Thuong180702/Bimanual-wall-climbing-robot/cad/README.md

# cad — the mechanical design

Parametric CAD for the v2 robot. Vendor actuators are the manufacturers' own
STEP files; everything between them is drawn here. The same spec drives the
CAD, the collision primitives and the URDF, so the model and the simulation
cannot drift apart.

```
src/
  lib/spec.py      WHERE every joint is, WHICH actuator is on it, WHY each
                   offset differs from v1. The single source of truth.
  lib/motors.py    the actuator catalogue - datasheet numbers, nothing invented
  lib/connect.py   connector primitives: output_plate, face_plate, cheek,
                   bolt_access, and the measured keep-out each is checked on
  lib/build.py     the connectors themselves, one function per link
  purchased/       the three vendor STEP files put in the canonical joint frame
  robot.py         the assembly - run this
tools/
  verify.py        check every number against its source. Run after any change.
  check_one.py     ONE connector: one solid? clears both actuators? bolts on?
  check_pair.py    two neighbouring connectors, swept over their joint's range
  check_swing.py   a link against an actuator two joints away, swept over both
  check_seams.py   is each connector drawn as ONE part? no seam across a skin
  check_bay.py     room in the chest for the battery and boards (spec.BAY)?
  balance.py       where the mass actually sits, per link and for the robot
  preview.py       write tmp/<name>.step and the same bolted between its motors
  arm_view.py      every arm connector so far, bolted into one chain
  robot_view.py    the whole robot, walked from base_link
  profile.py       read a vendor STEP's faces and cylinders -> the IFACE numbers
  gen_envelope.py  tessellate a vendor STEP -> its real radial keep-out
  check_fit.py     do the real actuator bodies fit? boolean intersection on solids
  torque.py        per-joint hold torque, measured on the built model
  massprops.py     mass, COM, inertia per link
  gen_urdf.py      writes ../urdf/
vendor/            downloaded vendor STEP, sha256 verified against step.parts
STEP/              outputs
```

```bash
python src/robot.py        # build STEP/robot.step
python tools/verify.py     # 17 checks
cadgen viewer --json       # review in the browser
```

## Conventions

**Canonical actuator frame.** Every actuator, whatever the vendor file does:
`+Z` is the joint axis, `z = 0` is the output flange face, the body occupies
`z < 0`. `src/purchased/*.py` holds the one transform each vendor file needs.

**Link frame.** URDF convention: origin on the proximal joint axis, identity
rotation at q = 0 — except the hooks, turned 180° about z by `MOUNT_ROT` (below). `BODY_DIR[joint]` points from the joint origin toward that
actuator's body, so the child structure grows the other way. `MOUNT_AT[joint]`
slides the actuator along its own axis — kinematically free clearance.

**One connector pattern for the whole arm.** Every link is two plates and a
web. One plate lies flat on the proximal actuator's OUTPUT flange, the other on
ONE housing face of the distal actuator; each is exactly the diameter of the
face it sits on and carries a clearance hole for every one of that face's
bolts, continued on through the web so a driver can reach them. The web is a
single plate whose outline is tangent to both rims, so it follows the two faces
instead of butting onto them. Nothing wraps an actuator: each one is held by
the bolts on a single face and cantilevers off it, the way the open-source arms
on this class of actuator do it.

**Drawn as one part, not as blocks pushed together.** A web stops AT the
plate it stands on - it used to run 3 mm into it, and a leg had its whole face
plate inside it - so the joint is a face and the two rims are one surface.
Where a web meets a round plate off its centre it is as wide as the plate is
on that chord, not as the plate's diameter: the upper arm's cheek stood 4.3 mm
outside the ring it bolts to at both corners. Every bolt a web covers gets a
counterbore down to its seat at the diameter of the HEAD (at thread size the
head was buried in the web, or stood half inside a cheek that only brushed
it); where that would leave under 1 mm of metal at a rim it is opened through
the rim, and over the AK80-64's output - six M4 heads 0.6 mm from the cable
bore - the web is bored once over the whole bolt circle. `check_seams.py`
counts the edges whose two faces are the same plane or cylinder, which is what
a part put together from blocks is made of; the arm has none. (The upper torso
keeps 17, all bolt-hole edges of a few mm where a lidar hat meets a panel.)

**Except at a corner.** Where the two axes are perpendicular to each other AND
to the link - both wrist links - the two faces lie in perpendicular planes and
no single plate sits flat on both. There it is one leg per face, and the two
share ONE SPINE where they meet: each leg's thickness is the other leg's
width, and each leg's taper is centred on the other leg rather than on its own
joint axis. Sized any other way the legs stand proud of each other and leave
two wings and a rib that carry nothing - which is exactly what the first two
attempts looked like. Each leg is drawn on 8 mm into the other as a parallel
neck, and the corner where its taper turns into that neck is a 6 mm radius, so
the legs meet in a round and not a crease (8 mm put 0.2 mm3 of `wrist_L` into
`wrist_dev_L` at -15 deg). One corner stays sharp: the child leg's on the side
of the parent actuator, whose barrel is 0.5 mm away. The hook's web and palm
hand over the same way.

The spine is a rectangle, not a square, because its two dimensions do not cost
the same. Across the arm is open space; fore-and-aft is where the NEXT link's
bracket has to pass, so a millimetre there costs the next link a millimetre of
stand-off. 16 x 14 mm is the smallest pair that keeps both section moduli over
522 mm3, which is what the AK60-39's 72 N.m stall needs at half of 6061-T6's
yield. `wrist_dev_L` then stands its plate 12 mm out, because `wrist_L`'s
16 mm leg reaches 10 mm past the flange it bolts to - measured at 2181 mm3 of
overlap before the stand-off was added, by `check_pair.py`.

**Balance is a layout rule, not an afterthought.** Every bracket cantilevers
off one face and every actuator's body hangs to one side of its own joint, so
each link has a lateral offset. All four of the arm's cross-axis actuators
used to have their bodies inboard - shoulder flexion, elbow, wrist flexion,
finger - and none of it cancelled: `balance.py` measured the arm's centre of
mass 13.5 mm inboard of the axis it hangs on. The elbow and the finger are
turned round, so the four now go in, out, in, out and the offset is 1.6 mm.
It is what OpenArm does with its joint origins, whose lateral offsets read
-30.1, +30.1, +31.5, -31.5, +37.5, -37.5.

**The shoulder is pitch-first, like the humanoids it was checked against** -
twelve of them, measured off their own URDF/MJCF (`spec.py` lists them). The
flexion (pitch) actuator sits in the chest, body inboard, output facing out;
the abduction (roll) actuator sits beside that output at the same height, axis
fore-and-aft; the upper arm hangs off the roll output. Seen from above,
`shoulder_L` is an L: a web on the pitch output plate running past the roll
actuator's flank, and a leg across its far flange. The first v2 stacked it the
other way - abduction on the torso, flexion 104 mm below it - and raising the
arm flipped that 104 mm link over the top: the arm grew out of a pivot above
the abduction motor, and flaring it swung its root 105 mm inward into the
torso. `MOUNT_AT` existed for that layout only and is empty now.

**The three torso links are frames, not connectors**, so they are panels and
decks rather than cheeks - but the rule they are drawn to is the same: every
actuator is held by a plate lying on a face it really has, with a clearance
hole for every one of its bolts. `base_link` is the pelvis, drawn ready for legs: the waist actuator nose-up on
a deck in its top, and under it two 6 mm side walls that each hip's first
actuator (`spec.HIPS`, a pitch AK80-64 as on Unitree G1) will bolt its front face
to from inside, output out through the wall - the shoulders' mounting, a floor
lower. No hip actuator is fitted yet. The hips are 146 mm apart and 425 mm under
the shoulders (a 1.40 m person: ~150 and 403; the hips sit 22 mm low so their
bodies clear the waist actuator), the waist 305 mm under the shoulders at navel
height (`spec.DROP`: it sat 0.10 m higher until 2026-11-11). The section is the
140 x 142 box cut back to R86.5, because the waist turns the upper body over the
pelvis and a hanging forearm sweeps a circle 88 mm round the waist axis. Neither
actuator is hollow, so the harness goes ROUND the waist: legs in through the window
over each hip, out of the pelvis's open top, a loop in the 40 mm under the chest's
deck, up through the deck's two slots. The chest carries `spec.BAY`: the battery
drawer on two rails, out through the back panel; over it a tray on four posts (IMU,
CAN board, DC-DC) and on that the bulkhead the Jetson stands on, both drilled on an
M3 grid (`tools/check_bay.py` checks the room). `waist_link` is a cone that takes the Ø54 output flange
out to the frame's Ø88 bolt circle in one surface. `torso_upper` is the chest:
a box round the two shoulder pitch actuators, carried the way Berkeley
Humanoid Lite, OP3 and the Unitree torsos carry theirs - each actuator inside,
its front face bolted to the side wall, its output flange showing through it.
The side walls ARE those two mounting plates, 6 mm and no thicker, because
`shoulder_L`'s web turns 3 mm past the output flange. A deck, a front and a
back panel and a lid close the box, so a pitch actuator's reaction goes round
it as shear and those four can be 3 mm webs with windows: 1.04 kg, against
1.49 for the abduction-first yoke it replaced.

**Which of the child's two flanges to bolt** is a real choice, not a rule.
The near one leaves the bracket on the same side as that actuator's output,
which is where the NEXT link has to grow, so the next link pays a stand-off;
the far one puts the bracket behind the actuator and leaves that side clear.
`wrist_dev_L` pays the stand-off because reaching behind the deviation
actuator would mean going 48 mm back past it. `shoulder_L` takes the roll
actuator's far flange instead, which leaves its whole output side to the upper
arm. `FACE` in `build.py` records the overrides.

**Lightening** is worked out from the web, not typed in: `_span_holes()` takes
the clear run left between the cable bore and the child's pilot boss and fills
it with as many holes as fit at 50 mm pitch. The forearm's 47 mm of run takes
one; the upper arm's 97 mm takes two.

**The hook** is the one link whose far end is not a flange. Its palm, lip and
65 mm width are the numbers the controller and the RL work were built on -
`urdf/climbing_robot.urdf` carries them as two collision boxes - so they are
copied, not redesigned; only the attachment is drawn. v1 never attached it: it
laid the palm flat against the plate's outer face and, to clear the finger
actuator, slid the whole hook 36.5 mm sideways, which is why its mesh and its
collision boxes disagreed about where the hand was. The palm is back on the
axis and the TOP of the palm is cut away instead, which costs nothing - the
actuator only reaches 27.5 mm down and the rung never touches there.

It is bolted on **turned over** (`spec.MOUNT_ROT`, 180° about the forearm axis):
raised overhead, an unturned hook's throat faces away from the wall, which v1
learnt the hard way. The hook is drawn in its own turned frame
(`build.in_turned_frame`), so its plate stays on the flange side of the finger
actuator — turning the frame alone would have put 21 700 mm³ of it inside the
motor.

**Plate diameter** is the mating face, unless the actuator's bolt circle sits
so close to the rim that a socket head hangs over the edge, and then it is as
wide as the heads need and never wider than the actuator's own body. Only the
AK45-36 needs it: M3 at Ø48 on a Ø53 face leaves 0.8 mm of metal outside the
clearance hole, so its plates go out to the Ø55 barrel and finish flush.

The web's thickness is not free. Where the distal actuator's two mating faces
are close together, the web has to fit between them — the elbow gives 7 mm
between its front face and its output flange, and a 12 mm web there drove
straight into the forearm's own web (853 mm³, measured). `check_pair.py` is
what catches this; `check_one.py` cannot see the link next door.

## Interfaces, measured off the vendor files

Not from a drawing — `tools/` walked the STEP topology and found the bolt
circles by their cylindrical faces and z-positions.

| | output BC | output bolts | housing face z | housing BC | housing bolts | bore |
|---|---|---|---|---|---|---|
| AK80-64 | Ø28 | 6 × M4 | −8.0 | Ø89 | 8 × M3 | Ø21 |
| AK60-39 | Ø30 | 6 × M4 | −9.0 | Ø71 | 8 × M3 | Ø17 |
| AK45-36 | Ø27 | 6 × M2.5 | −4.0 | Ø48 | 6 × M3 | Ø8 |

## Traps worth remembering

**MuJoCo collides a mesh's convex hull, never the mesh.** One mesh per link made
the torso frame one hull, a block out to the shoulder plates, and the raised
arms sank 10-22 mm into it. `gen_urdf.py` writes one collision mesh per bracket
PART (stored as its hull) - see `src/lib/collide.py`. Over 1500 random poses of
the climbing envelope, 2 % of the self-contacts MuJoCo reports are hull
artefacts the true meshes do not make.

**`Shape.scale()` does not scale a part that still carries a Location.** A part
placed by `plane * shape` keeps that placement, and `.scale(1000)` on it moved
`upper_arm_L`'s face plate 200 mm up the arm. A fused result is clean; a single
part has to be wrapped (`Compound(children=[part])`) before scaling.

**Axis-distance arithmetic does not decide clearance for perpendicular
cylinders.** The first version of `check_fit.py` computed the distance between
axis lines minus the two radii; for perpendicular axes that is neither an upper
nor a lower bound, and it reported eight clashes that did not exist while
missing ones that did. It is a boolean intersection on real solids now, and it
costs about half a second per pose.

**`GProp_GProps.MatrixOfInertia()` is about the centre of mass, not the origin.**
Applying a parallel-axis correction to it produced negative principal inertias,
which is how the mistake surfaced. Verified against an offset box.
