Thuong180702/Bimanual-wall-climbing-robot/requirements-gpu.txt

# The GPU path on Linux + an NVIDIA card, every version pinned: what a run in a paper
# was trained with. Resolved for Python 3.12 on x86_64 Linux (glibc >= 2.28) by
#   uv pip compile (the six direct pins below) --python-version 3.12 \
#     --python-platform x86_64-manylinux_2_28 --index-strategy unsafe-best-match \
#     --extra-index-url https://download.pytorch.org/whl/cu126
# Installed by rl/gpu_setup.sh. Why these and not the newest:
#   Python 3.12   jax 0.11 needs >= 3.12; Ubuntu 22.04 ships 3.10 (gpu_setup.sh uses uv's)
#   jax[cuda12]   JAX's CUDA 13 wheels need compute capability >= 7.5; a V100 is 7.0.
#                 CUDA 12 needs NVIDIA driver >= 525.
#   torch cu126   PyTorch dropped Volta (sm_70) from its CUDA 12.8 builds in 2.11, and
#                 CUDA 13 cannot build it at all; cu126 is the build that still runs a V100
#   2.13.0        the version every CPU run and checkpoint here was made with
#   warp-lang     mujoco-mjx[warp]'s pin: MJX's Warp backend (rl.mjx_check warp), which
#                 training steps on only where it is right and faster than JAX
# Direct pins: mujoco==3.12.0 mujoco-mjx==3.12.0 jax[cuda12]==0.11.1 warp-lang==1.16.0
#              torch==2.13.0+cu126 gymnasium==1.3.0 stable-baselines3==2.9.0
--extra-index-url https://download.pytorch.org/whl/cu126
absl-py==2.5.0
cloudpickle==3.1.2
cuda-bindings==12.9.9
cuda-pathfinder==1.8.2
cuda-toolkit==12.6.3
etils==1.14.0
farama-notifications==0.0.6
filelock==4.0.3
fsspec==2026.9.0
glfw==2.10.2
gymnasium==1.3.0
jax==0.11.1
jax-cuda12-pjrt==0.11.1
jax-cuda12-plugin==0.11.1
jaxlib==0.11.1
jinja2==3.1.6
markupsafe==3.0.3
ml-dtypes==0.6.0
mpmath==1.3.0
mujoco==3.12.0
mujoco-mjx==3.12.0
networkx==3.7
numpy==2.5.3
nvidia-cublas-cu12==12.6.4.1
nvidia-cuda-cupti-cu12==12.6.80
nvidia-cuda-nvcc-cu12==12.9.86
nvidia-cuda-nvrtc-cu12==12.6.85
nvidia-cuda-runtime-cu12==12.6.77
nvidia-cudnn-cu12==9.10.2.21
nvidia-cufft-cu12==11.3.0.4
nvidia-cufile-cu12==1.11.1.6
nvidia-curand-cu12==10.3.7.77
nvidia-cusolver-cu12==11.7.1.2
nvidia-cusparse-cu12==12.5.4.2
nvidia-cusparselt-cu12==0.7.1
nvidia-nccl-cu12==2.29.3
nvidia-nvjitlink-cu12==12.6.85
nvidia-nvshmem-cu12==3.4.5
nvidia-nvtx-cu12==12.6.77
opt-einsum==3.4.0
pyopengl==3.1.10
scipy==1.18.1
setuptools==84.0.0
stable-baselines3==2.9.0
sympy==1.14.0
torch==2.13.0+cu126
trimesh==5.1.0
triton==3.7.1
typing-extensions==4.16.0
warp-lang==1.16.0
zipp==4.1.0
