Thuong180702/Bimanual-wall-climbing-robot/demo/preview/lesson03_climb_up_mirror.gif

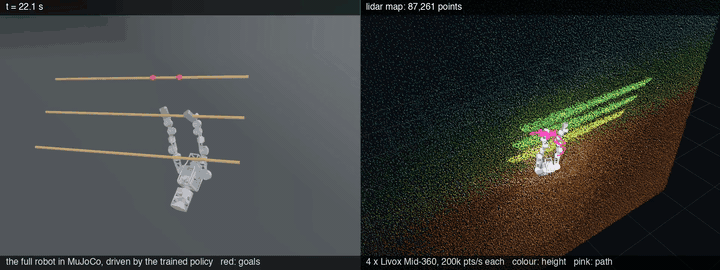
demo/preview/lesson03_climb_up_mirror.gif
