Thuong180702/Bimanual-wall-climbing-robot/demo/preview/lesson07_wall_corner.gif

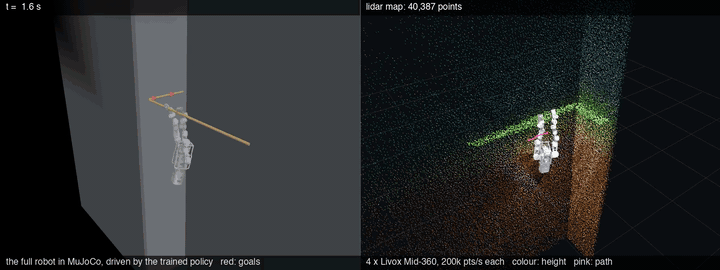
demo/preview/lesson07_wall_corner.gif
