Thuong180702/Bimanual-wall-climbing-robot/urdf/scene_corner.png

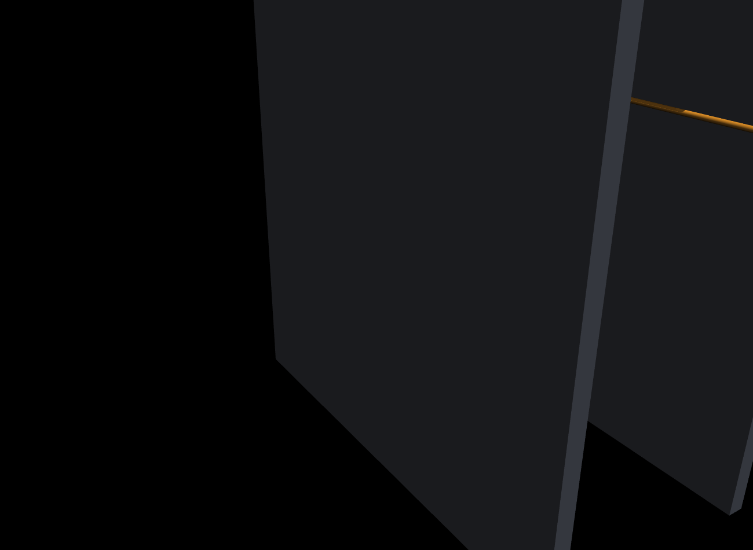
urdf/scene_corner.png
