Thuong180702/Bimanual-wall-climbing-robot/urdf/scene_hanging.png

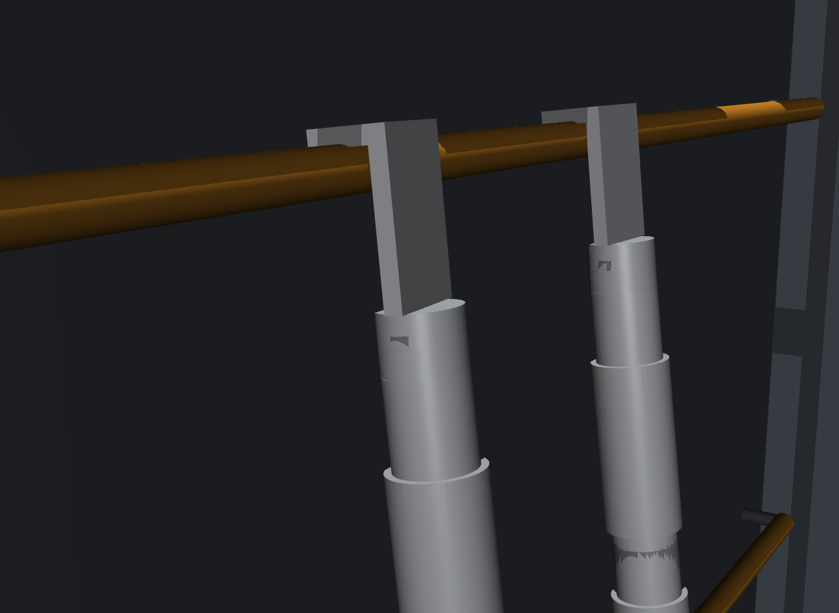
urdf/scene_hanging.png
