Thuong180702/Bimanual-wall-climbing-robot/urdf/scene_overview.png

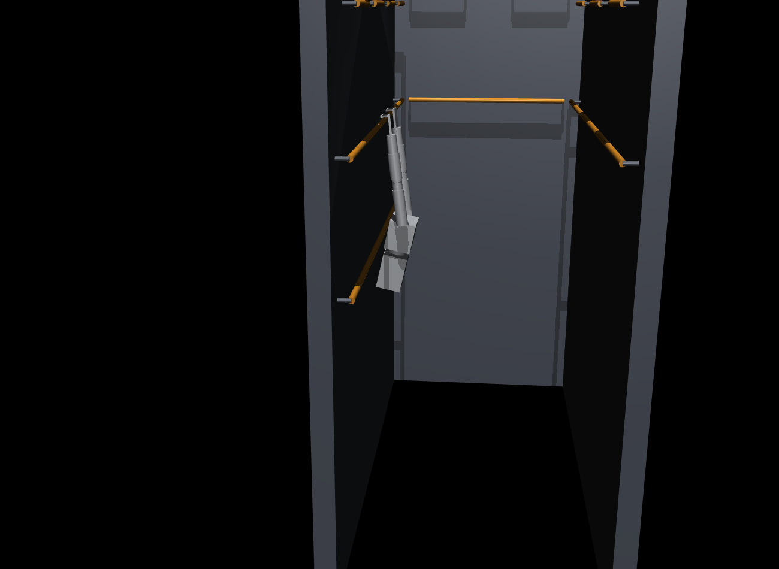
urdf/scene_overview.png
