Thuong180702/Bimanual-wall-climbing-robot/urdf/view_corner.png

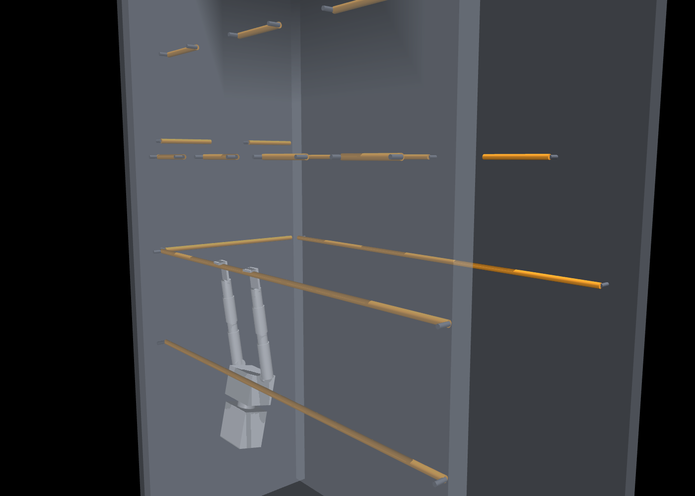
urdf/view_corner.png
