Thuong180702/Bimanual-wall-climbing-robot/urdf/view_iso.png

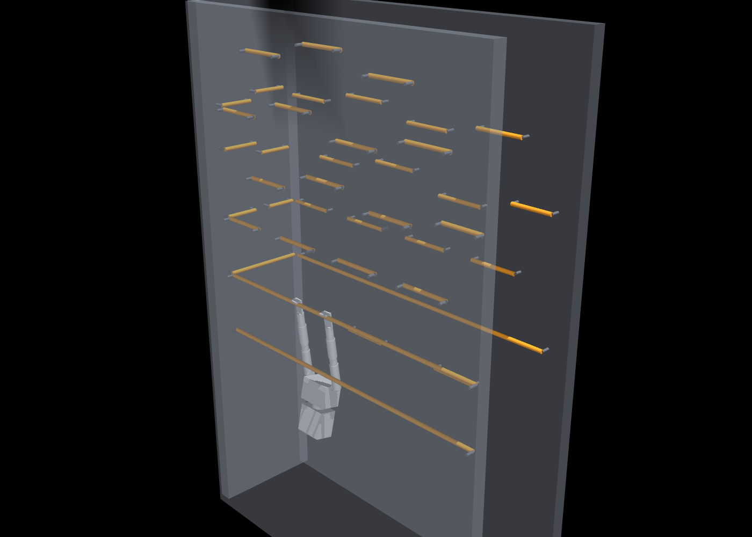
urdf/view_iso.png
