Thuong180702/Bimanual-wall-climbing-robot/urdf/view_iso_left.png

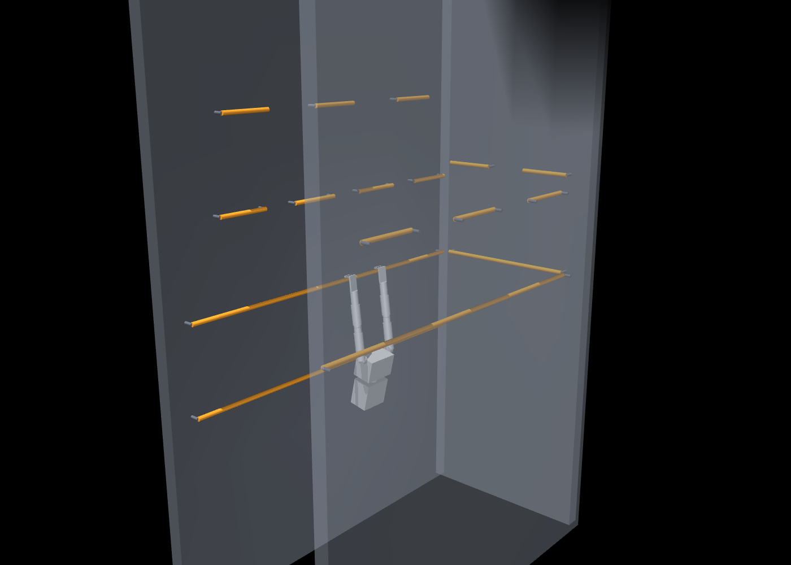
urdf/view_iso_left.png
