Thuong180702/Bimanual-wall-climbing-robot/urdf/view_top.png

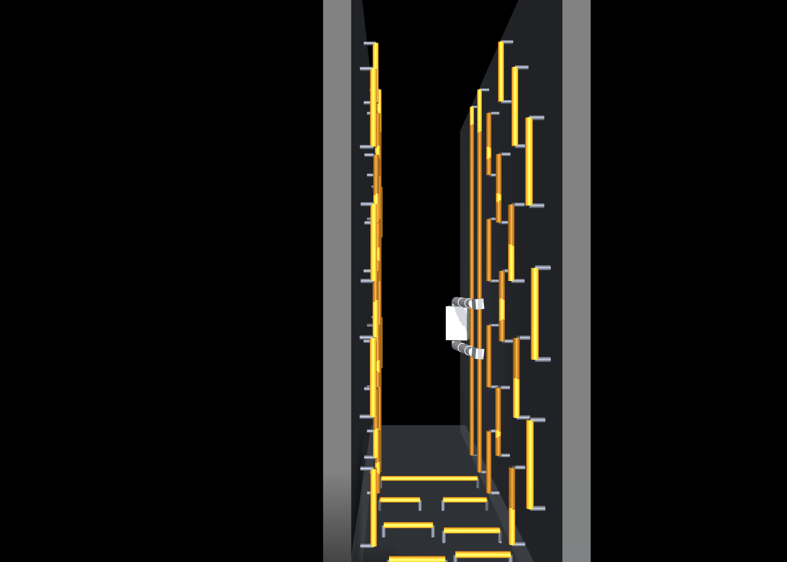
urdf/view_top.png
