Thuong180702/Bimanual-wall-climbing-robot/urdf/view_wall_back.png

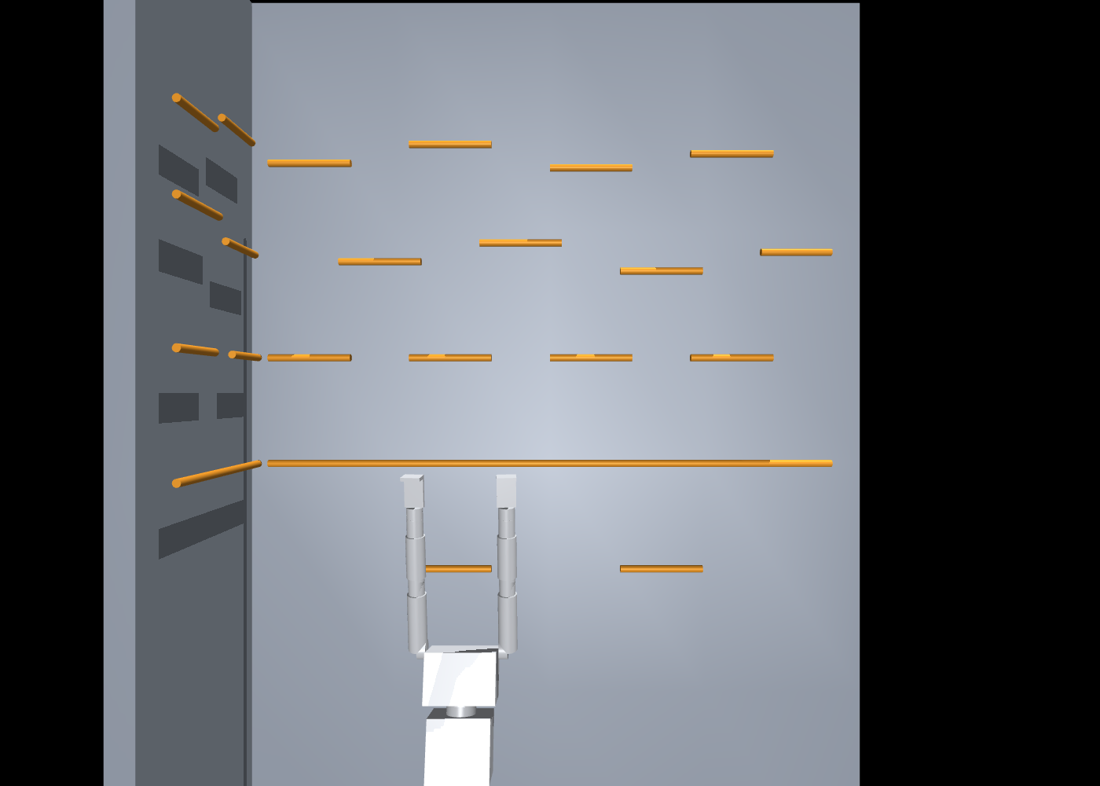
urdf/view_wall_back.png
