Thuong180702/Bimanual-wall-climbing-robot/urdf/view_wall_front.png

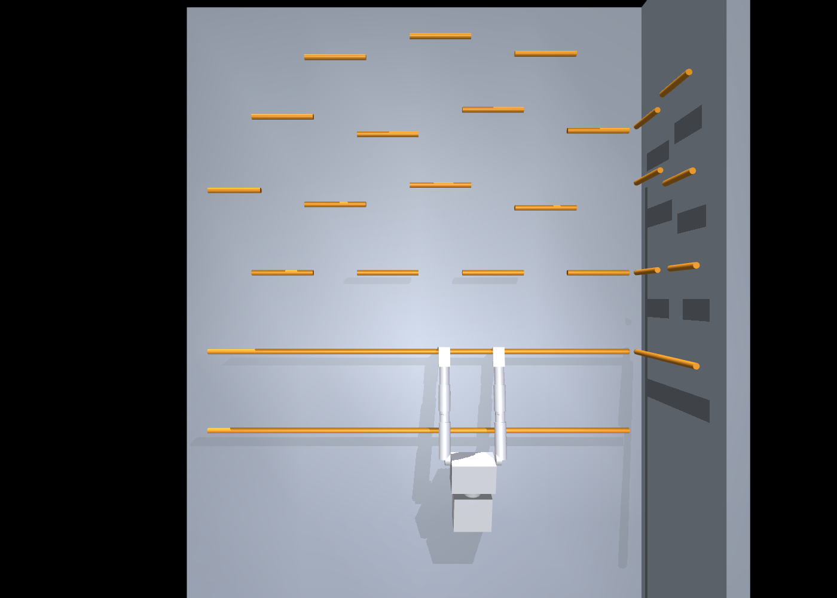
urdf/view_wall_front.png
