Thuong180702/Bimanual-wall-climbing-robot/urdf/meshes/upper_arm_L.stl

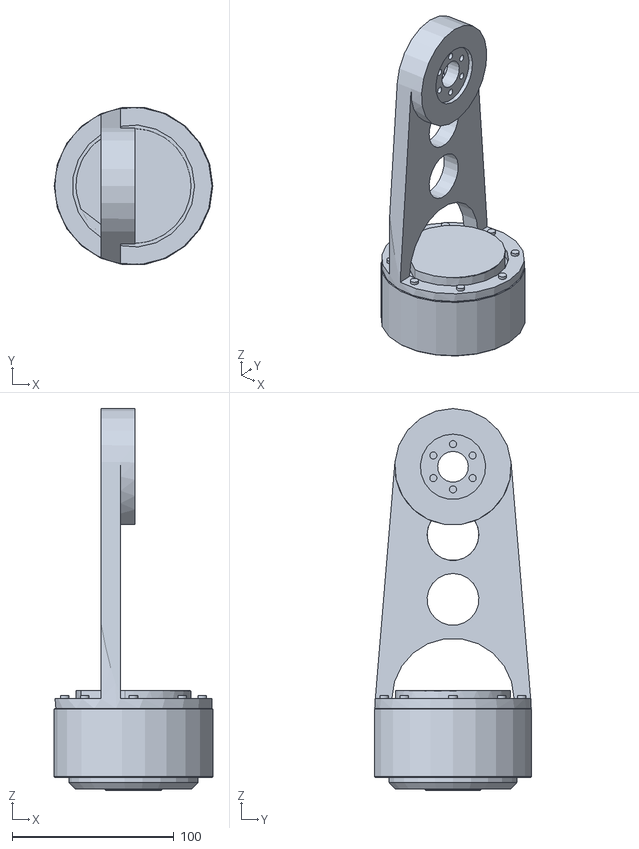
[picture p15: CAD file, 2026-11-11]
urdf/meshes/upper_arm_L.stl
98.0 x 97.0 x 236.0
