Thuong180702/Bimanual-wall-climbing-robot/urdf/meshes/torso_upper_col_lidar_head_roof.stl

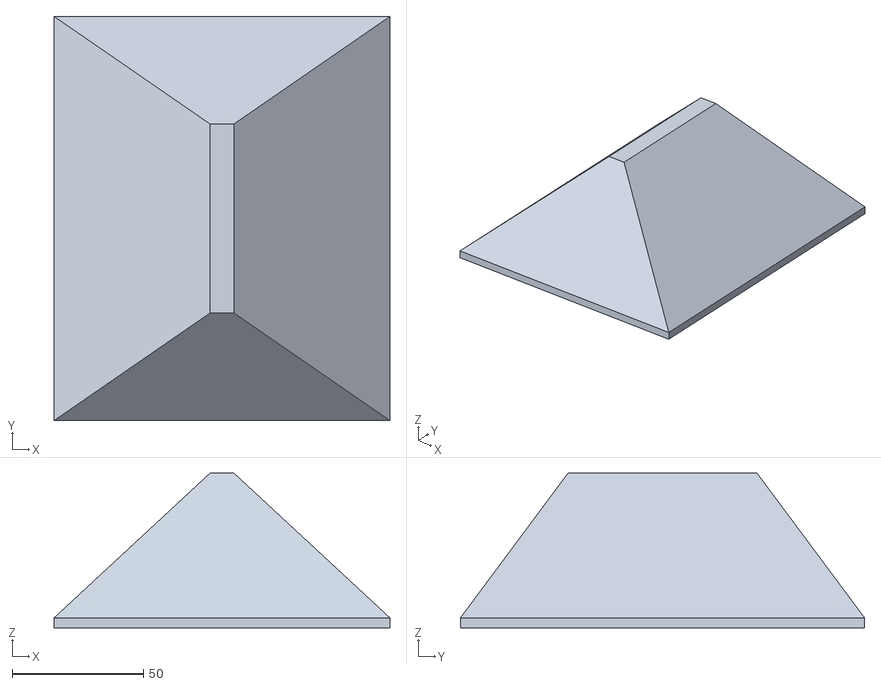
[picture p16: CAD file, 2026-11-11]
urdf/meshes/torso_upper_col_lidar_head_roof.stl
128.0 x 154.0 x 59.0
