Thuong180702/Bimanual-wall-climbing-robot/urdf/meshes/base_link_col_shell.stl

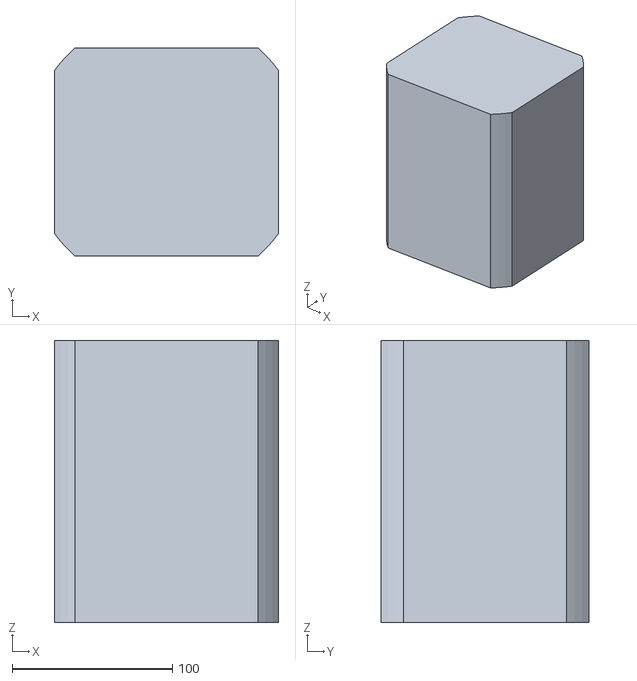
[picture p17: CAD file, 2026-11-11]
urdf/meshes/base_link_col_shell.stl
140.0 x 130.0 x 176.0
