Thuong180702/Bimanual-wall-climbing-robot/urdf/meshes/base_link_col_deck.stl

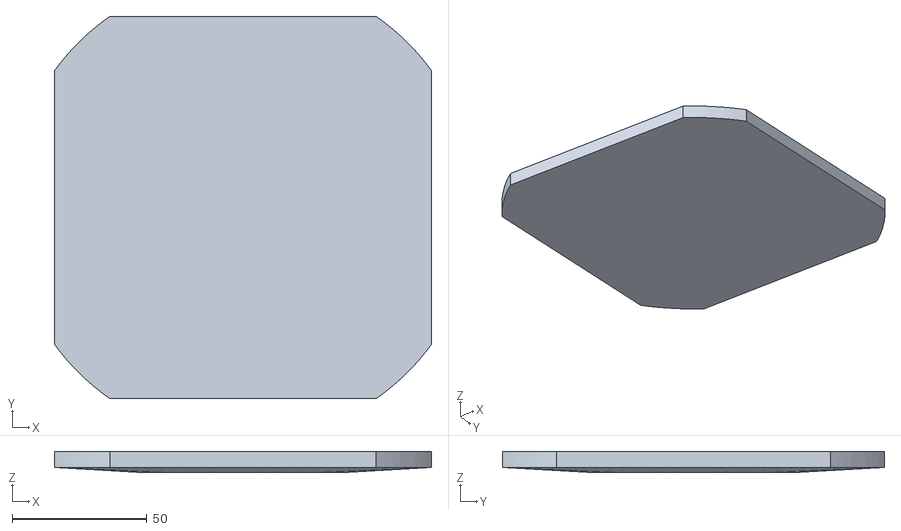
[picture p18: CAD file, 2026-11-11]
urdf/meshes/base_link_col_deck.stl
140.0 x 142.0 x 7.95
