Thuong180702/Bimanual-wall-climbing-robot/urdf/meshes/wrist_R.stl

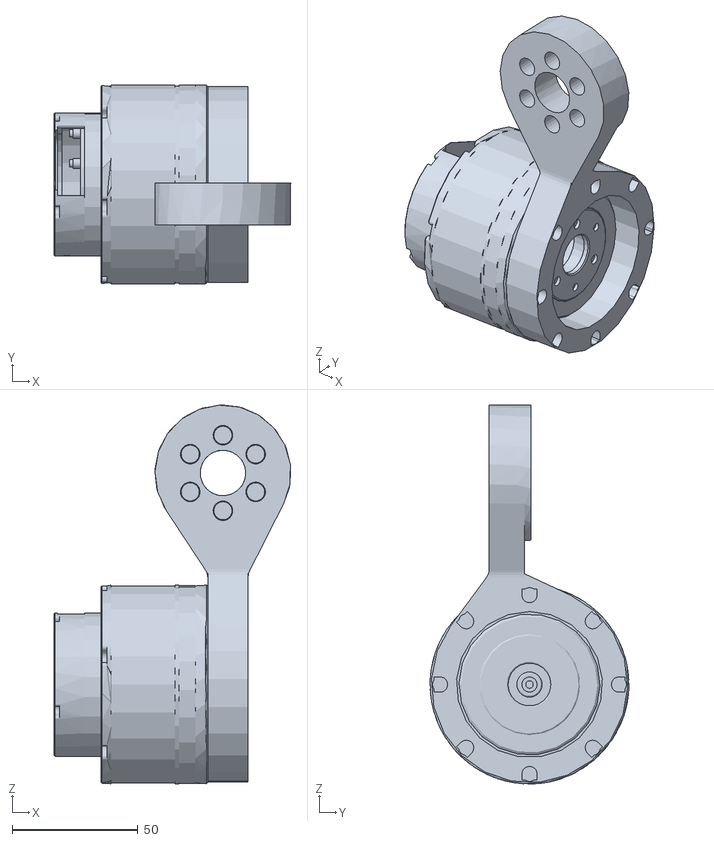
[picture p19: CAD file, 2026-11-11]
urdf/meshes/wrist_R.stl
93.9 x 79.0 x 150.5
