Thuong180702/Bimanual-wall-climbing-robot/urdf/meshes/hook_R.stl

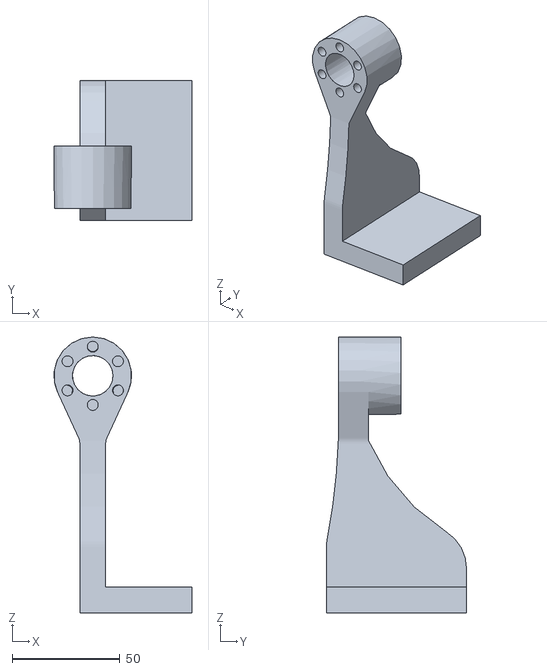
[picture p20: CAD file, 2026-11-11]
urdf/meshes/hook_R.stl
63.9 x 65.0 x 128.0
