Thuong180702/Bimanual-wall-climbing-robot/urdf/meshes/base_link_col_hip_L.stl

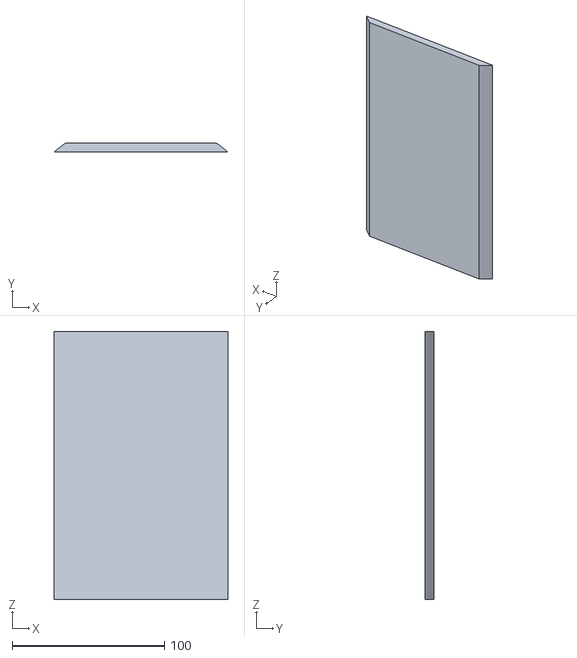
[picture p21: CAD file, 2026-11-11]
urdf/meshes/base_link_col_hip_L.stl
114.1 x 6.00 x 176.0
