Thuong180702/Bimanual-wall-climbing-robot/urdf/meshes/torso_upper_col_front.stl

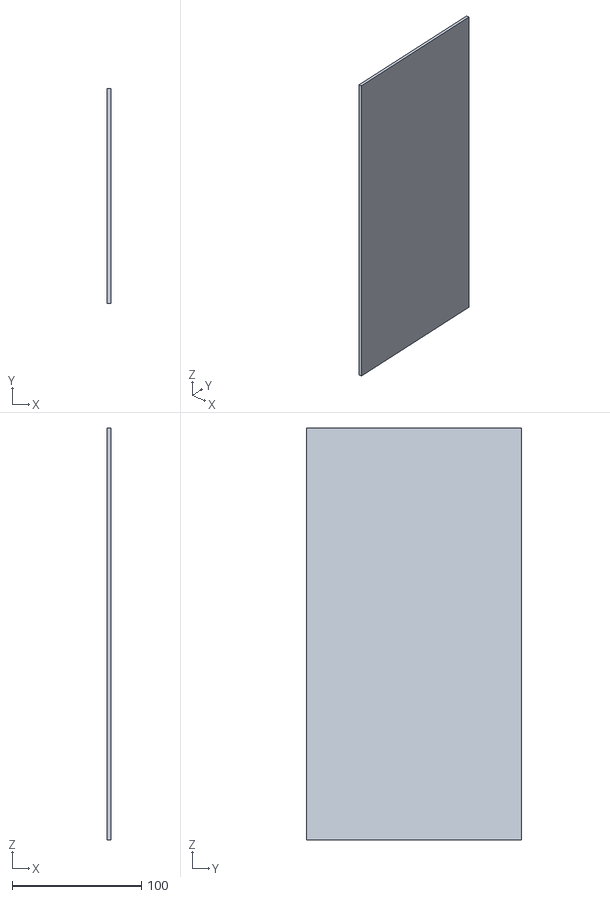
[picture p22: CAD file, 2026-11-11]
urdf/meshes/torso_upper_col_front.stl
3.00 x 166.0 x 318.5
