Thuong180702/Bimanual-wall-climbing-robot/urdf/meshes/torso_upper_col_lid.stl

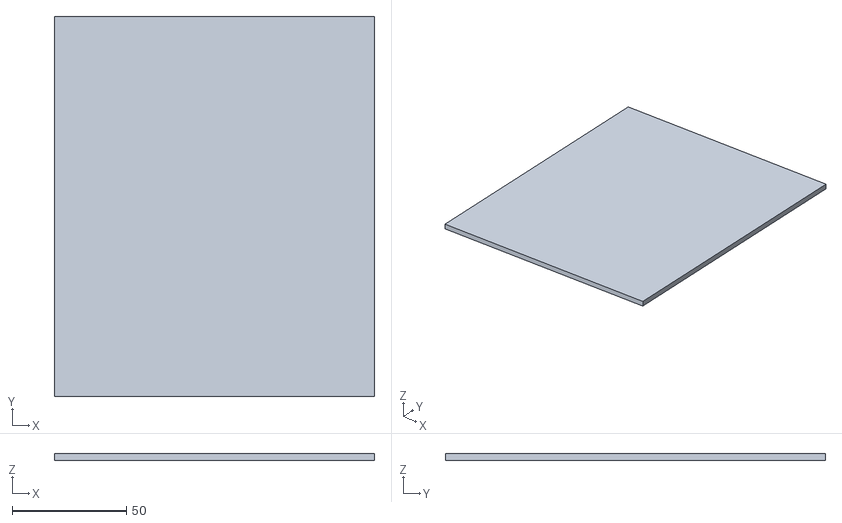
[picture p23: CAD file, 2026-11-11]
urdf/meshes/torso_upper_col_lid.stl
140.0 x 166.0 x 3.00
