Thuong180702/Bimanual-wall-climbing-robot/urdf/meshes/humerus_rot_R.stl

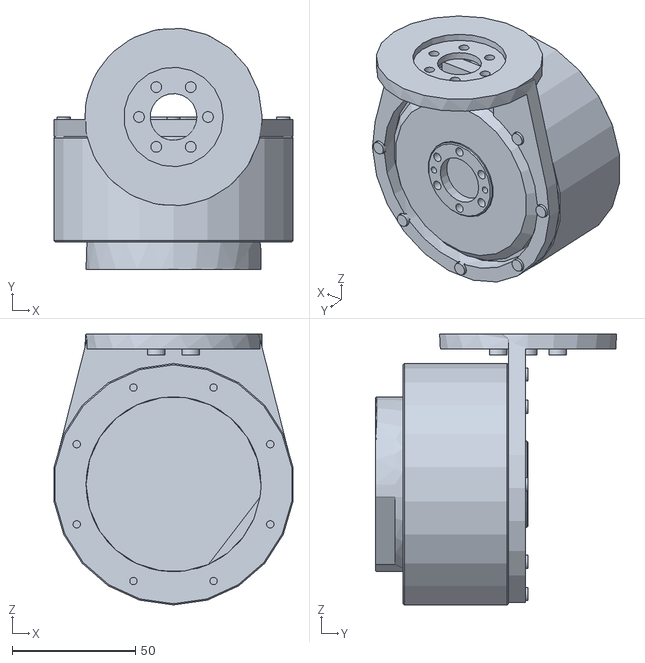
[picture p24: CAD file, 2026-11-11]
urdf/meshes/humerus_rot_R.stl
97.0 x 97.8 x 110.0
