Thuong180702/Bimanual-wall-climbing-robot/urdf/meshes/base_link.stl

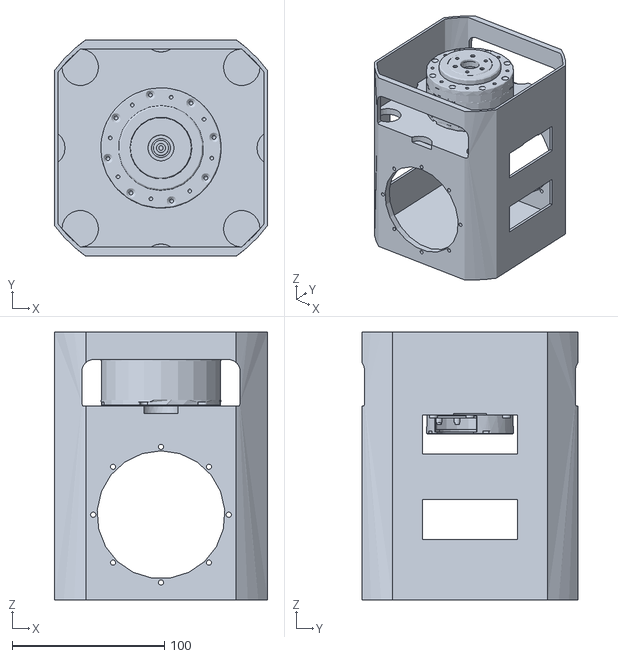
[picture p25: CAD file, 2026-11-11]
urdf/meshes/base_link.stl
140.0 x 142.0 x 176.0
