Thuong180702/Bimanual-wall-climbing-robot/urdf/meshes/wrist_dev_L.stl

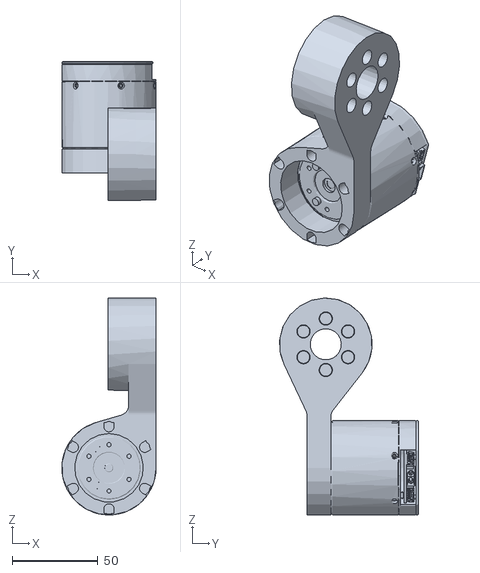
[picture p26: CAD file, 2026-11-11]
urdf/meshes/wrist_dev_L.stl
55.0 x 80.9 x 126.5
