Thuong180702/Bimanual-wall-climbing-robot/urdf/meshes/upper_arm_R_col_cheek.stl

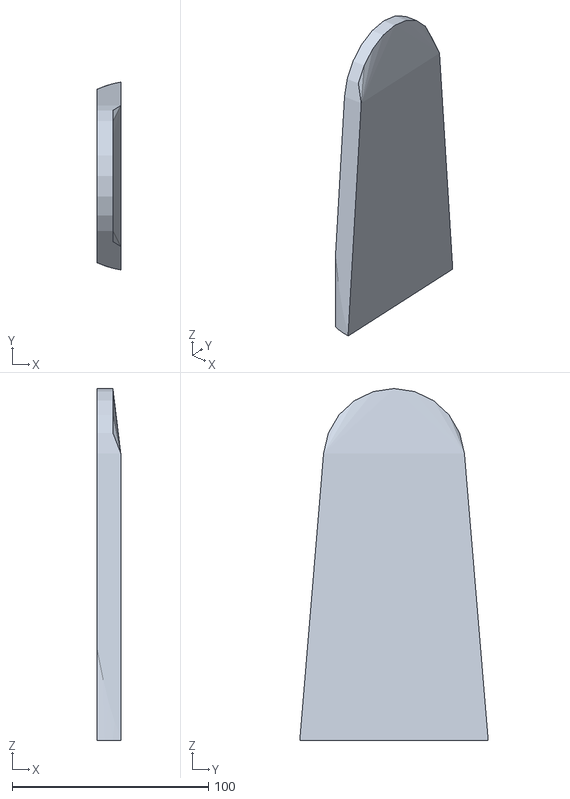
[picture p27: CAD file, 2026-11-11]
urdf/meshes/upper_arm_R_col_cheek.stl
12.0 x 95.7 x 179.3
