Thuong180702/Bimanual-wall-climbing-robot/urdf/meshes/torso_upper_col_wall_R.stl

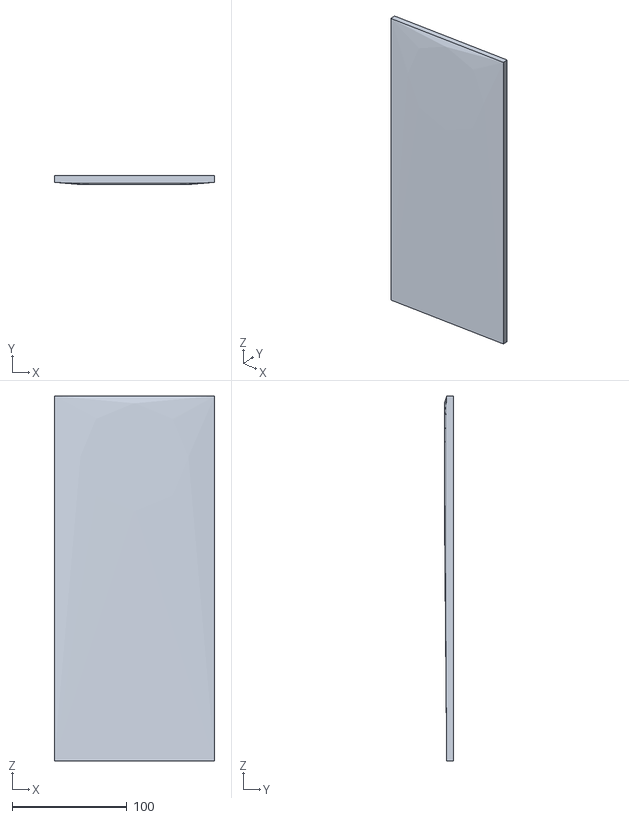
[picture p28: CAD file, 2026-11-11]
urdf/meshes/torso_upper_col_wall_R.stl
140.0 x 7.95 x 318.5
