Thuong180702/Bimanual-wall-climbing-robot/urdf/meshes/forearm_rot_L.stl

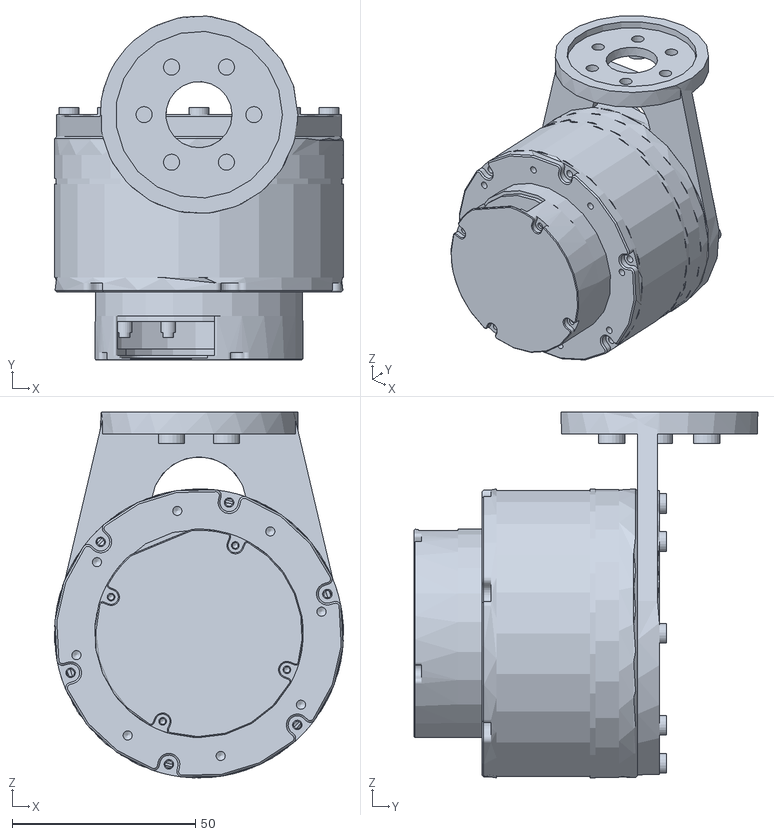
[picture p29: CAD file, 2026-11-11]
urdf/meshes/forearm_rot_L.stl
79.0 x 93.9 x 100.0
