Thuong180702/Bimanual-wall-climbing-robot/urdf/meshes/fore_arm_L.stl

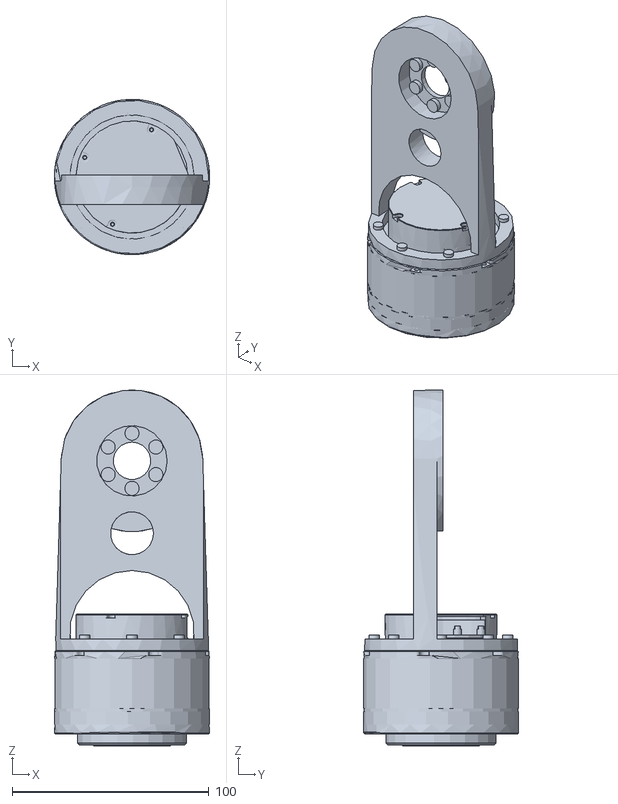
[picture p30: CAD file, 2026-11-11]
urdf/meshes/fore_arm_L.stl
79.0 x 79.0 x 181.0
