Thuong180702/Bimanual-wall-climbing-robot/urdf/meshes/shoulder_L.stl

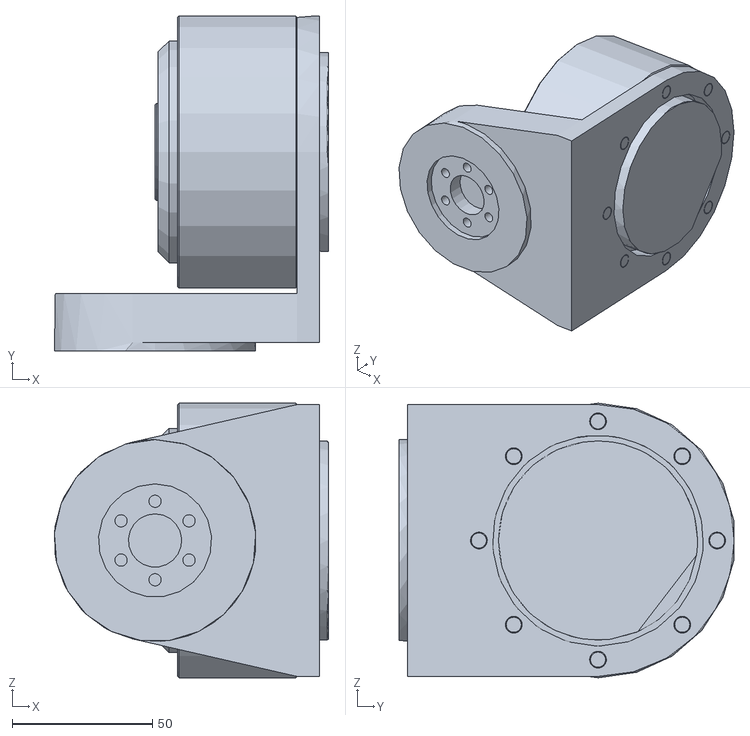
[picture p31: CAD file, 2026-11-11]
urdf/meshes/shoulder_L.stl
97.8 x 119.5 x 98.0
