Thuong180702/Bimanual-wall-climbing-robot/urdf/meshes/torso_upper.stl

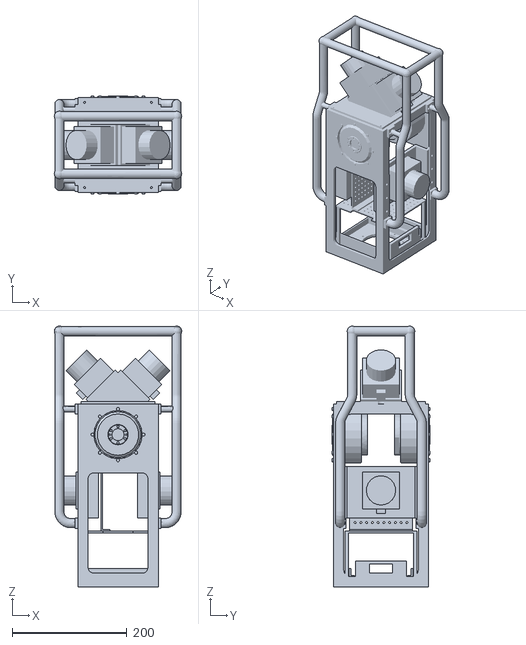
[picture p32: CAD file, 2026-11-11]
urdf/meshes/torso_upper.stl
221.9 x 170.0 x 454.0
