Thuong180702/Bimanual-wall-climbing-robot/urdf/meshes/base_link_col_floor.stl

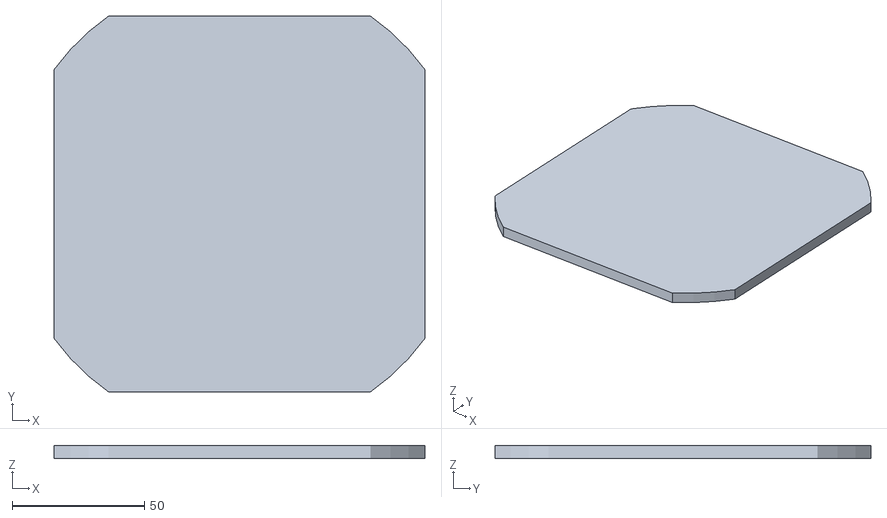
[picture p33: CAD file, 2026-11-11]
urdf/meshes/base_link_col_floor.stl
140.0 x 142.0 x 5.00
