Thuong180702/Bimanual-wall-climbing-robot/urdf/meshes/shoulder_R_col_web.stl

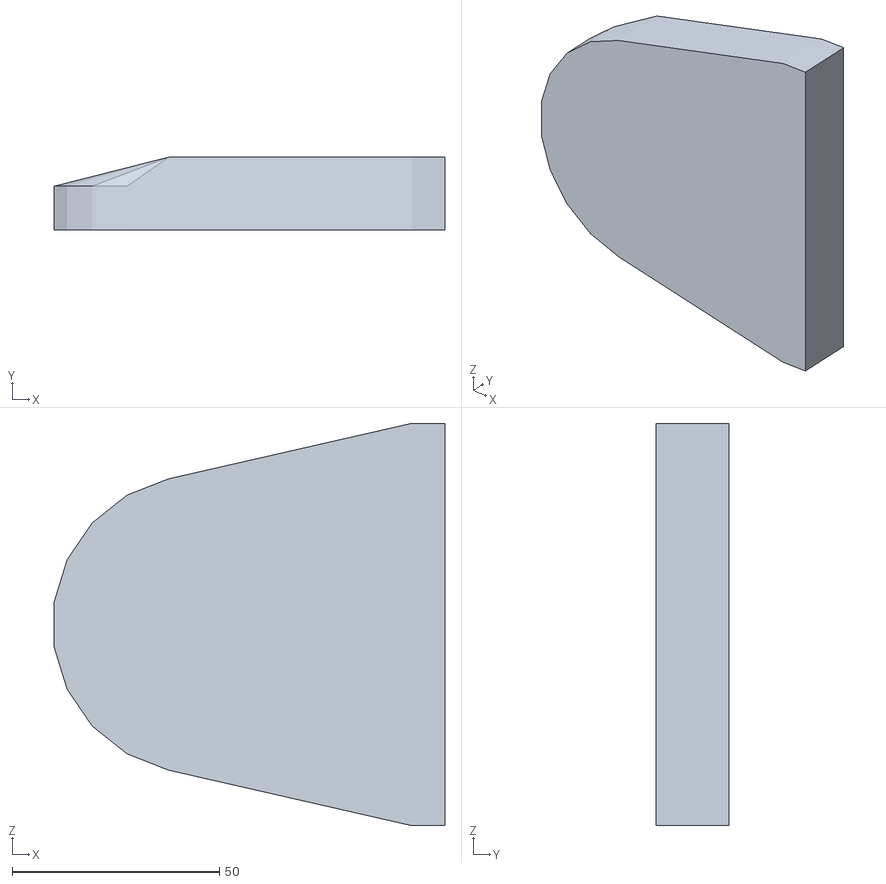
[picture p34: CAD file, 2026-11-11]
urdf/meshes/shoulder_R_col_web.stl
94.2 x 17.5 x 97.0
