Thuong180702/Bimanual-wall-climbing-robot/urdf/meshes/wrist_dev_L_col_web.stl

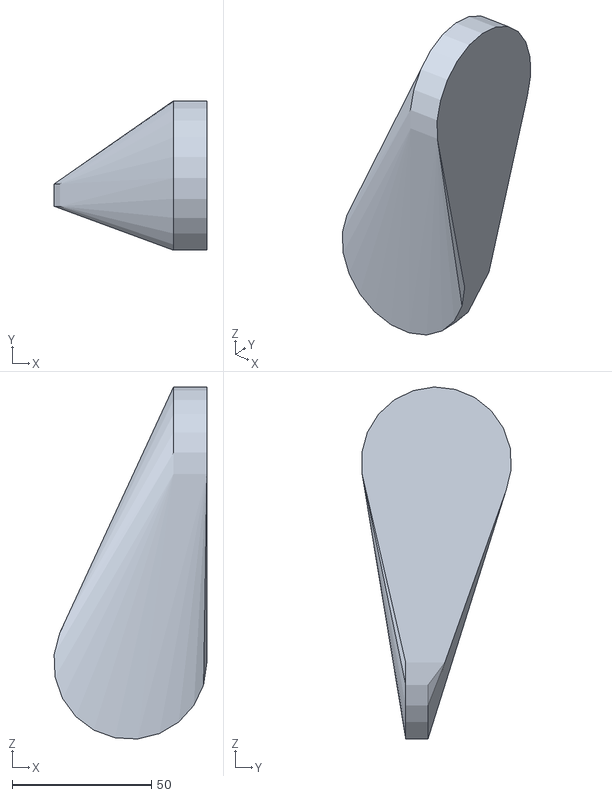
[picture p35: CAD file, 2026-11-11]
urdf/meshes/wrist_dev_L_col_web.stl
54.8 x 53.7 x 126.4
