Thuong180702/Bimanual-wall-climbing-robot/urdf/meshes/wrist_R_col_web.stl

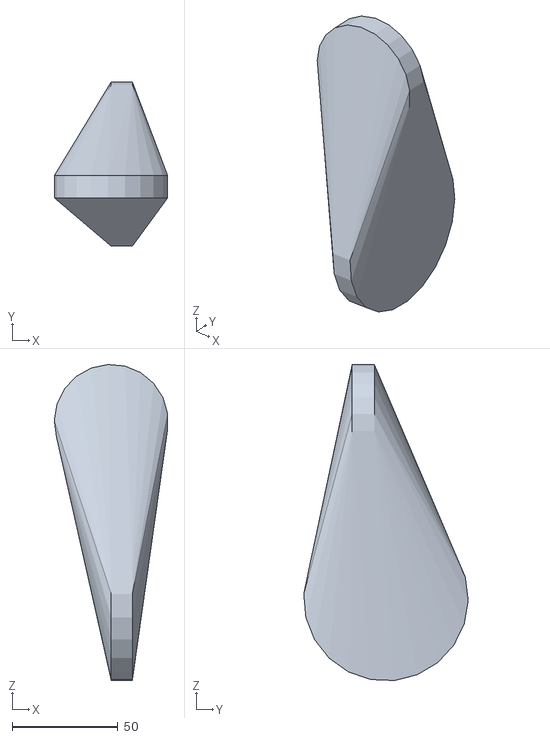
[picture p36: CAD file, 2026-11-11]
urdf/meshes/wrist_R_col_web.stl
53.8 x 77.9 x 149.7
