Thuong180702/Bimanual-wall-climbing-robot/urdf/meshes/shoulder_L_col_leg.stl

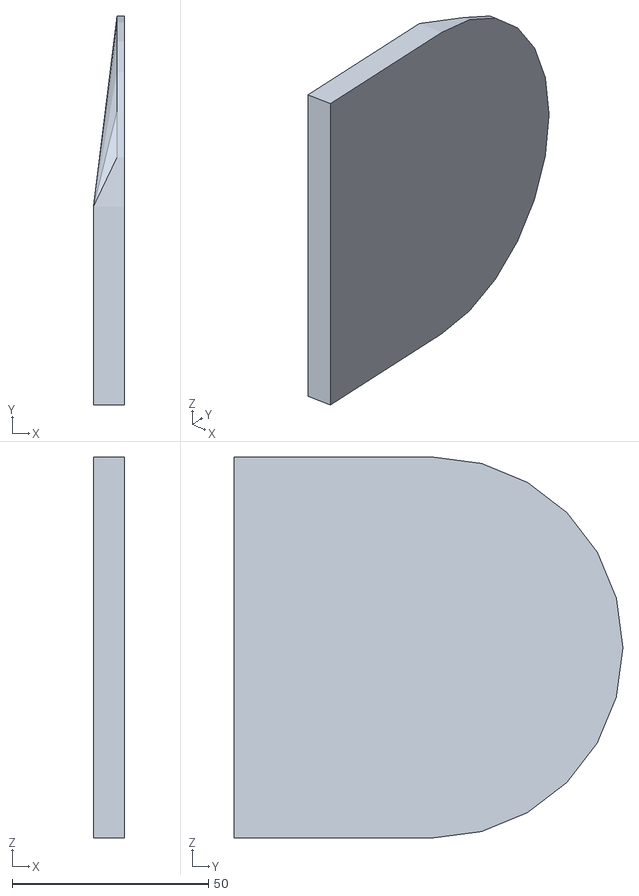
[picture p37: CAD file, 2026-11-11]
urdf/meshes/shoulder_L_col_leg.stl
7.95 x 99.0 x 97.0
