Thuong180702/Bimanual-wall-climbing-robot/urdf/meshes/fore_arm_R_col_cheek.stl

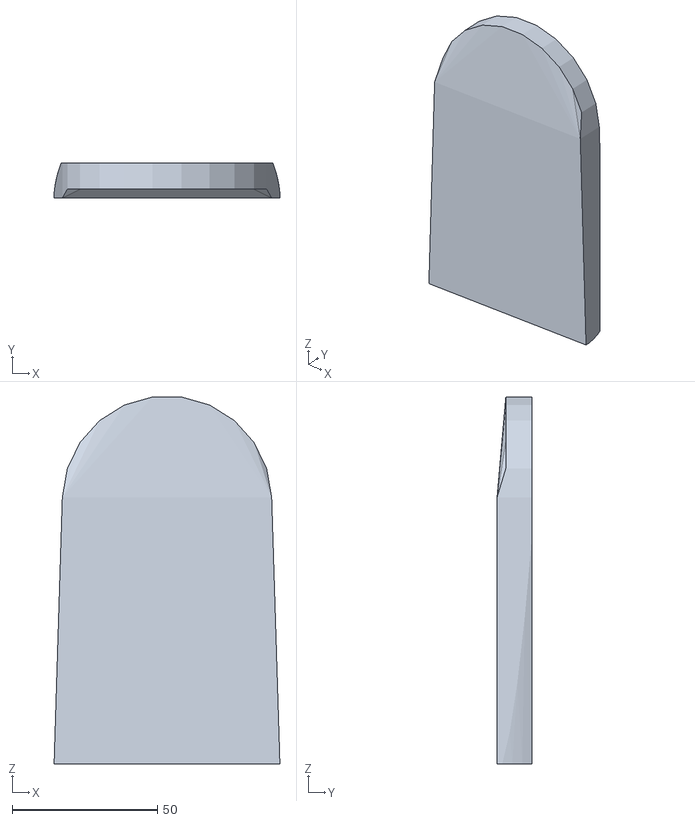
[picture p38: CAD file, 2026-11-11]
urdf/meshes/fore_arm_R_col_cheek.stl
77.6 x 12.0 x 126.1
