Thuong180702/Bimanual-wall-climbing-robot/urdf/meshes/forearm_rot_L_col_cheek.stl

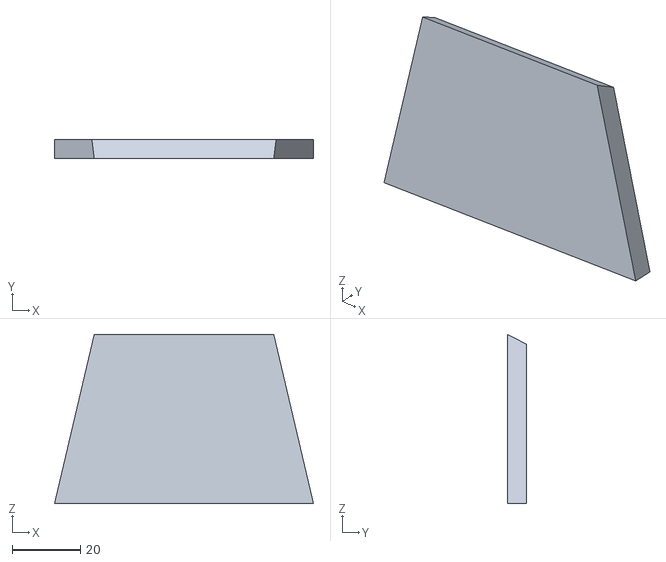
[picture p39: CAD file, 2026-11-11]
urdf/meshes/forearm_rot_L_col_cheek.stl
75.9 x 5.50 x 49.6
