Thuong180702/Bimanual-wall-climbing-robot/urdf/meshes/humerus_rot_L_col_cheek.stl

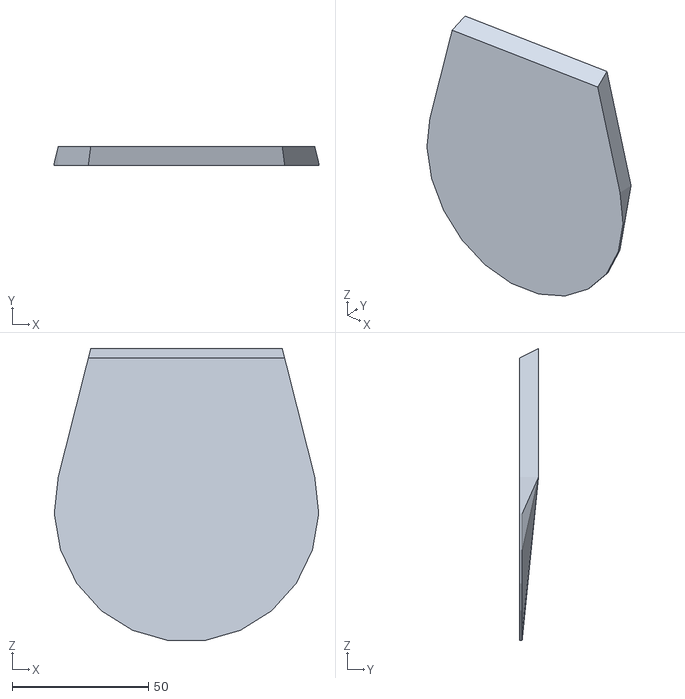
[picture p40: CAD file, 2026-11-11]
urdf/meshes/humerus_rot_L_col_cheek.stl
97.0 x 7.00 x 107.0
