Thuong180702/Bimanual-wall-climbing-robot/urdf/meshes/upper_arm_L_col_plate_out.stl

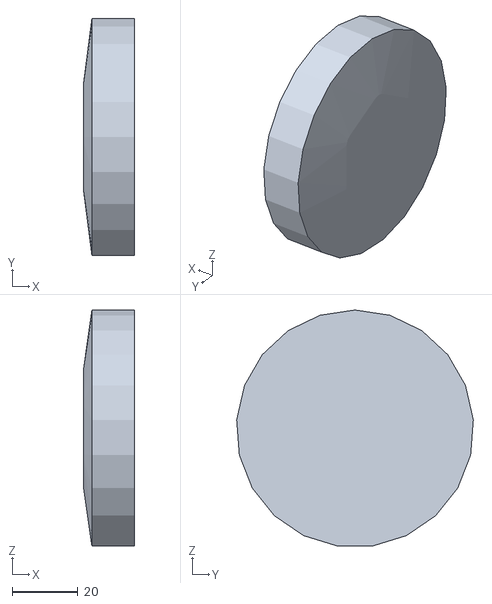
[picture p41: CAD file, 2026-09-22]
urdf/meshes/upper_arm_L_col_plate_out.stl
15.6 x 71.8 x 71.6
