Thuong180702/Bimanual-wall-climbing-robot/urdf/meshes/shoulder_R_col_plate_face.stl

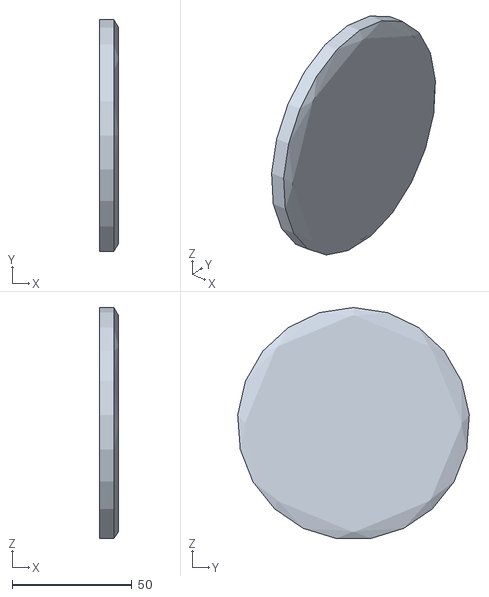
[picture p42: CAD file, 2026-09-22]
urdf/meshes/shoulder_R_col_plate_face.stl
7.95 x 96.7 x 96.5
