Thuong180702/Bimanual-wall-climbing-robot/urdf/meshes/shoulder_L_col_plate_out.stl

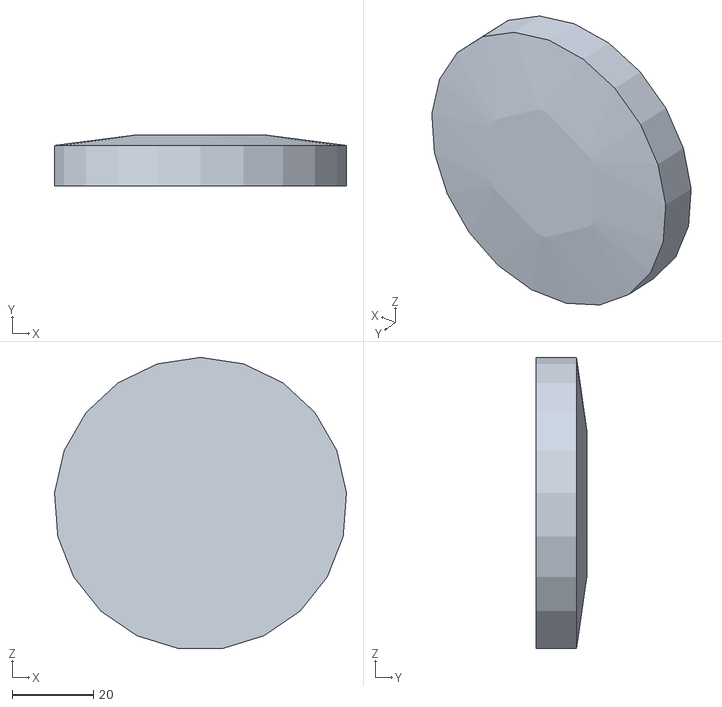
[picture p43: CAD file, 2026-09-22]
urdf/meshes/shoulder_L_col_plate_out.stl
71.8 x 12.6 x 71.6
