Thuong180702/Bimanual-wall-climbing-robot/urdf/meshes/torso_upper_col_deck.stl

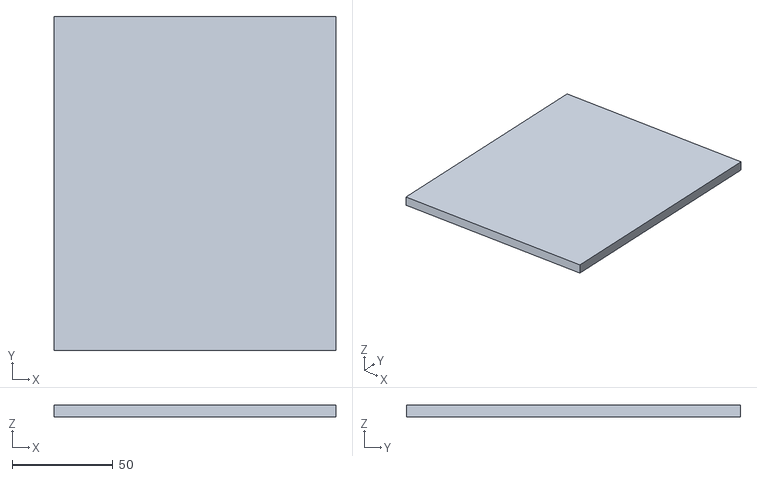
[picture p44: CAD file, 2026-09-22]
urdf/meshes/torso_upper_col_deck.stl
140.0 x 166.0 x 6.00
