Thuong180702/Bimanual-wall-climbing-robot/urdf/meshes/fore_arm_R_col_plate_out.stl

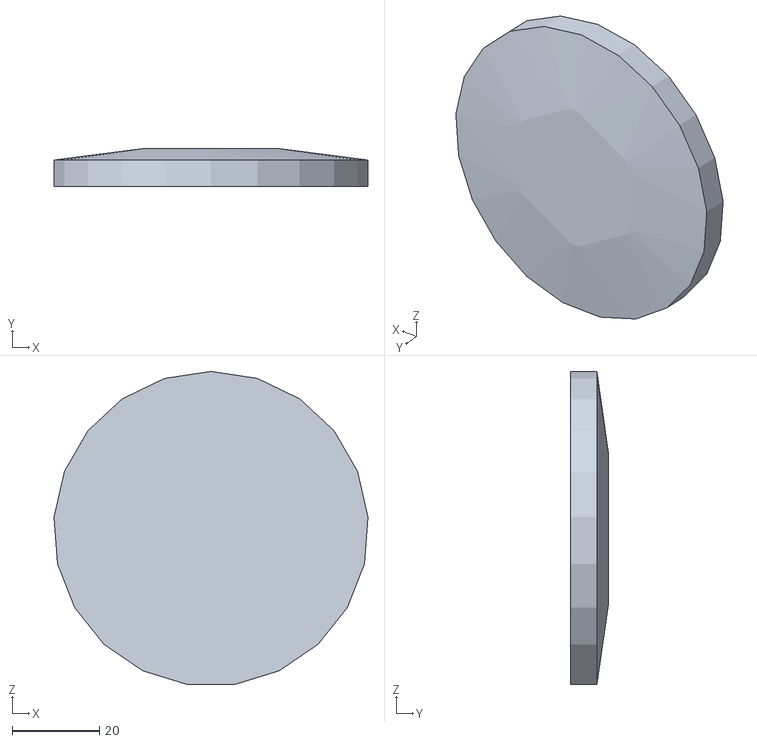
[picture p45: CAD file, 2026-09-21]
urdf/meshes/fore_arm_R_col_plate_out.stl
71.8 x 8.60 x 71.6
