Thuong180702/Bimanual-wall-climbing-robot/urdf/meshes/torso_upper_col_flanks.stl

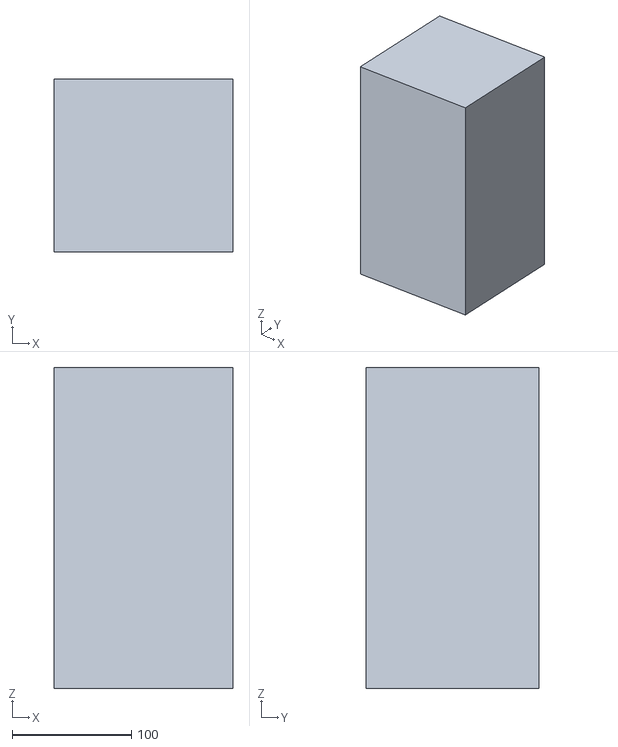
[picture p46: CAD file, 2026-09-21]
urdf/meshes/torso_upper_col_flanks.stl
150.0 x 145.0 x 269.0
