Thuong180702/Bimanual-wall-climbing-robot/urdf/meshes/wrist_L_col_plate_out.stl

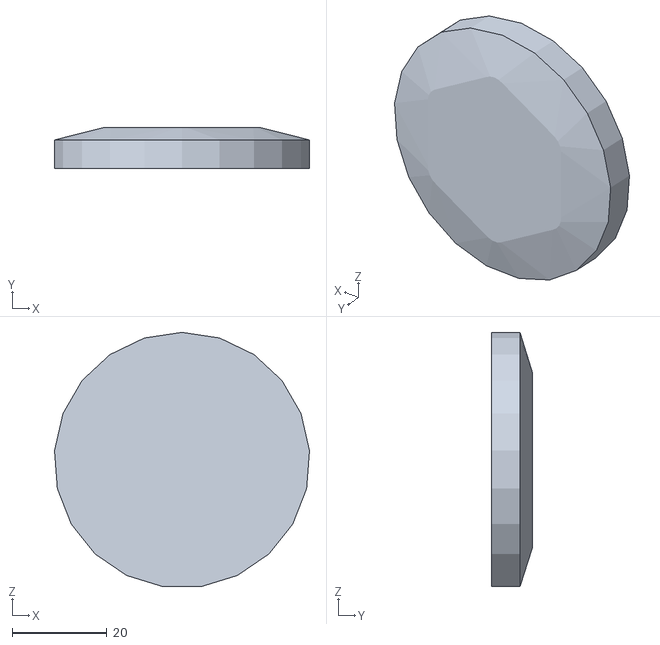
[picture p47: CAD file, 2026-09-21]
urdf/meshes/wrist_L_col_plate_out.stl
53.8 x 8.60 x 53.7
