Thuong180702/Bimanual-wall-climbing-robot/urdf/meshes/wrist_dev_R_col_plate_face.stl

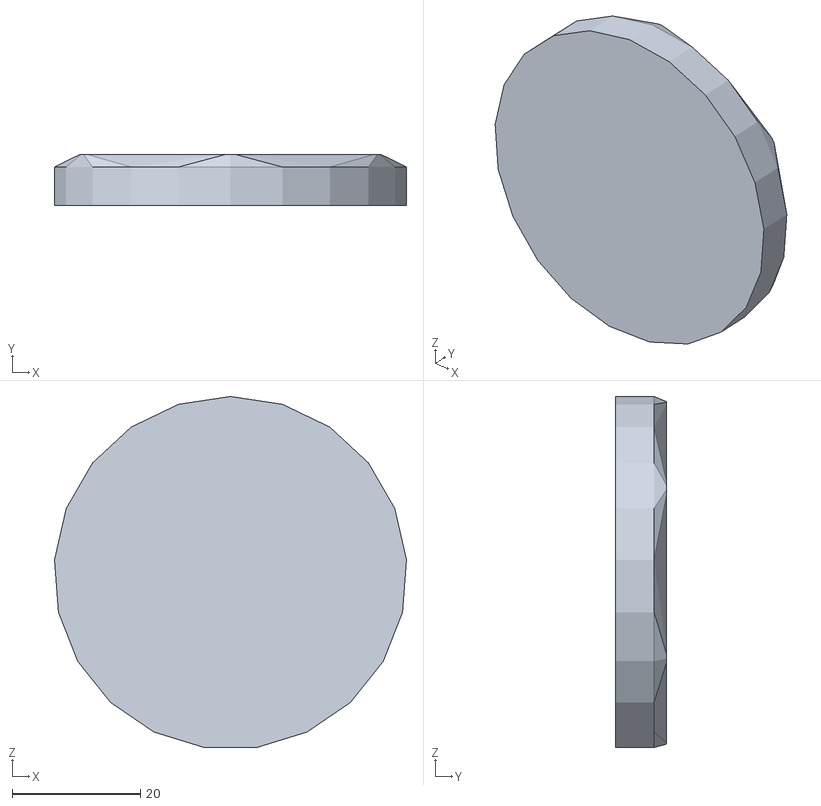
[picture p48: CAD file, 2026-09-21]
urdf/meshes/wrist_dev_R_col_plate_face.stl
54.8 x 7.95 x 54.7
