Thuong180702/Bimanual-wall-climbing-robot/urdf/meshes/forearm_rot_L_col_plate_face.stl

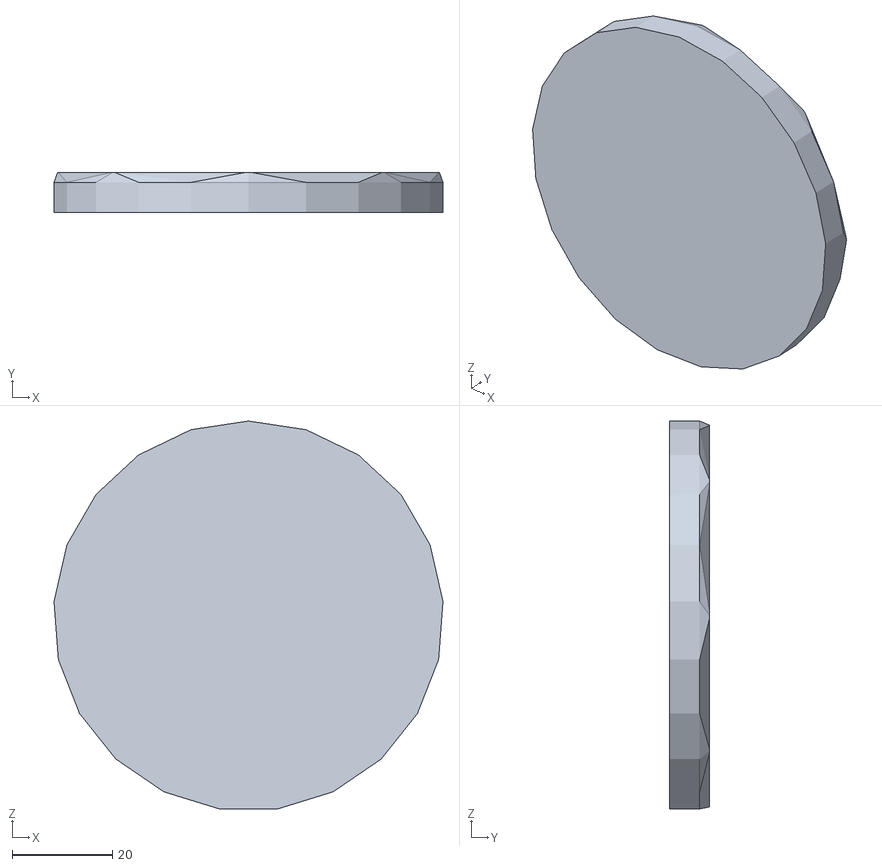
[picture p49: CAD file, 2026-09-21]
urdf/meshes/forearm_rot_L_col_plate_face.stl
77.8 x 7.95 x 77.6
