Thuong180702/Bimanual-wall-climbing-robot/urdf/meshes/fore_arm_R_col_plate_face.stl

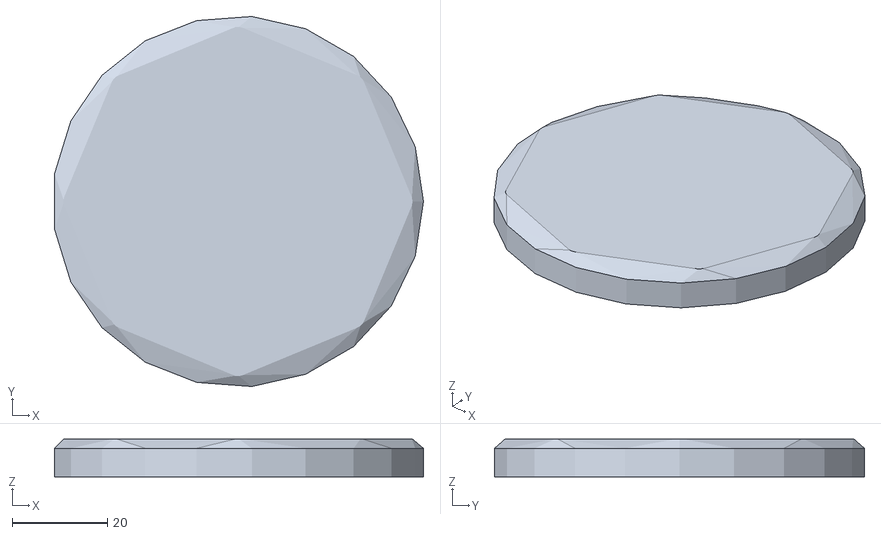
[picture p50: CAD file, 2026-09-21]
urdf/meshes/fore_arm_R_col_plate_face.stl
77.6 x 77.8 x 7.95
