Thuong180702/Bimanual-wall-climbing-robot/urdf/meshes/torso_upper_col_plate_shoulder_R_abduction.stl

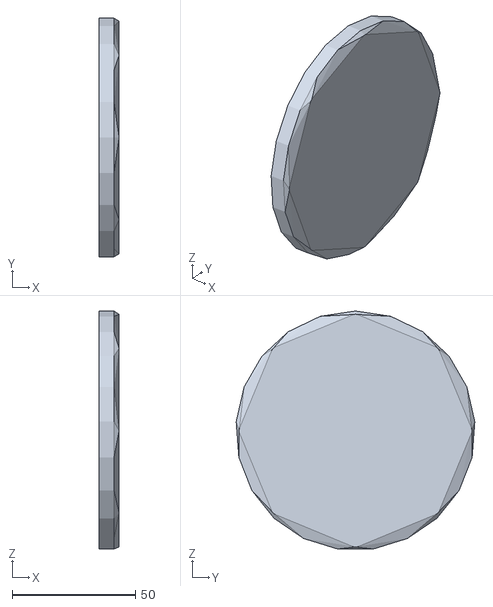
[picture p51: CAD file, 2026-09-21]
urdf/meshes/torso_upper_col_plate_shoulder_R_abduction.stl
7.95 x 96.7 x 96.5
