Thuong180702/Bimanual-wall-climbing-robot/urdf/meshes/torso_upper_col_wishbone_R_ring.stl

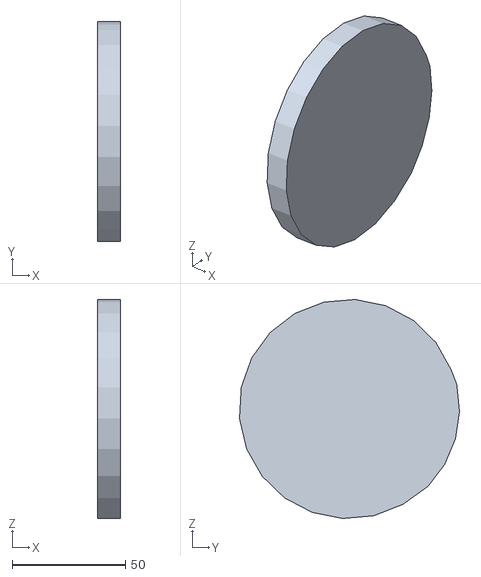
[picture p52: CAD file, 2026-09-21]
urdf/meshes/torso_upper_col_wishbone_R_ring.stl
10.0 x 97.3 x 96.8
