Thuong180702/Bimanual-wall-climbing-robot/urdf/meshes/torso_upper_col_wishbone_R_strip.stl

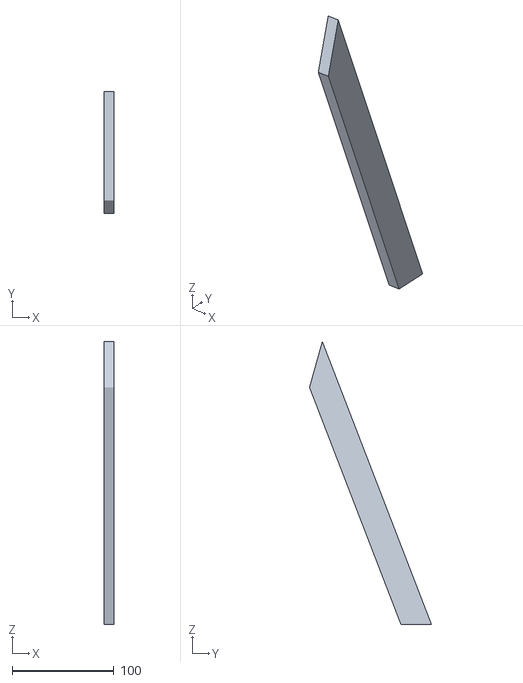
[picture p53: CAD file, 2026-09-21]
urdf/meshes/torso_upper_col_wishbone_R_strip.stl
10.0 x 119.8 x 277.9
