Thuong180702/Bimanual-wall-climbing-robot/urdf/meshes/base_link_col_wall.stl

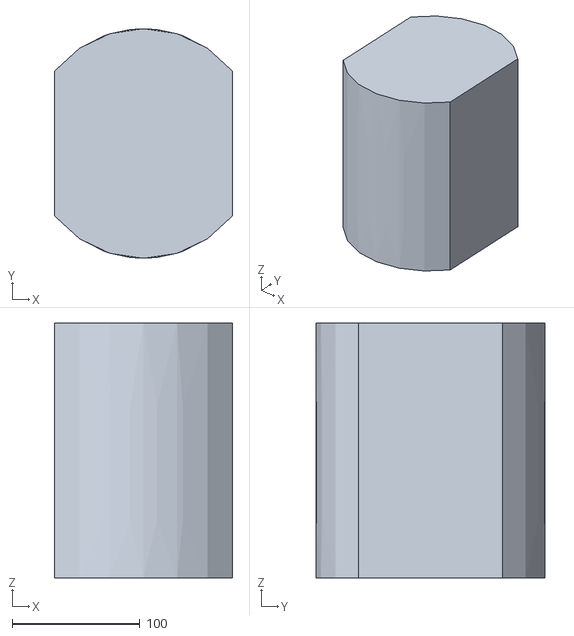
[picture p54: CAD file, 2026-09-21]
urdf/meshes/base_link_col_wall.stl
140.0 x 180.0 x 200.0
