Thuong180702/Bimanual-wall-climbing-robot/urdf/meshes/wrist_dev_L_col_plate_out.stl

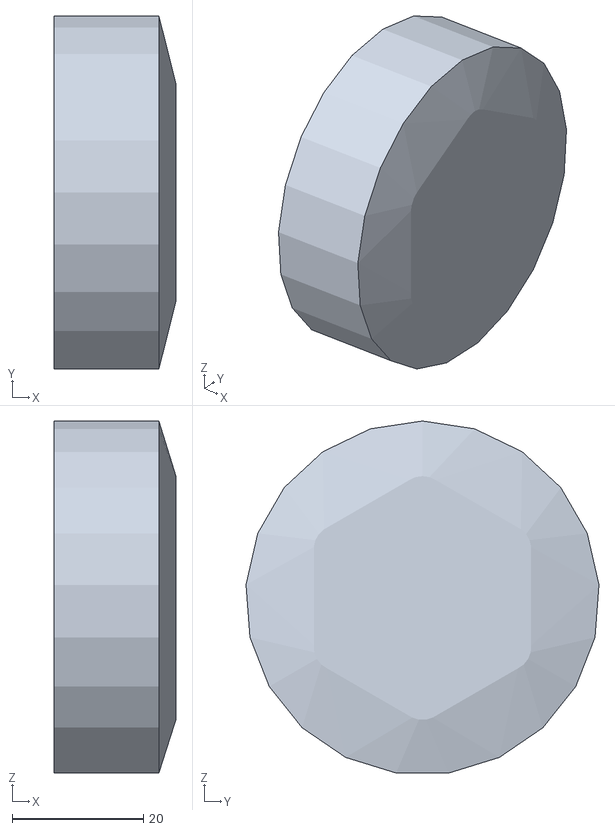
[picture p55: CAD file, 2026-09-21]
urdf/meshes/wrist_dev_L_col_plate_out.stl
18.6 x 53.8 x 53.7
