Thuong180702/Bimanual-wall-climbing-robot/urdf/meshes/waist_link_col_cone.stl

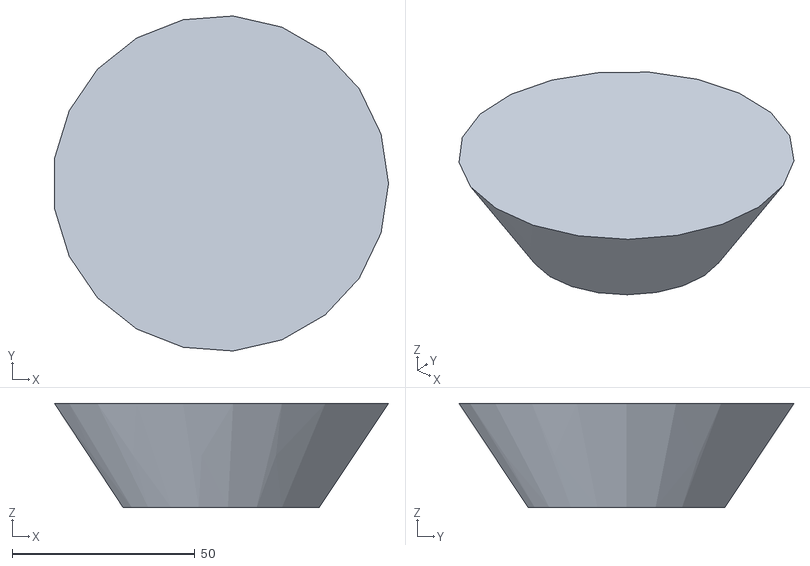
[picture p56: CAD file, 2026-09-21]
urdf/meshes/waist_link_col_cone.stl
91.5 x 91.7 x 28.5
