Thuong180702/Bimanual-wall-climbing-robot/urdf/meshes/upper_arm_R_col_plate_face.stl

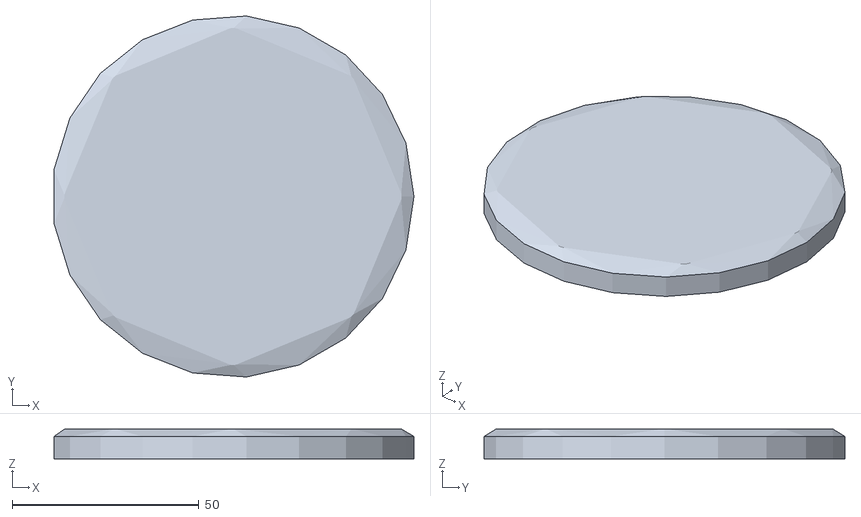
[picture p57: CAD file, 2026-09-21]
urdf/meshes/upper_arm_R_col_plate_face.stl
96.5 x 96.7 x 7.95
