Thuong180702/Bimanual-wall-climbing-robot/urdf/meshes/humerus_rot_R_col_plate_face.stl

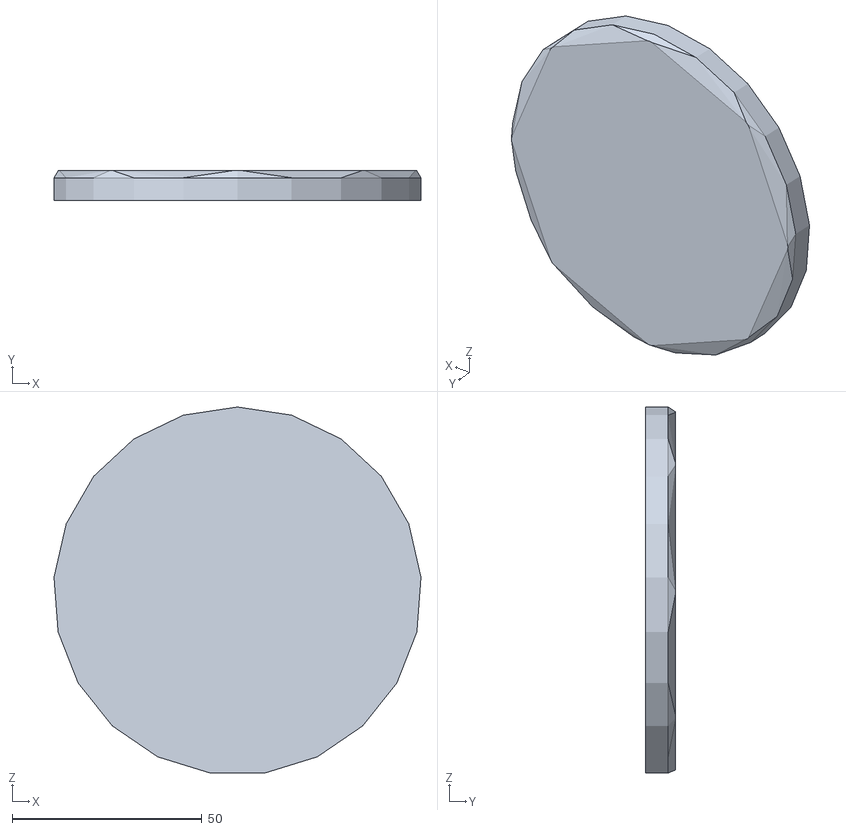
[picture p58: CAD file, 2026-09-21]
urdf/meshes/humerus_rot_R_col_plate_face.stl
96.7 x 7.95 x 96.5
