Thuong180702/Bimanual-wall-climbing-robot/urdf/meshes/waist_link_col_flange.stl

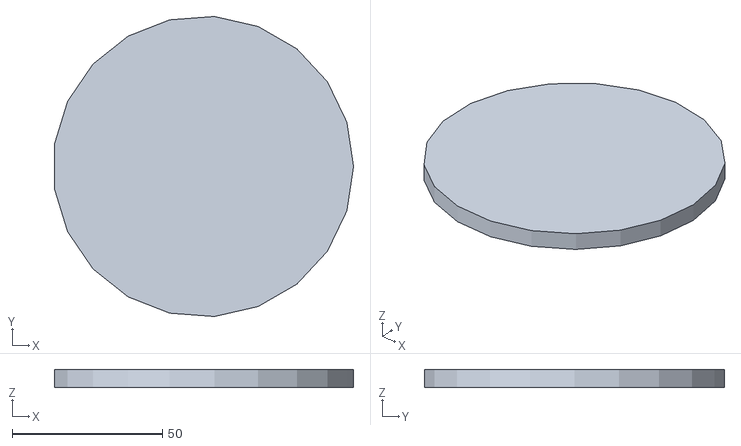
[picture p59: CAD file, 2026-09-21]
urdf/meshes/waist_link_col_flange.stl
99.4 x 99.7 x 6.00
