Thuong180702/Bimanual-wall-climbing-robot/urdf/meshes/fore_arm_R_col.stl

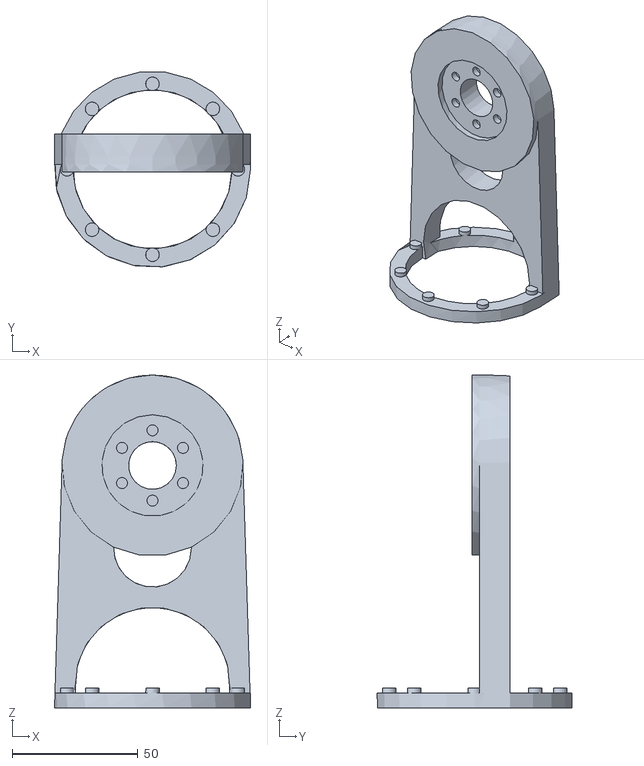
[picture p60: CAD file, 2026-09-21]
urdf/meshes/fore_arm_R_col.stl
78.0 x 77.5 x 132.5
