Thuong180702/Bimanual-wall-climbing-robot/urdf/meshes/torso_upper_col.stl

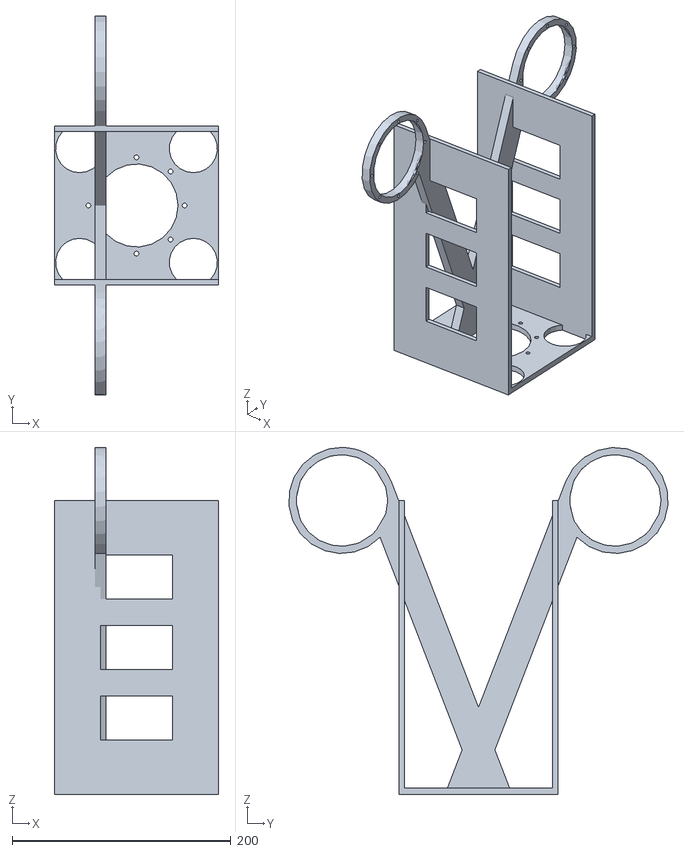
[picture p62: CAD file, 2026-09-21]
urdf/meshes/torso_upper_col.stl
150.0 x 346.6 x 317.5
