Thuong180702/Bimanual-wall-climbing-robot/urdf/meshes/forearm_rot_R_col.stl

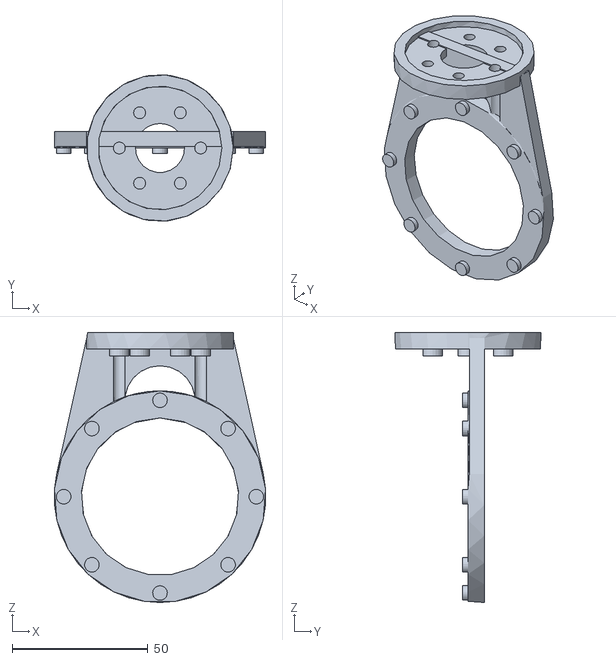
[picture p63: CAD file, 2026-09-21]
urdf/meshes/forearm_rot_R_col.stl
77.8 x 53.8 x 99.5
