Thuong180702/Bimanual-wall-climbing-robot/urdf/meshes/waist_link.stl

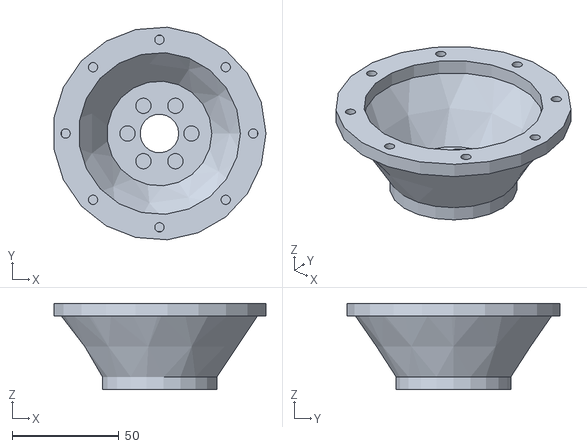
[picture p64: CAD file, 2026-09-21]
urdf/meshes/waist_link.stl
99.4 x 99.7 x 40.5
