Thuong180702/Bimanual-wall-climbing-robot/urdf/meshes/wrist_R_col.stl

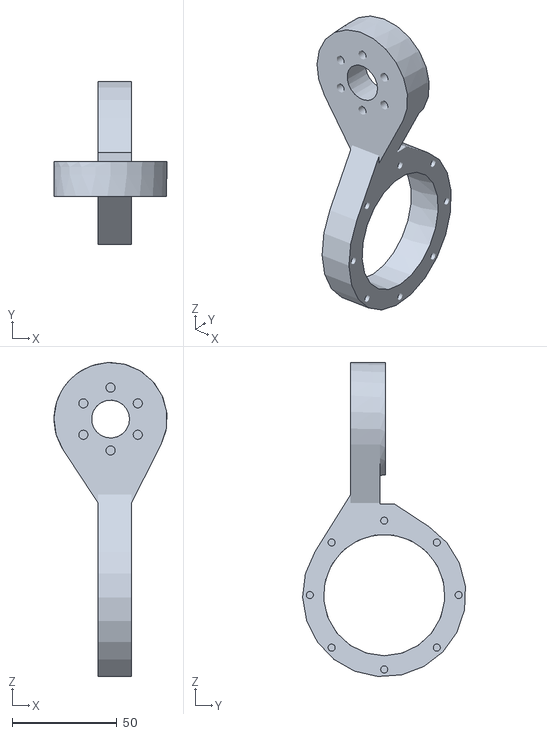
[picture p65: CAD file, 2026-09-21]
urdf/meshes/wrist_R_col.stl
53.9 x 77.8 x 149.9
