Thuong180702/Bimanual-wall-climbing-robot/urdf/meshes/wrist_dev_L_col.stl

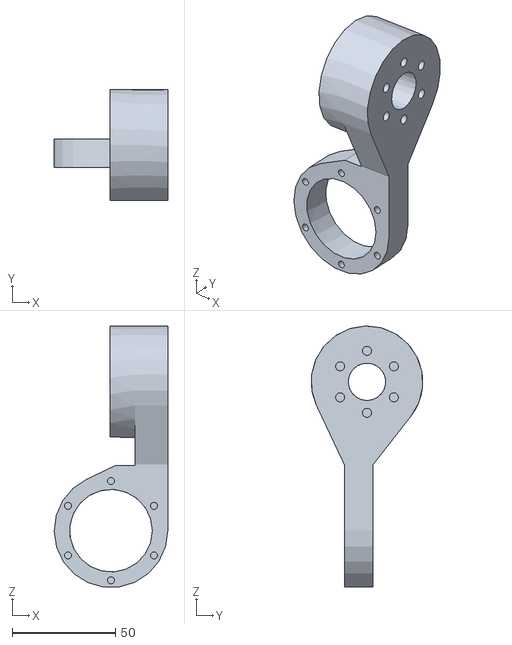
[picture p66: CAD file, 2026-09-21]
urdf/meshes/wrist_dev_L_col.stl
55.0 x 53.8 x 126.2
