Thuong180702/Bimanual-wall-climbing-robot/urdf/meshes/humerus_rot_R_col.stl

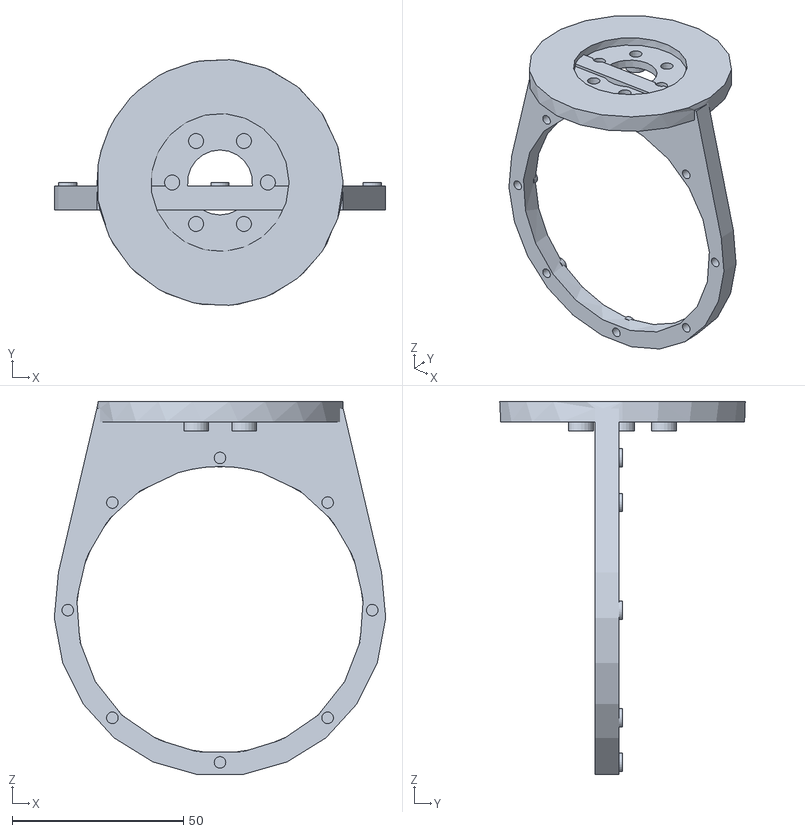
[picture p67: CAD file, 2026-09-21]
urdf/meshes/humerus_rot_R_col.stl
96.9 x 71.8 x 109.0
