Thuong180702/Bimanual-wall-climbing-robot/urdf/meshes/upper_arm_L_col.stl

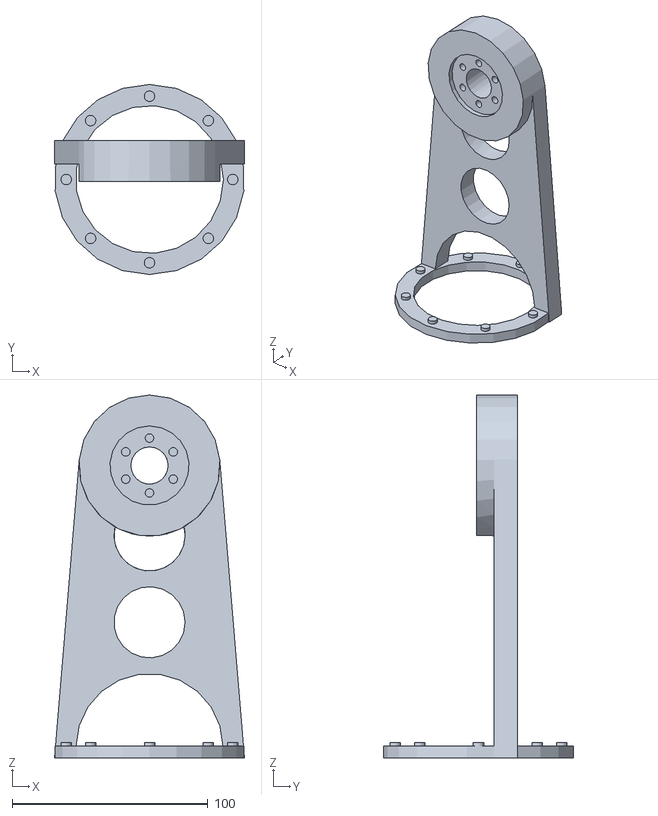
[picture p68: CAD file, 2026-09-21]
urdf/meshes/upper_arm_L_col.stl
97.0 x 97.0 x 185.3
