Thuong180702/Bimanual-wall-climbing-robot/urdf/meshes/shoulder_R_col.stl

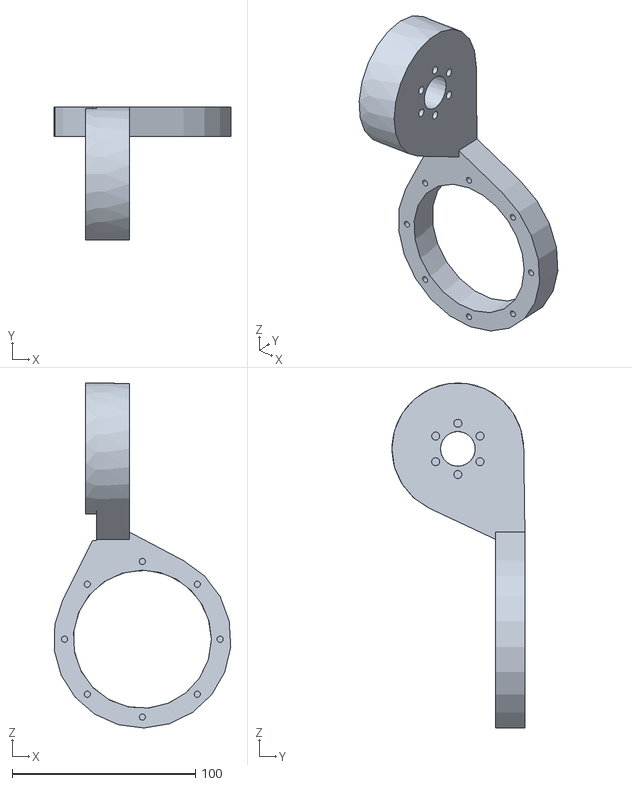
[picture p69: CAD file, 2026-09-21]
urdf/meshes/shoulder_R_col.stl
96.5 x 72.7 x 188.5
