Thuong180702/Bimanual-wall-climbing-robot/(list of files, cad)

Other CAD files:
urdf/meshes/upper_arm_R.stl
urdf/meshes/hook_L.stl
urdf/meshes/wrist_L.stl
urdf/meshes/torso_upper_col_back.stl
urdf/meshes/fore_arm_R.stl
urdf/meshes/base_link_col_hip_R.stl
urdf/meshes/humerus_rot_L.stl
urdf/meshes/forearm_rot_R.stl
urdf/meshes/torso_upper_col_wall_L.stl
urdf/meshes/wrist_dev_R.stl
urdf/meshes/shoulder_R.stl
urdf/meshes/shoulder_R_col_leg.stl
urdf/meshes/upper_arm_L_col_cheek.stl
urdf/meshes/shoulder_L_col_web.stl
urdf/meshes/fore_arm_L_col_cheek.stl
urdf/meshes/forearm_rot_R_col_cheek.stl
urdf/meshes/wrist_L_col_web.stl
urdf/meshes/wrist_dev_R_col_web.stl
urdf/meshes/humerus_rot_R_col_cheek.stl
urdf/meshes/upper_arm_R_col_plate_out.stl
urdf/meshes/shoulder_L_col_plate_face.stl
urdf/meshes/shoulder_R_col_plate_out.stl
urdf/meshes/fore_arm_L_col_plate_out.stl
urdf/meshes/waist_link_col_plate_out.stl
urdf/meshes/forearm_rot_R_col_plate_face.stl
urdf/meshes/torso_upper_col_plate_shoulder_L_abduction.stl
urdf/meshes/wrist_L_col_plate_face.stl
urdf/meshes/forearm_rot_R_col_plate_out.stl
urdf/meshes/humerus_rot_R_col_plate_out.stl
urdf/meshes/humerus_rot_L_col_plate_face.stl
urdf/meshes/wrist_R_col_plate_out.stl
urdf/meshes/torso_upper_col_wishbone_L_ring.stl
urdf/meshes/wrist_dev_L_col_plate_face.stl
urdf/meshes/upper_arm_L_col_plate_face.stl
urdf/meshes/fore_arm_L_col_plate_face.stl
urdf/meshes/wrist_dev_R_col_plate_out.stl
urdf/meshes/forearm_rot_L_col_plate_out.stl
urdf/meshes/torso_upper_col_wishbone_L_strip.stl
urdf/meshes/humerus_rot_L_col_plate_out.stl
urdf/meshes/wrist_R_col_plate_face.stl
urdf/meshes/forearm_rot_L_col.stl
urdf/meshes/wrist_L_col.stl
urdf/meshes/fore_arm_L_col.stl
urdf/meshes/upper_arm_R_col.stl
urdf/meshes/humerus_rot_L_col.stl
urdf/meshes/wrist_dev_R_col.stl
urdf/meshes/shoulder_L_col.stl
