Thuong180702/Bimanual-wall-climbing-robot/rl/HISTORY.md

# Development history

The journal of how the task, the reward, the robot model and the training method got
where they are: every run, and the measurement behind each choice. It is kept for the
evidence; `rl/README.md` describes the code as it is.

**Numbering changed on 2026-10-16.** Below, lessons -2..1.85 are the old CPU ladder (since
removed) and lessons/families 4-6 are the old ones: old 4 (the staircase) is now 5, old 5
(climb over a break) and old 6's second tier were dropped, and the new 4 is lesson 3 run
backwards. Lessons 1-3 and 7-9 are unchanged.

## The PPO curriculum, as it began

The frame for training PPO on the climbing tasks, as eighteen lessons ordered by
difficulty instead of the mixed scene.

```bash
python -m rl.lessons        # regenerate urdf/lessons/*.xml + smoke-check each
                            # (training writes a missing one itself; run this after
                            #  editing scene.xml or a lesson spec)
python -m rl.climb_task     # smoke-check the task API on every lesson
python -m rl.bench          # where the time actually goes on this machine
python -m rl.train_ppo --self-check          # curriculum logic, trains nothing

python -m rl.train_ppo --name climber        # train: every lesson, curriculum on
# Ctrl-C any time, then:
python -m rl.train_ppo --name climber --resume

# from a second terminal, while it trains:
python -m rl.status --name climber --watch

python -m rl.hardware       # GPU or CPU: which simulator training will use here
python -m rl.mjx_check      # the GPU path against this one (see "The GPU path")
```

`torch`, `gymnasium` and `stable-baselines3` are installed in this repo's `.venv`
(torch 2.13 / SB3 2.9 on Python 3.14 — no separate venv needed), and so are `jax`
and `mujoco-mjx` for the GPU path.

| file | what it is |
|---|---|
| `lessons.py` | the 18 lesson specs + scene generator (writes `urdf/lessons/`); 1..9 are the benchmark |
| `walls.py` | the generated walls the GPU path trains on: nine families, ADR's ranges, the wall check |
| `climb_task.py` | Gymnasium-shaped env: obs / action / reward / termination |
| `train_ppo.py` | thin SB3 PPO entry point, on either simulator |
| `hardware.py` | is there an NVIDIA GPU JAX can use — picks the simulator |
| `mjx_scene.py` | the robot MJX can simulate, and the lessons as data (writes `urdf/lessons/mjx_*`) |
| `mjx_task.py` | `climb_task` ported to JAX, thousands of envs in one GPU batch |
| `mjx_check.py` | the GPU path cross-checked against this one: task, physics, a trained policy |
| `bench.py` | simulator throughput vs env count, and cpu vs mps for the policy |
| `render.py` | PNGs of the lesson scenes → `out/scenes/` (ffmpeg writes them, no image dep) |
| `status.py` | what a run is doing, read from its checkpoint — safe to run while it trains |
| `eval.py` | score a checkpoint per lesson against a do-nothing control, with 95 % intervals |
| `plot.py` | a run's figures from the logs it keeps (`out/<name>/plots/`) |
| `gpu_setup.sh`, `gpu_run.sh` | a rented Linux GPU box: install, then train unattended and score |

## The real-actuator robot (Sept 21 2026)

`urdf/` is now the 21.9 kg robot generated from `cad/` — 17 CubeMars actuators,
masses from the solids, torque limits off datasheets. **Every policy trained
before it learned the 11.1 kg robot and is void: start a new run, do not
`--resume` an old one.** The shapes still match, so such a resume would load and
quietly be wrong; checkpoints now record which robot they learned (a hash of
`scene.xml`) and `--resume` refuses a different one unless given `--new-robot`.

**Then the shoulder was rebuilt pitch-first** (`cad/src/lib/spec.py`). The user
saw the raised arm grow out of a pivot *below* the abduction motor and fold back
up past it; ten of twelve published humanoids put the pitch actuator in the
torso and the roll actuator beside its output instead, and so does this robot
now. It is 21.5 kg; each arm's joints run flexion, then abduction, in `qpos` and
`ctrl`; and from the hang, positive abduction on the left is the outward flare,
which `scene.xml` has all of (−12…180°) — the lessons no longer widen anything.
Policies trained before it are void as well, and the robot stamp refuses them.
Canary on this Mac, 1.5M steps with 10 envs: lesson −2 passed before 100k, −1 at
~456k, and 0 was at 57 % with lesson 1 unlocked by the end.

The swap loaded cleanly and was broken in four ways, all found by this
directory's own checks — `python -m rl.climb_task` failed its incentive test —
and all fixed at the source:

- **The hooks hung back to front.** The re-mount in the elbow section below lived
  only in `scene.xml`, and regenerating the robot from the CAD dropped it: the
  throat faced away from the wall, the shank hung between rung and wall, and
  both wrists leaned on the wall. It is in the CAD now (`spec.MOUNT_ROT`), so a
  regeneration cannot lose it again. The hands start at ±155 mm again, which is
  what every lesson's goals assume.
- **The raised arms were jammed into the torso.** MuJoCo collides each mesh's
  convex hull, and the torso frame exported as one mesh was one hull — a block
  out to the shoulder plates — that the raised upper arms sank 10–22 mm into,
  18–52 mm from any real metal. The hang held four shoulder actuators at 88 % of
  peak torque against 1500 N of contact. Each CAD part is its own hull now; the
  hang holds on ≤3.2 N·m per joint, and of the self-contacts reported in the
  climbing envelope 14 % were hull artefacts, down from 71 % (2 % since the
  chest became a box of plates, pitch-first) — the flare the lessons exist for
  is no longer blocked by air.
- **The two idle baselines were the old robot's.** `TAU_IDLE` 30 N·m and
  `WEIGHT` 109 N were typed in; the new robot hangs still on ~61 N·m and weighs
  215 N, so standing still was charged as effort and as fighting: −58 over
  lesson 1 against −10 for a fall, the `win5` trap exactly. Both are read off the
  model now (`ClimbTask.tau_idle`, `.weight`); a still hang costs −7.89.
- **A training env held 1.5 GB.** The actuators' visual meshes are 168k vertices
  a model and an env holds every lesson. Training loads the scenes without them
  (`MultiLesson(visual=False)`; the physics is bit-for-bit the same) and stores
  collision meshes as hulls: 0.33 GB per env, ~0.55 GB per worker process once
  torch is imported. Budget `--envs` x 0.6 GB. Only `rl.render` loads the visuals.

The self-checks' side pulls (25 N, 60 N) are fractions of body weight now: a hook
is held along its rung by friction, which scales with the load, so the same
newtons prove nothing on a robot twice as heavy.

**What is really different, measured:** moving costs about 4x the torque above
idle it did (77 against 18 N·m under the same random actions) — mostly the
reflected rotor inertia, `armature` 0.21 kg·m² on every AK80-64 joint where the
old robot had 0.01. `K_EFFORT` is unchanged; if the early curriculum stalls, it
is the first knob to A/B. And the estimate's still-hang anchor wander is ~20 mm
(was ~12): the lever from the anchor hook to the base is 1.5x longer.

**Canaries, fresh runs on this Mac.** On an intermediate collision model (the
wishbone still one hull) two runs passed lesson −2 at ~175k and ~150k steps, and
one reached lesson 1.2 by 2M. On the final model one run passed −2 at 950k and
another was still at 0 % after 1M, parked in the `win5` basin (hanging to the
timeout, fluttering both hooks, the left hand never travelling). The physics is
not what blocks it: the stuck policy fails on both models, and trained policies
transfer between them both ways (20/20 and 16/20 on lesson −2). The early
curriculum's seed variance is large; **if lesson −2 has not passed by ~1M steps,
start again under a new `--name`** rather than waiting it out. Policies trained
on the abduction-first shoulder rested their arms at the −170° flexion stop,
leaning on a real 1.4 mm contact with the torso; pitch-first there is nothing
there to lean on.

## What the GPU path trains on: generated walls and ADR (the method)

**The benchmark is lessons 1..9, and training never sees them as such.** They are the
fixed test set, scored on the full robot in C MuJoCo (`rl.eval`, `gpu_run.sh` step 3).
Training draws its walls from nine *families* (`rl/walls.py`), one per benchmark lesson
and written down before any training: each is its lesson's structure with a few
physical parameters left free, and each parameter has a range.

| family (benchmark lesson) | parameters ADR grows (first top -> last top) | the lesson's own value |
|---|---|---|
| 1 traverse | each hand's shift along the row (0.30 -> 1.40 m) | 1.10 |
| 2 gaps | gap count (1 -> 2), gap width (0.04 -> 0.30 m) | 2 x 0.25 |
| 3 climb up | rows straight above, each standing `OUT` = 0.20 m further out from the wall: rows (1 -> 2), row spacing (0.20 -> 0.45 m: reaching out costs the free hook height) -- in one plane, 0.10 -> 0.50 m, until 2026-10-06, below | 2 x 0.40 |
| 4 climb down | a staircase of short rungs, each lower and further along: steps (1 -> 3), drop a step (0.30 -> 0.45 m), gap a step (0.10 -> 0.30 m) | 3 steps, <= 0.40 down, <= 0.20 on |
| 5 climb over | break in the start row, a row above to go round it, over the break alone (1.80 -> 2.50 m: past the 1.55 m it can bridge) | 2.20 |
| 6 staggered | tiers of short rungs, each tier past the end of the one below: tiers (1 -> 2), tier rise (0.30 -> 0.50 m), height scatter (0.02 -> 0.08 m) | 2, ~0.46, 0.06 |
| 7 corner | side wall distance (0.60 -> 1.10 m) | 1.00 |
| 8 behind | back rung distance (0.35 -> 0.70 m) | 0.63 |
| 9 swing gap | one gap in the row (0.55 -> 0.90 m: past the static reach; 1.10 until the one motion found across 0.90 took all the reach there is, below) | 0.90 |

The ranges come from the robot's reach, measured hanging from one hook with
`urdf/_reach.py`'s constraints (no self-collision, both hooks latchable, a hang): 0.56 m
up; 0.64-0.68 m along a rung hanging still, 1.50-1.55 m with momentum at most; 0.65 m
down at 0.15 m aside, 0.8-0.9 m at 0.3-0.45 m aside. So a staircase step is always
within reach, the climb-over break can only be climbed round, and the swing gap needs
a swing from 0.58 m of gap on. Climbing down comes before climbing over, which needs
both. No climb has a row straight under the hang in the rung plane, because that row
is inside the robot: its arms hang 59-107 mm off the plane and fill 0.10-1.10 m below
the hooks (wrists 15-23 mm inside a row 0.10-0.15 m down, forearms and upper arms
6-25 mm clear at 0.20-0.50, the base inside at 0.60-1.00). Down (4), and up and down
in 5 and 6, are diagonal: each row starts past the end of the one below; the free hand
reaches 0.53-0.56 m up anywhere within 0.63 m aside. Straight up (3), each row stands
out from the wall instead, and the rows below are behind the robot.

Everything else about a wall -- segment lengths, where a rung ends, goal offsets,
which way it runs (half are mirrored: the robot is symmetric, the benchmark is not) --
is drawn uniformly from fixed ranges. Every wall is checked before use
(`walls.Checker`): its goals on seats of their rungs, nothing but the start rung
within 2 cm of the robot in its start hang, and nothing but the goal rungs within
2 cm of that hang moved to the goals. `python -m rl.walls` asserts every family
gives usable walls at its first and last ranges, and that each benchmark lesson is a
wall its family can draw at its last range. A checkpoint records each family's ranges
with its tops (`walls.spec`); on a resume a family whose ranges have changed since
starts over -- first tops, no probes, no books -- and a checkpoint from before the
record is read against `walls.LEGACY` (gpu1's family 3 went from 0.30 back to 0.10 m).

**The curriculum is two fixed rules and nothing chosen by hand while training:**

- *Families enter in the benchmark's order*, by the unlock rule the CPU path already
  had: the next family joins when every family in the pool is passed 70 % of the time
  over its last 200 walls (`WALL_WINDOW`). Nothing ever leaves the pool, and the steps
  go where the failures are. A family enters only once the families it is made of
  have passed (`walls.NEEDS`: 5, over a break, needs 4 and 6 -- its step up is 6's, in
  the wall's plane, not 3's out from it (gpu8); 6, the tiers, 2 and 3; 4, 7, 8 and 9 need
  no climbing up), fixed with the families; with nothing stuck they enter 1, 2, 3, 4, 6,
  5, 7, 8, 9 (`walls.ORDER`). A family that has not
  passed once in 50M steps (`STUCK_STEPS`) is never dropped: it stays in the pool with
  the steps its failures draw -- MIN_SHARE once it has no rl.rsi climb to learn from
  (`Walls.capped`) -- and its upgrades stay locked, and it stops holding back
  only the families that do not build on it. One that has passed holds the pool back
  whenever it slips below the gate again.
- *Inside a family, automatic domain randomization* (OpenAI et al. 2019, "Solving
  Rubik's Cube with a Robot Hand"; the terrain curriculum of Rudin et al. 2022): each
  parameter is drawn uniformly below its current top, except that half of the walls
  put one parameter exactly at its top. When 200 of those in a row are passed 70 % of
  the time, that top moves up one step; at 20 % or less, down one. A wall counts only
  at the top it was drawn at.
- *Both rules count whole cohorts*: episodes in the order they **started**, each once
  every episode begun before it has ended (at most 60 s, 1516 control steps; 1 % over
  because MJX keeps time in float32 and it runs slow). Counted as they end, the first
  in are the short ones, and thousands of envs make that the whole sample: with 256
  envs the first 20 family-1 walls to end were re-grips in place, 20/20 at 5k steps,
  and family 2 unlocked on them, while over whole cohorts family 1 was at 20 % at
  131k. Which of the episodes begun together end first says nothing about any of
  them, so a rate over all of them is the policy's however long each ran. It costs
  each decision one episode's delay; a rollback also drops what the old policy began.

**Why 200 and not the CPU path's 40, and why a stuck family is skipped (2026-10-04).**
4096 envs end hundreds of a family's episodes between two updates and the gate is
asked after every one, so a 40-episode window is a sample drawn again and again: a
family truly at 60 % passes it at 70 % 13 % of the time, one at 65 % 31 % -- the 70 %
gate was a 55-65 % one, which is the unlock-on-half-learnt the gate exists to stop
(win17). Over 200 walls: 0.2 % and 8 %. It costs no time, since a vote already waits a
cohort's lag (6.2M steps) for its probes: gpu1 moved each top once per 6-8M steps. And
the order was a chain: gpu1's family 3 sat at 0 % for 90M steps with 4-9 locked behind
it, while families that could be learnt passed the gate 6-12M steps after entering --
and only 5 and 6 climb up. Skipping it outright would open its upgrades on a skill
nobody has, so they wait for it; nor are families opened in parallel: one at a time,
only once the stuck one has had 50M steps, and a family once learnt still has to be
held before anything new comes in -- every task added to the pool pulls on the same
network.

So the question a reviewer asks of a hand-made lesson ladder -- how many lessons are
enough, and how many more for lessons 3..9 -- has no answer to give: the difficulty is
continuous, the rule moves it, and the benchmark is fixed in advance. The ablation is
one flag, `--walls random` (`WALLS=random` for `gpu_run.sh`): the same walls at their
last ranges from the first step, every family at once. The best checkpoint uses how far
the tops have come (0..1 a family, 9 in all) instead of a sum of success rates, which
ADR keeps near its thresholds by design; the guard adds what each family the best had
passed still holds of the 70 % gate (1 at or over it, 0 at 0 %), because a family
forgotten inside ADR's dead band -- probes passed 20-70 % -- moves no top and progress
alone never saw it; among checkpoints ADR has
taken equally far, the best is the one passing its training walls most often (worth at
most 0.01, under the smallest step of any top, 0.038) -- otherwise it would freeze the
moment every top reached its last, where a run spends most of its steps. The
benchmark never chooses a checkpoint. A generated episode lasts
at most 60 s -- lesson 1's timeout, at which hanging still costs less than falling.

On the GPU a bank of 1024 walls is drawn at the start of every rollout and each env
takes one at every reset; an env copies its wall into its own state, so a new bank never
moves a rung under a robot mid-episode. `--walls lessons` keeps the fixed lesson ladder
below (the CPU path's, and the only one it can run).

## Lessons

−2. left hand, one step (0.30 m) → −1. right hand, one step (0.30 m, the other way)
→ 0. both hands, one step (0.40 m) → 1. traverse, continuous rung → 1.1. stop at the
end of a rung → 1.2 / 1.35. cross one gap of 0.04 / 0.08 m → 1.5. traverse, two gaps
of 0.12 m → 1.7. cross one 0.18 m gap → 2. traverse, gaps (0.25 m) → 3. climb up two
rows 0.40 m apart, each standing 0.20 m further out → 4. climb down a staircase (3 steps) → 5. up, over a 2.2 m break and down → 6.
staggered heights → 7. perpendicular wall → 8. wall behind the back → 9. swing across a
0.90 m gap (past the static reach). Lessons 1..9 are the benchmark; each goes toward the
robot's left (+y) and is also scored mirrored, toward its right (`rl.lessons.mirrored`,
`rl.eval --mirror`) -- the training walls are mirrored half the time.

Lessons −2, −1 and 0 are one lift-and-place cycle. They exist because lesson 1 —
five such cycles per hand — stopped being findable from scratch once dragging and
jumping stopped paying; the `win5` section below has the numbers, and why the step
is one hand at a time first, each hand in turn, and 0.40 m rather than 0.30 after.

Every lesson keeps the robot, sensors, actuators and the verified hanging keyframe
of `urdf/scene.xml` verbatim and swaps only walls + rungs, so all start states are
the same known hang.

## One policy, not nine

The lessons are a curriculum, not nine separate jobs. **One shared policy trains on
all of them mixed**, and the curriculum only controls which lessons are in the
sampling pool — nothing ever leaves it.

Why not the two alternatives:

- **Nine specialists + a dispatcher** trains easily and isolates failures, but the
  nine share almost everything that is hard — hanging without falling, moving weight
  onto a hand, seating a hook in a ±25 mm window — and each would learn it again
  from scratch. It also leaves the seams untrained: the posture a traverse ends in
  is not in the climb specialist's training distribution.
- **A meta-policy calling nine sub-policies** (hierarchical RL) would learn what a
  search already does: which hold next is A\* over the wall map, deterministic.
  Learning that choice is harder than the problem it solves.

- **One policy over all lessons** needs no dispatcher, because the goal is already
  in the observation: it is *goal-conditioned*, not lesson-conditioned, and at
  deploy time a planner supplies the goal exactly as a lesson spec does.

**Lessons are mixed, never sequential.** Fine-tuning lesson 1 → 2 → … → 9 in order
is the obvious reading of "curriculum" and it is the one thing to avoid: training on
lesson 9 erases lesson 1 (catastrophic forgetting). Each env draws a fresh lesson
from the active pool on every reset instead, and a lesson unlocks when **every**
lesson in the pool clears 70 % success over 20+ episodes (it was the newest alone
at 60 % until `win17`). `--self-check` asserts that a lesson never leaves the pool.

## Pausing and resuming

`Ctrl-C` (or `SIGTERM`) saves and exits 0. A checkpoint is three files in
`out/<name>/`, always written together — a model restored against stale observation
statistics sees a different input scale than it trained on and reads as silently
degraded:

| file | what it holds |
|---|---|
| `model.zip` | policy + value net **and the Adam optimizer state** |
| `vecnorm.pkl` | running observation mean/variance |
| `state.json` | timestep count, unlocked pool, per-lesson success history, the best score and its lessons, the learning rate, rollbacks so far |

`--resume` restores all three and continues the timestep counter. On resume,
`--steps` means *additional* steps, not a new total. Periodic checkpoints every
`--ckpt-every` steps (default 100 000) on top of the Ctrl-C one.

`Ctrl-C` on Windows usually reaches the worker processes first, so the trainer
sees a closed pipe rather than a `KeyboardInterrupt`; that path saves too (as
does a worker killed by the OS), because `win17` lost the 55k steps since its
last checkpoint to it at 41.7M. For a run that should survive that on its own,
loop the resume: `for /L %i in (1,1,50) do python -m rl.train_ppo --name win17
--resume --lessons=... --steps 30000000`.

**A run looks after itself.** It does not need someone watching for a drift and
resuming from best by hand: if the best checkpoint's lessons fall a whole lesson
below that best for 325 policy updates (a million steps at the CPU path's 12 envs
x 256; an MJX update is 131k steps, so the patience is counted in updates, the
clock a policy changes on), the run goes back to `best_*` by itself and carries on
at half the learning rate and half the KL target (the `win17` section has the rule
and why). The update size is kept in range as well: each action dimension's std is
held in [0.05, 1] and the learning rate moves to keep every update's KL near the
run's target, 0.1 to start (`win17 2`). `python -m rl.status` shows the current rate and how many times it
has gone back, and everything the run prints is appended to `out/<name>/train.log`.

## The grip pad — why the lesson scenes differ from `scene.xml`

The hook is a slot round a smooth cylinder, so nothing holds it along the rung axis:
the bare hook travels ~107 mm under 40 N (`rl.lessons.slide_test`). The first
two PPO runs both solved lesson 1 by exploiting that instead of climbing — the hooks
never left the rung (throat-to-rung gap never exceeded 43 mm on a 50 mm throat) and
the robot simply shoved itself 1.1 m sideways.

**The fix goes on the hand, not the wall.** A climber chalks up and wears rubber;
they do not groove the rock. And a real climber can still slip, so the aim is to make
the slide small and honest, not to abolish it — what is left is the policy's problem.
(Collars on the rungs were built and measured first, and rejected on exactly this
argument: they worked, at the price of turning the wall into a jig.)

Raising the hook's friction alone does **not** work, and the reason is the useful
part: the contacts are far too soft, so extra friction just funnels more force into
the contact and the hook sinks *into* the rung. Penetration against µ, measured:

| µ | 1.0 | 1.4 | 1.8 | 2.0 |
|---|---|---|---|---|
| penetration | 3.3 mm | 7.1 mm | 18.3 mm | 21.7 mm → **falls through** |

Rubber only becomes available once the contact is stiff enough to carry it. The pad
is therefore `friction 2.0` **plus** `solref 0.005` and `solimp` d_max 0.99, with
`priority="1"` so the hand's pad defines the contact outright instead of being
averaged with the rung — which is the physical statement too, since the pad is the
soft part that deforms.

Phase 7 re-measured under its own grip conditions, hook travel along the rung:

| pull | bare hook | grip pad |
|---|---|---|
| 20 N | +42 mm | **+5 mm** |
| 40 N | +107 mm | **+16 mm** |
| 60 N | +2914 mm, off | +2162 mm, off |
| 80 N | +9987 mm, off | +5686 mm, off |

At 60 N and above the hook is levered off the rung either way — a different failure
on a different axis, which the pad neither helps nor hurts. That is the "a climber
slips too" regime, and it is left in on purpose. The hang keyframe is unaffected
(drift 1.75 mm, both hooks seated).

Most of the win is the stiffness, not the rubber: µ 1.0 with the stiff contact
already gives +35 mm. µ 3.0 would give +15 mm instead of +20, but 2.0 is the safer
claim for rubber on metal and costs 5 mm.

`scene.xml` keeps the bare hook the CAD draws. Only `urdf/lessons/*` -- what the
policy trains and is judged on -- get the pad.

## Design decisions

- **The flare is in the model.** A human climbs by flaring the shoulders in the
  wall plane and flexing the elbows. The abduction-first shoulder only travelled
  inward from the hang, so the lessons used to open it 60° outward; the
  pitch-first one flares with positive abduction on the left, and the lessons
  take `scene.xml`'s range (−12…180°) as it is.
- **Obs are hardware-legal** (encoders, raw IMU, F/T, pads, own setpoints, goal
  relative to the anchor-rooted estimate, and the 3 nearest rungs per hand), and
  read as badly as the real sensors would: noise and offsets on every sensor, a
  lidar SLAM that drifts and arrives late, a lidar-fitted wall map — see *The
  sensors read like real ones*. **Reward and success use ground truth** — a
  training-time oracle, per the model README.
- **The policy can see the nearby rungs.** Without them it knows where the goal is
  and nothing about what lies between, so lesson 2 (gaps) and 6 (staggered) are
  guesswork and one shared policy could only memorise each fixed layout. Three
  rungs per hand is what a hand chooses between; the map supplies them.
- **Action** = setpoint deltas on all 17 position servos at 25 Hz, ±1.5 rad/s.
  Smoothness comes from the action-rate and joint-velocity penalties.
- **No autonomy layer.** Goals come from the map. Which hold next is a search over
  it, outside the policy; the classical controller's A\* did it (git history), and
  nothing picks goals for a trained policy yet.

## Training on this Mac — measured, not assumed

`--device mps` runs the policy on the Mac GPU and works, but it is **2x slower**.
Same 40960-step run on an M4 Pro (12 CPU cores, 16-core GPU), lesson 1, 8 envs:

| device | fps |
|---|---|
| `cpu` (default) | **4107** |
| `mps` (Mac GPU) | 1994 |

The network is the wrong shape for a GPU: 99 → 64 → 64 → 17 is far too small to
cover Metal's per-kernel launch overhead (`rl.bench`: 2183 updates/s on cpu vs 1726
on mps), and MuJoCo runs on the CPU regardless, so every rollout step pays a
host↔device copy on top. **The simulator is the bottleneck** — ~10 000 control-steps/s
across 12 processes, while the policy update costs under a fifth of wall clock.

So the lever is parallel envs, not the GPU. Measured end-to-end fps by `--envs`:

| envs | 6 | 8 | 10 | **12** | 16 | 20 | 32 |
|---|---|---|---|---|---|---|---|
| fps | 3413 | 3950 | 4064 | **4330** | 4681 | 4977 | 5259 |

Default is 12 (the core count). It keeps creeping up past that because envs idle
during each policy update, but 32 buys 21 % over 12 for 2.7× the processes and an
8192-sample rollout. Re-run `python -m rl.bench` on any other machine.

This flips if the policy grows a vision encoder — then measure again.

**The real GPU path is the simulator, not the policy**: MJX runs the physics and
the whole task on the GPU with thousands of envs in one batch. It exists now —
see "The GPU path" below — and needs an NVIDIA card; on Apple silicon it would
need `jax-metal` (still experimental), so this Mac trains on the CPU path.

## Moving to a Linux + CUDA machine

Nothing here is Mac-specific. The RL path imports no OpenGL, so it runs headless.

**A rented GPU box, the whole run unattended** (tested target: Ubuntu 22.04, a
Tesla V100 16 GB, NVIDIA driver >= 525):

```bash
git clone https://github.com/Thuong180702/Bimanual-wall-climbing-robot.git && cd Bimanual-wall-climbing-robot
bash rl/gpu_setup.sh                   # .venv with Python 3.12 + requirements-gpu.txt
mkdir -p out && nohup bash rl/gpu_run.sh gpu1 > out/gpu1.console 2>&1 &
tail -f out/gpu1.console               # or: .venv/bin/python -m rl.status --name gpu1
```

`gpu_setup.sh` needs no root: Python 3.12 comes from `uv` (jax 0.11 needs >= 3.12,
Ubuntu 22.04 ships 3.10), and `requirements-gpu.txt` pins every version, including
the two a V100 decides: JAX's **CUDA 12** wheels (its CUDA 13 ones need compute
capability 7.5; a V100 is 7.0) and torch's **cu126** build (PyTorch dropped Volta
from its CUDA 12.8 builds in 2.11). `gpu_run.sh <name>` then does three things and
needs nobody:

1. **preflight**, once per commit, `ENVS`, `WALLS` and card: JAX and torch on the card in one process, the JAX
   task still ClimbTask's on this card (`rl.mjx_check task physics`), a batch of
   `ENVS` fits (halved, down to 1024, until one does -- and the run keeps that size),
   MJX's Warp backend against C and JAX -- these four at once, each its own process
   (`check_*.txt`): each is one robot at a time or XLA compiling, a core apiece with
   the GPU near idle, and one after another they were 33 of gpu4's 42 preflight
   minutes; each on its own quarter of the cores (unpinned, four processes sizing their
   thread pools for all 96 ran gpu6's box out of threads), and one that still dies
   beside the others runs again alone; the run steps on Warp if it is C's physics, untimed (gpu5: 2.82x JAX) -- then a tiny run that
   saves and resumes; each step at most an hour. It stops here on any failure -- and it never falls back to training on the CPU.
   Each step is announced in the console with its time, and prints as it goes
   (`PYTHONUNBUFFERED`: piped, Python used to hold a step's whole output until it
   ended, and gpu1's first preflight looked hung). Through the task and physics
   check the GPU sits near idle -- it compiles, then runs one robot at a time -- and
   the console's `numa_hwloc ... hwloc_set_cpubind() failed` (XLA may not pin its
   threads inside a container) and `Failed to import warp` (MJX's optional backend)
   are harmless. A step that does hang prints its stacks when its hour runs out.
2. **trains** on generated walls with ADR (the method above; `WALLS=random` is the
   no-curriculum ablation), resuming by itself: a crash restarts from the last
   checkpoint, and so does a trainer that has written no PPO update for `STALL`=30 min
   (hung on the card: told to stop, killed if it does not) -- at most `MAX_FAILS`=3
   times in a row within an hour each. It stops at `HOURS`=24 (whole hours) or `TOTAL`
   steps, saving on the way out. Tested on this Mac with a `kill -9` and a `SIGSTOP`
   injected into one run: both resumed from the last checkpoint, and the run finished,
   scored, replayed and packed by itself.
3. **scores** the best checkpoint on the FULL robot in C MuJoCo, on the benchmark --
   lessons 1..9 both ways round (as drawn, toward the robot's left, and mirrored),
   `EPISODES`=50 each, against doing nothing (`eval.txt`) -- and replays
   it on the full robot, the simplified one and MJX (`sim2sim.txt`). `provenance.txt`
   has the commit, the GPU and every package version.

After a reboot, the same command picks the run up (preflight skipped), and so does a
second call on purpose: `HOURS=2 SCORE=0 bash rl/gpu_run.sh gpu1` first, to read the
card's control-steps/s off `preflight.txt` and the first checkpoints off the log,
then `HOURS=22 bash rl/gpu_run.sh gpu1` carries the same run on (`SCORE=0` skips the
30-60 min of CPU scoring the GPU would sit idle through: 18 jobs, both ways round). `SEED=1 bash rl/gpu_run.sh
gpu1s1` is a second seed -- a paper reports several. `HOURS` counts from the call and
covers the preflight; the scoring comes after it, so rent `HOURS` + ~1.5 h (setup, the
scoring, croc). A resume draws on from `SEED` + its steps, never the start's sequence
again (`PPO.load` alone would put every restart back on the bare seed).

**Carrying a run to another box** -- the pilot on one rental, the long run on the
next: `out/<name>.tgz` is the whole run (the last checkpoint with its optimizer,
observation statistics and ADR state, the best, the snapshots, the logs). On the new
box, after `gpu_setup.sh`, croc it over and hand it to the runner wherever it landed:
`HOURS=22 bash rl/gpu_run.sh gpu1 ~/gpu1.tgz`. The runner unpacks it into
`out/gpu1/` itself and says from how many steps it carries on; a run already there
stops the call instead, whichever run it is (called again, drop the `.tgz`). Unpacked
by hand, anywhere but the repo's `out/`, a package leaves the run without its
checkpoint, and gpu1's 22 h run started again from step 0 without a word. The preflight runs again there
(the card is in its stamp) and training resumes from the last checkpoint;
`provenance.txt` records both machines.

**What a run leaves in `out/<name>/`, for an audit and for the paper** -- every file
appended across resumes, none of them needing the trainer to read:

| file | what it holds |
|---|---|
| `train.log` | everything the trainer printed, a crash's stack included (faulthandler, so a crash inside XLA or CUDA too) |
| `progress.jsonl` | PPO's table, one line an update: return, episode length, approx_kl, clip fraction, rate, std, losses, fps |
| `metrics.jsonl` | one line a checkpoint -- per lesson: success over the last 40, how the episodes ended, mean length; the pool, best, rate, KL target, contact cap -- and one per event: start (every hyperparameter), unlock, an ADR top moving, best, rollback, exit (and the error, if it crashed) |
| `gpu.csv` | the card every minute: load, memory, temperature, power, clock |
| `gpu_run.log` | the runner's own lines: restarts and why, budgets reached, scoring |
| `eval.txt`, `eval.jsonl` | the full robot's score per lesson with its 95 % Wilson interval, and the do-nothing control |
| `sim2sim.txt` | the same policy on the full robot, the simplified one and MJX |
| `provenance.txt` | the commit, any uncommitted change, nvidia-smi, every package version |
| `snaps/` | the policy every 50M steps (`--snap-every`), kept: the learning curve is the benchmark scored on each of them, on the full robot, after the run (`rl.curve`) |

`python -m rl.plot --name gpu1` draws them into `out/gpu1/plots/`: each family's
success over the run with unlocks and rollbacks marked, ADR's progress through each
family's ranges, return / KL against its target / rate / std, the ways episodes
ended, the full-robot score with its intervals, and -- after `python -m rl.curve
--name gpu1` has scored every snapshot (hours of CPU, so at home, not on the rented
box) -- the learning curve on the benchmark. It needs matplotlib, which the GPU box
does not install -- plot at home.

**Getting it home:** `gpu_run.sh` ends by packing the run into `out/<name>.tgz` and
printing the line to send it: `croc send out/gpu1.tgz` on the box (`gpu_setup.sh`
installs croc's latest release, checked against that release's checksums, and updates
it on every run: the two ends must run the same version, and a pinned 11.5.3 fell
behind the Mac's), then on the Mac (`brew upgrade croc`) `CROC_SECRET=<the code it
printed> croc --yes`. croc is
end-to-end encrypted (a key agreed from the code phrase), direct when it can be and
through its public relay when not. At home:

```bash
tar xzf gpu1.tgz -C out
.venv/bin/python -m rl.curve --name gpu1      # every snapshot on the benchmark, full robot
.venv/bin/python -m rl.plot --name gpu1       # -> out/gpu1/plots/
```

By hand, the same pieces:

```bash
python -m rl.hardware                  # says which path training will take, and why
python -m rl.mjx_check                 # the GPU path against the CPU one, ~40 min here
python -m rl.mjx_task --envs 4096      # GPU control-steps/s, before a long run
python -m rl.train_ppo --name climber --backend mjx
```

The rest of this section is the CPU path (`--backend cpu`, or no usable GPU).

- `--envs` defaults to the machine's usable cores via `sched_getaffinity`, which
  respects `taskset` and cgroup limits — so it does not oversubscribe a shared box
  or a container the way `os.cpu_count()` would. On a 64-core server try more than
  the default; envs idle during each policy update. Budget RAM at **~66 MB per env**
  (each holds all 9 scenes).
- **A checkpoint moves between machines and devices.** Verified cpu → mps → cpu with
  the timestep counter continuing; cuda uses the same torch `map_location` path. So
  you can start a run here, copy `out/<name>/` to the Linux box, and carry on with
  `--resume --device cuda`.
- **Do not assume `--device cuda` is faster.** The measurement above is Metal's, but
  the reason is not Metal-specific: a 135 → 64 → 64 → 17 MLP is small enough that
  kernel-launch overhead dominates, and MuJoCo stays on the CPU either way. CUDA has
  lower launch overhead than Metal so it may well come out ahead — this has not been
  measured on CUDA hardware. `python -m rl.bench` prints the CUDA device name and
  its updates/s next to the CPU's; decide from that, not from this paragraph.

## The GPU path: MJX

```bash
python -m rl.hardware                   # what this machine will train on, and why
python -m rl.train_ppo --name g1        # GPU if JAX can use one, else the CPU path
python -m rl.train_ppo --name g1 --backend mjx    # force it (runs, slowly, on a CPU)
python -m rl.mjx_task --envs 4096       # control-steps/s of one GPU batch
python -m rl.mjx_check                  # task, physics, policy: GPU path vs this one
python -m rl.mjx_check policy --run out/g1        # a GPU run's policy on all three robots
```

`rl.hardware` answers one question — is there an NVIDIA GPU that JAX can put an
array on, with `mujoco-mjx` installed — and `rl.train_ppo` takes the GPU path when
the answer is yes. On a machine with no NVIDIA card JAX is not even imported and
nothing about the CPU path changes. On Windows CUDA JAX only exists under WSL2, and
`rl.hardware` says so by name rather than "no GPU".

**What moves to the GPU is the simulator and the task, not the learner.** Every
earlier measurement here says the simulator is the bottleneck, so that is what
runs on the card: `rl.mjx_task`, 4096 envs (`MJX_ENVS`) in one jitted batch. The
learner stays SB3's PPO with the curriculum, the guard, the adaptive rate, the std
bounds and the checkpoints of the CPU path — the same code, fed by `MjxVecEnv`
instead of a `SubprocVecEnv`, with the policy on the card too because 4096-row
batches are what a GPU is for. Only the update's shape follows the batch
(`MJX_PPO`: 32 steps a rollout like rsl_rl's, then the CPU path's 10 epochs in 8
minibatches -- 80 Adam steps an update against its 60, at its learning rate and KL
target). A checkpoint
records its backend and resumes on the other one.

**The task is a port, checked line for line.** `rl.mjx_task` computes the same
145 observations (the anchor-rooted estimator with its gyro filter, SLAM-tracked
anchor and reach odometry; the nearest rungs), the same reward books, the same
success test and the same terminations as `climb_task`, reading every constant
from it. What had to change is structural:

- **Lessons are data.** A batch compiles one model, so the eighteen scene files
  become one robot with six rung slots and one extra wall slot, and each env
  writes its own lesson's rungs and wall into its copy of those geoms. The
  curriculum is unchanged in what it decides; it now moves the lesson draw weights
  of a jitted step, and a finished env resets inside that same step onto a lesson
  drawn from them — no recompile when a lesson unlocks.
- **A reset is a copy.** `ClimbTask.reset` hangs the robot from the keyframe and
  closes the fingers for 0.4 s, deterministically, so that runs once per lesson at
  start-up and a reset copies it (the noise is still drawn fresh).

**The robot is simplified, and the simplification is held to the full robot at the
same states** (`python -m rl.mjx_check model`: win17's gait on lessons 1, 1.85 and 2, and
the robot hanging over a row under its arms; `rl.mjx_scene`'s docstring has the
reasoning shape by shape). MJX's JAX backend has no box-cylinder or mesh-cylinder
collision and pays for every pair on every substep, so each kind of contact gets the
shape MJX computes exactly for it:

- **walls** are planes, and what meets them is the robot's own collision meshes and
  cylinders, as scene.xml draws them -- plane-mesh and plane-cylinder are exact;
- **rungs** are capsules whose straight part is the real rung, the caps past its ends,
  so every seat holds exactly as on the cylinder. The cost is at a rung's end: a hook
  hanging off it still finds the 15 mm cap, so a gap trains 30 mm narrower than it is
  (a hook on its rung in the simplified robot only: up to 6.5 % of lesson 1.85's
  states). The family ranges run past the benchmark's (gaps to 0.30 m against 0.25),
  and the score is taken on the full robot. Caps inside the length were worse: the
  last 15 mm of every rung could not hold a hook edge, and gap lessons land there;
- what meets a rung is **capsules and balls, never a box**: MJX's capsule-box test
  separates only on the box's face normals, so a 2.4 m rung passing a 12 mm plate at
  a slight angle "penetrates" it (on win17's gait: 50-75 mm contacts where C MuJoCo
  saw none, 5000-12000 N where C had 200, lesson 1 7/8 in C and 0/8 in MJX). Each
  hook plate is drawn in 0.25 mm rods lying in its broad faces -- a comb across the
  hook's width and one along each end: the box itself, to 0.25 mm, found by the rung
  where C finds the box, on the edges of the contact patch. The finger motor above
  the hook is a ring of 24 such rods tangent to it, each running where the hand is at
  the motor's radius and flush with the ends. The rung meets this motor on its free
  end's rim; one capsule round it, as it was, stood a whole radius (27.5 mm) past that
  rim and touched the rung in 0.4-4.5 % of lesson 1's states where the full robot was
  1-9 mm clear. The ring: 0.0 %;
- **the rest of the arm** is a capsule fitted to each link's motor and one to each of its
  bracket plates (`ARM`). Before them the arms went through rungs, which every climb
  up, down or over presses against the arms, and a check run on single-row lessons
  could not see it. Measured as the stand-in's surface against the real link's near a
  row under the arms (`rl.mjx_check model`, below): median within 4.4 mm for every link,
  p10..p90 within -8.3..+5.4 mm. A disc motor 98 mm across is what keeps it from 3 mm:
  a capsule, a ball and rings of rods on it were each measured, and this is the best
  of them;
- **one hand meets the other** with the hooks' own boxes and the three motors above
  each hook as the cylinders they are. MJX's cylinder-cylinder is an SDF descent, not
  exact (at win17's states it misses 27 % of C's hand-on-hand contacts, all shallow,
  1.3 mm off at p90); the exact alternatives cost more than they give -- a convex hull
  per link (full SAT) needs ~100 GB of scratch for 4096 envs, a 12-gon prism per motor
  5.3 GB and misses 45 % of the contacts on its flat facets.

Collisions are an explicit list of pairs with the friction and softness MuJoCo would
have mixed, so the grip pad still defines the hook's contact. Masses, joints,
actuators and the keyframe are untouched.

**The first version was a different robot, and every check the GPU path had then
passed it.** It drew walls and hands as boxes round the parts and each hook plate as
two 6 mm rods. `physics` compares MJX with C on the same simplified robot, so it
cannot see a simplification; 8 episodes a lesson could not either. Copying the full
robot's state into it along win17's gait could: its body box stood 9 mm proud of the
chamfered hull into the wall (touching in 63 % of the states at 200 N, the full robot
in 9 % at 36 N), its motor boxes met 9 mm deep when the hands came together, and its
hooks carried a third of the load, lost at the rounded plate edges and the rung ends.
From the same state, one control step took it 1.1e-2 rad and 8 mm from the full
robot, and win17 timed out on the wide gap the full robot crossed. Now:

| from the full robot's own states (win17's gait, seeded) | first version | now |
|---|---|---|
| one control step: joints p50, lessons 1 / 1.85 / 2 | 1.1e-2 / -- / ~1.2e-2 rad | 5.5e-4 / 8.9e-4 / 2.4e-3 rad |
| one control step: body p50 | 8.0 / -- / ~11 mm | 0.08 / 0.11 / 0.24 mm |
| a hook on its rung in one robot only | 34-41 % of states (lesson 1) | 0-1.5 % (lesson 1), 0.5-2.4 % (2), 6.5 % (1.85: a hook off a rung's end, on its cap) |
| body on the wall in one robot only (lesson 1) | 53 % | 0 % |
| finger motor on a rung in one robot only | 0.4-4.5 % simplified only (lesson 1, 5 seeds; the capsule) | 0.0 % simplified only; full only <= 3.2 % (shallow, its rim between two rods) |
| an arm link against a row 0.35 / 0.45 / 0.55 m under the hang (arms moving at random): the stand-in's surface vs the real link's, near the rung | arms went through rungs | median within 4.4 mm for every link, p10..p90 within -8.3..+5.4 mm |
| one control step from those states | -- | joints p50 0.9-1.4e-3 rad, body 0.10-0.18 mm (the gait's own: 0.7-1.9e-3, 0.08-0.23) |
| win17 on full robot, this one in C, this one in MJX: 8 episodes x 11 lessons | -- | 76, 73, 76 of 88 |
| the same, 24 episodes on lessons 1, 1.5, 1.7, 1.85, 2 | -- | 90, 94, 83 of 120; lesson 2 alone 10, 9, 3 of 24 (gaps: hooks land on rung ends, where MJX is weakest -- watch `sim2sim.txt` after a run; it is why step 3 of `gpu_run.sh` scores on the full robot) |

Counts of this size are noisy: the same policy and seeds on the full robot scored 97 and
then 90 of 120 across a change that touched nothing it met (a longer wall slab) -- the
contact dynamics are chaotic, so ~±7 in 120 is the floor a difference has to clear.

MJX against C on this same robot (`physics`), one control step from C's state along
the gait: joints p50 5.5e-6, p90 4.9e-4 rad. Where it parts most, both engines hold
the same contacts to 0.1 mm; the difference grows over the 20 substeps in
contact-rich states (float32 against C's float64 -- not the 6-iteration cap, which C
itself never exceeds on this gait: 2-3 iterations p50, 6 at most).

One difference is known and left as it is: a 49 N pull along the rung for 6 s
slides the full robot's hooks 20-24 mm and this one's 14-20 (more contacts in
parallel creep less). It errs toward the dragging the reward charges for, so a
policy learnt here does not lean on a slip the full robot would not give it.

The hook's rod radius was swept, 2 -> 1 -> 0.5 -> 0.25 mm with the rest fixed, and
every step moved it closer to the full robot (one step p50 2.5e-3 -> 6e-4 rad on
lesson 1).

The solver is most of an MJX step, so its two caps are measured, not guessed: **6
Newton iterations** (C uses 6-7 to its 1e-8 tolerance; capping the full robot itself
at 6 moves one control step by 3e-8 rad p50) and **24 contacts** handed to the solver
(C never had more than 17 live at once, over 17 400 control steps of every lesson;
the training log's checkpoint line prints how often all 24 are in use, which is
the sign the cap would be dropping real contacts).

**Cross-checked four ways** (`python -m rl.mjx_check`, ~40 min on this Mac; the
policy they replay is win17's best, frozen in `rl/fixtures/win17` so every machine
replays the same one):

| check | what it compares | result |
|---|---|---|
| `task` | ClimbTask on C MuJoCo, its state handed to the JAX task every step, float64 | 780 steps on lessons 1, 1.5, 7 incl. win17's gait: observations equal to 2e-15, reward to 4e-10, every book and termination the same |
| `physics` | the same simplified robot in C and in MJX, float32 | hang loads 136/136 N both; a 49 N pull slides the hook 13.9 / 14.0 mm; one control step from C's own state: joints 5e-6 rad off (p50), hook loads 0.07 N; at most 14 contacts live at once against the 24 kept; a NaN state or estimate ends as `blowup` at FAIL_R and resets |
| `model` | the simplified robot against the full one, at the full robot's own states | the table above |
| `policy` | win17's best, deterministic, on the full robot, the simplified one in C, and MJX | 75 / 76 / 77 of 88 episodes (below) |

| lesson (8 episodes each) | full robot, C | simplified, C | simplified, MJX |
|---|---|---|---|
| -2 one left-hand step | 7 | 7 | 8 |
| -1, 0, 1, 1.1 | 30 of 32 | 32 | 31 |
| 1.2, 1.35 one gap | 14 | 14 | 15 |
| 1.5 two gaps | 7 | 6 | 6 |
| 1.7, 1.85 wide gap | 16 | 15 | 15 |
| 2 two wide gaps | 1 | 2 | 2 |

Eight episodes a lesson is a coarse ruler -- the full robot's own column moves by
+-2 between runs, from the SLAM noise alone -- so it shows the same lessons easy
and the same ones hard on all three, not a ranking; the `model` check is the fine
one. After a GPU run, `rl.mjx_check policy --run out/<name>` asks the question the
other way round (`gpu_run.sh` does, into `sim2sim.txt`).

**The first GPU pilot (gpu1, 27.6M steps) found what none of these could: rung axes.**
MuJoCo points a `fromto` geom's axis from its second point to its first, so every
lesson rung read -y (-x) off its scene, while the generated walls training draws are
+y -- and the policy sees each nearest rung's axis and the distances to its two ends.
Its best policy, deterministic, on 24 family-1 walls drawn at its own ADR tops: 21 in
MJX, 21 on the simplified robot in C, 3 on the full robot; on family 2: 16, 16, 0.
With the axes the same (`rl.lessons.canon_axis`, everywhere a rung is read), the full
robot scored 21 and 13 -- the engine and the simplification were never the gap. The
benchmark could not show it: the pilot's ranges end short of every lesson, so all
three simulators failed them alike, except lesson 1 mirrored (20/20), whose `fromto`
runs the other way. `rl.climb_task` now checks that a scene written end for end
observes the same; checkpoints trained on the lesson scenes before this (win17, the
fixture) are replayed in their own convention (`rl.mjx_check._fromto_axes`), and
replay as before (76 / 73 / 74 of 88).

**gpu1 carried on to 102.9M steps (V100, 2026-09-26): families 1 and 2 learned, family
3 never started.** Mechanically clean -- 4,486 steps/s, approx_kl ~0.013, explained
variance 0.97, std 0.50, no rollback, no NaN. ADR took family 1 to its last range
(1.40 m) and family 2 to 2 gaps of 0.26 m; on the full robot, best checkpoint, 20
episodes each: lesson 1 19/20 and 20/20 mirrored, lesson 2 10/20 and 1/20, lesson 3
0/20 both ways. Family 3 sat at 0 % from its unlock at 12.8M to the end, every episode
a timeout, three quarters of all steps spent on it, its tops never moved: on its
easiest walls the policy never lifted a hook past 28 mm. Two causes: the live reach
was uphill for the first half of any reach for another rung (above), and the first
step was already 0.30 m -- family 2, whose gaps start at 4 cm, got through the same
hill as ADR widened them.

Before changing either, climbing up had to be shown possible at all: the classical
controller never managed it. It was searched for in C MuJoCo itself -- the
cross-entropy method over joint-setpoint keyframes moved at most `ACT_SCALE` a control
step (a policy's own 1.5 rad/s), in four phases (left hook over the upper rung while
the right holds, seat it, right hook over, seat it), each ending in a hold -- and
replayed as actions through `ClimbTask.step`, which scored it: success on one row of
0.30 m at 13.7 s and of 0.45 m at 13.3 s, and on 0.10 and 0.15 m. It swings one arm
over and pulls up on the other, braces a forearm and a wrist on the lower rung and an
arm on the wall (up to ~500 N, at most 9 mm of soft-contact depth), and holds elbow
and shoulders at their 120 N.m peak 2-9 % of the time and over the motors' rating
10-23 % -- the simulator's limits, not a real motor's continuous ones. A narrow
motion: 0.45 m was found in one search of three. Its scripts and the two chains are in
`out/climb_demo/` (not in git). So family 3 now starts at 0.10 m, which a row straight
above clears in the start hang (from 0.07 m), and the live reach goes along the routes
through the rungs (below).

**Every reward term was then audited on motions known to be right (2026-09-26).**
Five motions found by that search -- one-row climbs of 0.10, 0.15, 0.30 and 0.45 m,
and on lesson 9 a one-hand swing that pumps for 6.6 s and reaches 1.08 m -- replayed
through `ClimbTask.step` with each term summed on its own (`out/climb_demo/ledger.py`),
and the live reach walked along every lesson's shortest route (the barrier test).
Six terms charged doing it right, each fixed in the reward table below: the live
reach (hills of 0.06-0.37 m on lessons 3-7), `K_SEP` (hands on two rows), `K_FIGHT`
(a swing's centripetal load), `K_STALE` (a hand that cannot let go), `K_SLIDE`
(jitter) and the dangle grace (a swing). Returns, before -> after: climbs 0.10 m
+5.46 -> +8.52, 0.15 +8.56 -> +11.09, 0.30 +8.67 -> +11.88, 0.45 +7.11 -> +11.95;
the swing -4.63 -> -1.01 (separation -1.56 -> 0, dangle -0.85 -> -0.10, fight
-0.38 -> -0.03, stale -0.10 -> 0, slide -1.41 -> -0.89). What is left is meant:
effort 1.3-2.2 a climb (torque above a still hang, the energy term), time 1.0, the
net slide 0.2-1.5, `K_ACT` and `K_VEL` ~0.1 each. The no-pump, jump/drag and
incentive tests pass unchanged (an idle episode -7.58 against -10 for a fall), and
`rl.mjx_check task` matches C to 4e-10.

**...but a fall was not -10 (found 2026-10-04, the first run on that reward).** The
live term kept charging while the robot fell: in the 0.6 s until `released` both hands
drop under every rung and out of every hop's reach, and `AIR` and `K_OVER` bill that
at up to 3.5 m of route a metre fallen. Letting go from the hang cost -33.5 to -35.1
on lessons 1, 3, 5 and 9, -20.7 to -22.4 of it the live term. Against -7.4 for hanging
to the timeout and +11 for a success, an attempt then had to succeed 2 times in 3 to
be worth making, and the policy stopped making them: a 1.5M CPU canary of the noisy,
lidar-mapped task passed lesson -2 at 200k and then sat at 0 % from 700k on, every
episode a timeout, the left hand re-gripping where it stood. A fall now gets back the
live term charged since a hook last touched a rung (`live_att`, C and MJX), so it
costs `FAIL_R` and what came before the hooks left: -12.7 (the 0.6 s of `K_FLIGHT`
and time). Refunded both ways, so a jump that ends in a fall keeps nothing it gained
in the air either. The same canary, seed and command with it: lessons -2 and -1 both
at 72 % and lesson 0 unlocked by 400k, and at 1.5M the pool ran to lesson 1.1 (-2
85 %, -1 48 %, 0 88 %, 1 72 %) where the unfixed run had -2 at 2 % and -1 at 90 % and
had unlocked nothing past -1. One seed an arm; the fall test in `rl.climb_task` holds
the number.

**Why gpu2 never climbed up (2026-10-06).** gpu2 (145M steps, RTX 3090) learnt
families 1, 2, 4 and 7 and sat at 0 % on family 3 -- one row 0.10 m up, its easiest
wall -- from its unlock at ~13M to the end, every episode a 60 s timeout. Replayed
(full robot in C, and MJX on 8 generated walls at the run's tops) it flutters: the
hands alternate ~3 times a second, each throat lifted 60-70 mm, the hook butting the
upper row from below and dropping back -- ~100 holds per hand per episode, the goal
row never reached -- and the bank paid **+2.0..2.8 m (+10..+14) an episode that
closed nothing**. Of the credit, the hands' own approach was +0.14 m and the partner term +2.45 m, 2.0 m of
it vertical: the holding hook's throat sags 10-20 mm off its rung when it takes the
other hand's share and comes back when that hand holds again -- down while the free
hand was free (subtracted, so credited), up once it held (not counted). With the
goal a row above, down is away from it. On level goals (families 1, 2, 4, 7) the
sag is across the goal direction and the bank came out the same within 1 %. The
partner's motion is now its **slide** -- along its rung, what `K_SLIDE` charges --
and turned into this hand's bank potential from its rung point, as `_hand_dists`
measures it. The same trajectory banks -0.11 and +0.006 m; the CEM climbs of 0.10,
0.15 and 0.30 m still pay +8.07, +10.94, +11.28. The jump/drag test has the sag (old
rule: +45 mm over three cycles); `rl.mjx_check task` matches C to 4.8e-10.

**...and why it could not have climbed cleanly anyway (2026-10-06).** Stacked straight,
a row under the one the robot hangs from is in its arms or body: the arms hang 59-107
mm off the rung plane, so hanging one row up, a row 0.10-0.15 m below is 15-23 mm
inside the wrists, 0.20-0.50 m is 6-25 mm off the forearms and upper arms, and
0.60-1.00 m is inside the base. Every CEM climb up one stacked row (0.10-0.45 m)
pressed an arm on the row below at 100-415 N, the wrist into the row above at up to
1277 N at 0.10; at the goals of benchmark lessons 3 and 6 the base sat 34 and 38 mm
inside the start rung (hanging there 3 s, the robot fell off); lesson 5's top row ran
over both its other rungs. As the user put it: climbing up, the row above should be
parallel and straight above but stand out in front, not in the same plane. Family 3
and lesson 3 now stand each row `walls.OUT` = 0.20 m further out from the wall than the
one below (first row 0.20 m up, the user's call): after 3 s hanging from the top row
the rows below are 92-164 mm clear over the whole range, 109 mm on lesson 3 (5 mm at
0.15 out, and at 0.05-0.10 the base swings onto the lowest of two rows). Reaching out
costs height -- the free hook rises 0.56 m in the rung plane, 0.52 m 0.15-0.25 m out
(`urdf/_reach.py`'s hang) -- so the rows are at most 0.45 m apart and lesson 3's are
0.40 (the user's call): CEM climbs 0.20 m up and 0.20 out (`ClimbTask` success, +11.88,
nothing but the hooks and the wrists on their own rungs touching) and 0.40 up and 0.20
out (+12.18, the same: 2 of 5 searches got there, the other one flipping the robot
upside down onto the start row), and found no way onto a row 0.45 up and 0.20 out in 3. Lessons 5 and 6, the diagonal
climbs, start each row or tier past the end of the one below; lesson 5's top row spans
the break alone. CEM climbs diagonal steps of 0.20 m (+11.44) and 0.45 m (+12.64, 2
of 2 seeds onto the row; a forearm brushes the row below for 0.14 s). With the secured hang placed at the goals and along every
intermediate rung, every family 3-6 wall at its first and last tops and lessons 3-6 are
25 mm clear or more everywhere; `walls.Checker` rejects
a wall whose goal hang is within 2 cm of any other rung.

**...and why it still did not climb: nothing ever found the first reach (2026-10-06).**
gpu2 resumed on those walls to 179M steps: family 3 at 0 % over 7792 episodes and 39 %
of the steps, every one a timeout -- no rollback, std rising 0.53 -> 0.60, EV 0.95. On
family 3's training walls in MJX, 32 episodes each, gpu2's own noise, a fresh SB3 policy
(std 1, mean ~0) and uniform random actions all touched the row above in 0 of 32, no
throat ever within 191 mm of a goal 283 mm off; the fresh one also fell off in all 32.
So not the resumed policy: from scratch it is the same, after relearning to hang. The
rest was checked and is right: the row is in the lidar map from the first step, MJX
matches C along a climb onto it (3.6e-15), the simplified robot MJX trains can climb it
(CEM: 0.20, 0.25 and 0.30 m up, 0.20 out), and the reward pays the climb (+11.9).
Started partway up that climb (`rl.rsi`), gpu2 already finishes it: 0/26 from the first
5 s, 23/23 once the first hand is on the row above, 19/21 later. The one move it lacks
is the first hand's reach. So a quarter of family 3's walls (`rsi.SHARE`) now start at
one of 217 states along those three climbs -- the joints, speeds, setpoints and the
holds already taken -- and those episodes are booked as family 103: never family 3's
gate or ADR, which stay what the policy does from the hang (`rl.status` prints the book).
In MJX the rest of the climb, replayed open loop from such a start, succeeds from 5 of 6.

**...and why the starts did not teach the reach: they were on a swing (2026-10-06).**
gpu3 trained fresh with those starts to 60M steps on an RTX 3090: families 1 and 2 at 86 %,
family 3 from the hang 0 %, its starts partway up flat at 60-70 % from 21M on -- 40M steps
in which the earliest start it could finish from never moved back. In MJX, every 0.20 m
start: 38/40 once the left hook is on the row above, 24/40 while it comes down onto it
(4-6 s in), 0/80 before that, and 0/48 from the hang, where the hook never rose past 36
mm and each hand let go and re-took the start rung ~200 times an episode, deterministic
too. Every one of the three climbs began with the free arm swung across the body (the
0.20 m one's throat to y -0.56, z 0.92 -- below the rung it left; the 0.25 m one's to z
-0.05) up a hill of live potential: +0.54, +2.44 and +0.40 m, K_REACH x that before it
paid. 1, 2 and 4 s in, the climb had earned -0.79, -1.25 and -1.15; letting go and
re-taking the start rung +1.83, +1.64 and +1.28 -- K_GRAB, paid for any first hold -- and
from a start on the swing, going back also banked +1.4, the swing being further from the
goal than the hang. Only the grab of the row above (5.8 s) turned it round, and no try
from before 4.5 s ever got there. The objective was right (the climb +10.77, hanging
-7.49); the way into it was uphill. Two changes: K_GRAB only for a hold that banks
`GRAB_MIN` (30 mm; the re-grips banked at most 16 mm, lessons 1/2's steps a median
54-98), and the climbs searched again with `plan_chain.py HILL=2` -- the rise of the live
potential above its running minimum priced into CEM's objective -- with `rsi.HILL_MAX`
(50 mm) asserted on each found motion when the fixture is built. The new climbs: 6, 9
and 9 mm of hill (the old 767, 2728 and 637 over a whole climb); the 0.20 m one holds
the start rung 4 s while the body shifts, then reaches in 1.5 s, and earns -0.16, -0.39
and -0.89 at 1, 2 and 4 s -- effort and slide, the cost of moving, against hanging still;
return +9.78, discounted from the hang +1.63 (was +1.35). 201 starts; replayed open loop
in MJX, 7 of 7 sampled succeed.

**...and why that did not either: the frontier start was never drawn (2026-10-07).**
gpu4 trained fresh on those climbs to 64M steps (RTX 3090): families 1 and 2 at 85-90 %,
family 3 from the hang 0 % (unlocked at 13M, family 4 let in past it at 63M), the starts
partway up 55-73 % from 17M on. In MJX, every 0.20 m start, stochastic and deterministic:
0/16 from each start up to 4.8 s, 16/16 from 5.0 s on -- 41 of 66 starts, the 62 % the run
logged -- and the same at the 50M snapshot. At 5.0 s the left hook is already over the row
above; at 4.8 s it is 30 mm under it and rising, and the climb lifts it over (-30 -> +34 mm
in 5 steps) and drops it on, where the policy pulls it straight at the seat, into the
rung's underside (189 N on the first step), drags the hand back to the start rung and
flutters. Not out of reach: three control steps of the climb from 4.8 s and the policy
finishes 8/8 (two 2/8, one 0/8); the climb from there with the policy's noise (0.59) on
every joint 4/8. The objective is right (the critic: -2 until 0.2 s after the release,
+1.6 -> +10.7 once over the rung). The starts were drawn evenly and only for a quarter of
family 3's walls: 8427 episodes in 64M steps, ~128 a start, ~2 per 1M steps, none of them
a success at the frontier -- while family 3 from the hang took 44 % of all steps for
nothing. Now (`rl.rsi`): Walls books each start's episodes (`start` in the info: the
wall's d0_row) in start order, as every book here -- counted as they end, a start's quick
successes would pass it before its failures were in -- behind a lag of TIMEOUT, the 30 s
an episode from a start now may run (twice the longest rest of a climb), not the
families' 60 s; `rsi.frontier` is the latest start along each climb not passed (70 % of
its last 20, 10 at least); FOCUS (3/4) of the starts drawn are that one and the two
before it, and any start booked fewer than 10 times, the rest evenly; and the starts take SHARE_HI (3/4) of family 3's walls until
family 3 passes its gate, SHARE after. The checkpoint line and `rl.status` print the frontier
in seconds along each climb: that, not the starts' rate, is what to watch. (Unbooked
starts drawn first, 2026-10-09: drawn as passed ones, the cold books of gpu4's resume would
have walked the frontier down from 13 s through 41 starts the policy already finishes
from, one 30 s lag per three: 13-25M steps simulated to reach 4.8 s, 6-9M now. And a start
is now its five control steps, every one a row of the fixture, its episodes begun from any:
gpu4's policy from 4.80, 4.84, 4.88, 4.92, 4.96 and 5.00 s finished 0, 0, 9, 23, 21 and 23
of 24 -- the start at 4.8 s was 0/192 from its first step alone, the one at 5.0 s all, and
nothing between was ever drawn; over its five steps it is ~44 %, a step at a time to learn.)

**gpu5's frontier was moved by the estimator, not the policy (2026-10-09).** gpu5 (0ebf33d,
Warp, 42.9M steps in 49 min) passed the 0.20 m climb's start at 4.8 s by 21M and then sat at
4.6 s for 21M steps; per control step its policy finished 0/16 up to 4.76 s and 11/16 at
4.80. The two rows' bodies are 19 mm apart, but what the policy SEES of the free hook was
not: an rsi start began the attitude filter as a hang does, from one accelerometer and
magnetometer reading, and mid-swing the accelerometer reads the swing too -- 16-37 deg off
vertical around the catch, the free hook seen 0.1-0.3 m from where it is, a different way
at each row (at 4.68-4.76 s already on the upper rung, at 4.80 s 0.2 m under it). Along the
climb from the hang the filter has settled by then: 2-3 deg, the hook 28-44 mm off. From
4.80 s the same policy finished 11/16 from the rsi start, 0/12 after the climb itself from
the hang and 0/12 from the start with the true attitude; its real edge is 4.88 s, gpu4's.
An rsi start now begins the filter at the torso's attitude (`MjxClimb.start`; the hangs
keep ClimbTask's), and `rl.mjx_check task` fails any start that sees a hook 0.1 m off (317 mm
before, 72 now). The measurements: out/gpu5_diag.

**gpu6: the catch is out of the noise's reach, so the reference is cloned there
(2026-10-10).** gpu6 (2a4b5ba, Warp, 61.2M steps) reached the start at 4.8 s by 19M and
held there 42M steps; per control step its policy finished 0/64 from 4.76, 4.80 and 4.84 s
and 12/12 from 4.88 on -- gpu4's and gpu5's real edge, now with nothing in the way of
seeing it. At 4.84 s the left throat is 29 mm under the upper rung and 51 mm in front of it
(the side away from the wall: the row stands 0.20 m out); the climb keeps lifting it there,
to 13 mm over the rung, before bringing it in over the top and down onto it, and the policy
drives it straight in at once, into the underside (47 N), drops away and goes back to the
start rung -- from 4.88 s, 14 mm higher, the same move rides up over the rung. The reward is not what
stops it: the climb's step is paid +0.03..+0.06 a step against ~0, and the critic knows it
(V +8.5 one step on against +0.6; +1.9 at 4.84 s, +11 at 4.88). Exploration is: the
policy's mean is 7-8 sigma (17 joints) from the climb's action at every one of those rows,
and the catch from 4.84 s takes one step of all of that (8/8), or two to three of half
(5/8, 8/8), never one of half (0/8); from 4.80 s two whole steps. A Gaussian's noise does
not find that in any number of steps, and with no success PPO has nothing to follow. Cloned
offline at rows 60-121 (out/gpu6_diag/bc_probe.py), the same policy finished 4.72-4.84 s
3-6/12 with its own noise and families 1 and 2 29/32 and 24/32 (32/32, 26/32 before). So
(`train_ppo.Clone`, DAPG's demonstration term with the Q-filter's "only where it is
better"): while family 3 is in the pool and has not passed, every PPO step also pulls the
policy's mean toward the climb's action (`rsi.actions`) at the rows of every start the
books have not passed (`rsi.unpassed`), observed as an episode from that row observes it,
at CLONE_RATIO of PPO's own gradient norm. Resumed on gpu6 (64 envs, CPU) it took the mean
from 10.7 sigma off over those 125 rows to 1.3 in three updates; the rollout table shows
it as clone/rows, clone/off_sigma, clone/scale. The measurements: out/gpu6_diag.

**gpu7: one row learnt, two stopped by the row below in view (2026-10-10).** gpu7 (ce8db5d,
fresh, Warp, 17-19k fps) cloned the 0.20 m climb from 12.9M, passed family 3's gate at 26M --
the first run to climb from the hang -- and family 4's by 162M. Then family 3 sat at ~50 % to
173M: ADR had moved it to two rows and 0.25 m at once (28M), and per wall it climbed one row
24/24 and 23/24, two rows 0/24 at either spacing, every time both hooks on the middle row to the
timeout, letting go and re-taking it in place, never touching the row above (0/12). Not the
reward (the start row never lowers the route cost), not the estimator (the middle row read as
the held one 88 % of hand-steps, 47 mm median), not the physics: from a clean hang on the
middle row, 0/16 as it is, 8-11/16 with the start row taken out of the near-rung OBSERVATION
only (still there to touch), and on a single rung that far from the wall 10/16, 0/16 with a
start row added to the observation only. Moving it from the second near slot to the third
(rungs ordered toward the goal) did not help (0/16): the policy never climbed with a rung below
it in view -- from the hang there is none -- so it did not, and with no success there, 145M
steps taught it nothing. Taking such rows out of the observation (rungs further from the goal
than the held one) was no fix: two rows 7/16 at 0.20, but family 4 16/16 -> 10/16.
So the second row is taught as the first was, by climbs to clone (`rsi.TAUGHT`, `rsi.teach`):
the policy's own 2-row climbs from the hang, recorded with the rows below both its hands out of
its view (0.20 m 26/64 of the attempts, 0.25 m 2/64; the fastest kept, 5.8 s and 7.7 s), become
climbs of the fixture after the found ones (whose 999 rows and starts are unchanged, so a run's
books carry over). Starts, books and frontiers are per climb (`climb`, `label`: '0.2 m x2'), a
start is drawn on a family-3 wall of its climb's rows and spacing once the tops let both in,
Clone clones past the gate wherever a start is not passed, and the starts keep SHARE_HI until
every start the tops let in has passed. A row is a start's only if an episode begun there sees
each hook within SEEN (0.08 m; `startable`): the taught climbs are fast, and where one hook
reaches with the other off its seat, or neither bears load, a start knows nothing a climb
carries -- 130-234 mm off on 14 of their 288 rows, gpu5's mistake had they stayed. Cloned
offline into gpu7's policy (out/gpu7_diag/bc_probe2c, the teacher's mean as target -- its
sampled steps, cloned, took family 1 from 13/16 to 5/16): every 0.2 m x2 start finished 1-4/6
(0/6 before), the climb's own hang 2/6, two rows from the hang 5/16 (0/16); 0.25 m x2 its last
start 5/6 (3/6). Resumed on gpu7 (64 envs, CPU) the run clones those 274 rows past the gate,
8.3 -> 5.3 sigma in two updates. The measurements: out/gpu7_diag.

**ADR could not take a count back from its last top (2026-10-10).** A parameter at its last top
was never probed again (`rl.walls.draw` probed only those below theirs), so it could never step
back: gpu7's family 3 sat at two rows, its last, climbing them 0/24 for 145M steps; only its
spacing was probed, on walls of one row or two (~50 %, inside the dead band), so family 3 held
at 50 % and the gate kept families 5-9 locked the whole time. Now every parameter is probed at
its top, its last too; a move clears the family's other probes, so a family moves one
parameter a window (28M had moved rows and spacing in one); and family 3's climbs over more
rows are offered by spacing alone (`rsi.allowed`), so the policy meets ADR's next row ready
and a step back does not take its references away. Counts with a last top this low: family 2's
gaps (2), 3's rows (2), 6's tiers (2).

**Every family against the failures so far (audit, 2026-10-10, out/audit).** Reward hills and
pumps (gpu1-gpu3): the barrier test walks all nine benchmark lessons' routes with both hands
(worst 0.0 mm) and the no-pump test balances the books -- both pass. An exploration gap a
reference has to bridge (gpu4, gpu6): family 3's are cloned; families 5-9 have none and have
never trained (gpu2's family 8: 0 % at 16M), so a stall there is expected to need one -- a family
stuck STUCK_STEPS no longer holds the rest back, and a count ADR cannot hold steps back now. An
estimator a start begins wrong (gpu5): every rsi row is checked at build (`startable`) and in the
preflight (mjx_check task). The row below in view (gpu7): along each family's route at its last
tops, a rung leading away from the goal within 5 cm of the next hold's distance -- family 3 16 of
56 holds, family 6 7 of 69 (its tiers), every other family 0; family 4 measured on two steps
(gpu7 at 173M: 9-10/16, 6-7/16 with those rungs out of view) does not have it. Family 6 is the
next to need taught climbs, once it climbs one tier. A shared GPU (gpu6, 9k env-steps/s for
14.3k): gpu_run.sh now says so at the start (memory in use, load).

**gpu8: the step up in the wall's own plane was never taught (2026-10-11).** gpu8 (eb25530,
fresh) passed families 1-4 by 69M -- family 3 at two rows of 0.35 m, 21/24 -- and then sat at
0 % on family 5 for 50M steps and on 6 for 43M (162M, every checkpoint 0/200). The same in
both, measured at 120M and 162M (out/gpu8_diag): the policy goes to the start row's end and
hangs there to the timeout, its hook never more than 2-11 cm up (family 5's row 35-50 cm up,
6's tier 30 cm), no hand ever on the rung above in 112 episodes. Not the reward: lifting there
is downhill all the way (0.0 mm of hill, 12 walls) and the bank pays the grab. Not the map:
the lidar has every rung from the first step. Family 3's rows stand OUT 0.20 m from the wall,
so the one climb it taught is not this one: up and diagonally on, in the wall's plane, past the
end of the rung below -- 6's tier, and the step up over 5's break. Family 3 in gpu1-gpu6 again,
so the same fix: CEM found the climb on family 6's first wall (`rsi.wall6`, one tier 0.30 m up;
out/climb_demo/plan_chain.py PLAN=f6, HILL=2), 12 phases, 40 s, a hill of 10 mm. It fits only
its own wall, so its starts run on that wall, mirrored for the climb found the other way
(PLAN=f6m, `climb_side`); 0.40 m warm-started from them (f6r40, f6mr40). Replayed open loop in
MJX each of the four finishes from every start tested (26-27 a climb, the hang included) --
the mirrored two only after their last two phases were searched again (f6mr30end, f6mr40end):
the right hook had come down on its seat's edge (0.040 against 0.002), and MJX finished 9/27
and 6/27 of their starts. Booked as family 6 + 100, cloned where not passed (`rsi.STEPS6`). And 5 now needs 6 (`walls.NEEDS`): families enter 1, 2, 3, 4, 6,
5, 7, 8, 9. A family stuck with nothing to learn it from draws MIN_SHARE of the steps
(`Walls.capped`): at 0 % it had drawn need 1.0, the most of anything -- 5 took ~56 % of
gpu8's steps for 50M of them, and family 1 fell from 96 % to 73 %.

Building the family-6 starts showed an rsi start's map was its first frame's alone: with both
hooks at the start row's end behind the arms, the lidar had not that end in view, and the hooks
were seen 0.35-0.60 m along the rung, clipped to the span it had (97 of 887 rows past
`rsi.SEEN`). An rsi start now has the rungs its hooks are on end to end (`MjxClimb.start`):
family 6 at most 72 mm off, none past SEEN; family 3's two-row climbs 5 -> 0 and 9 -> 6 rows.
`rsi.build_fixture` writes the fixture before measuring it: `_seen`'s batch begins from the file.

**gpu9 stalled on a compile (2026-10-12).** gpu9 (97cdaf4) sat at 0 % GPU from 12.98M steps, family
3 entering and the step recompiling for 3 rung slots: XLA's "Very slow compile" on a reduce fusion,
18+ min and counting (gpu8: 131 s for the same recompile). Its preflight had shown it already --
one kernel 16m23s while the short training run built its env -- and passed. The first fix above had
put a second `lidar.visible`, from the hang, into every reset, and so into every step: a second copy
of the step's largest reduction (4 lidars x 6 rungs x 32 cells x 64 occluders x 3 x 3 a env, ~1.8e9
elements at 4096 envs; 234 -> 268 reduces in the step's HLO). An rsi start now marks the rungs its
hooks are on as seen end to end instead -- the same estimates on every fixture row (family 6 at most
78 mm, none past SEEN), the step back to 235 reduces -- and gpu_run.sh says so when the preflight
logs a very slow compile. Packages were the same; the box (driver 610.57) was new.

**gpu9 at 122M: family 4 capped, family 6's last catch outside its rows (2026-10-12).**
gpu9 (b7bf78f) ran 122M steps in 2.2 h. It had no rollbacks and no slow compile; families
1-3 sat at 78-94 %.

*Family 4.* Its first climb down is found by exploration, and when varies a lot. The steps
from entry to the first 10 % were 26M in gpu7, 40M in gpu8 and 69M in gpu9. gpu9's had not
come by STUCK_STEPS: family 4 was stalled at 77.8M at 0.5 %, and family 6 entered, as
designed. But the stalled cap (gpu8's fix above) then cut family 4 from 74 % of the steps
to 8 %. It found its climb at ~93M anyway and sat at ~40 % from 103M on. A stalled family
is now capped only under WARM_RATE: past it, it has its own successes to learn from.

*Family 6.* It learns its references from their ends back.
- From 100M to 122M, -y's last 2.8 s went from 4-34 % to 96-98 %. A probe from 33-35 s
  (out/gpu9_diag/f6_starts.py) finished 9/9 with the mean and 8/9 sampled.
- +y stayed at 45 % on its last start, and the mean finished 0/9 from 33-35 s. It reached
  t1b on time, slipped off and went back to t1a.
- The +y climb's last hand crosses the gap in its last 1.1 s: in the air 0.42 m from its
  goal at the last row, and onto t1b ~0.6 s after it. With the rows ending MARGIN (1 s)
  before success, that catch was no start and was never cloned.
- -y's crossing, searched again (f6mr30end), falls inside its rows.

Family 6's rows now end MARGIN6 (0.2 s) before success: 4 more starts a climb, the catch and
the seat in them. Every new row is startable but one (0.40 m, 81 mm), and the reference
finishes open loop in MJX from all 32 of the last 8 starts.

**gpu12 at 315M: the noise the policy no longer needed spoiled every catch (2026-10-19).**
gpu12 (the clean rebuild's numbering, an RTX 3090 at 16k steps/s) passed lessons 1-5 and 7 by
160M, with no rollback and no error. Lessons 6, 8 and 9 then sat at 0 % from the hang. Between
them they took ~70 % of the steps. The passed lessons sagged: 3 to 72 %, 7 to 66 %, and 4 fell
to 5 % at 284M and came back.

*The std.* From 200M the wrists and elbows drifted up to the 1.0 ceiling (wrist_R 0.69 -> 1.00,
elbow_R 0.83 -> 1.00) while both shoulders sat at the 0.05 floor.

*Lesson 8.* Its frontier sat at 3.0-3.8 s for 90M steps, just before the reference opens the
left finger (2.0-2.6 s) and puts that hook on the back rung (4.0-4.8 s). With the mean action
(MJX, out of the 315M checkpoint), every start from 2.6 s on finished, 40/40, and every start
from 2.0 s back hung to the timeout, 0/24. So the policy never starts the release itself. It
finishes once the release has begun, but sampled at its own std only 15/40 times, so those
starts never reached the books' 70 % and the clone window never reached the release.
Capped, the same starts finished 25/40 under 0.5 and 35/40 under 0.3. From the hang
(28 walls in C) it never let go of the left hand. It waved the right one back instead, the
hand the reference does not teach, 5-7 cm under the back rung, and touched it 10-46 times
without seating the hook.

*Lessons 6 and 9.* Each is stuck at its second hand's move: lesson 6's right hand stepping
up the tier at 27.6-29.2 s (frontier 24-28 s), lesson 9's crossing at 35.6 s (frontier 30-32 s).
There the mean fails as often as the sampled policy. Lesson 6 -y fell from its 24 s start
5/5, mean included, a start it had held above half at 240-265M, when its frontier reached 23.6 s.
From the hang, lesson 6's lead hand slid along its row and never rose more than 9 cm, and
lesson 9's never reached past 0.68 m.

*The cap.* Under 0.3 the passed lessons also did better from the hang (35 walls each, in C):
lesson 3 23 -> 29, lesson 4 22 -> 31, lesson 5 27 -> 30, lesson 7 30 -> 31. The std is now held
in [0.05, 0.3] (`STD_MAX`), and gpu12 resumes on it. No fixture changed, so every climb's
books carry over.

**gpu12 at 537M: why gpu11 climbed lessons 6 and 8 and gpu12 did not (2026-10-20).** The two
runs use the same robot, the same PPO settings and the same reference climbs. gpu11's
checkpoints still climb both on gpu12's walls: lesson 6 20/21 and lesson 8 19-20/21 from the
hang, in C. So the walls are not the difference; how each run learned is.

*Where all three stick.* At 537M, the starts of each climb pass after its crux and fail
before it. Lesson 8 passes from 1.4 s; before that is the hang itself, where the reference
waits and moves its shoulders. Lesson 6 passes from ~15 s; the crux is the lead hand's
step-up, 0.2 m out from the wall and 0.34 m up in 0.8 s. Lesson 9 passes from 16-25 s; the
crux is the lead hand's 0.63 m sweep across the gap in 0.8 s.

From the starts before each crux, the mean frees the lead hand and carries it short of the
hold, then hangs on the other hand to the 50 s timeout:
- lesson 6 slides along the row, never more than 6 cm up;
- lesson 9 stops over the gap, 0.45 m short;
- lesson 8, from the hang, reaches back at once and stops 4-5 cm short.

*Noise.* Between 200M and 368M the elbows and wrists drifted to the 1.0 ceiling. gpu11's
stayed at 0.4-0.6. Every catch failed under that noise, so the frontiers sat at their
catches for 90-150M steps. gpu12 also had three families stuck at once (lessons 6, 8, 9 at
~25 % of the steps each). gpu11 had one, at 60-90 %. The 0.3 ceiling (above) removed the
noise.

*The lock.* By then the shoulders had sat at the 0.05 floor since 200M. Every crux is a
shoulder move, and moving the mean 0.5 there is 10 sigma, which no update's KL allows.
Measured on the 537M checkpoint (64 envs on the Mac, a pull of 1x PPO's gradient toward
gpu11's actions at the states gpu12 reaches):
- at a floor of 0.05, the mean stayed 30 sigma off for 20 updates;
- undamped, the pull took approx_kl to 12-60, against 1.2 -> 0.15 without it;
- at a floor of 0.1, the mean came 18 -> 13 sigma in 30 updates, with approx_kl at 0.1-0.16.

Families 1-5 and 7 from the hang did not mind the noisier shoulders (C, 35 walls each):
30/33/30/30/30/20 at 0.05, 28/32/32/31/31/24 at 0.1. The floor is now 0.1 (`STD_MIN`).

*Not done.* Offline DAgger from gpu11 taught gpu12 lesson 8 from the hang (0 -> 29/35), but
only on one checkpoint. Inside training it cannot share a family with the reference's
cloning: gpu11's motion is not the reference's, and the teacher pulled the mean away from
the reference at lesson 8's 0.4-1.2 s rows (0.27 -> 0.65-0.94). The fix stays in the update
size, where the lock was.

**The curriculum for a fresh run, from gpu12's 537M books (2026-10-20).** Three rules shaped
gpu12's late run, and none of them came from gpu11:

1. *Stuck by the calendar.* A family that had not passed 50M steps after it entered let the
   next one in, even while it was still learning. So lessons 7, 8 and 9 entered while 6 was
   at 0 % and progressing, and from 204M lessons 6, 8 and 9 shared ~70 % of the steps at
   ~25 % each. When gpu11 learnt 6 and then 8, each was the one stuck family, at 60-90 %.
   A family not yet passed now counts as stuck only after 50M steps without progress. Its
   rate from the hang must rise 0.05 over its best, or the share of its reference starts it
   finishes must rise 0.02 (`Curriculum.track`).
2. *A quarter of the slow families from the hang.* The rebuild gave every family 0.75 of its
   walls at reference starts until its gate. gpu11 ran 0.95 for the families whose hang idles
   out its 60 s: at 0.75, 63 % of gpu10's family-6 steps were hang timeouts. gpu12's family 8
   spent over half its steps idling out from the hang (75 hangs a 1M steps, ~1500 steps
   each). That is where its mean learnt the reach that stops short. Lessons 6, 8 and 9 are
   back at 0.95 (`rsi.SLOW`, `rsi.SHARE_SLOW`).
3. *ADR starved.* A family's share of the steps was its failure under its levels only, so a
   passed family drew ~4 % however its candidates did. Nothing rose from 264M to 537M, with
   the candidates at:
   - family 2: gaps 0.20 m, 36 %;
   - family 3: two rows, 11 %;
   - family 4: two rows, 31 %;
   - family 5: a second step, 25 %.

   Lessons 2-5 of the benchmark sit past them. A family's failure now counts the walls it is
   actually drawn, PROBE_P of them at its candidates (`Curriculum.fails`). On gpu12's books
   that takes families 2-5 from 3-6 % to 4-8 % of the steps.

The 0.3 ceiling had been held from the first rollout, so a fresh run would have explored
lessons 1-2 at a third of the noise gpu11 and gpu12 learnt them with (~0.8). The 0.3 was
measured only late, against the drift. The ceiling is now a ratchet: each dimension's std
never rises back over the lowest it has been, and never sits under 0.3 for that reason. It
starts at SB3's 1 and falls as freely as in gpu11. (A learning-speed test could not be run
here: MJX on this Mac's CPU runs 30 steps/s.)

**gpu13 at 223M (2026-10-20): the stuck rule missed slow progress.** Lessons 1-5 and 7 passed,
no rollback, std 0.24. Lesson 6 entered at 110.6M and its +y frontier crept 36 -> 29 s by
160.6M (rate from the hang 0 -> 0.5 %), yet it was taken for stuck exactly 50M steps after it
entered and let lessons 7 and 8 in. `track` compared each reading with the best so far and
then raised the best to it, so a family gaining less than the margin between two rollouts
never progressed. The mark is now the best as it was at the last progress. Since then
lesson 6 went 0.5 -> 37 % from the hang (frontier 9 s +y, 16 s -y), and lesson 8 is 0 %
from the hang but its frontier went 16 -> 4.6 s in 50M (gpu12: stuck at 3-3.8 s), books 69 %.
Without the fix lesson 8 would also have counted as stuck at ~266M and let lesson 9 in.

**gpu13 at 307M: lesson 6 is one side.** Lesson 8 passed at ~290M (0 -> 88 % in 25M once its
release was learnt). Lesson 6 sat at 33-48 % from 250M: +y is learnt (10/12 from the hang in C,
every +y start passed), -y is 0/24 from the hang and 0 % at every start of its climb before
10.6 s, passed from 11.8 s. The cliff is the trailing (right) hand's re-grip at 11.2 s, before
it steps up the tier at 14 s; from 9.6-11.2 s the policy lets that hand go and hangs it 3-10 cm
under the rung for the rest of the episode. Lesson 9 entered at 300.4M by the stuck rule, as
designed (no progress 250-300M). The -y frontier sat off that cliff, at a learnt start past it
that read under SLIP by chance, at 39 of 77 checkpoints from 230M: 127 starts past the cliff at
0.91 on average put one under 0.5 at a read 35 % of the time. The frontier is now the latest
start under FAIL = 0.3 (0.3 % by chance), else the latest under SLIP: on the 307M books it lands
on the cliff, 10.6 s.

**gpu13 at 372M: lesson 6's -y climb did not run on the training physics.** With the frontier
on the cliff from 320M (12-13 s at 21 of 24 checkpoints), -y still did not move in 50M steps:
0 % before 11.6 s, lesson 6 from the hang down 38 -> 28 %. Meanwhile lesson 9's frontiers went
42 -> 23-26 s and lesson 8 took its next level, so the policy was still learning. At the cliff
rows its mean was 0.3-1.2 sigma off the climb's action (5-10 sigma before them): cloning had
done its part. Replayed open loop in MJX from its own starts, the old -y climb (searched on
its own, with a re-grip of the right hand at 11.2 s that +y does not make) finished from none
of them (9.6-14.4 s, 18 of 18 still on the tier at the end), while +y finished from every
one. The -y climbs are now the exact mirrors of +y's (`plan mirror`; the simplified robot is
its own mirror image): in C from the hang at 36.4 s, and in MJX open loop from every start
after 2 s. A new fixture starts every book over (`rsi.signature`).

Since those starts moved every family-6 start after the first climb, a checkpoint now records
the fixture it kept its books on (`rsi.signature`). A resume on another fixture starts every
book over: about 10M steps, every start at the frontier until it has START_MIN episodes.

**gpu13 at 533M: lesson 9 sat on the throw, lesson 8 fell, the rollback took lesson 6's -y with
it.** With the mirrored -y climbs (from 418M) lesson 6's -y frontier went 36 -> 13.6 s by 500M,
past its step-up. Lesson 9's frontiers went 42 -> 14 s by 480M and stayed there 50M steps:
the left hand's throw across the gap (released at 14.0 s, caught by 15.0 s), both gaps, both
ways. At 475-480M lesson 8 from the hang fell 79 -> 0 % (all timeouts, no level raised), and
at 532M the guard went back to the best at 445M -- before either climb's progress.
Probed on that checkpoint in MJX: lesson 6 from the hang +y 9/14, -y 0/10 (its starts fail
from 2-16 s, pass from 18 s: the right hand's step-up); lesson 9 fails from 14.4 s and before,
passes from 15.0 s, the throw too weak (0.2-0.45 m of 0.68) and the hook left under the rung.
The throw itself is sound on the training physics: open loop 12/12 from 10-16 s, and 10/10
with the base's velocity jittered 0.05 m/s. What this did not settle is why PPO with cloning
(0.7-1.0 sigma off at the frontier rows) does not carry the throw; a policy cloned offline
alone is no test of it -- it fails lesson 6's -y step-up too (0/32), which training learnt.
Two things changed, neither a guess at that cause:

- a missed throw hung one-handed to the 60 s timeout: 6.6k of the 20.6k episodes from lesson
  9's starts at 475-531M, ~72 % of their steps. Such an episode now ends 'stalled' (truncated,
  as a timeout) once the live potential has made no new low by 5 cm in 20 s (`rsi.STALL`;
  the climbs' own longest such stretch is 7.6 s, 13.1 s at 0.70 -y), lesson 9's starts only;
- the rollback had written over the only weights that could say why lesson 8 fell: the
  policy that forgot is now kept (`out/<name>/rolled/`), and each checkpoint records every
  frontier-window start's book (`window`), so the next snapshot says whether the starts at
  a frontier are being learnt at all.

**Why gpu1 scores lesson 2 at 23 % on the full robot and 55 % in training's model
(2026-09-26).** Lesson 2, deterministic, 30 episodes each: the full robot in C 7/30,
the simplified robot in C 17/30, the simplified robot in MJX 16/30 -- the engines
agree, the robots do not (`rl.mjx_check policy` fails on it, 5/10/16 of 20). In all
three the leading hook takes the next segment AT ITS END: throat p50 0.598-0.608 m
where seg1 begins at 0.60 and its seat at 0.6325, half the hook off the rung;
successes land deeper (p50 0.603-0.631) than failures (0.588-0.595). The physics of
it is the same on both robots: from the same states, held 1 s at their setpoints, a
hook near a rung end keeps its load as often on the full robot as on the simplified
one (and in MJX as in C, to 0.1 mm of slide), and 3 s of the full robot's own
setpoints after each landing, replayed open-loop, keep the hook on seg1 in 50 % of 26
landings on both. What differs is what the policy SEES there: at those states the
simplified robot's hook-rung force reads 420 N against the full robot's 260 (p50;
|difference| p50 192 N, p90 996 N), its hook pad 422 against 265 and its wrist force
263 against 214, where a hook loaded anywhere else differs by 29-38 N (p50). The pad
and the wrist force are in the observation; `mjx_check model` compared which bodies
touch and one step's motion, not these forces, so it passed. The cause is the rung's
END: the full scene's rungs are flat-ended cylinders, the simplified one's capsules
whose 15 mm caps stand past each end, and a hook hanging off an end sinks into the cap
-- 1398 N (mean) against the full robot's 199 on gpu1's gait, p90 2855 N apart.
Pulling the caps 10 mm in matched the force (151 against 199; the simplified robot in C
then scored 9/30 on lesson 2, the full one 8/30) and broke MJX against C: C MuJoCo
gives two capsules lying parallel two contacts, at the ends of their overlap, MJX one
-- at the inner end of a rod that runs past the rung's straight part -- and each hook
plate has a rod along the rung at each end. Near rung ends one control step went from
2.8e-6 to 8.4e-5 rad apart (p50), and gpu1 on lesson 2 from 22 and 20 of 40 (C, MJX)
to 13 and 28: the engine training runs on moved AWAY from the full robot. So the caps
stay where they were; `mjx_check model` now reports the force on hooks near rung ends
beside the touch pairs; and a hold half off an end no longer counts (`SEAT_TOL`,
above), so nothing pays for being where the robots differ. The way to match both is
in `rl.mjx_scene`'s notes (those parallel rods as a ball at each end, where C's two
contacts fall -- more collision pairs, to be timed on the GPU first).
Mirrored (toward the right) the same policy is 0/20: 13 timeouts with the leading
right hook hanging 40-80 mm short of seg1's end and 0.1 m low for the whole episode.

**How long a generated wall needs (the 60 s `walls.TIMEOUT`).** One step of family 4
at its last tops (0.45 m down, 0.30 m on) was found by the same search
(`out/climb_demo/plan_chain.py`, `PLAN=f4fast`: left to the row's end, right after
it, left down, right down) and replays through `ClimbTask.step` to success in 11.7 s
(+19.4); at twice the phase times it takes 24.6 s. Three steps are ~35 s at the
faster pace. Family 5 at 2.50 m (up a row, ~2.8 m along the top, down) comes to ~25-30
s from its parts: a row up 13.7 s in the found climbs, gpu1's lesson-1 pace 0.32 m/s
along a rung (1.1 m in 3.4 s, 20/20), a row down ~12 s. Both fit in 60 s with 1.7-2x
to spare, where family 2's episodes take 16.6 s on average in training (3.6x). The
benchmark gives lessons 4 and 5 120 s; a generated wall is capped at lesson 1's 60 s
because the per-step nudges of a longer idle episode would add up past `FAIL_R`.

**Lesson 9 can be done, at the edge of the robot's reach (2026-09-26).** The same
search, one hand a phase (`plan_chain.py`: `PLAN=l9c`, then `l9e` and `l9f` from its
end): the left hook to the start row's end, the right up behind it (0.12 m, `MIN_SEP`),
the left swung across the 0.90 m gap -- it catches the far rung at y 1.285, 2.5 mm
inside its seat, 1.10 m from the right hook, where three searches from further back
reached 1.06-1.07 m -- then the right lets go and the swing carries the loaded left
hook 0.18 m along the far rung (a slide, charged), the right takes the rung behind it
and the left steps to its goal. Replayed through `ClimbTask.step`: success at 37.1 s,
+16.20 (bank +13.6, reach +5.8, grabs +2; effort -6.1, slide -3.7 of which 1.8 the
deliberate one, time -2.8, fight -0.9, stale -0.5, dangle -0.3 for the right hand's
11 s off, flight -0.3). Not found: a catch deep enough to leave the right hook room
behind the left (1.40 m on, 1.22 m hook to hook), the right hand across first (0.65
m: it has to cross the left arm), the right past the left on the far rung (it stopped
level with it). The 0.90 m gap takes all the reach there is, so family 9's last top is
now 0.90 m, lesson 9's own; it was 1.10, past anything found. Videos of this and of
the family-4 step: `out/climb_demo/lesson9_full.mp4`, `family4_step.mp4`
(`plan_video.py`).

**GPU throughput, measured on a Tesla V100-SXM2-32GB** (gpu1): the batch alone 5,620
control-steps/s at 4096 envs (729 ms a batch step), training 4,490 steps/s (29.2 s a
131k-step update); the card busy 86-100 % at ~190 W, 1.6 GB of its memory in use.
22 hours is ~350M steps. On this Mac's CPU the batch runs ~400 control-steps/s at 256
envs, against ~6400 for C MuJoCo in 12 processes.

**What a batch step waits on, and what was cut (2026-09-29).** One robot's MJX state is
47.6 KB -- 195 MB for 4096 envs -- and the policy a 64x64 MLP, so the card's memory
was never the limit and more envs do not help: the step is memory-bandwidth bound.
XLA's own count for one substep, per env: 1.74 MFLOP against 5.16 MB moved, 0.34 flop
a byte where a V100 needs ~17 to be compute bound; 4096 envs x 20 substeps move
~420 GB a control step, ~470 ms at 900 GB/s of the 728 measured, while the flops
would take 9. Collision is 82 % of those bytes (4.22 MB), the Newton solver 10 %.
MJX tests every listed pair every substep however far apart: 1143 pairs, 972 of them
the robot's 162 capsules against 6 rung slots, 112 its collision meshes against the 2
wall planes (69 vertices a mesh). A slot no wall in play fills is parked 50 m away and
never touched -- and families 1..3 fill at most 3 rung slots and never the extra wall
(families 4 and 6 need 4 and 6 slots, 7 and 8 the extra wall). The batch now collides
only what the walls that can be drawn, or are being climbed, fill (`Batch`'s `fit`,
`MjxClimb.set_pairs`): 578 pairs and 3.00 MB a substep for families 1..3, 1.72x less,
740 and 3.29 MB up to family 5; it grows before such a wall can be drawn, shrinks once
none is live, and recompiles on each change. The physics is the same to the bit (0.0
over 60 substeps on lesson 2 on the CPU; `mjx_check physics` asserts it on the card,
families 1..3 at their last tops). MJX's own broad phase (`max_geom_pairs`) cut the
bytes 0-14 % and, at 162 pairs, dropped real contacts: its bounding spheres make every
capsule near a 2.4 m rung look alike. `rl.mjx_task --envs N` prints both speeds, every
pair and fitted to lessons 1..3. Training also starts every env on a generated wall now
(`Walls._on_training_start`): SB3's reset had put them on the nine benchmark lessons,
which ran to their timeouts off the curriculum.

**MJX's Warp backend, chosen per card (2026-10-09).** gpu4 on an RTX 3090: 6,200
steps/s, the card "100 %" busy at 237 of 350 W, its memory controller 67 %, 5 of 24 GB --
bandwidth again, and still every pair every substep: 642 a substep fitted to families
1..4 (534 the robot's capsules against 3 rung slots, 56 its meshes against the front
wall). MJX's Warp implementation (`impl='warp'`; mujoco-mjx 3.12 carries it, warp-lang
1.16 runs it) tests only the pairs its broadphase finds near. Three things had to change
for it, each found as a robot that fell with no contact at all: Warp culls a pair by
each geom's bounds, per world, so a slot's are its rung's (`_slot_model`; the parked
slot's were a 0.2 m rung's, and a hook off a rung's middle fell through); its kinematics
never moves the world's own geoms, so each wall's rungs and extra wall are written into
the data (`_place_static`); and it keeps the batch's contacts in one buffer, each with
its world, so the hooks' loads are summed across the batch every substep
(`step_batch`, `_contacts`) and handed to the same `update`. A reset copies the start's
fields into the env's own Warp data. On this Mac's CPU, against C by `check_physics`'
own measures: hook loads after 2 s hanging 152/152 N on lessons 1, 2, 7 and 8, as C's;
the side pull +14.3 mm, as C's; one control step from C's state along win17's gait,
joints p90 8.9e-5 and loads p90 0.20 N off -- JAX's own, the same run, 2.6e-4 and 0.30 N:
Warp keeps every contact, as C does, where JAX keeps the deepest 24; a NaN in
one world ends it alone; and in closed loop, on what training runs -- gpu4's best
(rl/fixtures/gpu4, the policy alone) on families 1 and 2 at its tops and family 3's
rl.rsi starts, the same 24 draws -- JAX and Warp both 7/7, 3/5 and 11/12, episode for
episode. (win17's old lessons, which no run trains on any more, gave 0/32 on both at
its hardest four: a comparison of nothing.) `python -m rl.mjx_check warp --out f` runs all that and
win17's episodes on both backends and writes 'warp' if Warp is right, else 'jax' and
why; `--speed --envs N` then times both at N envs on a GPU and keeps 'warp' only if it
is at least WARP_GAIN (1.1x) faster. gpu_run.sh's preflight runs the first beside the
other checks and the second alone, and the run trains with what they wrote
(out/<name>/physics, `--physics`).

Dropping the pairs that never meet instead, measured first: every pair's least gap
(bounding sphere against the plane or the rung segment) over 128 envs x 800 control
steps on families 1..9 at their last tops with rl.rsi's starts, and as many on lessons
1..9, gpu4's policy in half the envs and uniform random actions in the other half
(out/prune/). 287 of 1258 never came within 5 cm, and without them the fitted substep
moves 3.06 MB instead of 3.32 -- 1.09x. Not done: the pairs that cost (a mesh's 69
vertices against the wall) all come near it sometimes, so even dropping every wall pair
would be 1.53x, and a pair dropped for having never met is one a new gait can meet --
Warp's broadphase drops the far ones every substep, exactly.

**It learns, from scratch, on the MJX path** -- measured on this Mac's CPU with 256
envs (8192 steps an update), seed 1, 1.5M steps, 184 updates, 85 min: lessons -2, -1
and 0 passed (92 / 90 / 90 % at the end) and lesson 1 unlocked; approx_kl 0.008-0.014
an update from the start, as every CPU run from scratch had (0.012-0.017); the dip
when a lesson unlocked recovered without a rollback; no blowup, and the contact cap
never full. The first update shape tried here, rsl_rl's 4 minibatches x 5 epochs,
moved the policy 20x less an update (approx_kl 0.0007-0.005 with the rate already at
its cap) -- which is why an update now takes the CPU path's Adam steps.

**Judge a GPU run in updates, not steps.** An update here is 4096 x 32 = 131k steps
against the CPU path's 3072, and a policy changes once per update, so every rule
of thumb in steps from the CPU runs is 43x too short here: lesson -2 passed in
~50-100 updates on the CPU path (0.14-0.3M steps), which is 6-13M steps here. The
guard counts its patience in updates for the same reason. `MJX_ENVS`, `MJX_PPO`
(`rl.train_ppo`) and `ITERATIONS` / `MAX_CONTACTS` (`rl.mjx_scene`) are the knobs,
in that order.

## The reward, and the three exploits it had to be rebuilt around

Each term below exists because a policy broke the previous version. `rl.climb_task`
asserts all of it.

| term | why |
|---|---|
| `K_BANK` on progress credited **relative to the holding hand** | paying live world distance paid for the phase-7 slide: the first policy crossed 0.75 m with a hook that never opened its finger. A per-hand *anchor* — bank how far the hold travelled in the world between supported grabs — fixed that and was beaten by the drag (the `win5` section): a light hand (under `HOLD_LOAD`) whose partner is loaded is credited its approach **minus what the partner's slide along its rung did to that hand's bank potential, both ways** (its whole throat motion until 2026-10-06, which paid the load's sag: gpu2, family 3, below); a loaded hook is credited nothing either way (its motion along the rung is a slide, `K_SLIDE`'s business); a hand nobody carries is credited nothing forward and debited in full back. A drag, a tap and a jump earn exactly nothing; the one loop that would pay — reach free, get dragged back loaded — costs `K_SLIDE > K_BANK`. The first draft was one-sided to be safe (every retreat debited, only the partner's *forward* motion subtracted) and it charged a known-good one-hand step **−220 mm per episode** for ordinary settling: −7.5 m of debits against +6.3 m of credit over ten episodes. One-sided rules charge for noise |
| anchor moves only after the hand got `CLEAR_OF` the rung | without it, a wrist-load dip counted as taking a new hold — on the 5.1M policy **every** re-anchor was that, with the hook never leaving the rung |
| both terms charged **both ways** | paying only in the good direction is a pump: measured **+27.28 paid for 0.000 m of travel** and 99 release/reseat cycles in one episode |
| `K_DANGLE` with a `DANGLE_GRACE` | the flat version taxed the release climbing is made of, −15.25 against +5.57 of progress. The grace is **6 s** of off-time per hand, not 3: lesson 9's swing keeps the free hand off for the 6.6 s it pumps and reaches, and at 3 s paid 0.85 for it |
| `K_SEP` | the distance term is a **sum** over both hands, so it does not care which hand works: policies froze one hand and crossed the other over it. Pricing only *crossed* then parked both hands on the same point (mean separation 1 mm), so it is a floor, not a sign test. Measured only when **both hooks touch the same rung**: two hooks on two rungs cannot claim one span, and measured along the start rung whatever they were on it charged 0.7–2.1 a climb with the hands on two rows and 1.56 on lesson 9's swing, the free hand in the air passing the holder |
| `K_DANGLE` over a cumulative budget | charging a *continuous* stretch off the wall was evadable: 88 short hops kept every stretch under the grace and a hand off 79 % of the episode paid 0.13 |
| `K_STALE` | across every run, **the left hand never once let go**. The hands deadlock — the right is airborne 79–84 % of the time, so the left never gets a safe moment. `K_DANGLE` says do not stay off, `K_STALE` says do not stay on. Now **0.001**, not 0.01: at 0.01 two hands hanging for 60 s cost 28.6 — three times a fall — and that is the landscape `win5` settled into (below). Nudges must never add up to more than the fall they exist to prevent; the incentive test asserts a full idle episode (−7.4) stays above `FAIL_R`. Charged only while the **other hand is loaded**, when letting go is possible at all: a hand that holds while its partner is in the air has no choice, and paid for it through every reach, climb and swing (0.1–0.3 each) |
| finger inside `GRIP_BAND` gates `_holding` and `_success` | nothing ever asked a finger to close, and the simulator lets an open hook carry the whole robot. The 10M policy held with the finger at +20° for most of an episode. There are **two** ways out of the band and it used both — the left hand opened, the right ratcheted −36 → −46 → −37, past the −45° cliff where pull-off drops from >1200 N to 72 N |
| a hold counts only **on a seat** (`SEAT_TOL`) | gpu1 landed lesson 2's leading hook at the very end of the next segment -- throat p50 0.598 m where it begins at 0.60 and its last full seat at 0.6325, half the hook off -- and was banked, graded and paid for it, on the simplified robot it trained on (17/30 there, 7/30 on the full one: below). `_holding`, and with it every grab, bank and success, also asks that the throat be at most `SEAT_TOL` (5 mm) past the last full seat of a rung it touches. The found climbs, the family-4 step and lesson 9 replay to the same returns; the seat test hangs a loaded, gripping hook 20 mm past its seat (115 N: not holding) and 4 mm inside it (105 N: holding) |
| every hold test reads **contact force** (`_contact`) | see the section below — this replaced `ON_RUNG`, `CLEAR_OF` and `env.latched`, all three of which were proxies a policy could satisfy without holding, or *fail* while holding |
| progress measured **at the rung** (`_route`, `_cost`) | the straight-line distance to a goal 1.4 m along the wall paid the `win9` policy +0.3–0.4 m for dropping half a metre under the far segment — the nearest it could get to the goal with the other hand parked — and it hung there for 58 s in 20/20 episodes: lesson 1.5 at 0 % for 5.3M steps with every earlier lesson above 80 % (the `win9` section). The bank now measures each hand at its **rung point** (nearest point on any rung) to the goal, which a loaded hook can move only by sliding, and sliding is charged; the live reach goes to the goal along the shortest route through the rungs (`route_table`) plus `AIR` x the depth below every rung (through the nearest rung until 2026-09-26, which made every reach for another rung uphill halfway: gpu1, family 3, 0 % for 90M steps). Identical along a rung (lesson 1 replays to the same reward); a dive is charged live and refunded on the way back up. The detour must stay out of the bank: a loaded hook's throat sits 30–80 mm off its line under load, uncharged, and with the detour banked that was refunded on every re-seat — the first check run banked 56 m per episode on it. Route test: the same dive is +137 mm straight-line, −108 mm along the routes; a loaded hook pulled 30 mm off its line moves the bank 0; a hook lifted 0.30 m toward the rows above is paid 0.30. Barrier test: along every lesson's shortest route, both hands, the live cost never rises (worst 0.0 mm) |
| the map describes **seats**, not geometry (`SEAT_IN`) | the nearest-rung offsets and the end distances the policy sees, and the potential it is paid on, clip each rung half a hook-width (32.5 mm) in from its ends: a hook centred on the geometric end hangs half off it. On the `win9` video the hook ratcheted to the very end of its segment and let go — the user's reading of it |
| the anchor follows the **SLAM** position along its rung (`SLAM_TAU`) | the loaded hook creeps along the rung while it holds — 85–210 mm per episode on `mac16`, 100 mm by the first hand-over — and nothing on the arm can see it: two hooks on a smooth rung have no world reference. At a gap the far segment then read 60–210 mm too far and the hook was pushed into its end face 38 mm short. The real robot's lidar SLAM sees the body move against the wall; simulated as the base position with `SLAM_SIG` (2 cm) of noise, low-passed over 1 s, it moves the anchor's map point along its rung. Replayed on the mac16 policy: anchor error p50 20 mm / p90 34 everywhere (was 51 / 149 on lesson 1.5 and 145–179 / 300 on lesson 1), −18 ± 27 mm at the moment the hook meets the far segment (was +89, 60–210). The slam test creeps the loaded hook 25 mm under a pull and asserts the anchor follows. A second touch zone on the hook's lip was tried first and was exact (every end contact at z = −110 mm in the hook frame, every seat at z ≥ −98) — but the robot has no such sensor, and it is gone |
| the pool's **steps go where the failures are** | a stuck lesson-1.5 episode runs 1490 steps against ~200 for a one-step lesson, so drawing by episode gave the newest lesson 96 % of the samples, and what it learnt while stuck was learnt in the states lesson −1 starts from: −1 fell to 0–2 % in three runs (mac14, mac16, mac17). Each lesson's draw probability is now its share of the steps divided by its mean episode length, and the share is how much it still fails — `max(1 − rate, MIN_SHARE)` — so a lesson at 0 % is fed whether it is the frontier or the one behind it that regressed. Four rules were measured on 2.5–4.5M-step runs: by episode (above); a fixed 25 % for the frontier, which starved it — lesson 1 got a quarter of the samples `win9` gave it and `win10` was still 0 % at 1.4M; a fixed 60 %, which reached **lesson 2 in 2M steps** (mac26, the best run there has been) but left lesson −1 at 0 % from 0.6M on; and this one, which held every lesson at 85–100 % through 4.5M (mac27) with a slower frontier. Squaring the need concentrates harder (66 % of the steps for a stuck frontier instead of 49 %) but starves the early curriculum while several lessons are half-learnt, and lesson 1 stalled for 2M (mac28). A slow frontier is fixed by more steps; a forgotten lesson is not |
| the SLAM **attitude** — measured, available, *not* used for training | measured on the mac20 policy *during the climb*: the triad-referenced filter was 4.0° p50 / 6.3° p90 / 15° max off (the triad itself 18–30°: every hand-over is an impact), which on the 0.5 m lever from the anchor to the hand was 35–55 mm. Referenced to the SLAM attitude instead it is 0.2° / 1–3°, the free hand's error falls from 36 / 80 mm to 13 / 40 on lesson 1.2, and a trained policy runs fine under it — but six fresh runs with it never learnt lesson −1 (the bisect table in the `win9` section), so the policy trains under the triad-referenced filter and `SLAM_TAU` 1.0 s, and `ClimbingEnv.slam()[1]` waits for a policy that has passed the gap lessons |
| `STALE_AFTER` 8 s → **2.5 s** | the threshold was longer than the episode it policed. The winning lesson-1 run is 5.8 s, so the hand that never released was charged exactly 0.00 |
| `MIN_GRABS` in `_success` | the task was completable with **neither hand ever leaving the rung**: 1 m traversed with the right hook never further than 24 mm from the rail and the left hand carrying under 10 N for 89 % of the episode. Alternating grips is not one way of doing this task, it is the task |
| finger setpoint stopped at the **band's edge** | the joint runs to −90° but the hook levers itself off past −45°, where pull-off drops from >1200 N to 72 N. The 20.8M policy drove the right finger to **−83°** and the hook walked out of the throat while carrying 100 N, so the stop went to the cliff. That left a 5° trap: a policy that squeezes as hard as it can sits at −40…−44° under load — a fine hold physically (98–179 N) that neither the reward nor the estimator recognised, because both ask for `GRIP_BAND`. On the 10.8M `win8` policy **90 %** of loaded steps on lesson 1.5 (34 % on lesson 1) were "not gripping" for that reason alone; the estimator kept its anchor on a hand that was moving and saw the far ledge 240–500 mm from where it was. The stop is now the band's edge, −40°: squeeze as hard as you like, it is in band (375/382 loaded steps while swinging, asserted) |
| `K_FLIGHT`, and a jump earns nothing | the 21M policy's whole lesson-1 gait was jumps: the right hook let go and re-caught within 1–5 control steps while the left hung in the air — off **96 %** of the time, **0.0** load swaps per episode — and each brief tap of the left hand then banked what the jump had covered. A control step in which, for even one physics substep, no hook bore `HOLD_LOAD` is a jump: charged, nobody is loaded so nothing is credited, and the landing is no cycle. Replayed: that policy drops from 5/5 to **0/12** |
| `K_SLIDE` | sliding stays legal — the rung is smooth on purpose — but a **loaded** hook dragged along it pays 10/m, because it is friction work and because it is invisible: measured in shadow on the alternating policy, the anchored hook was dragged **100–724 mm per tenure**, both hooks seated (next section). This is *not* what makes dragging unprofitable — the relative credit is. Raising it to 20 was tried when the drag appeared and it stalled learning outright: 3M steps at 30 % on the very first lesson, std 0.42, because the same charge lands on the few centimetres the holding hook settles by during every honest reach. It has to beat the live shaping term and the bank: `assert K_SLIDE > K_BANK and K_SLIDE > 2 K_REACH`. Charged on the **net** of each loaded run — as the hook gets further from where the run began, refunded as it comes back — not step by step: a loaded hook's throat rocks 0.1–0.3 mm every step, and that jitter was 16–62 % of the slide four CEM-found climbs paid (0.8–2.4 a climb). A drag's net is its length, so it is still charged in full |
| a hold counts only while the **other hand is loaded** | three points of contact. A hold taken with nothing else on the wall was a jump's landing or a hand-over with a gap in it, and the gap is where the map goes wrong: 86 of 129 anchor switches on the 3M policy had no step with both hands confirmed and baked in 62 mm each. Gated, the same curriculum unlocks at the same pace (lesson 2 at 0.94M against 0.89M), hand-overs with overlap go from 30 % to 53 %, and the anchor's error at the end of a lesson-1 traverse drops from 540–980 mm to 27–320 mm. What is paid is what can be seen |
| credit classified by the load at **both ends** of the step | the pump the finger-stop fix uncovered: with every touch now in band, a 3M local policy took **578 holds per episode** with the right hand — 97 % of its lifts one or two steps long — and banked **20 m** of credit on a body that moved 0.4 m, +78 per episode against +25 for actually crossing the gap. Lift (free at the end of the step): the 30 mm forward credited. Touch down (loaded at the end): the 30 mm back credited nothing, and not a slide either. Two closures were tried first and were the wrong tools — charging a slide with load at *either* end taxed every seat and unseat of an honest gait (the 95 % lesson-1 policy paid 1.5 m per episode of it and fell to 50 %), and requiring three steps clear before a hold refused the 1–2-step hops honest hands take 70–90 % of the time, so the first lesson stayed at 0 % for 3M steps. Classified by the load at the *start* of the step, the lift is worth 0 and the touch-down debits the 30 mm; and the partner's motion is subtracted only while the partner is loaded at both ends. Replayed: the 95 % policy is back to 15/16 and 13/16, the pumping policy nets −122. That closure had a mirror, and `mac14` found it: classified by the start, the lift is the free step, so it rocked the hook on the rung at 12.5 Hz — throat 32 mm *back* on the lift (ignored), 31 mm *forward* on the touch-down (credited): 698 holds and 23 m per episode, +241. Classifying by either end of a step leaves the other end open. Now a step is a slide's business only with load at **both** ends of it — the slide charge's own test — and every other step is a potential difference, both ways; so every motion of a rung point is either a charged slide or a two-way credit, and no cycle between the two pays. Both one-step cycles are in the jump/drag test and net exactly nothing; the rocking policy replays to −38, the two 95 % lesson-1 policies to 11/12 |
| `K_GRAB`, once per hand per episode | seating a hook from the air is the one skill the reach credit cannot teach by itself. Under the relative credit the 600k policy carried the free hand to within 40 mm of its goal and **hovered there for the whole episode** — 0.2 grabs per episode, paying the dangle charge rather than come down, because the grab that would have banked its credit was a rare event with a small payoff. The earlier world-anchored reward had taught seating by accident, by paying shuffles *on* the rung first. One bonus for each hand's first supported hold that banks `GRAB_MIN` (30 mm) toward its goal: flutter cannot farm it, and it is a partial payment of `MIN_GRABS`, not a goal of its own. Until 2026-10-06 any first hold was paid, and a re-grip in place took it: gpu3 let go and re-took family 3's start rung ~200 times a hand an episode, +2 in its first second against the climb's −1.25 two seconds into its reach (1193 such holds banked at most 16 mm; lessons 1/2's real steps a median 54–98 mm) |
| `K_EFFORT`, `K_FIGHT`, `K_TIME` | the gait was legal but nothing like climbing. Measured against a still hang (29.6 N·m, 107 N): the stuck episode ran 145 N·m and **202 N of grip on a 109 N robot** — ~95 N of the two arms pulling against each other. All three price the *excess* over hanging still, never the absolute, so existing stays free. `K_FIGHT` prices the force the wrists **cancel**, (\|F_L\| + \|F_R\| − \|F_L + F_R\|) / 2 in the world frame, not their sum over body weight: the sum also billed whatever accelerates the body — lesson 9's swing loads the holding wrist to 634 N, three times body weight, with the free hand at 4 N (0.38 over one swing), and every pull-up of a climb (0.5–2.0) |

Replayed on the audited policies the set does what it should. The 10.4M run's
99-step success scored +13.23 against its 1490-step stuck episode's −51.17, with no
term charging the healthy episode more than 0.30. The 10M run's ratcheting exploit,
which scored **+13.58 and `success`** under the old rules, now scores **−4.98 and
`fell`** with 0 real grabs from either hand.

A single-joint sweep says crossing is not necessary: the leading hand gains **+459 mm**
toward the goal on its 60° of outward travel, against **+64 mm** for crossing the
trailing one. Crossing was a local optimum, and lesson 1 — solvable by sliding both
hands — kept reinforcing it.

**Do not train on a narrowed pool.** Dropping lesson 1 to force lesson 2 was tried and
it is plain sequential fine-tuning: lesson 1 went from 12/12 to falling 4/4, and
lesson 2 got worse too. Keep the pool mixed, as the section above says.

## Contact force, and why every distance threshold before it was wrong

The 20.8M-step `win3` run reported **2.5 %** on lesson 1 and never unlocked lesson 2.
The policy was not the problem. Three separate proxies for *"is this hand on its
hold"* disagreed with each other and with the physics:

| test | what it measured | how it failed |
|---|---|---|
| `env.latched` | rung inside a box round the nominal seat | read False on **both** hands for 32 % of an episode — 89 % of those with a hook carrying more than 20 N |
| seat gap `< ON_RUNG` | radial distance, throat point to rung axis | a seated hook reads 2 mm hanging still but **31 mm under a 50 N side pull**, and a hand merely hovering reads 42 mm. The two states overlap, so no threshold separates them |
| wrist F/T | force through the wrist | a hand pressed flat on a wall reads 86 N with the finger shut on nothing |

They were also wired to *different* places: the reward used the gap, and the episode
was ended by `env.latched`. So a one-handed phase — the thing a climbing gait is made
of — was 0.6 s from a spurious `released` and a −10, while the reward said the hand
was fine. `ON_RUNG` was tightened to 20 mm on a measurement taken from a **static**
two-handed hang, which does not survive contact with a loaded hook.

MuJoCo already knows the answer. `_contact` sums the normal force between a hook's
collision geoms and any rung:

| | holding | free / fallen |
|---|---|---|
| contact force | **72 – 229 N** | **0.0 N exactly** |

No overlap, across static hangs, one-handed hangs, a 50 N side pull and a 200 N
downward pull; no flicker (1200 steps of still hang, minimum 40 N); and it costs
nothing (1 % *faster* than `latched`, which does matrix work per rung). It now
answers every one of those questions — held, let go, still attached, success —
so all three proxies and their thresholds are gone.

Re-measuring the same `win3` policy against contact instead of the gap:

| | reported | actually |
|---|---|---|
| lesson 1 success | 2.5 % | **40 %** (16/40) |
| real grab cycles per episode | L 0, R 2 | **L 8.1, R 10.3** |
| episodes with both hands cycling | — | **38/40** |

The alternating gait was already there. The measurement could not see it, and
`MIN_GRABS` — which reads the same broken counter — was rejecting the successes.

## Where the robot thought it was

The observation is map-relative: goal and rungs are given relative to the hands, and
the hands come from an estimator rooted in the hand that holds — encoders, IMU and
the wall map, nothing else. The 21M `win4` run showed what that costs when the gait
is wrong:

| `win4`, 21.2M steps | lesson 1 | lesson 2 (0.25 m gaps) |
|---|---|---|
| success | 95 % (best), 60 % (last) | **0 %** for the 16M steps it was in the pool |
| gait | right hook jumps, left hangs 96 % off | left hangs 95 % off |
| rungs touched in 30 episodes | — | `rung_start` only — **never `seg1`, never `seg2`** |
| estimate drift within an episode | 0.6 – 1.2 m | 0.3 – 2.8 m; `seg1` truly 134 mm away, seen at 417 |

Lesson 2 was not hard. The policy could not see it: every jump moves the robot along
the rung with no hand to root the estimate in, and the drift is the sum of the jumps.

Where the error comes from, measured on the alternating `win3` policy over 815 steps
and 43 grabs, with the free hand's estimate rooted at the anchor's **true** hold:

| attitude source | free hand, all steps | along the rung, at a grab |
|---|---|---|
| IMU triad (accel + mag) | 148 mm mean, 1425 max | 29 mm mean, 250 max |
| rung frame from the map, IMU only for the swing | 154 / 1426 | **16 / 139** |
| perfect | **0 / 0** | **0 / 0** |

The kinematics are exact. All of it is the attitude, which the body's own
acceleration bends — the bare triad (accelerometer + magnetometer, no state) reads
the swing as tilt and is **26.5° rms** off while the body moves. The robot has a
gyro, so the torso attitude is now a complementary filter: the gyro carries it
across each control step, the triad pins the drift with a 2 s time constant
(`AHRS_TAU`). Measured on the same trajectories: 3.6° / 2.1° rms on lessons 1 / 2,
free hand **16 / 12 mm** against 91 / 130 for the triad; the pure gyro (no
correction) drifts to 83 mm, and a swing-angle model of the seated hook — rung
frame from the map, one angle from the IMU — was tried first and came out *worse*
than the triad (181 mm even with the true angle: a loaded hook does not sit still
in its throat). Holds are placed by **reach** (`_reach_point`): the
distance between the two throats is exact from the encoders whatever the attitude,
both throats sit on rung axes the map knows, and the new hold is the point on a rung
at that distance from the anchor's hold — a sphere cut by a line. The map-rooted
guess picks the side; after that the branch stays put. Exact in the unit test from a
guess 157 mm off, across the gap onto `seg1` as well.

What reach cannot fix, measured in shadow on the trained gait: the anchor itself
moving. With both hooks seated the anchored hook was dragged 100–724 mm per tenure,
and every jump adds more. `K_SLIDE` and `K_FLIGHT` exist so that the gait the policy
is paid for is the one the sensors can track — one hand holds still while the other
moves, which is also the one that was asked for.

## The sensors read like real ones (Sept 30 2026)

Since 2026-09-30 every number the observation is computed from reads the way a real
sensor would. The reward still reads the truth (`ClimbTask.true` against `.sen`), and
`ClimbTask(noise=False)` switches the noise off. `rl.mjx_task` draws the same noise,
and `python -m rl.mjx_check task` feeds it C's draws and matches it to 1e-15.

| what | model | constants in `rl/climb_task.py` |
|---|---|---|
| encoders, IMU, F/T, pads | white noise on each reading, plus one offset per episode (encoder zero, IMU offsets, the motors' hard iron on the magnetometer, F/T drift) | `SEN_SIG`, `SEN_BIAS` |
| gyro in the attitude filter | the same, summed over the 20 substeps | `sensed_rates` |
| lidar SLAM | the error **drifts** (20 mm, correlated over 5 s). A fix comes with every lidar frame, 10 Hz: every 2 or 3 control steps (`scan_due`). It is 2 steps (80 ms) old, so it is compared with the estimate of the moment it describes. It is taken **only where a wall faces along the rung**: on a flat wall the SLAM cannot see along it (below) | `SLAM_SIG`, `SLAM_DRIFT_TAU`, `SCAN`, `SLAM_LAG`, `SLAM_GAIN`, `FACING` |
| wall map | per rung, per episode: the axis 10 mm off sideways and 1° off in direction, each end 10 mm off along it. Goals move with their rung | `MAP_SIG`, `MAP_ROT_SIG`, `MAP_END_SIG` |
| what the lidars see | see below: a rung is in the map once seen, as far along as seen | `rl/lidar.py` |

The values are datasheet-order guesses; none was measured on this robot or its lidar
stack. Until this change the SLAM error was white: independent on every step, so
`SLAM_TAU`'s filter averaged its 20 mm down to about 3 mm. A drift does not average
out. Hanging still, the anchor now follows it (correlation −0.45 in the sensor test).

What the noise does to `win17`, which was trained on exact sensors and an exact map.
Full robot, 12 episodes per cell:

| lesson | exact | all noise | all noise except the map's tilt |
|---|---|---|---|
| −1 | 12/12 | 0–3/12 | 12/12 |
| 1 | 12/12 | 0/12 | 11/12 |
| 1.5 | 12/12 | 0/12 | 7/12 |

With one group switched on at a time, on lesson 1: map 0/12, SLAM 11, encoder angles 10,
velocities 11, torques 10, IMU 10, F/T 12, pads 10. Within the map, 10 mm of sideways
offset costs nothing and 20 mm on the ends costs 1/12, but **0.3° of tilt drops it to
1/12**. Every rung `win17` trained on ran along one world axis, so the x and z
components of the rung axes in its observation never varied. VecNormalize holds their
std at its floor, 1e-4. A 0.3° tilt moves one of those components by 0.005, which
normalises to 50σ and is clipped to 10, and six inputs saturate. This is not a
question of noise level: a real rung 0.3° off level would do the same. A policy
trained with `MAP_ROT_SIG` sees those components vary (std about 0.017), and the
problem goes away.

So **do not resume a checkpoint trained before this into the noisy task.** Its
VecNormalize has seen 35M samples, and a running variance only climbs as fast as new
samples outweigh the old ones. After 1M more steps those components' std is still about
0.003, and a 1° tilt still reads 6σ. Start fresh.

### The map holds what the four Mid-360 have seen

Since the lidars went on the robot (`urdf/README.md`, "The lidars") the map is built
the way the real one is. Every lidar frame, each rung's 32 cells are ray-cast from the
four optical origins (`rl/lidar.py`, the same lines on numpy and jax). A cell is seen
when it is 38–97° off one lidar's axis (the datasheet's −7…+52° of elevation), 0.1–40 m
away, and nothing is in the way: the robot's own arms, hooks, cage and lidars (the
`occ_*` sites the CAD writes into `scene.xml`), or another rung. The map keeps every
cell it has seen and spans each rung from the first to the last. A rung not seen yet
is not in `_near_rungs`, `_nearest_rung` or `_reach_point` at all. A hidden end reads
as an end: the lidar cannot tell them apart. `noise=False` switches off the noise, not
this; the reset's map is what the lidars see from the hang.

From the secured hang, every lesson's start rung is in the map; the parts that are not
are behind the raised arms and the cage's bars. Seen at the start:

| lesson | rungs (share of cells seen) |
|---|---|
| 1 | start 88 % (the spans under the hooks and upper arms; the ends are seen) |
| 1.5 | start 75 %, seg1 88 %, seg2 100 % |
| 2 | start 75 %, seg1 94 % (its near 2 cm behind the left upper arm), seg2 100 % |
| 3 | (stacked rows, before 2026-10-06) start 88 %, up1 72 % (its end 0.23 m short), up2 81 % |
| 4 | start 81 %, step1 66 % (one end 0.33 m short), step2 100 %, step3 100 % |
| 6 | (before 2026-10-06) start 88 %, stag1 69 %, stag2 97 %, **stag3 6 %**, top1 100 %, top2 100 %; now start 81 %, stag1 78 %, the rest 100 % |

`python -m rl.climb_task`'s lidar test: 6 s of flailing on lesson 6 takes every rung to
100 %. Cost: 1–5 ms of numpy per frame, 2 frames in 5 control steps.

The old map was the whole wall, known from the first step. A policy trained on it has
never met a missing rung or an end that moves once it is seen. Start fresh here too.

### The SLAM is trusted only where it can see (`along_seen`)

`python -m rl.slam_test` (see `slam/README.md`) runs the real thing: the four Mid-360
simulated point by point, FAST-LIO2 in Docker, and the rung map built from its points.
On a flat wall, FAST-LIO cannot tell where the robot is along the wall. Every match on
the wall and on the horizontal rungs constrains the directions across them and none
along them. It drifted 0.2–2.5 m rms along the rung in 10 s on lessons 1, 2, 4, 6 and 8.
In the corner (lesson 7), where a wall faces along the rung, it held 4–5 mm.

That direction is the only one the estimator asks the SLAM for: the loaded hook's creep
along its rung. So the SLAM fix is now taken only when a wall's normal is within 60° of
the anchor's rung (`FACING`). On a flat wall the estimator keeps its own kinematics, and
the creep goes unseen. That is what the robot will meet on any flat facade.
`python -m rl.climb_task`'s slam test pulls the hook 25 mm along the rung twice:
- in the corner, the anchor follows it to within 4 mm;
- on the flat wall, it is left 24 mm stale.

`rl.mjx_task` does the same from the wall table, the front wall and the extra wall
slot, and `rl.mjx_check task` matches it to 1e-15.

The rig registers FAST-LIO's frames the same way. Where FAST-LIO cannot see — along a
flat wall, and up and down with no floor or ceiling — the frame goes where the
estimator has the body, not where FAST-LIO drifted it. Measured over 10 s of swinging:

| lesson | FAST-LIO along the rung | the pose the map is built with | rungs mapped | across | tilt |
|---|---:|---:|---|---:|---:|
| 1 | 871 mm rms | 39 mm | 1/1 | 11 mm | 0.1° |
| 2 | 179 | 60 | 3/3 | 12–16 | 0.2° |
| 6 | 598 | 55 | 4/6 | 13–19 | 0.4–1.6° |
| 7 (corner) | **4** | 4 | 2/2 | 10–13 | 0.2° |
| 8 | 676 | 69 | 2/2 | 20–21 | 0.3° |

Those are the map against the world, and the ends there are up to 11 cm off. Most of
that moves a whole rung along the wall by the estimator's own error at the moment it
was mapped, and the robot reads its map through that same estimate.

**What the policy reads is what counts.** For each hand, the offset from its estimated
throat to the nearest mapped seat, and its distance to that rung's nearer end, against
the same two from the true throat to the true rung. `rl.slam_test --compare` measures
it on FAST-LIO and on the training model, with the same actions (10 s of swinging):

| lesson | offset to the nearest rung, FAST-LIO / training | along the rung | nearer end |
|---|---:|---:|---:|
| 1 | 15 / 19 mm rms | 0 / 0 | 16 / 61 |
| 2 | 22 / 30 | 12 / 23 | 48 / 61 |
| 6 | 17–22 / 32–33 | 1–2 / 0 | 28–83 / 58–64 |
| 7 | 40–42 / 19–20 | 1–3 / 0–2 | 60–68 / 28–30 |

The training model is in the same range, so `MAP_*` stay as they are. Two differences
remain:
- **The corner reads 2x worse on FAST-LIO.** Up and down come from the estimator's
  kinematics there.
- **The real map sometimes misses a far rung.** Lesson 6 missed 2 of 6 in one run of
  two, and lesson 7 missed its side rung in 2 of 3. FAST-LIO does not repeat itself
  run to run, and a rung smeared up and down by the registration falls under the
  detector's 5σ. The training model maps every rung a ray has reached.

Before the rig bridged the gap a hand hides (`SlamTask._bridge`), every held rung read
as two, with an end at each hand. The nearer end was then 120–250 mm off.

## `win9`: everything before lesson 1.5 passes, and the reach paid for hanging below the rung

5.3M steps with the draw weights and the start-of-step credit: −2 80 %, −1 92 %,
0 92 %, lesson 1 88 % (10/12 in audit, two hands alternating, 1.0 m in 480 steps),
no collapse — and lesson 1.5 at 0/40 the whole way, best checkpoint at 1.8M. Not
blindness this time: the estimate at the far ledge is right to 30–50 mm. Not the
pool: the four lessons behind it held. The action std is 0.62.

What the policy does, every episode (20/20 in audit, and 7/8 for the mac13 policy
of the previous section): the left hook hops along the start segment as it does on
lesson 1 (first hop 87 mm, then 26 mm) until it is past the end, level with it at
y 0.39 — the segment ends at 0.35 and the far one begins at 0.47 — and then, within
one second, drops 0.34–0.47 m below the far segment and hangs there for the
remaining 58 s, 0.9 m from the right hand, which never moves. Off the wall 98 % of
the episode, −13.8 of `K_DANGLE`, −24 per episode against −7.4 for hanging still.

The drop was *paid*. Progress was the straight-line distance from the hook to a
goal 1.4 m along the wall, and from level with the gap a hand hanging half a metre
under the far segment is 0.14 m nearer that goal than one level with it:
+0.30–0.44 m of "approach" over the dive on replay, +0.6–0.9 of reach inside three
seconds, for arriving in a state no lesson had taught it to leave. Every earlier
lesson has one continuous rung, so straight-line and along-the-rung had always
agreed, and the seam only opened at the first gap.

Progress is now measured through the rungs. A hand's rung point is the nearest point
on any rung (`_route`); the bank measures that point to the goal. The live reach
(`_cost`) is the way a climber can go: every rung is sampled every `ROUTE_STEP`
(4 cm), each point knows its shortest route to each goal (`route_table`: Dijkstra,
moves along a rung, hops between rungs inside an ellipse `HOP` 1.2 m across and
`HOP_UP` 0.65 m up or down -- a swing bridges family 9's 1.1 m gaps, nothing
stretches the 0.56 m static reach up), and a hand pays the air to its cheapest such
point (`K_OVER` a metre more of the air outside that ellipse) plus that point's route,
plus `AIR` (0.5) a metre it hangs below every rung. Along a rung nothing changes --
0.30 m of reach still pays 0.30 and lesson 1 replays to the same reward. Off it the
air is charged and refunded on the way back; it is a function of the state, so it
telescopes and cannot be pumped. The route test asserts the win9 dive itself: +137 mm
in a straight line, −108 mm along the routes.

It took four tries on 2026-09-26, each measured by walking every lesson's shortest
route with each hand and recording how far the cost rose above its running minimum
(the barrier test, now asserted: worst 0.0 mm). Through the NEAREST rung (the detour
off it plus its point's straight line to the goal, the version before) the first
half of every reach for another rung was uphill: a hook lifted toward the row above
paid its lift until the upper rung was the nearer one -- `K_REACH` x 0.15 m charged
for trying on family 3's easiest walls -- and gpu1 never lifted a hook past 28 mm
there in 90M steps. Through the BEST rung's nearest point the dive came back (a
straight line through the air to the goal's own segment), and the climb over lesson
5's break stayed uphill, 0.37 m for a hook lifted straight up, because that straight
line crossed a break no hand crosses; lessons 4, 6 and 7 kept 0.06-0.09 m hills
where the nearest point of the next rung was not on the way. Routes with a hop of
1.2 m every way still left 36 mm at lesson 5 (a route took off 1.1 m ahead and 0.45
up), the ellipse 21 mm, and `AIR` charged below the NEAREST rung jumped 100-120 mm
where a climbing hook's nearest rung became the one above (lessons 3, 5, 6). Below
EVERY rung it is zero everywhere a route goes. A hook lifted 0.30 m toward the row
above is paid 0.30; at lesson 5's break one lifted 0.4 m toward the row over it is
paid 0.11.

The first check run of it (`mac14`, 3M) scored **+241 per episode on lesson 1.5**
with a body that never moved — the right hand taking 698 "holds" per episode and
banking 56 m — and it taught two things. The detour cannot be in the bank: a loaded
hook's throat is pulled 30–80 mm off its line by the load, uncharged, and that was
refunded on every re-seat. And under it a second seam that had been there since the
win8 fix: the credit was classified by the load at the *start* of the step, which
leaves the lift-off step free, so the hook rocked on the rung at 12.5 Hz — throat
32 mm back on the lift (ignored), 31 mm forward on the touch-down (credited). The
win8 pump was the same cycle the other way round, and classifying by either end of
a step leaves the other end open. Now a step is a slide's business only with load
at *both* ends — the slide charge's own test — and every other step is a potential
difference both ways, so every motion of a rung point is either a charged slide or
a two-way credit and no cycle between the two pays. Both one-step cycles are in the
jump/drag test and net exactly nothing. Replayed: the rocking policy nets −38, the
win9 and win8 lesson-1 policies 11/12 at +19 and +17, win9 on lesson 1.5 −25 as
before.

Checked locally with both (`mac16`, 3M steps, 8 envs): the dive is gone — the left
hook spends 0–6 steps below the far segment instead of 1400 — and it now reaches the
far segment in every episode and touches it for 13–295 steps, but never takes a
seated hold there; lesson 1.5 stays at 0/40. Measured at those contacts: the throat
is 38 mm short of the segment's end (min 24, max 48), 30 mm below its axis, the tip
pressing the end face with 7–22 N — and the estimator has the hand 60–210 mm
*behind* where it is, so the policy believes the segment is still that far away and
keeps pushing. The whole of that error is the anchor: the loaded hook **creeps along
the rung while it holds**, 85–210 mm per episode and 100 mm already at the first
hand-over, and the estimator's anchor point does not move. Two hooks on a smooth
rung have no world reference, so this creep is unobservable on a continuous rung
(where it does not matter) and fatal at a gap. It is not the solver's tangential
slip: `noslip_iterations` removes the drift under a static 25 N pull (25 → 0 mm) but
the policy's own loading still slides the hook 489 mm per episode with it on. Three
things followed, each in the reward table: the anchor's map point following the
lidar SLAM position along its rung (the only sensor the real robot has that sees
the wall; a lip touch zone was tried first, was exact, and was removed because the
robot has no such sensor); the map and the potential describing seats rather than
geometry; and the curriculum drawing by share of steps, because lesson −1 had
collapsed to 0–2 % in both check runs of the both-ends rule — a stuck 1490-step
lesson-1.5 episode was 60 % of the samples at 25 % of the draws, and its behaviour
was learnt in lesson −1's own states.

With the seats, the step draws and the (since removed) lip landmark (`mac18`,
3M): −2 100 %, **−1 92 %**, 0 92 %, 1 60 %, 1.5 0/40 — but the far segment was
reached and *held*, in 12 of 16 episodes, by the wrong hand: the right hook crossed
over the left, which never moved, and hung on the far segment for ~1000 steps paying
`K_SEP` −41 per episode for the crossing. The events lesson 1.5 needs are happening
and the credit is paying them.

With the SLAM tracking in place of the lip pad (`mac19`, 3M): −2, −1 and 0 at
**100 %**, lesson 1 at **95 %** (11/12 in audit, 1.0 m in 184 steps, 106 mm of
loaded slide — the cleanest gait so far), the anchor right to p50 4 mm / p90 16 mm
on lesson 1.5 — and lesson 1.5 at 0/40 in a new basin: the left hook goes to the
end of its segment, past its last seat, and hovers there brushing the end (−11 per
episode, no dangle, no contact with the far segment), the right hand never moving.
Two numbers explain it. This gait's hops are long — p50 226 mm, p90 307 on lesson 1
— so the opener lands past the last seat (317 mm) into the gap every time, and the
hand never retreats the 5–10 cm to a seat: no lesson had ever asked a hand to land
*short* of somewhere. And crossing from the last seat with the partner still at its
start asks the arms for 0.54 m plus the gap — 0.66 m on lesson 1.5 against the
0.67 m static limit, which is why the mac16 hook stopped 38 mm short of the far
segment, and 0.79 m on lesson 2, which cannot be lunged at all. The climb the user
described — lead hand to its last seat, trailing hand up beside it, then across — is
the only way through lesson 2, and it starts with stopping. Three lessons were
added: **1.1**, one continuous rung ending 3 cm past the left hand's goal, which is
one ordinary opener from its start (land on the last seat or hang half off the
end); and **1.2** and **1.35**, gaps of 0.04 and 0.08 m, so the reach a lunge needs
rises 0.58 → 0.62 → 0.66 → 0.79 instead of jumping from a continuous rung to the
limit.

Checked (`mac20`, 4M, 8 envs): −2 100 %, −1 95 %, 0 92 %, 1 90 %, **1.1 at 98 %**
within 0.4M steps of its unlock (the left hook lands at 0.35–0.41 for a last seat
at 0.388), and lesson 1.2, unlocked at 3.7M, at 0/40 in training but with the climb
the user described on the replay after 0.3M steps of exposure: left hand to the
last seat (+0.32), right hand up beside it (+0.02), left across the gap (+0.39,
+0.47, +0.57), right following (+0.08, +0.20, +0.28) — one full success in 10, a
hand seated on the far segment in 3 of 12. Out of steps, not stuck — or so it
looked. Resumed to 7M: 1.2 still 0/40 and **lesson 1 down to 20–38 %**. On the
replay the climber's order is there in every episode (left to the last seat +0.32,
right up to +0.02, left over +0.44, +0.51, +0.60, right +0.10, +0.16, +0.25) — in
steps of 5–9 cm. The policy that had just learnt to land short took short steps
everywhere: lesson 1.2 asked for 1.4 m over two gaps and it managed 0.5 m in 60 s;
lesson 1 took 1490 steps for its 1.1 m and timed out too, the right hand re-seating
57 times per episode. A lesson that never passes keeps its warm-up share, so the
crawl kept teaching. Lessons 1.2 and 1.35 now ask for one crossing each — goals on
the segment just across the gap, 0.6 m of travel — and leave the two-gap traverse to
lesson 1.5.

Resumed to 10M with that: −2 92 %, −1 98 %, 0 98 %, lesson 1 back to **85 %**,
1.1 95 %, **1.2 at 90 %** (10/12 and 22/24 in two audits, 216 steps per crossing,
the climber's order in every episode: left to the last seat +0.35, right up to
+0.11, left over +0.39 → +0.48, right following +0.27), 1.35 unlocked at 12 %. The
user's read of the slow video — a hand grabbing the gap between the segments, a hand
reaching without lifting — asked why a robot with SLAM, IMU and encoders does that.
Measured at those moments: half is the policy (it *knew* the hook was in the gap,
16 mm of error, and lifted 14–23 mm, not enough to clear the end), and half was the
estimate, which during the climb — not on a still hang — was 36 / 80 mm off and put
the hand "on a seat" while it was in the gap 7.5 % of the time. Split into parts,
the free hand's error was the attitude (see the reward table): the IMU triad the
filter leaned on reads 18–30° under the impacts of a climb. Referenced to the SLAM
attitude instead: 0.2° / 1–3°, the hand 13 / 40 mm, the false seat 2.7 % — on
replay. What that did to training is the bisect below.

Resumed to 13M with that estimator: 1.35 unlocked and reached 28 % — and then
lesson 1 fell from 92 % to **5 %** in 2M steps, 1.2 from 90 to 52 %, the third
such swing in one run. Not the estimate (15 / 25 mm, 0.2° on this policy) and not
one lesson's exploit: on lesson 1 the right hand was off the wall 68 % of the time
taking the 40–66 mm lifts lesson 1.35 was teaching, and half the episodes fell.
Seven lessons of a 145-dim observation in SB3's default 64×64 network, updated on
2048 steps at a time (one to four episodes of a 60 s lesson), and the policy swings
between the lessons instead of holding them. The two obvious stabilisers were
tried and both killed the early curriculum: 8192 steps per update left lesson −1
at 0 % for 4M steps (`mac21`), a 256×256 network left lesson −2 at 0 % for 1.5M
(`mac22`), against 0.14M and 0.1M with the defaults. What is in now is the
standard PPO recipe the runs had been missing — the learning rate decays linearly
to zero over the run — so the early lessons learn at full speed and the late
updates, where the pool is large, are small; and the `best_` checkpoint keeps the
peak (mac20's, at 11.1M: −2 100, −1 98, 0 90, 1 92, 1.1 100, 1.2 90, 1.35 22 %).
And then the estimator that was right on replay turned out to be one a policy
cannot learn *from*: six fresh runs with the SLAM attitude and/or `SLAM_TAU` 0.3 s
never learnt lesson −1 (0 % for 1–4M steps), while the same code with the triad
attitude and 1 s passes it in 0.3–0.4M. The bisect, 1M steps each:

| estimator | lesson −1 |
|---|---|
| A: triad attitude, `SLAM_TAU` 0.3 | 0 % at 1M |
| B: SLAM attitude, `SLAM_TAU` 1.0 | 0 % at 1M |
| C: triad attitude, `SLAM_TAU` 1.0 | passed at 0.3M, lesson 1 by 1M |
| D: as B + a variance floor in VecNormalize | 0 % at 1M |
| E: as C + the floor | passed at 0.4M, **lesson 1.2 unlocked by 1M** |

A trained policy (mac19) solves lesson −1 12/12 under all of them with the same
reward; the reward is ground truth in all of them; the failing policies move the
left hand forward and dangle the right, lesson −2's behaviour. The variance floor
(1 cm; a feature whose std the estimator's accuracy had shrunk to 0.6 mm was
being normalised to the ±10 clip) was the first hypothesis and is not it, though
it stays, since E was the fastest early curriculum of any run. The mechanism is
open. The training estimator is C's. The SLAM attitude is the thing to try once a
policy has passed the gap lessons, the way mac20 took it at 10M; it left the sensor
model when the SLAM got its drift, rate and lag (2026-09-30), and comes back as a
rotation error beside `slam_drift` in `rl/climb_task.py`.

With the sampling fixed, the curriculum finally runs: `mac26` (2M steps, 8 envs)
went −2 → **lesson 2** — 1.1 at 98 %, 1.2 at 98 %, 1.35 at 92 %, **1.5 at 78 %**
after fifteen million steps of 0 % in earlier runs, lesson 2 unlocked and at 20 % —
and on lesson 1.5 the audit is 11/12, both hooks seating on both far segments. It
was the run that left lesson −1 behind, which is what the shipped rule fixes.

Two more things the 13M replays showed,
both the policy's:
on lesson 1.2 the left hand sometimes seats on the very edge of the far segment
(0.40–0.45) and holds, which leaves no room for the right hand's goal at 0.45
behind it, and the pair waits out the episode; and on 1.35 the left hand reaches
across (83 % off the wall) without landing — the right hand up beside it first,
which it does on 1.2, it does not yet do on 1.35.

## `win11`: the best policy this project has had, and the run that ate it

15.3M steps on the pool through lesson 2, and the two checkpoints tell opposite
stories. At **8.0M** (`best_model.zip`): −1 98 %, 0 100 %, 1 98 %, 1.1 98 %,
**1.2 100 %**, **1.35 92 %** (10/10 in audit), **1.5 52 %** — a hand on both far
segments, the climb the user described, and the first policy to get there. At
15.3M: 1.5 and 2 at 0 %, 1.35 at 12 %, −1 at 28 %.

It is not undertraining, and the action std is the thread. 0.48 at the peak, 1.33
at the end, 4.24 on one joint — and the *deterministic* policy fails too (0/10 on
lesson 1.5, 2/10 on lesson 1), so what degraded is the mean, not the sampling.
Once most of the pool is failing, every action is about as bad as every other, the
advantage signal flattens, and `ent_coef` is the only term left with an opinion:
it pays for noise, the noisier policy fails more, and the loop ran for the last
7M steps. SB3 starts log_std at 0 (std 1.0) and every good run here came down from
it to 0.3–0.6, so nothing legitimate needs more: `BoundExploration` clamps log_std
to at most its starting value after every rollout. Asserted (std forced to 4.06,
back to 1.00 after one update), and checked by resuming the 8.0M checkpoint with
it for 1.2M steps: std 0.46–0.48 with the cap binding at 1.00, lesson 1.2 at
100 %, 1.35 at 90–98 %, 1.5 oscillating 20–52 %, lesson 2 unlocked again, and no
collapse. The swings between lessons are still there; the spiral is not.

After a run has degraded, `--resume --from-best` continues from `best_model.zip`
rather than from the wreck.

## `win11 2`: the cap holds, the pool does not, and a crossing nothing had taught

Four million steps resumed from win11's 8.0M peak, with `BoundExploration`. It
worked as designed — std 0.46 → 0.52 with the cap binding at 1.00, no spiral — and
the run still did not improve: the best score stayed at 7.30 for the whole 4M and
lesson 1.5 went 55 % → 8 %, lesson 0 100 % → 40 %. What is left is interference:
nine lessons through one 64×64 network, and what one lesson gains another pays.
Narrowing the pool to the four that matter (`--resume --lessons 1.2,1.35,1.5,2`)
for 1.5M steps holds them instead — 1.2 95 %, 1.35 98 %, 1.5 oscillating 25–60 %
and ending at 57 % rather than collapsing.

Lesson 2 stayed at 0 % throughout. A crossing is a reach from the last SEAT of one
segment to the first seat of the next: 185 mm on lesson 1.5 and **315 mm on lesson
2**. The policy that has to attempt it never produces a step that long — 447 hops
measured on the 8.0M checkpoint, median 43 mm, p90 185 mm, longest 300 mm, and
**not one** at 315 mm. That is a statement about the gait it has learnt, NOT about
what the robot can do: the arms span 671 mm, the hands would be 435 mm apart on
landing, and pulling up on the holding arm, shifting the torso across, or swinging
the body all extend the reach further. (An earlier version of this section called
lesson 2 geometrically blocked. It is not; the user was right to reject that.) The
lesson is that a curriculum step should sit inside the distribution the current
gait actually samples, which is what lessons 1.2 and 1.35 did below it — they went
from never to 90–100 %. Lesson **1.7** (one 0.18 m gap, a 245 mm crossing, made by
1–2 % of this policy's steps) now sits between 1.5 and 2.

## The elbow pointed inward, and why the hook was the reason

The user watching a pull-up: the elbows fold *inward*, across the body, where a
person's go out or forward. Measured on the 8.0M policy over the steps where a hand
is loaded and the torso is rising (lesson 1.35): the right elbow sits **44 mm
inboard** of the shoulder-to-wrist line on average, 107 mm at p10, inward on 68 %
of steps — and the shoulder rotation reads **±90°, its own limit, on every one of
them**.

That last number is the thread. Raising the arm overhead is 160° of shoulder
flexion, which carries the hook round with it until its throat faces away from the
wall; bringing it back takes **175° about the arm's axis**. The forearm roll has
±85° (a human's pronation/supination, and correct), so the other 90° has to come
from the shoulder rotation, which is therefore pinned at its stop. And the shoulder
rotation is exactly what aims the elbow's hinge: at ±90° that hinge points at the
wall, so flexing the elbow sweeps the forearm sideways and the elbow bulges toward
the midline. Searching every posture whose hook orientation is within 15° of the
one that latches, the most outward elbow available was still 88 mm *inboard*: with
that mounting the human posture did not exist.

The fix is the mounting, not the joint limits: the hook bodies are rotated 180°
about the forearm axis (`quat="0 0 0 1"`), and the hang keyframe recomputed —
shoulder rotation 0° and forearm roll ∓5° reproduce the old hook pose to 0.2°, with
the throat still on the rung to 2 mm. Everything the code reads in hook-local
coordinates (`THROAT_PT`, `THROAT_X/Z`, the pads, the finger) rides along with it
and is unchanged. After it:

| | before | after |
|---|---|---|
| elbow hinge, in the torso frame | (0.94, 0, −0.34) — pointing at the wall | **(0, 1, 0)** — lateral, like a human's |
| flexing the elbow 120° moves it | 114 mm **inboard** | 172 mm **forward**, 8 mm sideways |
| shoulder rotation while hanging | ±90°, at the stop | **0°**, mid-range |

and the policy can now choose: rotation 0 puts the elbows forward, −30 to −60 puts
them out to the sides. Both are postures a climber uses. A fresh 1.5M-step run on
the fixed model unlocks −2 → 1.2 at the usual pace, so nothing about learning
changed.

**What it costs:** `controller/test_climb` went from failing one phase (8) to
failing five (3, 4, 5, 6, 8). The classical controller's servo weights were swept
empirically against the old arm posture — its own comment records the sweep — and
the new posture changes the Jacobian. Three values of `W_ALONG_COARSE` were tried
and none converged, so this is a re-tune of that stack, not a constant. The RL
side is unaffected and its own checks all pass.

## `win13`: 7.6M steps on the robot as it was before the fix

The run looked healthy — best at 3.79M with −1 100 %, 0 98 %, 1 95 %, 1.1 98 %,
**1.2 98 %**, 1.35 88 %, 1.5 22 %, faster than any run before it — and then every
replay of that checkpoint fell 12/12, on lessons it was scoring 98 % on. The
checkpoint was not the problem. `urdf/lessons/*.xml` is generated and gitignored,
`xml_path` wrote a scene only when the file was **missing**, and those files were
already on disk from the previous run. Pulling the re-mounted hook changed
`scene.xml` and nothing regenerated them: the run trained 7.6M steps on the old
robot, elbows and all. Replaying the same checkpoint against the pre-fix scene
scores **12/12** on lesson 1.2 and confirms it.

The scenes now carry a stamp — a hash of `scene.xml`, the lesson's own spec and
the patch lists — and `xml_path` rewrites any file whose stamp does not match, so
a model edit cannot silently fail to reach training again. Worth saying plainly:
the only reason this was caught is that a checkpoint was replayed and the numbers
disagreed with the training log. A generated artefact that is only checked for
existence is a place where a fix goes to die.

## `win15`: the fixed robot climbs, and the pool is what holds it back

11.5M steps on the re-mounted hook with the wrist back at ±25°, and the model
edits did what they were for. In the learnt gait on lesson 1.2 the shoulder
rotation sits at −1° (left) and +58° (right) — mid-range, where the old mounting
pinned it at ±90° — the elbows point outward on **100 %** of loaded, rising steps,
and the wrists sit at +21° / +8° with no jamming (`win14`'s right wrist had lived
at its +80° stop). Replaying the best checkpoint: lesson 1.2 **10/12**, lesson
1.35 **10/12**, lesson 1.5 2/12 with both hooks reaching the second far segment
and a hand closing to 40 mm of its goal. On 1.5 the seats alternate the way the
user described — left +0.29, right +0.20, left +0.48, right +0.24, left +0.57 —
so the technique is there; the finishes are not.

What the run also shows is where the ceiling is. The best checkpoint is at 6.78M
and **4.7M further steps did not beat it**: lesson 1.5 went 10 % → 8 %, lesson −1
fell to 48 %. Resuming that checkpoint on the hard lessons only
(`--lessons 1.2,1.35,1.5,1.7,2`) moved 1.5 from 10 % to **22 % in 0.8M steps**
before swinging back to 2 % — eight lessons through one 64×64 network is the
limit, not the number of steps.

That experiment also found a hole in the safety net. `score` sums the success
rates over the **active** lessons, so a best of 6.35 earned over eight of them can
never be beaten by three: `best_model.zip` was frozen for the whole narrowed run
and the 22 % policy was thrown away. Narrowing the pool on a resume now resets the
bar, so the peak of a narrowed run is kept.

## `win15 2`: the narrowed pool doubles lesson 1.5, then 7.7M steps eat it

Resumed from `win15`'s best (6.78M) with the pool cut to 1.2 / 1.35 / 1.5, 9M
further steps, ending at 15.77M. The best-score reset works: `best_model.zip` was
written this time, at **8.03M**, scoring 2.475 over the three lessons — 1.2 at
100 %, 1.35 at 100 %, **lesson 1.5 at 47 %**, against 10 % when the eight-lesson
pool was training it. Replaying that checkpoint: 12/12, 11/12, **5/12**.

Then it went backwards. 7.7M steps after the peak lesson 1.5 reads 17 % and
replays **1/12** — six of the twelve now time out. The mechanism is in the action
std: at the peak the mean is 0.469 with no dimension at the `BoundExploration`
ceiling; at the end it is 0.610 with **3 of 17 dimensions pinned at 1.0** and ten
above 0.8. The cap stops `win11`'s explosion to 4.24, it does not stop the drift,
and the policy degrades as it drifts. `ent_coef` is the term pushing it there.

The 53 % that fail at the peak fail one way, and it is not a bad grab. The
**trailing hand plants and will not let go**: over six episodes the right hook is
loaded and rising for 1683 steps against the left's 399. In five of eight episodes
the left hand walks out to full span and then re-lands on the *same seat* over and
over — +0.43 four times, +0.60 six times — while the right sits at −0.11 on the
start rung under 146–162 N with the finger closed, for all 1490 steps. The
successes look completely different: left +0.18 +0.29 +0.44 +0.60 +0.73 +0.91
+1.04, right −0.10 +0.19 +0.36 +0.43 +0.45 +0.64 +0.77 — proper hand-over-hand.
The policy is bimodal, not confused. The two outright falls both happen at the
last gap, at `rung_seg2` y ≈ 1.03–1.26, with the trailing hook catching the edge
rather than a seat, 42–49 mm off the rung axis.

The obvious suspect for a freeze is that timing out had become the cheap exit —
`win5` all over again. Measured on the peak checkpoint over 14 episodes, it has
not: success pays **+16.6**, a timeout **−17.0** and a fall **−18.8**. Freezing is
worth 1.8 points more than falling and 34 less than climbing. The shaping is doing
its job; what is missing is that the policy will not spend the exploration to
unweight a 160 N anchor. That is an optimization problem, so the next run turns
`--ent-coef` down to 3e-4 rather than touching a reward constant.

The model edits still hold at 15.77M: elbows outward on **100 %** of loaded rising
steps on both arms, shoulder rotation −43° / +64°, and no wrist within reach of
either stop under load (0.3–5.6 % of steps past ±25° while loaded).

## `win17 2`: the log names the drift — the action noise collapses and every update grows with it

Resumed from the 9.87M peak with the guard and the 70 % gate, to 20.0M, with the
console kept for the first time. The rules did their jobs. At 3e-4 the pool
drifted again inside 1.7M steps (lesson 1.5 62 % → 15–45 %); the guard went back
to the peak at 12.77M and halved the rate. From there nothing was forgotten:
1.85 reached 70 %, lesson 2 unlocked at 15.4M, and the best rose to 9.38 over all
eleven lessons at 19.44M. Deterministic, 20 each:

| lesson | 9.87M | 14.8M (old run) | 20.0M |
|---|---|---|---|
| −2 … 1.35 (seven lessons) | 134/140 | 130/140 | 138/140 |
| 1.5 | 13/20 | 11/20 | 12/20 |
| 1.7 | 20/20 | 15/20 | 16/20 |
| 1.85 | 12/20 | 12/20 | **17/20** |
| 2 | 0/20 | 2/20 | 1/20 (12–25 % sampled) |

The log is what the checkpoints could not show. **Every update was rewriting the
policy**: approx_kl 0.2–1.1 per update and a clip fraction of 0.5–0.8, against
the 0.01–0.03 and 0.1–0.2 of a usual PPO run. KL climbed in step with the policy
entropy, which fell in a straight line and never levelled: +2.5 → −3.5 nats before
the rollback, +2.4 → −7.7 after it. The halved rate slowed the slide and did not
stop it. The cause was in the checkpoint: six action dimensions had collapsed to a
std of 0.02, the right shoulder's three joints, its forearm roll and finger, and
the left wrist deviation. They were 0.09 at the peak. A Gaussian's KL goes as
1/std², so a tiny change to those means reads as an enormous update. Most samples
then hit the clip, and the gradient comes from the few that do not. By 20M the run
sat at KL ~1, the regime that had come just before the drift at 12M.

The fix is the one robot-learning PPO uses (`train_ppo.py`, both in the
self-check):

- **a floor on the action std**, 0.05 (`STD_MIN`), on top of the existing 1.0
  ceiling. That is 0.003 rad of setpoint noise per step. Sampled with the floor,
  the 19.44M policy did as well as without it: 1.5 14/20 against 13/20, 1.85
  14/20 against 10/20.
- **a KL-adaptive learning rate** (`AdaptiveLR`, rsl_rl's rule): ÷1.5 when an
  update's KL passes twice the run's KL target, ×1.5 under half, never above 3e-4.
  The target starts at `KL_START` 0.1 — where `win17` spent 2.5M steps improving
  and forgetting nothing — and **the guard halves it on every rollback**, down to
  `KL_MIN` 0.01. Small updates are what stops the forgetting and they are also
  what makes a lesson cost millions of steps, so a run takes the biggest step
  that has not yet cost it a lesson instead of a small one forever. (The guard's
  `LR_DECAY` alone no longer sticks: with an adaptive rate, a halved rate is
  pulled back up within a few updates. The target is the knob that lasts.)

Resumed from 19.44M on this Mac, the floor lifted the entropy from −7.5 to −3.3
and it stayed flat. At the 0.1 target the rate settles at 6.7e-5 with KL 0.09–0.12
and a clip fraction of 0.49; at 0.02 it would settle at 2e-5, KL 0.03, clip 0.25.
Over 0.5M steps at the tighter of the two nothing slipped — lesson 1 92 %, 1.5
60 %, 1.85 68 %, lesson 2 25 %, no guard trip. On a fresh run KL is 0.017 at
3e-4, so the rate never moves there and the early curriculum trains as before.

**Next:** resume from the best and leave it:

```
python -m rl.train_ppo --name win17 --resume --from-best --lessons=-2,-1,0,1,1.1,1.2,1.35,1.5,1.7,1.85,2 --envs 12 --steps 30000000
```

### How long the rest of the curriculum takes, and what makes it shorter

Measured on the user's Windows box: **1484 steps/s** with 12 envs, 10.1M steps in
2.0 h. So 50M steps is 9 h, 100M is 19 h, 200M is 37 h. The worry that this needs
billions of steps does not survive the arithmetic — the risk is a lesson that
stalls, not the clock. For scale, `win16` went from scratch to lesson 2 at 57 % in
5.75M steps on the old robot; `win17` needed 20M to get there because the drift ate
its progress three times over and the pitch-first arm has 0.56 m of reach instead
of the 0.68 m that let the old one lunge.

Three levers, in the order they are worth pulling:

1. **The update size, which now tunes itself.** The guard only tightens `KL_TARGET`
   when the pool has actually lost a lesson, so the run keeps the largest step it
   can get away with. Nothing to do.
2. **Network capacity.** Every run here has used SB3's default 64×64 for both nets,
   and eleven lessons through it is the standing suspect for the interference the
   guard keeps catching — rsl_rl's locomotion policies are 512-256-128. `--net
   256,256` is nearly free in wall clock, because the simulator is the bottleneck
   (cutting 90 % of the gradient work moved throughput by 0 %). It needs a fresh
   run, so it is an arm to put beside `win17`, not a change to it.
   Measured 2026-10-04, the 1.5M CPU canary on the lesson ladder, seed 0, one arm
   each: 256×256 held what it had learnt better (-2 100 %, -1 82 % against 85 % and
   48 %) and learnt the next thing slower (lesson 0 unlocked at 850k and still 0 %;
   64×64 had 0 at 88 %, lesson 1 at 72 % and 1.1 unlocked) -- the capacity trade, and
   on 12 envs' 3k-sample updates, not the GPU's 131k. So the CPU path keeps 64×64 and
   a fresh MJX run defaults to 256×256 (`MJX_NET`), where nine families share one
   policy and the net's cost is lost in the physics; `NET=64,64 bash rl/gpu_run.sh` is
   the other arm, still unmeasured on a GPU.
3. **Throughput.** More envs first (`python -m rl.bench` on that machine — the Mac
   gained 20 % from 12 → 20 envs). Then the real jump: MJX runs the physics on the
   GPU with thousands of envs in parallel and is where a 10–100× would come from.
   This model is two edits away from being MJX-ready (capsule collision geoms, drop
   the `jointlimitfrc` sensors), and it needs Linux or WSL2 with CUDA.

## `win17`: the pitch-first robot climbs, stalls at lesson 2, and runs now look after themselves

The first run on the rebuilt shoulder. At 14.8M its best checkpoint was 5M steps
back (9.87M, 9.03 over lessons −2…1.85), and those steps had bought nothing:

| lesson (deterministic, 20 each) | best 9.87M | latest 14.8M |
|---|---|---|
| −2 one left-hand step | 20/20 | **13/20** |
| −1 … 1.35 | 18–20/20 | 19–20/20 |
| 1.5 two 0.12 m gaps | 13/20 | 11/20 |
| 1.7 one 0.18 m gap | 20/20 | **15/20** |
| 1.85 one 0.25 m gap | 12/20 | 12/20 |
| 2 two 0.25 m gaps | 0/20 | 2/20 |

The gait is honest. Every hook leaves the rung (0 N) before it moves and seats
again with the finger in band (−33°), the holder does not slide, one hook always
carries load, and lesson 1 takes six grabs a hand. It is fast, 0.3 s a step, and
hard on the hooks: 480–640 N at the catch, 2.3–3× body weight.

Lesson 2 stalls at the deadlock described below: the lead hand reaches while the
trailing one is still ~0.2 m back from the edge, the hands span 0.46–0.49 m, and
the far segment stays out of reach. The robot can make that crossing — lesson 1.85
is the same gap and passes 60 % — the policy has not learnt to walk up first.
Meanwhile lesson 2 held ~30 % of the steps at 2 %, and the pool began to forget: on
lesson −2 the latest policy sometimes moves the right hand too, walks the whole
rung like lesson 1, and falls. It is not the action noise. Waist, left finger,
right elbow and left wrist flexion sit at or near the 1.0 cap, but sampling with
those four turned down to 0.2 did no better (lesson 1.5: 8/20 against 12/20).

**Two rules, so this needs no one watching** (`train_ppo.py`, both in the
self-check):

- The next lesson unlocks when **every** lesson in the pool is at 70 %
  (`UNLOCK_AT`), not the newest at 60 %. `win17` unlocked lesson 2 with 1.5 and
  1.85 at ~60 %.
- **The guard.** If the best checkpoint's own lessons score a whole lesson below
  that best (`GUARD_DROP`) for a million steps (now `GUARD_UPDATES`, 325 updates:
  the same million on 12 envs, and the same number of policy changes on any
  other rollout size), the run goes back to
  the best checkpoint — policy and optimizer, statistics, curriculum — and carries
  on at half the learning rate (`LR_DECAY`, never below `LR_MIN`, 1e-5). A lesson
  unlocked since the best does not count, so a new lesson's first failures cannot
  trip it. Resumed on a copy of `win17` with the guard shortened, it went back to
  the 9.87M state, left lesson 2 parked (1.5 and 1.85 were under 70 % there) and
  carried on at 1.5e-4. Update size is the untested suspect for every drift since
  `win11`; halving it on each rollback is the experiment `win16 3` asked for, run
  by the trainer instead of by hand.

Every run also appends its console to `out/<name>/train.log`, with the
`approx_kl`, `clip_fraction` and `explained_variance` that question has been
waiting on.

**Next:** resume from the peak and leave it. Lesson 2 comes back once 1.5 and 1.85
are both at 70 %:

```
python -m rl.train_ppo --name win17 --resume --from-best --lessons=-2,-1,0,1,1.1,1.2,1.35,1.5,1.7,1.85,2 --envs 8 --steps 30000000
```

## `win16 3`: the same decay a third time, and three 1M-step arms that all lose ground

Resumed from `win16 2`'s peak with the new −37° finger stop. The best checkpoint
landed at **6.098M — 5k steps after the resume** — and the 4.2M steps after it went
the same way as the two runs before:

| lesson | best 6.098M | latest 10.33M |
|---|---|---|
| 0 | 9/10 | 9/10 |
| 1 traverse | 6/10 | **10/10** |
| 1.2 hairline gap | 9/10 | 6/10 |
| 1.5 two 0.12 m gaps | 6/10 | 2/10 |
| 2 two 0.25 m gaps | 3/10 | **0/10**, 7 timeouts |

The grip fix was in effect and did what it was for: the stop reads −37°, the loaded
finger sits at −34° (p50), and holds count as holds on **99–100 %** of loaded steps
at the peak against 40–70 % before. The collapse happened anyway, which is what the
commit that made the fix already said it could not rule out.

**The decay is selective, in both of the last two runs.** Lessons with no gap hold or
improve — lesson 1 *ended* at 10/10 — while every lesson with a gap rots. The
collapsed gait is the same freeze: on lesson 1.5 the left hook carries load on 29 %
of steps and keeps landing at y 0.42–0.43, in the gap between seats.

**Three arms, 1M steps each, from that same 6.098M peak.** One keeps the learning
rate at 3e-4, one drops it to 5e-5, one keeps 3e-4 but narrows the pool to the six
gap lessons:

| replay after 1M | start | lr 3e-4 | lr 5e-5 | gap lessons only |
|---|---|---|---|---|
| 1 traverse | 6/10 | 9/10 | 7/10 | — |
| 1.2 | 9/10 | 8/10 | 8/10 | 9/10 |
| 1.5 | 6/10 | 7/10 | 7/10 | 7/10 |
| 2 | 3/10 | 3/10 | 6/10 | 2/10 |

Three things come out of it. **1M steps cannot see this failure**: no arm collapsed,
and all three sit at or above the checkpoint they started from, while `win16 3` took
4.2M steps to reach 0/10. So the lr question is still open — 6/10 against 3/10 on
lesson 2 is one arm of ten episodes, not a result. **Narrowing the pool did not
protect anything**: lesson 2's logged rate fell 80 % → 48 % and lesson 1.5 72 % →
48 %, so `win15 2`'s narrowed-pool lift did not replicate. And **every arm reached
its best score within 2–6k steps of resuming and never beat it again** — gapC's best
is stamped at step 6,097,988, six steps in. Counting the user's runs, that is now six
resumes in a row where continuing from a peak buys nothing.

One more detail worth keeping: the logged (stochastic) rates fall inside 1M steps in
every arm while the deterministic replays hold. The training metric goes first and
the mean policy follows, which is why a run looks broken in `rl.status` long before
a replay agrees.

**Next:** the experiment has to match the timescale. From `win16 3`'s best, two arms
of **4M steps**, 3e-4 against 5e-5, on the machine that can run them, and this time
keep the console output — `approx_kl`, `clip_fraction` and `explained_variance` per
update are the one piece of evidence a checkpoint cannot reconstruct:

```
python -m rl.train_ppo --name w16lrA --resume --from-best --lessons=-2,-1,0,1,1.1,1.2,1.35,1.5,1.7,1.85,2 --envs 8 --steps 4000000 > w16lrA.log 2>&1
python -m rl.train_ppo --name w16lrB --resume --from-best --lessons=-2,-1,0,1,1.1,1.2,1.35,1.5,1.7,1.85,2 --envs 8 --steps 4000000 --lr 5e-5 > w16lrB.log 2>&1
```

Copy `win16 3/best_*` into `out/w16lrA` and `out/w16lrB` first, so both arms start
from the same policy. Until that says otherwise, the policy to keep and to show is
`win16 3/best_model.zip`.

## `win16 2`: without lesson 3 it still collapses, and a finger stop with no margin

This run resumed from `win16`'s 5.75M checkpoint with the pool capped at lesson 2,
so lesson 3 never entered it. The best checkpoint came 343k steps in, at **6.09M**,
and is the best policy yet: lesson 2 at 78 % logged and 7/10 in replay, lesson 1.5
at 7/10. By 11.36M the gap lessons had collapsed anyway:

| lesson | best 6.09M logged | best replay | latest 11.36M logged | latest replay |
|---|---|---|---|---|
| 0 | 92 % | 10/10 | 92 % | 9/10 |
| 1 traverse | 90 % | 9/10 | 52 % | 7/10 |
| 1.2 hairline gap | 100 % | 7/10 | 18 % | 2/10, 5 timeouts |
| 1.5 two 0.12 m gaps | 72 % | 7/10 | 0 % | 0/10, all timeouts |
| 2 two 0.25 m gaps | 78 % | 7/10 | 0 % | 0/10, all timeouts |

That settles what the `win16` A/B left open: **lesson 3 is not the cause**. Nor is
the input normalisation this time. No input drifted by more than 0.26 sd, the best
model with the latest statistics still passes lesson 1.5 4/5, and the latest model
with the best statistics passes 0/5.

**The collapsed policy freezes.** On lesson 1.5 the right hook carries the load on
100 % of steps and lets go 0–2 times an episode. The left hook carries it on 0–4 %:
it slaps at y 0.33–0.54, the edge and gap between `rung_start`'s last seat (0.32)
and `seg1`'s first (0.50), and never seats. The critic is flat at −4.4. The same
freeze is already present at the peak, in 1 episode of 8. On those left-hand touches
the finger is **open**: +6.5° on average against −32.5° at the peak, in band on 11 %
of loaded steps, and left-hand grabs fell from 14.6 to 0.2 per episode. The finger
is a symptom, though. Driving only the latest policy's left finger with the peak
policy's command brings left grabs back (0.4 → 7.2) but not one success in 5, and
giving the peak policy the latest's left finger still passes 4/5.

**What the collapse did expose is a real defect in the hold test.** The finger
setpoint stopped at −40°, exactly on `GRIP_BAND`'s closed edge. The table above says
that makes a full squeeze count as a grip, but there was no margin for it. A hook
whose setpoint sits on the stop reads 0.5–2.5° past it whenever the rung is not
pressing the finger open. On the collapsed policies the right hook read −41 to
−42.5° on 71–78 % of loaded steps, with 93 N of contact and 0.69 mm of slide per
step against 97 N and 0.91 mm in band. Those are real holds, yet `_holding`,
`_confirmed` and `_touching` all said no: no grab, no bank, no success, no anchor.
Even the peak policy lost 18 % of its left hook's loaded steps on lesson 2 this way.
It reproduces with no policy at all: a 60 N push along the rung hands one hook's
weight to the other, and the unloaded hook on a −40° stop leaves the band on 20
steps out of 300.

The stop is now **−37°**, still deep in the >1200 N band. The same push reads 0
steps out of band at −38° and at −37°, and a new self-check holds it there. With the
new stop, the collapsed policies' loaded holds count 100 % (up from 40–70 %). The
peak policy goes 5/8 → 6/8 on lesson 1.5 and 7/8 → 5/8 on lesson 2, within noise
either way. The fix does not revive a collapsed policy, which still succeeds 0–1
times in 5. It corrects what the reward and the map see; it has not been shown to
prevent the drift.

**Still open:** why every long run from a peak (`win15 2`, `win16`, `win16 2`)
drifts into a failure mode that was already a minority at the peak. It is not a
lesson, not the normalisation, and not entropy: the left finger's std is 0.07. The
untested candidate is update size, a constant learning rate of 3e-4 with no KL limit,
applied for millions of steps to a policy that is already good. SB3's console log
records `approx_kl`, `clip_fraction` and `explained_variance` on every update, and
that is the evidence to look at next.

**Next:** resume the 6.09M checkpoint with the new stop and lesson 3 still out. Keep
the run short, so the peak is checked before it can drift far:

```
python -m rl.train_ppo --name "win16 2" --resume --from-best --lessons=-2,-1,0,1,1.1,1.2,1.35,1.5,1.7,1.85,2 --envs 8 --steps 3000000
```

## `win16`: from scratch to the best policy yet in 5.75M steps, then 9.5M steps undo it

A fresh run on the full pool with lesson 1.85 in it. Its best checkpoint, at
**5.75M**, is the best policy this project has had — and it got there in a third of
the steps `win15` needed. The 9.5M steps after it destroyed it:

| lesson | best 5.75M, logged | best, replay | latest 15.26M, logged | latest, replay |
|---|---|---|---|---|
| −1 step right hand | 100 % | 10/10 | 38 % | 0/10, 7 timeouts |
| 1 traverse | 82 % | 8/10 | **3 %** | 0/10, all timeouts |
| 1.85 one 0.25 m gap | 82 % | 10/10 | 20 % | 1/10 |
| 2 two 0.25 m gaps | **57 %** | **5/10** | 0 % | 0/10 |
| 3 climb up | not unlocked | 0/10, 9 falls | 0 % | 0/10 |

The replays are deterministic, so the mean policy degraded, not the sampling. On
lesson −1 the latest policy ends 0.69 m from its goal against 0.30 m for doing
nothing at all. This is not under-training: the best checkpoint is 9.5M steps
behind the end and nothing after it came close.

**What changed between them is lesson 3.** The best checkpoint's pool stops at
lesson 2; lesson 2 crossed 60 % shortly after and unlocked `climb_up`, the first
lesson with a goal *above* the robot. Two mechanisms looked responsible.
A 600k-step A/B from the best checkpoint says neither explains the collapse.

**1. On lesson 3, letting go became the rewarded action.** The critic of the best
checkpoint, read along lesson-3 episodes: every state where the robot is still
holding on is worth **−18.5**, the fall is **−10**. A release that ends in a fall is
therefore scored at an advantage of about **+8.5** — PPO is paid to let go. The
per-term split of a lesson-3 episode says why: an attempt that does not fall pays
−58 to −118 over its 90 s, mostly loaded-hook slide (−20), grip fight (−12) and
effort (−11), while a fall pays −25. Raising `FAIL_R` would not have fixed this. On
a lesson the policy cannot yet pass, falling now instead of falling later saves
exactly the costs it would pay before falling. That saving does not depend on the
size of the fall penalty. The incentive self-check never saw it because it only
checks lesson 1. Hanging perfectly still to the timeout already costs **−11.96 on
lesson 3 and −16.0 on lessons 4–9**, all past `FAIL_R`, because every lesson from 3
on runs 90–120 s instead of 60.

**2. The input statistics drifted, but not the way it first looked.** `VecNormalize`
keeps one running mean and variance per observation, shared by all lessons. Between
the checkpoints only inputs 93 and 96 — the vertical offset from each hand to its
goal — moved by more than one standard deviation, their sd stretched 4× by lesson 3.
That looked like the culprit, and it is not. Swapping the statistics block by block
on the best model (deterministic, 8 episodes each):

| normalisation | lesson 1 | lesson 2 |
|---|---|---|
| best, as trained | 6/8 | 4/8 |
| latest, all of it | 3/8 | 0/8 |
| best, only goal-z from latest | **8/8** | **5/8** |
| best, layout block (91–142) from latest | 3/8 | 6/8 |
| latest, layout block from best | 6/8 | 2/8 |

The goal-z stretch on its own changes nothing. The damage is spread thin: the
layout block costs lesson 1 and the proprioceptive block costs lesson 2. A swap also
drops 9.5M steps of drift onto a frozen policy at once, where training lets the
policy follow it. The latest model with the best statistics still fails lesson 1
(0/8), so the policy degraded on its own. Pinning one block of statistics would
not have protected this run.

The collapsed gait is not a freeze. On lesson 1 the right hook lets go **70.8 times
an episode** against 6.5 at the peak, and the left carries the load 77 % of the
time. It is a flutter that times out. The action std went 0.359 → 0.477, with 4 of
17 dimensions pinned at the cap against none.

**What a controlled test says.** Both mechanisms came from snapshots, so both were
tested from the same 5.75M checkpoint: 600k steps per arm, lesson 3 in the pool (it
unlocked early in both arms). The fix tried for mechanism 1 charged a fall the
discounted cost of the steps it skipped, `FAIL_R − cost_ema · 1/(1−γ)`. On paper
that makes the timing of a fall irrelevant at any cost rate.

| after 600k steps | control, reward unchanged | with the fall charge |
|---|---|---|
| lesson 1 replay | **10/10** | 3/10, 7 falls |
| lesson 2 replay | 3/10 | 6/10 |
| lesson 1.5 in training | 25 % | 60 % |
| lesson 1: free hook more than 150 mm above the rung | 0 % | 38.6 % of free-hand steps |
| lesson 3 critic: still holding vs a fall | −3.9 vs −10 | −8.2 vs −19.3 |

The unchanged reward climbed out of the trap on its own. Its critic went from −18.5
to −3.9 per holding state, above the fall, within 600k steps, and nothing collapsed:
lesson 1 stayed at 10/10. The −18.5 at unlock was a transient of first exposure,
not what took lessons 1 and 2 apart over the following 9M steps. The charge helped
nowhere it could be shown. It doubled the cost of a fall on lessons that already
worked (−21.0 on lesson 1 against −10). In its run lesson 1 fell 7 times in 10 and
the free hook reached up past the rung on 38.6 % of steps, which the control never
did. One run per arm cannot call that harm, but it is not enough to ship. The
change is parked on the local branch `fall-charge`.

So what undid `win16` is still open. It is not an immediate effect of unlocking
lesson 3, because the control held every flat lesson for 600k steps after the
unlock. It is not the goal-z stretch. It took millions of steps. Three candidates
fit and are untested: twelve lessons through one 64×64 network (the swings
`train_ppo` already documents), lesson 3 sitting at 0 % on 15 % of the steps for
9M steps, and the action std drifting to the cap (4 dimensions pinned by the end).

**Next:** keep lesson 3 out of the pool and push lesson 2 up from the 5.75M
checkpoint. The pool matches that checkpoint's active set, so the 9.775 bar stays.
On Windows the pool must be written with `=`:

```
python -m rl.train_ppo --name win16 --resume --from-best --lessons=-2,-1,0,1,1.1,1.2,1.35,1.5,1.7,1.85,2 --envs 8 --steps 10000000
```

The experiment that would settle lesson 3 is the long version of the A/B above: the
same checkpoint with and without lesson 3 in the pool, several million steps each,
watching lessons 1 and 2.

## `win15 3`: lesson 2 crossed, and a flag that was never doing anything

10M steps from `win15 2`'s best (8.03M), ending at 18.03M with the best at
**16.84M**. It is the furthest this project has got, by a distance:

| lesson | logged | replay of the best |
|---|---|---|
| 1.2 hairline gap | 97 % | 10/12 |
| 1.35 narrow gap | 85 % | 10/12 |
| 1.5 two 0.12 m gaps | **60 %** | 7/12 |
| 1.7 one 0.18 m gap | **88 %** | 7/12 |
| 2 two 0.25 m gaps | **35 %** | **3/12** |

Lesson 1.5 finally cleared the 60 % bar, which unlocked 1.7, which cleared it too
and unlocked **lesson 2 — passed for the first time in this project**. It is worth
being precise about what that claims, because `_success` is strict: both hooks
seated on a *goal* rung, each within `LATCH_TOL` = 150 mm of its own goal point,
both holding under contact force, and each hand having taken at least one real
hold along the way. On lesson 2 the goal rung is `rung_seg2`, so a success is both
hands across **two 0.25 m gaps** and seated at the far end. There is no version of
that a ratchet or a one-handed drag can fake.

**The freeze is breaking.** `win15 2` failed lesson 1.5 by parking — the trailing
hook planted under 146–162 N while the lead hand re-landed on the same seat for
1490 steps. Measured on lesson 1.5, best against best: steps with **both hands
confirmed** went 12 % → **22 %**, anchor switches per episode 10.8 → 12.8, and
timeouts went 1 → **0** deterministic and 3 → **0** sampled. The policy stopped
parking and started attempting; some attempts fall, which is why lesson 1.5's
losses moved from timeouts into falls. That trade is the progress.

The estimator looks worse and mostly is not. Mean throat error on lesson 1.5 went
42 mm → 75 mm and the per-episode peaks 441 mm → 940 mm, which the end-of-episode
snapshots make look alarming — but the peaks are the fall itself, not its cause.
The number that decides a fall is whether the FREE hand's estimate puts it over a
seat when it is really over an edge, because that is the step where the robot
commits its weight. That rate is **flat: 4.1 % → 3.9 %**. The growth is all in the
harmless direction — a real seat read as an edge, 1.4 % → 3.4 % — which costs
hesitation, not a fall. The estimator is not what stands between 35 % and lesson 2.

**What does need fixing is that the last run's one experiment never ran.** The plan
after `win15 2` was `--ent-coef 3e-4`, to relieve an action std pressed against the
`BoundExploration` cap. Reading it back out of the checkpoint: `ent_coef = 0.001`.
`PPO.load` restores the saved value and only the *fresh* branch ever read the flag,
so on a resume `--ent-coef` did nothing at all, silently, for 10M steps. So the
whole of `win15 3`'s gain is more steps on the narrowed pool, and the entropy
hypothesis is still untested — std sits at 0.621 at the peak and 0.634 at the end,
with 3 and 5 of 17 dimensions pinned at the cap. The flag now applies on a resume
and the resume line prints the value it will actually train with.

One thing that did not happen this time: the run did not eat its own peak. The
latest checkpoint is 1.2M steps past the best and still within a few points of it,
against `win15 2`'s 7.7M-step slide from 47 % to 17 %.

## Why the lead hook crosses before the trailing one has walked up

Watching `win15 3`'s lesson-2 video the user asked the right question: in the
failed attempts the robot reaches for the next segment *before* advancing along
the one it is on, so the free arm stretches to its limit and still comes up short
— why not walk to the edge first, which is both closer and cheaper?

It is doing exactly that, and the split is clean. Taking each episode's best reach
— the step where the free hook comes nearest the next seat while exactly one hand
carries the load — over ten episodes of the best checkpoint:

| | holding hand vs its own seat edge | hand separation | free hook onto the next seat | outcome |
|---|---|---|---|---|
| 4 episodes | within **64 mm** of the edge | 417–573 mm | 115–235 mm | **both successes** |
| 6 episodes | **246–313 mm short** of it | 583–651 mm | 3–25 mm | 5 timeouts, 1 fall |

The arm span is about 671 mm, so the second group is reaching at full stretch, and
it arrives 3–25 mm onto a seat — the near edge, the catch that slips. Worse, it
strands the other hand: with the lead hook 4 mm onto `seg1` at +0.636 and the
trailing one back at +0.03, the trailing hand is 0.6 m from the gap it now has to
cross, and nothing can move. That is the deadlock behind every one of those
timeouts.

The energy half of the question is right too. Reaching at full stretch costs
**104.2 N·m** of total joint torque against **71.9** from close, 45 % more. But
`K_EFFORT` prices that difference at 0.0016 per step — about **0.24** over a
150-step reach — against 1.25 for the 250 mm of rung the hand left behind and a
20-point swing between success and failure. The robot's own effort term already
measures the waste; it is charged at roughly 1 % of what the decision is worth.

The fix is not a new penalty. Between 1.7 and 2 the curriculum changes two things
at once — the gap goes 0.18 → 0.25 m *and* one gap becomes two — which is the
double step the rest of these lessons exist to avoid, and the measurement says the
width is what breaks. **Lesson 1.85 is one 0.25 m gap and nothing else new.**

Adding it surfaced a second bug. `Curriculum` unlocked `pool[len(active)]`, an
index, so inserting a lesson into the middle of the pool on a resume left the
restored active set out of step with pool positions: with `active` =
[1.2, 1.35, 1.5, 1.7, 2] and 1.85 inserted, the next unlock was lesson **2 again**,
already active, and 1.85 would never have been trained. It now unlocks the first
pool lesson that is not yet active.

## The wrist: a hook's wrist is its grip, so it stays at ±25°

Asked to give the wrist a human range (−70° extension … +80° flexion, against the
±25° it had), the measurement decided both ends — and then a 20M-step run decided
the rest. Hanging on a rung and turning one wrist while reading the hook's contact
force:

| flexion (+) | 0° | +25° | +50° | +80° |
|---|---|---|---|---|
| hold | 44 N | 123 N | 167 N | 143 N |

| extension (−) | −25° | −40° | −55° | −60° |
|---|---|---|---|---|
| hold | 44 N | 20 N | 13 N | **0 N — off the rung** |

Extension unloads the hook — 70° of it is 70° of letting go, and a 1.5M-step run
with the full human range never passed the first lesson. So the extension stop went
to −30°. Flexion looked free: it wraps the hook tighter. It is not free, because
tighter is the problem. With the wrist flexed and the finger opened, the hook
should come off the rung; measured:

| wrist | hold | finger opened | arm lifted |
|---|---|---|---|
| 0° | 45 N | 0 N | 0 N — released |
| +25° | 58 N | 0 N | 0 N — released |
| +50° | 118 N | 0 N | **54 N — re-caught** |
| +80° | 118 N | **47 N** | **57 N — cannot let go** |

Past +25° the wrist locks the hook onto the rung, and `win14` (5.5M steps on
−30…+80) found the lock: on lesson 1 its right wrist sat at **+77° mean, at the
+80° stop 95 % of the time**, the right hand took **zero** holds in twelve
episodes, and lesson 1 stayed at 0 % for the 3.5M steps after it unlocked while
the left hand shuffled 37 times per episode. Every +80° configuration tried
stalled in the early curriculum (−70…+80, −30…+80, −25…+80); the one ±25° run on
the same fixed robot went −2 → lesson 1.2 in 1.5M. A human wrist has 150° of
travel because fingers do the gripping. A hook's wrist *is* the grip, and the
range where it can both hold and let go is the ±25° it had. Back to ±25°.

The elbow fix, measured in the same run, did what it was for: on lesson 0 the
shoulder rotation sits at −45° (left) and −4° (right) — mid-range, where the old
mounting pinned it at ±90° — and the elbows point outward on 94–100 % of loaded,
rising steps.

## `win8`: lesson 1 passed, and a 5° trap under the far ledge

10.8M steps on the curriculum with lessons −2 … 1.5. The best checkpoint, at 2.66M:
−2 95 %, −1 98 %, 0 95 %, **lesson 1 95 %** — two hands alternating, 18/20 in audit,
1.0 m in 194 steps — and lesson 1.5 at 1/40. Then 8M steps in which lesson 1.5 stayed
at 0 % and, drawn as often as the rest, pulled lesson 1 down to 32 % and the action
std to a floor of 0.04: the collapse the previous section warned about, at full
scale. Two things were wrong, one in the task and one in the curriculum.

On lesson 1.5 the free hand reached the far ledge — 35–78 mm from its axis by step
25–47 — and then hovered there for the rest of the episode, 96 % of the time off the
wall, while the estimate said the ledge was 200–320 mm away. The estimate was wrong
because the estimator's anchor had stayed on a hand that was moving: the other hand
was carrying 48–159 N and was not *confirmed*, and it was not confirmed because its
finger read −40…−44°. The finger stop sat at the cliff, −45°, and a policy that
squeezes as hard as it can lands just under the band's −40° edge — 90 % of loaded
steps on that lesson, 34 % on lesson 1. Physically a fine hold; to the reward and
the estimator, not a hold at all. The stop is now the band's edge.

And a freshly unlocked lesson is drawn `NEW_SHARE` (25 %) of the time until it is
being passed at `WARM_RATE` (20 %), so a lesson that fails for a while is a quarter
of the gradient, not half, and the pool keeps what it has.

The finger-stop fix then uncovered a pump that the −45° stop had been hiding: with
every touch in band, the 3M check run learnt to lift the right hand for one step
(credited its 30 mm of relative approach) and set it down loaded (the 30 mm back
neither debited nor, since the slide charge wanted load at both ends of the step,
charged) — 578 "holds" and 20 m of bank per episode. It is closed where it lives:
the credit is classified by the load at the *start* of the step, so the lift is
worth nothing and the touch-down debits its 30 mm (which left the mirror open — the
`win9` section). Two harsher closures were tried
first and each broke an honest gait — the reward table has them. Every gate a policy
can saturate its way past, it will; and every fine aimed at a pump lands on the
physics too.

Checked locally with all of it (3M steps, 8 envs): −1 at 0.14M, 0 at 0.25M, 1 at
0.46M, 1.5 at 0.68M; at 3M lesson 1 at 88 % in training and **12/12** in audit —
1.03 m in 138 steps, both hands alternating — with no collapse through 2.3M steps of
lesson 1.5 in the pool. On lesson 1.5 the pump is gone (−21 per episode, 2 holds by
the right hand), the estimate at the far ledge is right to ~50 mm, a hand seats on
the ledge in 11 of 20 episodes and one episode crossed both gaps. The holding hand
still sits 335–520 mm from its edge when the free hand reaches — the climber's order
is not learnt yet — but the events the credit needs are now happening.

## `win5`: the map became exact, and nothing moved

15.3M steps under the three rules above, lesson 1 only, **0 / 40** — the best
checkpoint is the first one. Not falling, either: all 30 audited episodes ran the
full 60 s.

| `win5` latest, lesson 1 | |
|---|---|
| gait | left hook on 100 % of the time; right hook flutters — let go and re-touch in place, 9–20 times per episode, enough for its `MIN_GRABS`; body moves 0.18 m |
| pose estimate | anchor **3–20 mm** off through the whole episode, free hand 9 mm mean (p90 16) on approach — reach odometry with a still anchor is as exact as promised |
| action noise (std) | 1.0 → **0.13** (win4 held 0.47): exploration was gone |
| reward, per episode | stale −14.7, time −4.5, effort −1.3, slide −0.8, dangle −0.8; bank **+0.9**, reach +0.3; total −22 |

Doing nothing cost −33 (stale −28.6, time −4.5) against −10 for a fall. The policy
found the cheapest place in that landscape — hang from one hook, flutter the other to
dodge its share of the stale charge — and its noise collapsed there. The +7/m for
progress was never large against the nudges, and in earlier runs it had not needed
to be: a random shove along the rung was paid. Now a shove is a charged drag, and
the one paid move — lift, carry, re-seat — is a sequence, and 1.1 m of it is five
cycles per hand.

Two changes. `K_STALE` 0.01 → 0.001, so a full idle episode costs −7.4 and a fall
never becomes the cheap way out (asserted). And a first rung that random behaviour
brushes against: random policies produce a supported grab cycle from **both** hands
in about a third of episodes, and those are paid — that is the gradient.

The first draft of that rung was 0.30 m per hand, and it deadlocked by geometry: the
hands start 0.314 m apart, so the right hand's goal landed 14 mm from where the left
hand starts, and two 65 mm hooks cannot share that span. A 600k-step policy on it
had the right hook in its goal region on 42 % of steps, hovering 100 mm (min 44)
from the left hook, banking +0.96 and never seating; the left hook, which had to
move first, never let go. Hence lessons −2 and −1 (one hand alone moves 0.30 m — the left toward the goal,
then the right the other way, so each arm learns to lift and place and each hand
learns to carry; the other hand owes only a supported re-grip where it is) and
lesson 0 (both hands 0.40 m, the goal 86 mm past the other hand's start).

Checked locally before shipping (8 envs on the M4 Pro, then numbered −1/0): the
left-hand step at 52 % by 250k and 75 % by 400k, both-hands unlocked at about 300k
with its first success by 400k, action std still 0.90. By 2M the pool had opened to
lesson 2 — and lesson 1 was being solved by a drag: the right hook, which no lesson
had yet asked to lift, pulled along the rung 864 mm per episode while the left hand
tapped its way forward, 20 % success and the map 0.2–0.8 m off again. Decomposed:
bank +7.9, reach +3.3 against slide −8.8 — every tap re-seated the left hand where it
already was *relative* to the right and banked what the drag had carried, so one
drag advanced both anchors and the slide charge could not keep up. Doubling the
charge did not help, it hurt: the run at 20/m never left the first lesson in 3M
steps (30 %, std 0.42), because a holding hook settles by a few centimetres during
every honest reach and paid for it. The fix is the credit itself: progress is
measured the way the sensors measure it, relative to the hand that holds — and a
lesson that makes the right hand lift too.

With the relative credit, the right-hand step and `K_GRAB` (3M local steps): −2 at
100 %, −1 at 73 %, 0 at 63 %, **lesson 1 at 80 %** with both hands lifting — right
hook off the rung 28 % of the time against 2 % in the drag, 42 load swaps per
episode, 87 % success in audit — and lesson 2 unlocked at about 2.5M. What remained
was the map: 447 mm of loaded slide per episode, two thirds of it millimetre-scale
settling under load rather than dragging, plus the triad's 25° — enough to put
`seg1` at 230–630 mm in the estimate when it was 65–120 mm away. Hence the attitude
filter above, trusting a seated-but-unloaded anchor through the hand-over, and
counting a hold only while the other hand is loaded. With those three (1.5–3M local
steps): lesson 2 unlocks at 0.9M in every run; on lesson 2 the anchor holds to
9–70 mm and the free hand to 31 mm on approach — the map is readable there — and on
lesson 1 a traverse ends 27–320 mm off instead of 0.5–1.0 m. Lesson 2 itself was still
0/40 after ~2M steps of exposure on the Mac, and the reason is a climber's rule the
policy had no way to find. When the free hand came closest to the far ledge it was
120–160 mm short, the hands were 627–689 mm apart — the static reach limit — and the
**holding hand was still 0.47–0.54 m from the edge of its own segment**. Lead hand to
the edge, trailing hand up beside it, *then* reach: from a holder at y ≈ 0.25 the
free hand reaches ~0.9 and the ledge (0.60–0.95) is in static reach, no swing needed.
That order was never once rewarded, because a 0.25 m gap is never crossed by
accident — and the edge of a rung was not in the observation at all (the three
nearest rungs were given as nearest-point offsets, which read 0 anywhere along the
rung you are on). Two changes, neither a script: each hand now sees the signed
distance to both ends of its nearest rung, and lesson 1.5 puts a 0.12 m gap in the
way first — one an ordinary 0.30 m step crosses, so the first crossings happen with
the gait the policy already has and the credit does the rest. The body swing is a
lesson-9 matter (0.75 m, beyond static reach), not a lesson-2 one.

Checked locally (1.5M steps, 8 envs): with the end distances in the observation
the pool opened -1 @ 0.10M, 0 @ 0.19M, 1 @ 0.37M, 1.5 @ 0.78M — lesson 1 at 60 % and the first 0.12 m crossings by 1.5M;
without them, -1 @ 0.14M, 0 @ 0.24M, 1 @ 0.38M, 1.5 @ 0.54M, lesson 1 still at 0 %. One run of the same configuration
collapsed instead: lesson −1 reached 70 % at 0.44M, lesson 0 unlocked and stayed at
0 %, and by 3M both were at 0 % with the left hand fluttering 48 grabs per episode.
A newly unlocked lesson that fails for long is half the pool's gradient, and a
policy can lose what it knew to it. `rl.status` shows it: an earlier lesson's rate
falling while the newest sits at 0 % for more than ~1M steps. If that happens,
restart — the runs that get past it do so early.

Skipped: domain randomization, best-checkpoint keeping. Reward weights are
first-guess knobs — `rl.eval` plus the diagnostics are how you tell.
