Thuong180702/Bimanual-wall-climbing-robot/urdf/climbing_robot.urdf

<?xml version="1.0"?>
<!-- Bimanual wall-climbing robot, v2: real actuators. -->
<!-- Generated by cad/tools/gen_urdf.py from the CAD assembly - do not hand-edit. -->
<!-- Units: m, kg, rad. Frame: +X forward (toward the wall), +Y left, +Z up. -->
<!-- Joint sign convention: about Y, NEGATIVE = flexion / forward / closing. -->
<!-- effort = the actuator PEAK torque from its datasheet. -->
<!-- velocity = the actuator NO-LOAD speed from its datasheet. -->
<!-- Total mass 24.4983 kg. -->
<robot name="bimanual_wall_climber_v2">
  <mujoco>
    <compiler meshdir="." balanceinertia="true" discardvisual="false"/>
    <visual><global offwidth="1600" offheight="1200"/></visual>
  </mujoco>
  <material name="aluminium"><color rgba="0.75 0.76 0.78 1.0"/></material>
  <material name="actuator"><color rgba="0.25 0.27 0.30 1.0"/></material>

  <link name="base_link">
    <inertial>
      <origin xyz="-0.000000 -0.000000 0.028056" rpy="0 0 0"/>
      <mass value="1.791998"/>
      <inertia ixx="0.00870712898" ixy="1.14688376e-15" ixz="7.82367767e-13" iyy="0.00846276175" iyz="5.38583531e-17" izz="0.00553647769"/>
    </inertial>
    <visual>
      <origin xyz="0 0 0" rpy="0 0 0"/>
      <geometry><mesh filename="meshes/base_link.stl" scale="0.001 0.001 0.001"/></geometry>
      <material name="aluminium"/>
    </visual>
    <collision>
      <origin xyz="0.000000 0.000000 0.066000" rpy="0.000000 -0.000000 1.570796"/>
      <geometry><cylinder radius="0.039500" length="0.067000"/></geometry>
    </collision>
    <collision>
      <origin xyz="0.000000 0.000000 0.000000" rpy="0.000000 -0.000000 0.000000"/>
      <geometry><mesh filename="meshes/base_link_col_shell.stl" scale="0.001 0.001 0.001"/></geometry>
    </collision>
    <collision>
      <origin xyz="0.000000 0.000000 0.000000" rpy="0.000000 -0.000000 0.000000"/>
      <geometry><mesh filename="meshes/base_link_col_floor.stl" scale="0.001 0.001 0.001"/></geometry>
    </collision>
    <collision>
      <origin xyz="0.000000 0.000000 0.000000" rpy="0.000000 -0.000000 0.000000"/>
      <geometry><mesh filename="meshes/base_link_col_hip_L.stl" scale="0.001 0.001 0.001"/></geometry>
    </collision>
    <collision>
      <origin xyz="0.000000 0.000000 0.000000" rpy="0.000000 -0.000000 0.000000"/>
      <geometry><mesh filename="meshes/base_link_col_hip_R.stl" scale="0.001 0.001 0.001"/></geometry>
    </collision>
    <collision>
      <origin xyz="0.000000 0.000000 0.000000" rpy="0.000000 -0.000000 0.000000"/>
      <geometry><mesh filename="meshes/base_link_col_deck.stl" scale="0.001 0.001 0.001"/></geometry>
    </collision>
  </link>

  <link name="waist_link">
    <inertial>
      <origin xyz="0.000000 0.000000 0.024521" rpy="0 0 0"/>
      <mass value="0.136650"/>
      <inertia ixx="0.000120548333" ixy="1.2942307e-20" ixz="4.04123696e-22" iyy="0.000120548333" iyz="-6.75782627e-21" izz="0.000194636115"/>
    </inertial>
    <visual>
      <origin xyz="0 0 0" rpy="0 0 0"/>
      <geometry><mesh filename="meshes/waist_link.stl" scale="0.001 0.001 0.001"/></geometry>
      <material name="aluminium"/>
    </visual>
    <collision>
      <origin xyz="0.000000 0.000000 0.000000" rpy="0.000000 -0.000000 0.000000"/>
      <geometry><mesh filename="meshes/waist_link_col_plate_out.stl" scale="0.001 0.001 0.001"/></geometry>
    </collision>
    <collision>
      <origin xyz="0.000000 0.000000 0.000000" rpy="0.000000 -0.000000 0.000000"/>
      <geometry><mesh filename="meshes/waist_link_col_cone.stl" scale="0.001 0.001 0.001"/></geometry>
    </collision>
    <collision>
      <origin xyz="0.000000 0.000000 0.000000" rpy="0.000000 -0.000000 0.000000"/>
      <geometry><mesh filename="meshes/waist_link_col_flange.stl" scale="0.001 0.001 0.001"/></geometry>
    </collision>
  </link>

  <link name="torso_upper">
    <inertial>
      <origin xyz="0.000242 0.000475 0.184436" rpy="0 0 0"/>
      <mass value="8.422437"/>
      <inertia ixx="0.134404393" ixy="0.000184862028" ixz="-0.000125704676" iyy="0.134841685" iyz="0.000319733117" izz="0.0359415321"/>
    </inertial>
    <visual>
      <origin xyz="0 0 0" rpy="0 0 0"/>
      <geometry><mesh filename="meshes/torso_upper.stl" scale="0.001 0.001 0.001"/></geometry>
      <material name="aluminium"/>
    </visual>
    <collision>
      <origin xyz="0.000000 0.053050 0.265000" rpy="-1.570796 -0.000000 0.000000"/>
      <geometry><cylinder radius="0.049000" length="0.061900"/></geometry>
    </collision>
    <collision>
      <origin xyz="0.000000 -0.053050 0.265000" rpy="1.570796 -0.000000 0.000000"/>
      <geometry><cylinder radius="0.049000" length="0.061900"/></geometry>
    </collision>
    <collision>
      <origin xyz="0.000000 0.000000 0.000000" rpy="0.000000 -0.000000 0.000000"/>
      <geometry><mesh filename="meshes/torso_upper_col_wall_L.stl" scale="0.001 0.001 0.001"/></geometry>
    </collision>
    <collision>
      <origin xyz="0.000000 0.000000 0.000000" rpy="0.000000 -0.000000 0.000000"/>
      <geometry><mesh filename="meshes/torso_upper_col_wall_R.stl" scale="0.001 0.001 0.001"/></geometry>
    </collision>
    <collision>
      <origin xyz="0.000000 0.000000 0.000000" rpy="0.000000 -0.000000 0.000000"/>
      <geometry><mesh filename="meshes/torso_upper_col_front.stl" scale="0.001 0.001 0.001"/></geometry>
    </collision>
    <collision>
      <origin xyz="0.000000 0.000000 0.000000" rpy="0.000000 -0.000000 0.000000"/>
      <geometry><mesh filename="meshes/torso_upper_col_back.stl" scale="0.001 0.001 0.001"/></geometry>
    </collision>
    <collision>
      <origin xyz="0.000000 0.000000 0.000000" rpy="0.000000 -0.000000 0.000000"/>
      <geometry><mesh filename="meshes/torso_upper_col_lid.stl" scale="0.001 0.001 0.001"/></geometry>
    </collision>
    <collision>
      <origin xyz="0.000000 0.000000 0.000000" rpy="0.000000 -0.000000 0.000000"/>
      <geometry><mesh filename="meshes/torso_upper_col_deck.stl" scale="0.001 0.001 0.001"/></geometry>
    </collision>
    <collision>
      <origin xyz="0.000000 0.000000 0.000000" rpy="0.000000 -0.000000 0.000000"/>
      <geometry><mesh filename="meshes/torso_upper_col_lidar_head_roof.stl" scale="0.001 0.001 0.001"/></geometry>
    </collision>
    <collision>
      <origin xyz="0.041667 0.000000 0.363667" rpy="0.000000 0.785398 0.000000"/>
      <geometry><box size="0.064800 0.064800 0.033000"/></geometry>
    </collision>
    <collision>
      <origin xyz="0.062916 0.000000 0.384916" rpy="0.000000 0.785398 0.000000"/>
      <geometry><cylinder radius="0.025500" length="0.027100"/></geometry>
    </collision>
    <collision>
      <origin xyz="-0.041667 0.000000 0.363667" rpy="0.000000 0.785398 3.141593"/>
      <geometry><box size="0.064800 0.064800 0.033000"/></geometry>
    </collision>
    <collision>
      <origin xyz="-0.062916 0.000000 0.384916" rpy="-0.000000 -0.785398 0.000000"/>
      <geometry><cylinder radius="0.025500" length="0.027100"/></geometry>
    </collision>
    <collision>
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
      <geometry><cylinder radius="0.008000" length="0.100000"/></geometry>
    </collision>
    <collision>
      <origin xyz="0.000000 0.050000 0.445000" rpy="-3.141593 -1.570796 0.000000"/>
      <geometry><cylinder radius="0.008000" length="0.204000"/></geometry>
    </collision>
  </link>

  <link name="shoulder_L">
    <inertial>
      <origin xyz="0.028831 0.053030 -0.000000" rpy="0 0 0"/>
      <mass value="1.283562"/>
      <inertia ixx="0.00229421654" ixy="-0.000219923649" ixz="4.6884799e-12" iyy="0.0014145812" iyz="-1.78371255e-12" izz="0.00211029747"/>
    </inertial>
    <visual>
      <origin xyz="0 0 0" rpy="0 0 0"/>
      <geometry><mesh filename="meshes/shoulder_L.stl" scale="0.001 0.001 0.001"/></geometry>
      <material name="aluminium"/>
    </visual>
    <collision>
      <origin xyz="0.031950 0.070000 0.000000" rpy="-0.000000 -1.570796 0.000000"/>
      <geometry><cylinder radius="0.049000" length="0.061900"/></geometry>
    </collision>
    <collision>
      <origin xyz="0.000000 0.000000 0.000000" rpy="0.000000 -0.000000 0.000000"/>
      <geometry><mesh filename="meshes/shoulder_L_col_plate_out.stl" scale="0.001 0.001 0.001"/></geometry>
    </collision>
    <collision>
      <origin xyz="0.000000 0.000000 0.000000" rpy="0.000000 -0.000000 0.000000"/>
      <geometry><mesh filename="meshes/shoulder_L_col_plate_face.stl" scale="0.001 0.001 0.001"/></geometry>
    </collision>
    <collision>
      <origin xyz="0.000000 0.000000 0.000000" rpy="0.000000 -0.000000 0.000000"/>
      <geometry><mesh filename="meshes/shoulder_L_col_web.stl" scale="0.001 0.001 0.001"/></geometry>
    </collision>
    <collision>
      <origin xyz="0.000000 0.000000 0.000000" rpy="0.000000 -0.000000 0.000000"/>
      <geometry><mesh filename="meshes/shoulder_L_col_leg.stl" scale="0.001 0.001 0.001"/></geometry>
    </collision>
  </link>

  <link name="humerus_rot_L">
    <inertial>
      <origin xyz="-0.000000 0.027748 -0.055859" rpy="0 0 0"/>
      <mass value="0.956637"/>
      <inertia ixx="0.00111936857" ixy="-5.08119103e-14" ixz="9.22095255e-14" iyy="0.00132936608" iyz="0.000106019832" izz="0.000951459933"/>
    </inertial>
    <visual>
      <origin xyz="0 0 0" rpy="0 0 0"/>
      <geometry><mesh filename="meshes/humerus_rot_L.stl" scale="0.001 0.001 0.001"/></geometry>
      <material name="aluminium"/>
    </visual>
    <collision>
      <origin xyz="0.000000 0.031950 -0.060000" rpy="1.570796 -0.000000 0.000000"/>
      <geometry><cylinder radius="0.049000" length="0.061900"/></geometry>
    </collision>
    <collision>
      <origin xyz="0.000000 0.000000 0.000000" rpy="0.000000 -0.000000 0.000000"/>
      <geometry><mesh filename="meshes/humerus_rot_L_col_plate_out.stl" scale="0.001 0.001 0.001"/></geometry>
    </collision>
    <collision>
      <origin xyz="0.000000 0.000000 0.000000" rpy="0.000000 -0.000000 0.000000"/>
      <geometry><mesh filename="meshes/humerus_rot_L_col_plate_face.stl" scale="0.001 0.001 0.001"/></geometry>
    </collision>
    <collision>
      <origin xyz="0.000000 0.000000 0.000000" rpy="0.000000 -0.000000 0.000000"/>
      <geometry><mesh filename="meshes/humerus_rot_L_col_cheek.stl" scale="0.001 0.001 0.001"/></geometry>
    </collision>
  </link>

  <link name="upper_arm_L">
    <inertial>
      <origin xyz="-0.003568 -0.000000 -0.129094" rpy="0 0 0"/>
      <mass value="1.288675"/>
      <inertia ixx="0.00639213278" ixy="-7.95060585e-16" ixz="0.000373300172" iyy="0.00618725687" iyz="-3.7425625e-15" izz="0.00141096365"/>
    </inertial>
    <visual>
      <origin xyz="0 0 0" rpy="0 0 0"/>
      <geometry><mesh filename="meshes/upper_arm_L.stl" scale="0.001 0.001 0.001"/></geometry>
      <material name="aluminium"/>
    </visual>
    <collision>
      <origin xyz="0.000000 0.000000 -0.168050" rpy="3.141593 -0.000000 1.570796"/>
      <geometry><cylinder radius="0.049000" length="0.061900"/></geometry>
    </collision>
    <collision>
      <origin xyz="0.000000 0.000000 0.000000" rpy="0.000000 -0.000000 0.000000"/>
      <geometry><mesh filename="meshes/upper_arm_L_col_plate_out.stl" scale="0.001 0.001 0.001"/></geometry>
    </collision>
    <collision>
      <origin xyz="0.000000 0.000000 0.000000" rpy="0.000000 -0.000000 0.000000"/>
      <geometry><mesh filename="meshes/upper_arm_L_col_plate_face.stl" scale="0.001 0.001 0.001"/></geometry>
    </collision>
    <collision>
      <origin xyz="0.000000 0.000000 0.000000" rpy="0.000000 -0.000000 0.000000"/>
      <geometry><mesh filename="meshes/upper_arm_L_col_cheek.stl" scale="0.001 0.001 0.001"/></geometry>
    </collision>
  </link>

  <link name="fore_arm_L">
    <inertial>
      <origin xyz="-0.000000 -0.001512 -0.091310" rpy="0 0 0"/>
      <mass value="0.988206"/>
      <inertia ixx="0.00219556303" ixy="-6.33947261e-14" ixz="-2.48704097e-13" iyy="0.00229766711" iyz="0.000103367386" izz="0.000743604465"/>
    </inertial>
    <visual>
      <origin xyz="0 0 0" rpy="0 0 0"/>
      <geometry><mesh filename="meshes/fore_arm_L.stl" scale="0.001 0.001 0.001"/></geometry>
      <material name="aluminium"/>
    </visual>
    <collision>
      <origin xyz="0.000000 0.000000 -0.111000" rpy="3.141593 -0.000000 1.570796"/>
      <geometry><cylinder radius="0.039500" length="0.067000"/></geometry>
    </collision>
    <collision>
      <origin xyz="0.000000 0.000000 0.000000" rpy="0.000000 -0.000000 0.000000"/>
      <geometry><mesh filename="meshes/fore_arm_L_col_plate_out.stl" scale="0.001 0.001 0.001"/></geometry>
    </collision>
    <collision>
      <origin xyz="0.000000 0.000000 0.000000" rpy="0.000000 -0.000000 0.000000"/>
      <geometry><mesh filename="meshes/fore_arm_L_col_plate_face.stl" scale="0.001 0.001 0.001"/></geometry>
    </collision>
    <collision>
      <origin xyz="0.000000 0.000000 0.000000" rpy="0.000000 -0.000000 0.000000"/>
      <geometry><mesh filename="meshes/fore_arm_L_col_cheek.stl" scale="0.001 0.001 0.001"/></geometry>
    </collision>
  </link>

  <link name="forearm_rot_L">
    <inertial>
      <origin xyz="-0.000000 -0.030705 -0.057590" rpy="0 0 0"/>
      <mass value="0.823087"/>
      <inertia ixx="0.000765070229" ixy="1.10721218e-12" ixz="8.84520589e-13" iyy="0.000738211377" iyz="-5.88480912e-05" izz="0.000677580808"/>
    </inertial>
    <visual>
      <origin xyz="0 0 0" rpy="0 0 0"/>
      <geometry><mesh filename="meshes/forearm_rot_L.stl" scale="0.001 0.001 0.001"/></geometry>
      <material name="aluminium"/>
    </visual>
    <collision>
      <origin xyz="0.000000 -0.034000 -0.060000" rpy="-1.570796 -0.000000 0.000000"/>
      <geometry><cylinder radius="0.039500" length="0.067000"/></geometry>
    </collision>
    <collision>
      <origin xyz="0.000000 0.000000 0.000000" rpy="0.000000 -0.000000 0.000000"/>
      <geometry><mesh filename="meshes/forearm_rot_L_col_plate_out.stl" scale="0.001 0.001 0.001"/></geometry>
    </collision>
    <collision>
      <origin xyz="0.000000 0.000000 0.000000" rpy="0.000000 -0.000000 0.000000"/>
      <geometry><mesh filename="meshes/forearm_rot_L_col_plate_face.stl" scale="0.001 0.001 0.001"/></geometry>
    </collision>
    <collision>
      <origin xyz="0.000000 0.000000 0.000000" rpy="0.000000 -0.000000 0.000000"/>
      <geometry><mesh filename="meshes/forearm_rot_L_col_cheek.stl" scale="0.001 0.001 0.001"/></geometry>
    </collision>
  </link>

  <link name="wrist_L">
    <inertial>
      <origin xyz="-0.026764 0.000883 -0.076190" rpy="0 0 0"/>
      <mass value="0.931403"/>
      <inertia ixx="0.00122806602" ixy="-2.23852717e-05" ixz="-0.000196695831" iyy="0.00135153314" iyz="-5.50943934e-05" izz="0.000826035719"/>
    </inertial>
    <visual>
      <origin xyz="0 0 0" rpy="0 0 0"/>
      <geometry><mesh filename="meshes/wrist_L.stl" scale="0.001 0.001 0.001"/></geometry>
      <material name="aluminium"/>
    </visual>
    <collision>
      <origin xyz="-0.034000 0.000000 -0.084000" rpy="-3.141593 -1.570796 0.000000"/>
      <geometry><cylinder radius="0.039500" length="0.067000"/></geometry>
    </collision>
    <collision>
      <origin xyz="0.000000 0.000000 0.000000" rpy="0.000000 -0.000000 0.000000"/>
      <geometry><mesh filename="meshes/wrist_L_col_plate_out.stl" scale="0.001 0.001 0.001"/></geometry>
    </collision>
    <collision>
      <origin xyz="0.000000 0.000000 0.000000" rpy="0.000000 -0.000000 0.000000"/>
      <geometry><mesh filename="meshes/wrist_L_col_plate_face.stl" scale="0.001 0.001 0.001"/></geometry>
    </collision>
    <collision>
      <origin xyz="0.000000 0.000000 0.000000" rpy="0.000000 -0.000000 0.000000"/>
      <geometry><mesh filename="meshes/wrist_L_col_web.stl" scale="0.001 0.001 0.001"/></geometry>
    </collision>
  </link>

  <link name="wrist_dev_L">
    <inertial>
      <origin xyz="0.004403 0.016622 -0.052452" rpy="0 0 0"/>
      <mass value="0.537771"/>
      <inertia ixx="0.000837188618" ixy="4.12143707e-05" ixz="-0.000105341943" iyy="0.000733052733" iyz="0.000178113809" izz="0.000322437217"/>
    </inertial>
    <visual>
      <origin xyz="0 0 0" rpy="0 0 0"/>
      <geometry><mesh filename="meshes/wrist_dev_L.stl" scale="0.001 0.001 0.001"/></geometry>
      <material name="aluminium"/>
    </visual>
    <collision>
      <origin xyz="0.000000 0.029000 -0.072000" rpy="1.570796 -0.000000 0.000000"/>
      <geometry><cylinder radius="0.027500" length="0.054000"/></geometry>
    </collision>
    <collision>
      <origin xyz="0.000000 0.000000 0.000000" rpy="0.000000 -0.000000 0.000000"/>
      <geometry><mesh filename="meshes/wrist_dev_L_col_plate_out.stl" scale="0.001 0.001 0.001"/></geometry>
    </collision>
    <collision>
      <origin xyz="0.000000 0.000000 0.000000" rpy="0.000000 -0.000000 0.000000"/>
      <geometry><mesh filename="meshes/wrist_dev_L_col_plate_face.stl" scale="0.001 0.001 0.001"/></geometry>
    </collision>
    <collision>
      <origin xyz="0.000000 0.000000 0.000000" rpy="0.000000 -0.000000 0.000000"/>
      <geometry><mesh filename="meshes/wrist_dev_L_col_web.stl" scale="0.001 0.001 0.001"/></geometry>
    </collision>
  </link>

  <link name="hook_L">
    <inertial>
      <origin xyz="0.008288 0.005164 -0.069537" rpy="0 0 0"/>
      <mass value="0.264262"/>
      <inertia ixx="0.000513191" ixy="1.13097635e-05" ixz="7.5482558e-05" iyy="0.000494736827" iyz="-6.18203975e-05" izz="0.00013302376"/>
    </inertial>
    <visual>
      <origin xyz="0 0 0" rpy="0 0 0"/>
      <geometry><mesh filename="meshes/hook_L.stl" scale="0.001 0.001 0.001"/></geometry>
      <material name="aluminium"/>
    </visual>
    <collision>
      <origin xyz="0.000000 0.000000 -0.055000" rpy="0.000000 -0.000000 0.000000"/>
      <geometry><box size="0.012000 0.065000 0.110000"/></geometry>
    </collision>
    <collision>
      <origin xyz="0.026000 0.000000 -0.104000" rpy="0.000000 -0.000000 0.000000"/>
      <geometry><box size="0.040000 0.065000 0.012000"/></geometry>
    </collision>
    <collision>
      <origin xyz="0.000000 0.000000 0.000000" rpy="-1.570796 -0.000000 0.000000"/>
      <geometry><cylinder radius="0.018000" length="0.030000"/></geometry>
    </collision>
  </link>

  <link name="shoulder_R">
    <inertial>
      <origin xyz="0.028831 -0.053030 -0.000000" rpy="0 0 0"/>
      <mass value="1.283562"/>
      <inertia ixx="0.00229421654" ixy="0.000219923649" ixz="4.6884799e-12" iyy="0.0014145812" iyz="1.78371137e-12" izz="0.00211029747"/>
    </inertial>
    <visual>
      <origin xyz="0 0 0" rpy="0 0 0"/>
      <geometry><mesh filename="meshes/shoulder_R.stl" scale="0.001 0.001 0.001"/></geometry>
      <material name="aluminium"/>
    </visual>
    <collision>
      <origin xyz="0.031950 -0.070000 0.000000" rpy="-0.000000 -1.570796 0.000000"/>
      <geometry><cylinder radius="0.049000" length="0.061900"/></geometry>
    </collision>
    <collision>
      <origin xyz="0.000000 0.000000 0.000000" rpy="0.000000 -0.000000 0.000000"/>
      <geometry><mesh filename="meshes/shoulder_R_col_plate_out.stl" scale="0.001 0.001 0.001"/></geometry>
    </collision>
    <collision>
      <origin xyz="0.000000 0.000000 0.000000" rpy="0.000000 -0.000000 0.000000"/>
      <geometry><mesh filename="meshes/shoulder_R_col_plate_face.stl" scale="0.001 0.001 0.001"/></geometry>
    </collision>
    <collision>
      <origin xyz="0.000000 0.000000 0.000000" rpy="0.000000 -0.000000 0.000000"/>
      <geometry><mesh filename="meshes/shoulder_R_col_web.stl" scale="0.001 0.001 0.001"/></geometry>
    </collision>
    <collision>
      <origin xyz="0.000000 0.000000 0.000000" rpy="0.000000 -0.000000 0.000000"/>
      <geometry><mesh filename="meshes/shoulder_R_col_leg.stl" scale="0.001 0.001 0.001"/></geometry>
    </collision>
  </link>

  <link name="upper_arm_R">
    <inertial>
      <origin xyz="-0.003568 0.000000 -0.129094" rpy="0 0 0"/>
      <mass value="1.288675"/>
      <inertia ixx="0.00639213278" ixy="7.95060585e-16" ixz="0.000373300172" iyy="0.00618725687" iyz="3.7425625e-15" izz="0.00141096365"/>
    </inertial>
    <visual>
      <origin xyz="0 0 0" rpy="0 0 0"/>
      <geometry><mesh filename="meshes/upper_arm_R.stl" scale="0.001 0.001 0.001"/></geometry>
      <material name="aluminium"/>
    </visual>
    <collision>
      <origin xyz="0.000000 0.000000 -0.168050" rpy="3.141593 -0.000000 1.570796"/>
      <geometry><cylinder radius="0.049000" length="0.061900"/></geometry>
    </collision>
    <collision>
      <origin xyz="0.000000 0.000000 0.000000" rpy="0.000000 -0.000000 0.000000"/>
      <geometry><mesh filename="meshes/upper_arm_R_col_plate_out.stl" scale="0.001 0.001 0.001"/></geometry>
    </collision>
    <collision>
      <origin xyz="0.000000 0.000000 0.000000" rpy="0.000000 -0.000000 0.000000"/>
      <geometry><mesh filename="meshes/upper_arm_R_col_plate_face.stl" scale="0.001 0.001 0.001"/></geometry>
    </collision>
    <collision>
      <origin xyz="0.000000 0.000000 0.000000" rpy="0.000000 -0.000000 0.000000"/>
      <geometry><mesh filename="meshes/upper_arm_R_col_cheek.stl" scale="0.001 0.001 0.001"/></geometry>
    </collision>
  </link>

  <link name="humerus_rot_R">
    <inertial>
      <origin xyz="-0.000000 -0.027748 -0.055859" rpy="0 0 0"/>
      <mass value="0.956637"/>
      <inertia ixx="0.00111936857" ixy="5.08119026e-14" ixz="9.22095229e-14" iyy="0.00132936608" iyz="-0.000106019832" izz="0.000951459933"/>
    </inertial>
    <visual>
      <origin xyz="0 0 0" rpy="0 0 0"/>
      <geometry><mesh filename="meshes/humerus_rot_R.stl" scale="0.001 0.001 0.001"/></geometry>
      <material name="aluminium"/>
    </visual>
    <collision>
      <origin xyz="0.000000 -0.031950 -0.060000" rpy="-1.570796 -0.000000 0.000000"/>
      <geometry><cylinder radius="0.049000" length="0.061900"/></geometry>
    </collision>
    <collision>
      <origin xyz="0.000000 0.000000 0.000000" rpy="0.000000 -0.000000 0.000000"/>
      <geometry><mesh filename="meshes/humerus_rot_R_col_plate_out.stl" scale="0.001 0.001 0.001"/></geometry>
    </collision>
    <collision>
      <origin xyz="0.000000 0.000000 0.000000" rpy="0.000000 -0.000000 0.000000"/>
      <geometry><mesh filename="meshes/humerus_rot_R_col_plate_face.stl" scale="0.001 0.001 0.001"/></geometry>
    </collision>
    <collision>
      <origin xyz="0.000000 0.000000 0.000000" rpy="0.000000 -0.000000 0.000000"/>
      <geometry><mesh filename="meshes/humerus_rot_R_col_cheek.stl" scale="0.001 0.001 0.001"/></geometry>
    </collision>
  </link>

  <link name="fore_arm_R">
    <inertial>
      <origin xyz="-0.000000 0.001512 -0.091310" rpy="0 0 0"/>
      <mass value="0.988206"/>
      <inertia ixx="0.00219556303" ixy="6.33947288e-14" ixz="-2.48704085e-13" iyy="0.00229766711" iyz="-0.000103367386" izz="0.000743604465"/>
    </inertial>
    <visual>
      <origin xyz="0 0 0" rpy="0 0 0"/>
      <geometry><mesh filename="meshes/fore_arm_R.stl" scale="0.001 0.001 0.001"/></geometry>
      <material name="aluminium"/>
    </visual>
    <collision>
      <origin xyz="0.000000 0.000000 -0.111000" rpy="3.141593 -0.000000 1.570796"/>
      <geometry><cylinder radius="0.039500" length="0.067000"/></geometry>
    </collision>
    <collision>
      <origin xyz="0.000000 0.000000 0.000000" rpy="0.000000 -0.000000 0.000000"/>
      <geometry><mesh filename="meshes/fore_arm_R_col_plate_out.stl" scale="0.001 0.001 0.001"/></geometry>
    </collision>
    <collision>
      <origin xyz="0.000000 0.000000 0.000000" rpy="0.000000 -0.000000 0.000000"/>
      <geometry><mesh filename="meshes/fore_arm_R_col_plate_face.stl" scale="0.001 0.001 0.001"/></geometry>
    </collision>
    <collision>
      <origin xyz="0.000000 0.000000 0.000000" rpy="0.000000 -0.000000 0.000000"/>
      <geometry><mesh filename="meshes/fore_arm_R_col_cheek.stl" scale="0.001 0.001 0.001"/></geometry>
    </collision>
  </link>

  <link name="forearm_rot_R">
    <inertial>
      <origin xyz="-0.000000 0.030705 -0.057590" rpy="0 0 0"/>
      <mass value="0.823087"/>
      <inertia ixx="0.000765070229" ixy="-1.10721218e-12" ixz="8.84520587e-13" iyy="0.000738211377" iyz="5.88480912e-05" izz="0.000677580808"/>
    </inertial>
    <visual>
      <origin xyz="0 0 0" rpy="0 0 0"/>
      <geometry><mesh filename="meshes/forearm_rot_R.stl" scale="0.001 0.001 0.001"/></geometry>
      <material name="aluminium"/>
    </visual>
    <collision>
      <origin xyz="0.000000 0.034000 -0.060000" rpy="1.570796 -0.000000 0.000000"/>
      <geometry><cylinder radius="0.039500" length="0.067000"/></geometry>
    </collision>
    <collision>
      <origin xyz="0.000000 0.000000 0.000000" rpy="0.000000 -0.000000 0.000000"/>
      <geometry><mesh filename="meshes/forearm_rot_R_col_plate_out.stl" scale="0.001 0.001 0.001"/></geometry>
    </collision>
    <collision>
      <origin xyz="0.000000 0.000000 0.000000" rpy="0.000000 -0.000000 0.000000"/>
      <geometry><mesh filename="meshes/forearm_rot_R_col_plate_face.stl" scale="0.001 0.001 0.001"/></geometry>
    </collision>
    <collision>
      <origin xyz="0.000000 0.000000 0.000000" rpy="0.000000 -0.000000 0.000000"/>
      <geometry><mesh filename="meshes/forearm_rot_R_col_cheek.stl" scale="0.001 0.001 0.001"/></geometry>
    </collision>
  </link>

  <link name="wrist_R">
    <inertial>
      <origin xyz="-0.026764 -0.000883 -0.076190" rpy="0 0 0"/>
      <mass value="0.931403"/>
      <inertia ixx="0.00122806602" ixy="2.23852717e-05" ixz="-0.000196695831" iyy="0.00135153314" iyz="5.50943934e-05" izz="0.000826035719"/>
    </inertial>
    <visual>
      <origin xyz="0 0 0" rpy="0 0 0"/>
      <geometry><mesh filename="meshes/wrist_R.stl" scale="0.001 0.001 0.001"/></geometry>
      <material name="aluminium"/>
    </visual>
    <collision>
      <origin xyz="-0.034000 0.000000 -0.084000" rpy="-3.141593 -1.570796 0.000000"/>
      <geometry><cylinder radius="0.039500" length="0.067000"/></geometry>
    </collision>
    <collision>
      <origin xyz="0.000000 0.000000 0.000000" rpy="0.000000 -0.000000 0.000000"/>
      <geometry><mesh filename="meshes/wrist_R_col_plate_out.stl" scale="0.001 0.001 0.001"/></geometry>
    </collision>
    <collision>
      <origin xyz="0.000000 0.000000 0.000000" rpy="0.000000 -0.000000 0.000000"/>
      <geometry><mesh filename="meshes/wrist_R_col_plate_face.stl" scale="0.001 0.001 0.001"/></geometry>
    </collision>
    <collision>
      <origin xyz="0.000000 0.000000 0.000000" rpy="0.000000 -0.000000 0.000000"/>
      <geometry><mesh filename="meshes/wrist_R_col_web.stl" scale="0.001 0.001 0.001"/></geometry>
    </collision>
  </link>

  <link name="wrist_dev_R">
    <inertial>
      <origin xyz="0.004403 -0.016622 -0.052452" rpy="0 0 0"/>
      <mass value="0.537771"/>
      <inertia ixx="0.000837188618" ixy="-4.12143707e-05" ixz="-0.000105341943" iyy="0.000733052733" iyz="-0.000178113809" izz="0.000322437217"/>
    </inertial>
    <visual>
      <origin xyz="0 0 0" rpy="0 0 0"/>
      <geometry><mesh filename="meshes/wrist_dev_R.stl" scale="0.001 0.001 0.001"/></geometry>
      <material name="aluminium"/>
    </visual>
    <collision>
      <origin xyz="0.000000 -0.029000 -0.072000" rpy="-1.570796 -0.000000 0.000000"/>
      <geometry><cylinder radius="0.027500" length="0.054000"/></geometry>
    </collision>
    <collision>
      <origin xyz="0.000000 0.000000 0.000000" rpy="0.000000 -0.000000 0.000000"/>
      <geometry><mesh filename="meshes/wrist_dev_R_col_plate_out.stl" scale="0.001 0.001 0.001"/></geometry>
    </collision>
    <collision>
      <origin xyz="0.000000 0.000000 0.000000" rpy="0.000000 -0.000000 0.000000"/>
      <geometry><mesh filename="meshes/wrist_dev_R_col_plate_face.stl" scale="0.001 0.001 0.001"/></geometry>
    </collision>
    <collision>
      <origin xyz="0.000000 0.000000 0.000000" rpy="0.000000 -0.000000 0.000000"/>
      <geometry><mesh filename="meshes/wrist_dev_R_col_web.stl" scale="0.001 0.001 0.001"/></geometry>
    </collision>
  </link>

  <link name="hook_R">
    <inertial>
      <origin xyz="0.008288 -0.005164 -0.069537" rpy="0 0 0"/>
      <mass value="0.264262"/>
      <inertia ixx="0.000513191" ixy="-1.13097635e-05" ixz="7.5482558e-05" iyy="0.000494736827" iyz="6.18203975e-05" izz="0.00013302376"/>
    </inertial>
    <visual>
      <origin xyz="0 0 0" rpy="0 0 0"/>
      <geometry><mesh filename="meshes/hook_R.stl" scale="0.001 0.001 0.001"/></geometry>
      <material name="aluminium"/>
    </visual>
    <collision>
      <origin xyz="0.000000 0.000000 -0.055000" rpy="0.000000 -0.000000 0.000000"/>
      <geometry><box size="0.012000 0.065000 0.110000"/></geometry>
    </collision>
    <collision>
      <origin xyz="0.026000 0.000000 -0.104000" rpy="0.000000 -0.000000 0.000000"/>
      <geometry><box size="0.040000 0.065000 0.012000"/></geometry>
    </collision>
    <collision>
      <origin xyz="0.000000 0.000000 0.000000" rpy="1.570796 -0.000000 0.000000"/>
      <geometry><cylinder radius="0.018000" length="0.030000"/></geometry>
    </collision>
  </link>

  <joint name="waist_yaw" type="revolute">
    <parent link="base_link"/>
    <child link="waist_link"/>
    <origin xyz="0.000000 0.000000 0.100000" rpy="0 0 0"/>
    <axis xyz="0 0 1"/>
    <limit lower="-0.785398" upper="0.785398" effort="72" velocity="10.2625"/>
    <dynamics damping="0.1" friction="0.0"/>
  </joint>

  <joint name="shoulder_L_flexion" type="revolute">
    <parent link="torso_upper"/>
    <child link="shoulder_L"/>
    <origin xyz="0.000000 0.085000 0.265000" rpy="0 0 0"/>
    <axis xyz="0 1 0"/>
    <limit lower="-2.967060" upper="1.047198" effort="120" velocity="7.8540"/>
    <dynamics damping="0.1" friction="0.0"/>
  </joint>

  <joint name="shoulder_L_abduction" type="revolute">
    <parent link="shoulder_L"/>
    <child link="upper_arm_L"/>
    <origin xyz="0.000000 0.070000 0.000000" rpy="0 0 0"/>
    <axis xyz="1 0 0"/>
    <limit lower="-0.209440" upper="3.141593" effort="120" velocity="7.8540"/>
    <dynamics damping="0.1" friction="0.0"/>
  </joint>

  <joint name="shoulder_L_rotation" type="revolute">
    <parent link="upper_arm_L"/>
    <child link="humerus_rot_L"/>
    <origin xyz="0.000000 0.000000 -0.200000" rpy="0 0 0"/>
    <axis xyz="0 0 1"/>
    <limit lower="-1.221730" upper="1.570796" effort="120" velocity="7.8540"/>
    <dynamics damping="0.1" friction="0.0"/>
  </joint>

  <joint name="elbow_L" type="revolute">
    <parent link="humerus_rot_L"/>
    <child link="fore_arm_L"/>
    <origin xyz="0.000000 0.000000 -0.060000" rpy="0 0 0"/>
    <axis xyz="0 1 0"/>
    <limit lower="-1.919862" upper="0.000000" effort="120" velocity="7.8540"/>
    <dynamics damping="0.1" friction="0.0"/>
  </joint>

  <joint name="forearm_L_roll" type="revolute">
    <parent link="fore_arm_L"/>
    <child link="forearm_rot_L"/>
    <origin xyz="0.000000 0.000000 -0.145000" rpy="0 0 0"/>
    <axis xyz="0 0 1"/>
    <limit lower="-1.483530" upper="1.483530" effort="72" velocity="10.2625"/>
    <dynamics damping="0.1" friction="0.0"/>
  </joint>

  <joint name="wrist_L_flexion" type="revolute">
    <parent link="forearm_rot_L"/>
    <child link="wrist_L"/>
    <origin xyz="0.000000 0.000000 -0.060000" rpy="0 0 0"/>
    <axis xyz="0 1 0"/>
    <limit lower="-0.436332" upper="0.436332" effort="72" velocity="10.2625"/>
    <dynamics damping="0.1" friction="0.0"/>
  </joint>

  <joint name="wrist_L_deviation" type="revolute">
    <parent link="wrist_L"/>
    <child link="wrist_dev_L"/>
    <origin xyz="0.000000 0.000000 -0.084000" rpy="0 0 0"/>
    <axis xyz="1 0 0"/>
    <limit lower="-0.523599" upper="0.349066" effort="72" velocity="10.2625"/>
    <dynamics damping="0.1" friction="0.0"/>
  </joint>

  <joint name="finger_L" type="revolute">
    <parent link="wrist_dev_L"/>
    <child link="hook_L"/>
    <origin xyz="0.000000 0.000000 -0.072000" rpy="0 0 3.14159265"/>
    <axis xyz="0 1 0"/>
    <limit lower="-1.570796" upper="0.349066" effort="24" velocity="5.4454"/>
    <dynamics damping="0.1" friction="0.0"/>
  </joint>

  <joint name="shoulder_R_flexion" type="revolute">
    <parent link="torso_upper"/>
    <child link="shoulder_R"/>
    <origin xyz="0.000000 -0.085000 0.265000" rpy="0 0 0"/>
    <axis xyz="0 1 0"/>
    <limit lower="-2.967060" upper="1.047198" effort="120" velocity="7.8540"/>
    <dynamics damping="0.1" friction="0.0"/>
  </joint>

  <joint name="shoulder_R_abduction" type="revolute">
    <parent link="shoulder_R"/>
    <child link="upper_arm_R"/>
    <origin xyz="0.000000 -0.070000 0.000000" rpy="0 0 0"/>
    <axis xyz="1 0 0"/>
    <limit lower="-3.141593" upper="0.209440" effort="120" velocity="7.8540"/>
    <dynamics damping="0.1" friction="0.0"/>
  </joint>

  <joint name="shoulder_R_rotation" type="revolute">
    <parent link="upper_arm_R"/>
    <child link="humerus_rot_R"/>
    <origin xyz="0.000000 0.000000 -0.200000" rpy="0 0 0"/>
    <axis xyz="0 0 1"/>
    <limit lower="-1.570796" upper="1.221730" effort="120" velocity="7.8540"/>
    <dynamics damping="0.1" friction="0.0"/>
  </joint>

  <joint name="elbow_R" type="revolute">
    <parent link="humerus_rot_R"/>
    <child link="fore_arm_R"/>
    <origin xyz="0.000000 0.000000 -0.060000" rpy="0 0 0"/>
    <axis xyz="0 1 0"/>
    <limit lower="-1.919862" upper="0.000000" effort="120" velocity="7.8540"/>
    <dynamics damping="0.1" friction="0.0"/>
  </joint>

  <joint name="forearm_R_roll" type="revolute">
    <parent link="fore_arm_R"/>
    <child link="forearm_rot_R"/>
    <origin xyz="0.000000 0.000000 -0.145000" rpy="0 0 0"/>
    <axis xyz="0 0 1"/>
    <limit lower="-1.483530" upper="1.483530" effort="72" velocity="10.2625"/>
    <dynamics damping="0.1" friction="0.0"/>
  </joint>

  <joint name="wrist_R_flexion" type="revolute">
    <parent link="forearm_rot_R"/>
    <child link="wrist_R"/>
    <origin xyz="0.000000 0.000000 -0.060000" rpy="0 0 0"/>
    <axis xyz="0 1 0"/>
    <limit lower="-0.436332" upper="0.436332" effort="72" velocity="10.2625"/>
    <dynamics damping="0.1" friction="0.0"/>
  </joint>

  <joint name="wrist_R_deviation" type="revolute">
    <parent link="wrist_R"/>
    <child link="wrist_dev_R"/>
    <origin xyz="0.000000 0.000000 -0.084000" rpy="0 0 0"/>
    <axis xyz="1 0 0"/>
    <limit lower="-0.349066" upper="0.523599" effort="72" velocity="10.2625"/>
    <dynamics damping="0.1" friction="0.0"/>
  </joint>

  <joint name="finger_R" type="revolute">
    <parent link="wrist_dev_R"/>
    <child link="hook_R"/>
    <origin xyz="0.000000 0.000000 -0.072000" rpy="0 0 3.14159265"/>
    <axis xyz="0 1 0"/>
    <limit lower="-1.570796" upper="0.349066" effort="24" velocity="5.4454"/>
    <dynamics damping="0.1" friction="0.0"/>
  </joint>

  <joint name="torso_fixed" type="fixed">
    <parent link="waist_link"/>
    <child link="torso_upper"/>
    <origin xyz="0.000000 0.000000 0.040000" rpy="0 0 0"/>
  </joint>

</robot>
