Thuong180702/Bimanual-wall-climbing-robot/rl/mjx_task.py

"""ClimbTask in JAX, thousands of envs at once on MJX: the GPU path of rl.train_ppo.

    python -m rl.mjx_task --envs 1024       # control-steps/s on this machine
    python -m rl.mjx_check                   # is it the same task as rl.climb_task

A line-for-line port of `climb_task.ClimbTask` -- the same 145 observations (the
anchor-rooted estimator, the SLAM-tracked anchor, reach odometry, the nearest
rungs), read through the same sensor, SLAM and map noise (`climb_task.sensed`,
`slam_drift`, `noisy_map`) and the same lidars (`rl.lidar`, the same lines on jax
arrays: the map holds what they have seen), the same reward books, the same success
test and the same terminations -- on `rl.mjx_scene`'s simplified robot. Every constant is read from climb_task,
so a reward change there is a reward change here. The comments that say WHY a rule
is what it is live there, next to the numpy version; this file only says where the
port had to differ.

What had to change, and nothing else:

  * one model for every wall. A wall -- a lesson, or a generated one (rl.walls) -- is
    a row of the tables (rung slots, walls, goals, timeout); an env copies its row
    into its own state at reset (`Wall`) and writes its rungs and extra wall into its
    own copy of the model's slot geoms (`_env_model`). Generated walls are a bank of
    rows after the lessons' that `Batch.set_bank` refills without a recompile.
  * a reset is a copy. ClimbTask.reset hangs the robot from the keyframe and closes
    the fingers over 0.4 s, which is deterministic, so that is done once per lesson
    at build time (`_secure`) and a reset only copies it and senses (the noise is
    drawn fresh).
  * branches are selects: `jp.where` both ways instead of `if`.
  * a finished env resets inside the same jitted step, onto a lesson drawn from the
    pool's weights, which the curriculum moves without a recompile.

One thing the C task has not: with `dr` (training only, rl.train_ppo) each episode draws
its own masses, friction, torque limits and setpoint lag (`_dyn`, climb_task.DR_*) into its
own model copy. Without it the graph is the nominal one, as every cross-check runs it.

Two MJX backends step it (`impl`): JAX, which tests every listed pair every substep
however far apart, and Warp, whose broadphase tests only the near ones. Warp keeps
the batch's contacts in one buffer, each with its world, so its step runs over the
whole batch (`MjxClimb.step_batch`, `_contacts`); it reads a world's own geoms --
the rungs -- from the data, not the model (`_place_static`); and a reset copies the
start into the env's own data (`reset`'s d_like). `rl.mjx_check warp` decides which
one a run trains on: Warp only where it is C MuJoCo's physics by the same checks
JAX passes, and faster.
"""
import inspect, os, time, warnings
# MJX shrinks a mesh face of more than 20 coplanar vertices to 20 for its contact
# clipping, and says so for 34 of ours. It changes nothing here: every mesh meets only
# a wall plane (rl.mjx_scene), and plane-mesh reads the vertices, not the faces.
warnings.filterwarnings('ignore', message=r'Mesh ".*" has a coplanar face with more than')
# JAX takes 75 % of the GPU up front by default, and torch -- the policy -- lives on
# the same card
os.environ.setdefault('XLA_PYTHON_CLIENT_PREALLOCATE', 'false')
from typing import NamedTuple
import numpy as np
import jax, jax.numpy as jp
# The physics in full float32 on every card. On Ampere and newer XLA lowers a
# float32 matmul to TF32 (a 10-bit mantissa) by default; the cross-checks against C
# were made without it. A V100 has no TF32, so there this changes nothing.
jax.config.update('jax_default_matmul_precision', 'highest')
from mujoco import mjx
from .estimator import JOINTS, THROAT_PT, MAG_WORLD
from climbing_env import ClimbingEnv, GRIP_BAND, GRIP_SET
from . import climb_task as ct, lidar, rsi
from .lessons import LESSONS, canon_axis, hang_qpos
from .mjx_scene import N_RUNG, PARK, lesson_layout, model as scene_model, slots

LESSON_KEYS = sorted(LESSONS)
N_PTS = 256        # route points a wall carries (climb_task.route_table): 180 on the
                   # largest family walls, lesson 3's three full rows
FAR_PT = 1e3       # padding: a point, and a route distance, no hand ever takes
REASONS = ('', 'success', 'timeout', 'fell', 'released', 'blowup', 'stalled')
_ENV = {k: v.default for k, v in inspect.signature(ClimbingEnv).parameters.items()}
FALL_Z, FREE_FALL_S, QVEL_MAX = _ENV['fall_z'], _ENV['free_fall_s'], _ENV['qvel_max']
FINGERS = [JOINTS.index('finger_L'), JOINTS.index('finger_R')]
MINVAL = 1e-15           # mujoco's mjMINVAL, for rotvec's zero-angle case
# MJX's Warp backend (`impl='warp'`, rl.mjx_check warp decides): it keeps all of a world's
# contacts, not the deepest MAX_CONTACTS, in one buffer for the whole batch, and gives
# up any past these -- counted, as `capped`, when it does. C never had more than 17.
WARP_CONTACTS = 48       # contacts a world, on average over the batch
WARP_EFC = 256           # constraint rows a world: four a contact, and the joint limits
# rl.train_ppo --ablate's switches inside the reward: each puts back the weaker rule that
# climb_task's comments (and the paper's exploit table) say a policy found a way around
REWARD_ABLATIONS = ('route', 'hold', 'oneway', 'world', 'grab', 'refund')
HOLD_DIST = 0.035        # m, --ablate hold: a throat this near a rung axis "holds" it. Between the
                         # 31 mm a seated hook reads under a 50 N side pull and the 42 mm of a
                         # hovering hand: the best a distance can do (climb_task's hold test)


# --- small rotation helpers, as climb_task / rl.estimator compute them -------------
def _skew(v):
    z = jp.zeros_like(v[0])
    return jp.stack([jp.stack([z, -v[2], v[1]]), jp.stack([v[2], z, -v[0]]),
                     jp.stack([-v[1], v[0], z])])


def _rotm(v):
    """climb_task._rotm: rotation vector -> matrix (Rodrigues)"""
    th = jp.sqrt(v @ v)
    small = th < 1e-12
    K = _skew(v / jp.where(small, 1.0, th))
    R = jp.eye(3) + jp.sin(th) * K + (1.0 - jp.cos(th)) * K @ K
    return jp.where(small, jp.eye(3), R)


def _mat2quat(R):
    """mju_mat2Quat, branch for branch"""
    m = R.reshape(9)
    tr = m[0] + m[4] + m[8]
    s = lambda x: 0.5 * jp.sqrt(jp.maximum(x, MINVAL))
    a0 = s(1 + tr)
    qa = jp.stack([a0, 0.25 * (m[7] - m[5]) / a0, 0.25 * (m[2] - m[6]) / a0, 0.25 * (m[3] - m[1]) / a0])
    b1 = s(1 + m[0] - m[4] - m[8])
    qb = jp.stack([0.25 * (m[7] - m[5]) / b1, b1, 0.25 * (m[1] + m[3]) / b1, 0.25 * (m[2] + m[6]) / b1])
    c2 = s(1 - m[0] + m[4] - m[8])
    qc = jp.stack([0.25 * (m[2] - m[6]) / c2, 0.25 * (m[1] + m[3]) / c2, c2, 0.25 * (m[5] + m[7]) / c2])
    d3 = s(1 - m[0] - m[4] + m[8])
    qd = jp.stack([0.25 * (m[3] - m[1]) / d3, 0.25 * (m[2] + m[6]) / d3, 0.25 * (m[5] + m[7]) / d3, d3])
    q = jp.where(tr > 0, qa, jp.where((m[0] > m[4]) & (m[0] > m[8]), qb,
                                      jp.where(m[4] > m[8], qc, qd)))
    return q / jp.sqrt(q @ q)


def _rotvec(R):
    """rl.estimator.rotvec: mju_mat2Quat then mju_quat2Vel(dt=1)"""
    q = _mat2quat(R)
    n = jp.sqrt(q[1:] @ q[1:])
    ax = jp.where(n < MINVAL, jp.array([1.0, 0.0, 0.0]), q[1:] / jp.where(n < MINVAL, 1.0, n))
    speed = 2.0 * jp.arctan2(n, q[0])
    return ax * jp.where(speed > jp.pi, speed - 2.0 * jp.pi, speed)


def _quat_z(q):
    """the z axis of a unit quaternion's rotation: a plane's normal"""
    w, x, y, z = q
    return jp.stack([2 * (x * z + w * y), 2 * (y * z - w * x), 1 - 2 * (x * x + y * y)])


def _frame(a, b):
    x = a / jp.sqrt(a @ a)
    z = jp.cross(x, b)
    z = z / jp.sqrt(z @ z)
    return jp.stack([x, jp.cross(z, x), z], axis=1)


def _triad(up, mag):
    """rl.estimator.triad"""
    return _frame(jp.array([0.0, 0.0, 1.0]), jp.asarray(MAG_WORLD)) @ _frame(up, mag).T


# --- the state one env carries ------------------------------------------------------
class State(NamedTuple):
    d: mjx.Data
    lesson: jax.Array          # index into LESSON_KEYS
    ctrl: jax.Array            # (17,) setpoints
    key: jax.Array
    no_grip_t: jax.Array       # ClimbingEnv._no_grip_t: s since any hook touched a rung
    # the estimator (climb_task._sense)
    Rf: jax.Array              # (3, 3) filtered world<-torso
    anchor: jax.Array          # 0 = L, 1 = R
    hold_idx: jax.Array        # (2,) rung slot of each hand's hold
    hold_pt: jax.Array         # (2, 3) its point on that rung's axis
    both_conf: jax.Array
    anchor_fresh: jax.Array
    est_thr: jax.Array         # (2, 3) estimated throats, what the observation reads
    map_c: jax.Array           # (N_RUNG, 3) the lidar's map of this wall (climb_task.noisy_map):
    map_a: jax.Array           # centre, axis, half extent
    map_h: jax.Array
    map_goals: jax.Array       # (2, 3) the goals on it
    map_z: jax.Array           # (N_RUNG, 8) its errors, drawn at the reset
    seen: jax.Array            # (N_RUNG, lidar.K) the cells of each rung the lidars have seen
    bias: dict                 # this episode's sensor offsets (climb_task.SEN_BIAS)
    slam_err: jax.Array        # (3,) the SLAM's drifting error
    k: jax.Array               # senses this episode
    buf_true: jax.Array        # (SLAM_LAG, 3) the base, and its estimate, the last
    buf_est: jax.Array         # SLAM_LAG senses: what a late SLAM fix is held against
    # the reward's books (climb_task.reset / step)
    prev_d: jax.Array
    prev_live: jax.Array
    live_att: jax.Array        # (2,) the live cost when a hook last touched a rung
    credit: jax.Array
    held: jax.Array
    prev_thr: jax.Array
    prev_loaded: jax.Array
    let_go: jax.Array
    grabs: jax.Array
    grab_paid: jax.Array       # (2,) climb_task.grab_paid: K_GRAB paid this episode
    cross_axis: jax.Array
    cross_sign: jax.Array
    off_t: jax.Array
    held_t: jax.Array
    slide_rung: jax.Array      # (2,) each hook's loaded run: its rung slot (-1: none),
    slide_ref: jax.Array       # where along it the run began,
    slide_net: jax.Array       # and how far from there it is now
    n_steps: jax.Array
    best_live: jax.Array       # the live potential's lowest this episode, by STALL_D steps,
    best_k: jax.Array          # and the step it got there (rl.rsi.STALL)
    dyn: dict                  # this episode's dynamics (`_dyn`): mass, friction, torque, lag
    wall: 'Wall'               # this episode's wall, copied at its reset: a new bank
                               # (Batch.set_bank) never moves a rung under a robot


class Wall(NamedTuple):
    """one wall: a lesson, or a generated one (rl.walls)"""
    rung_c: jax.Array          # (N_RUNG, 3) the map: centre, axis, half extent
    rung_a: jax.Array
    rung_h: jax.Array
    rung_valid: jax.Array
    slot_pos: jax.Array        # (N_RUNG, 3) what the slot geoms become
    slot_quat: jax.Array
    slot_size: jax.Array
    wall_pos: jax.Array        # (3,) the extra wall plane
    wall_quat: jax.Array
    front_pos: jax.Array       # (3,) the front wall plane: 0.40 m further back on family 4
    front_quat: jax.Array
    goals: jax.Array           # (2, 3)
    goal_mask: jax.Array       # (N_RUNG,)
    pts: jax.Array             # (N_PTS, 3) climb_task.route_table's points, padded far away
    pts_g: jax.Array           # (2, N_PTS) their route distance to each goal
    timeout: jax.Array
    family: jax.Array          # rl.walls family, -1 for a lesson
    probe: jax.Array           # which of its parameters sits at its candidate, -1 none
    probe_val: jax.Array       # ...and that candidate, so ADR counts a probe only at its own
    d0_row: jax.Array          # the lesson whose secured hang it starts from


class Tables(NamedTuple):
    """the walls an env can draw, leading axis = the rows: LESSON_KEYS, then a bank of
    generated walls (rl.walls) that `Batch.set_bank` refills without a recompile"""
    walls: Wall                # (R, ...)
    tau_idle: jax.Array        # (L + S,) climb_task's idle-hang torque, per start
    fight_idle: jax.Array      # (L + S,) ...and its internal force
    d0: mjx.Data               # (L + S,) the secured hang per lesson, then rl.rsi's starts
    ctrl0: jax.Array
    ngt0: jax.Array
    grabs0: jax.Array          # (L + S, 2) holds each hand has taken by then: 0 at a hang
    let0: jax.Array            # (L + S, 2) ...and whether it has let go since its last one
    con0: jax.Array            # (L + S, 2) `_contact` at each start: what Warp's reset reads
    on0: jax.Array             # (L + S, 2, N_RUNG)


class MjxClimb:
    """the task over every lesson, one model. Pure functions of (tables, state) for
    one env; `Batch` vmaps them."""

    def __init__(self, bank=0, impl='jax', ref=None, dr=False, ablate=()):
        self.bank = bank           # generated-wall rows after the lessons' (rl.walls)
        self.dr = dr               # dynamics randomization (climb_task.DR_*), training only
        self.ablate = frozenset(ablate)   # rl.train_ppo --ablate: REWARD_ABLATIONS
        assert self.ablate <= set(REWARD_ABLATIONS), self.ablate
        self.impl = impl           # what steps the physics: 'jax', or 'warp' (`step_batch`)
        self.ref = ref             # the starts' rows: rl.rsi's fixture, or another set's (rsi.dart_view)
        self.mc = scene_model()
        self._mass0 = jp.asarray(self.mc.body_mass)    # nominal masses, dr's idle scale
        m = self.mc
        self.mx = mjx.put_model(m, impl='jax')
        self.dt = float(m.opt.timestep)
        self.lo = m.actuator_ctrlrange[:, 0].copy()
        self.hi = m.actuator_ctrlrange[:, 1].copy()
        self.lo[FINGERS] = ct.GRIP_STOP
        sen = lambda n: np.arange(m.sensor(n).adr[0], m.sensor(n).adr[0] + m.sensor(n).dim[0])
        self.s_q = np.array([m.sensor('enc_' + j).adr[0] for j in JOINTS])
        self.s_dq = np.array([m.sensor('vel_' + j).adr[0] for j in JOINTS])
        self.s_tau = np.array([m.sensor('tau_' + j).adr[0] for j in JOINTS])
        self.s_acc, self.s_gyro, self.s_mag = sen('imu_acc'), sen('imu_gyro'), sen('imu_mag')
        self.s_f = np.stack([sen('ft_force_' + s) for s in 'LR'])
        self.s_t = np.stack([sen('ft_torque_' + s) for s in 'LR'])
        self.s_pad = np.array([m.sensor('grip_' + s).adr[0] for s in 'LR'])
        self.ft_site = np.array([m.site('s_ft_' + s).id for s in 'LR'])
        self.hook = np.array([m.body('hook_' + s).id for s in 'LR'])
        self.base, self.torso = m.body('base_link').id, m.body('torso_upper').id
        self.rung_geoms = np.array([m.geom(f'slot_rung{i}').id for i in range(N_RUNG)])
        # each hook's geoms that are paired with a rung: what climb_task._contact sums
        on_rung = {g for a, b in zip(m.pair_geom1, m.pair_geom2)
                   for g in (a, b) if {a, b} & set(self.rung_geoms)}
        self.hook_geoms = np.array([sorted(g for g in on_rung if m.geom_bodyid[g] == h)
                                    for h in self.hook])
        self.wall_geom = m.geom('slot_wall').id
        self.front_geom = m.geom('wall_front').id
        (self.front_n,) = ct.wall_normals(m)            # the front wall; the slot is its own
        self.weight = float(m.body_subtreemass[self.base] * -m.opt.gravity[2])
        self.rig = lidar.Rig(m)
        d = mjx.make_data(self.mx)
        con = d._impl.contact
        assert (con.dim == 3).all(), "every pair is condim 3 (rl.mjx_scene._mix)"
        # the four pyramid rows of each contact; their sum is its normal force
        self.efc4 = con.efc_address[:, None] + np.arange(4)
        self.tables = self._tables()
        self.pairs = (N_RUNG, True)      # what `mx` collides (set_pairs); the tables use all
        # the tables are made, and the estimator's kinematics run, on JAX whatever steps
        self.mxj, self._kd = self.mx, mjx.make_data(self.mx)
        self.public = [f for f in vars(self._kd) if f != '_impl']   # mjx.Data's own fields
        if impl == 'warp':
            import warp
            warp.config.quiet = True     # a line for every kernel it loads, otherwise
            self.mx = mjx.put_model(m, impl='warp')

    def set_pairs(self, n_rung, wall2):
        """step with the collision pairs of the first `n_rung` rung slots and, with
        `wall2`, of the extra wall only (rl.mjx_scene.build): the same geoms, sensors
        and state shapes, the tables untouched -- a wall whose rungs and walls all lie
        inside moves exactly as with every pair (`rl.mjx_check physics` asserts it)"""
        if (n_rung, wall2) == self.pairs:
            return
        mc = scene_model(n_rung, wall2)
        mx = mjx.put_model(mc, impl='jax')
        shape = lambda x: [a.shape for a in jax.tree_util.tree_leaves(mjx.make_data(x))]
        assert shape(mx) == shape(self.mxj), "a pair set that changes the state's shapes"
        self.mx = mx if self.impl == 'jax' else mjx.put_model(mc, impl='warp')
        self.pairs = (n_rung, wall2)

    # ---- per-lesson tables ------------------------------------------------------
    @staticmethod
    def rows(layouts):
        """lesson layouts (rl.mjx_scene.lesson_layout's, or rl.walls') -> the per-row
        arrays of Tables. A generated wall starts from the secured hang of the lesson
        it names (`hang`: 1, leaning on the front wall, or 4, hanging free): its start
        rung holds the keyframe's hooks and nothing else of it is within
        rl.walls.CLEAR of the robot there (rl.walls.Checker)."""
        from .walls import FAMILIES
        out = []
        for lay in layouts:
            sl = slots(lay)
            n = len(lay['rungs'])
            c = np.zeros((N_RUNG, 3)); a = np.zeros((N_RUNG, 3)); h = np.zeros(N_RUNG)
            for i, (_, ci, ai, hi, _) in enumerate(lay['rungs']):
                c[i], a[i], h[i] = ci, canon_axis(ai), hi     # whatever wrote the layout
            mask = np.zeros(N_RUNG, bool)
            mask[lay['goal_rungs']] = True
            P, G = ct.route_table([(c[i], a[i], h[i]) for i in range(n)], lay['goals'])
            assert len(P) <= N_PTS, f"{len(P)} route points: raise N_PTS"
            pts = np.full((N_PTS, 3), FAR_PT)
            pts[:len(P)] = P
            pts_g = np.full((2, N_PTS), FAR_PT)
            pts_g[:, :len(P)] = G
            f, pr = lay.get('family', -1), lay.get('probe')
            probe = -1 if pr is None else [s[0] for s in FAMILIES[f]].index(pr)
            out.append(dict(rung_c=c, rung_a=a, rung_h=h, rung_valid=np.arange(N_RUNG) < n,
                            slot_pos=sl['rung_pos'], slot_quat=sl['rung_quat'],
                            slot_size=sl['rung_size'], wall_pos=sl['wall_pos'],
                            wall_quat=sl['wall_quat'], front_pos=sl['front_pos'],
                            front_quat=sl['front_quat'], goals=lay['goals'], goal_mask=mask,
                            pts=pts, pts_g=pts_g,
                            timeout=lay['timeout'], family=f, probe=probe,
                            probe_val=lay.get('probe_val', 0.0),
                            d0_row=lay.get('d0_row', LESSON_KEYS.index(lay.get('hang', 1)))))
        return {k: np.stack([r[k] for r in out]) for k in out[0]}

    def _tables(self):
        layouts = [dict(lesson_layout(k), d0_row=i) for i, k in enumerate(LESSON_KEYS)]
        layouts += [dict(lesson_layout(1), family=1)] * self.bank   # until a bank is set
        w = Wall(**{f: jp.asarray(v) for f, v in self.rows(layouts).items()})
        L = len(LESSON_KEYS)
        qpos0 = jp.asarray(np.stack([hang_qpos(LESSONS[k].get('pitch', 0.0)) for k in LESSON_KEYS]))
        d0, ctrl0, ngt0 = jax.jit(jax.vmap(self._secure))(
            w.slot_pos[:L], w.slot_quat[:L], w.slot_size[:L], w.wall_pos[:L], w.wall_quat[:L],
            w.front_pos[:L], w.front_quat[:L], qpos0)
        tau_idle = jax.vmap(lambda d: jp.abs(d.sensordata[self.s_tau]).sum())(d0)
        fight_idle = jax.vmap(lambda d: self._internal(d, self._sensors(d)))(d0)
        grabs0 = jp.zeros((L, 2), jp.int32)
        ref = rsi.load() if self.ref is None else self.ref
        if ref is not None:
            # rl.rsi's starts after the lessons' hangs (a wall's d0_row picks one): each
            # state forwarded on the wall it was found on, its clock at 0; the effort and
            # fight baselines stay those of the secured hang its wall begins from
            c = ref['climb']                                            # one wall per climb
            cw = [rsi.climb_wall(ref, i) for i in range(len(ref['climb_family']))]
            sl = {k: v[c] for k, v in self.rows(cw).items()}
            r0 = np.array([LESSON_KEYS.index(x['hang']) for x in cw])[c]   # each row's hang
            # 256 starts at a time: all at once the forward's scratch grew with the starts
            # (17.5k: 5 GiB, kept by XLA's pool), and four preflight processes building it
            # together left gpu11's 3090 no room for 4096 envs (2026-10-14)
            # (the last batch padded with the last start: one compile)
            base = mjx.make_data(self.mx)
            fwd = jax.jit(jax.vmap(lambda p, qt, sz, wp, wq, fp, fq, q, v, c: mjx.forward(
                self._slot_model(p, qt, sz, wp, wq, fp, fq),
                base.replace(qpos=q, qvel=v, ctrl=c, time=jp.zeros(())))))
            args = [sl[k] for k in ('slot_pos', 'slot_quat', 'slot_size', 'wall_pos', 'wall_quat',
                                    'front_pos', 'front_quat')] + \
                [ref['qpos'], ref['qvel'], ref['ctrl']]
            n = len(ref['qpos'])
            parts = [fwd(*(jp.asarray(a[np.minimum(np.arange(i, i + 256), n - 1)]) for a in args))
                     for i in range(0, n, 256)]
            ds = jax.tree_util.tree_map(lambda *x: jp.concatenate(x)[:n], *parts)
            cat = lambda a, b: jp.concatenate([a, b])
            d0 = jax.tree_util.tree_map(cat, d0, ds)
            ctrl0, ngt0 = cat(ctrl0, jp.asarray(ref['ctrl'])), cat(ngt0, jp.zeros(n))
            tau_idle, fight_idle = cat(tau_idle, tau_idle[r0]), cat(fight_idle, fight_idle[r0])
            grabs0 = cat(grabs0, jp.asarray(ref['grabs'], jp.int32))
        con0, on0 = jax.jit(jax.vmap(self._contact))(d0)
        # `update`'s let_go along each climb, row by row: a start begun with it cleared lost
        # every hold its hands were between letting go and taking. gpu14's lesson 8 at 0.55
        # sat at 0 % from the hang 365M steps: the references' second hand lets go at 14.3 s
        # and is booked at 17.4 s, so their last 3 s of starts could not succeed unless that
        # hand let go and took hold again (open loop: never), the books there sat at 30-75 %
        # and held the frontier at the climb's end
        let0 = np.zeros((len(grabs0), 2), bool)
        if ref is not None:
            con, g, c = np.asarray(con0)[L:], ref['grabs'], ref['climb']
            free, held = con <= 0.0, con > ct.HOLD_LOAD
            for k in range(1, len(c)):
                if c[k] == c[k - 1]:
                    let0[L + k] = (let0[L + k - 1] | (free[k] & held[k, ::-1])) & ~(g[k] > g[k - 1])
            last = np.r_[np.nonzero(np.diff(c))[0], len(c) - 1]
            assert not ((g[last] < 1) & ~let0[L + last] & ~free[last]).any(), \
                "a climb's last start holds a hand whose first hold can never be booked"
        return Tables(walls=w, tau_idle=tau_idle, fight_idle=fight_idle, d0=d0, ctrl0=ctrl0,
                      ngt0=ngt0, grabs0=grabs0, let0=jp.asarray(let0), con0=con0, on0=on0)

    @staticmethod
    def wall(T, row):
        """row `row` of the tables' walls"""
        return jax.tree_util.tree_map(lambda x: x[row], T.walls)

    def _env_model(self, w, dyn):
        """the shared model with this wall's rungs and extra wall in the slot geoms, and with
        `dr` this episode's masses, friction and torque limits (`_dyn`)"""
        mx = self._slot_model(w.slot_pos, w.slot_quat, w.slot_size, w.wall_pos, w.wall_quat,
                              w.front_pos, w.front_quat)
        if not self.dr:                  # the nominal model, the graph as it was without dr
            return mx
        return mx.replace(body_mass=mx.body_mass * dyn['mass'],
                          body_inertia=mx.body_inertia * dyn['mass'][:, None],
                          # every contact is an explicit <pair> (rl.mjx_scene): geom_friction is never read
                          pair_friction=mx.pair_friction.at[:, :2].multiply(dyn['fric']),
                          actuator_forcerange=mx.actuator_forcerange * dyn['torque'][:, None])

    def _dyn(self, key=None):
        """an episode's dynamics: each body's mass and inertia scale, one sliding-friction
        scale, each actuator's torque-limit scale and the substeps a setpoint lands late --
        drawn from `key` (climb_task.DR_*), or the nominal model's"""
        nb, nu = self.mc.nbody, self.mc.nu
        if key is None:
            return dict(mass=jp.ones(nb), fric=jp.array(1.0), torque=jp.ones(nu), lag=jp.array(0))
        km, kf, kt, kl = jax.random.split(key, 4)
        u = lambda k, lo, hi, n=(): jax.random.uniform(k, n, minval=lo, maxval=hi)
        return dict(mass=u(km, 1 - ct.DR_MASS, 1 + ct.DR_MASS, (nb,)),
                    fric=u(kf, 1 - ct.DR_FRICTION, 1 + ct.DR_FRICTION),
                    torque=u(kt, *ct.DR_TORQUE, (nu,)),
                    lag=jax.random.randint(kl, (), 0, ct.DR_LAG + 1))

    def _slot_model(self, pos, quat, size, wpos, wquat, fpos, fquat):
        mx = self.mx
        mx = mx.replace(
            geom_pos=mx.geom_pos.at[self.rung_geoms].set(pos).at[self.wall_geom].set(wpos)
            .at[self.front_geom].set(fpos),
            geom_quat=mx.geom_quat.at[self.rung_geoms].set(quat).at[self.wall_geom].set(wquat)
            .at[self.front_geom].set(fquat),
            geom_size=mx.geom_size.at[self.rung_geoms].set(size))
        if mx.impl == mjx.Impl.WARP:
            # Warp's broadphase culls a pair by each geom's bounds, the parked slot's
            # (a 0.2 m rung) unless they are the rung's: a hook off its middle fell through
            r, h = size[:, 0], size[:, 1]
            box = jp.concatenate([jp.zeros((len(r), 3)), jp.stack([r, r, r + h], -1)], -1)
            mx = mx.replace(geom_rbound=mx.geom_rbound.at[self.rung_geoms].set(r + h),
                            geom_aabb=mx.geom_aabb.at[self.rung_geoms].set(
                                box.reshape((len(r),) + mx.geom_aabb.shape[1:])))
        return mx

    def _place_static(self, d, w):
        """the wall's rungs and extra wall where Warp reads them: in the data. Its
        kinematics leaves the world's own geoms where `make_data` put them -- parked,
        and no hook ever touched a rung -- where JAX's places them from the model"""
        from mujoco.mjx._src.math import quat_to_mat
        g = np.r_[self.rung_geoms, self.wall_geom, self.front_geom]
        quat = jp.concatenate([w.slot_quat, w.wall_quat[None], w.front_quat[None]])
        return d.replace(geom_xpos=d.geom_xpos.at[g].set(jp.concatenate([w.slot_pos, w.wall_pos[None],
                                                                         w.front_pos[None]])),
                         geom_xmat=d.geom_xmat.at[g].set(jax.vmap(quat_to_mat)(quat)))
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
