Thuong180702/Bimanual-wall-climbing-robot/(commit log)

2026-09-01 Bimanual wall-climbing robot: MuJoCo model, classical controller, PPO curriculum
    The model (urdf/) is an 11 kg two-armed robot hanging from wall rungs by hooked
    hands, with 86 sensors and a verified hanging keyframe.
    controller/ is a classical stack built on hardware-available signals only: an
    anchor-rooted state estimate, exact relative Jacobians for the pinned chain, a
    178-point hold graph with A* routing, and the climbing primitives. It traverses and
    descends a row on both hands; ascent still falls.
    rl/ is a PPO curriculum: nine lesson scenes ordered by difficulty, generated from
    scene.xml with widened shoulders and a rubber grip pad, plus the task, reward, eval
    and rendering around the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
2026-09-03 requirements: correct the per-platform torch notes
    Measured by resolving win_amd64 wheels: on Windows `pip install torch` pulls 128 MB
    and no nvidia-* packages, so the CPU index the old comment suggested changes nothing
    there. The CUDA runtime split into separate multi-GB nvidia-* packages is a Linux
    detail, and that is where the CPU index is worth using -- which for this project it
    usually is, since --device cuda has no measurable work to offload.
2026-09-03 Add rl.status, and put per-lesson success in the checkpoint line
    Monitoring a run meant either waiting for a checkpoint line every 100k steps or
    reading state.json by hand, and neither said how each lesson was doing.
    rl/status.py reads a run's checkpoint and prints steps, pool, per-lesson success
    rate, and the best score so far, with --watch to refresh. It imports nothing heavy --
    no torch, no mujoco -- so it starts instantly and does not compete for cores with
    the run it is reporting on. It also flags a checkpoint that has stopped being
    updated, which is what a dead run looks like from outside.
    The periodic checkpoint line now carries the same per-lesson rates, so the training
    window alon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
2026-09-03 Close three defects the 10.4M-step run exposed
    Audit of out/win1 (10,418,928 steps, lesson 1 at 85%, lesson 2 at 0%) found three
    things wrong, two of them in reward code I wrote.
    1. The dangle penalty was evadable. It charged a continuous stretch off the wall, so
    88 short hops kept every stretch under the grace: the right hand was off the rung
    for 79% of the episode and paid 0.13 in total. The budget is now cumulative over
    the episode and capped as a fraction of it (DANGLE_MAX_FRAC), so flutter cannot
    dodge a share. Replayed on the same policy it now charges 11.04.
    2. Checkpoint.score() used the mean over the active pool, so unlocking lesson 2 at 0%
    halved it. best_model.zip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
2026-09-03 Price effort, internal force and time, so the gait has to be economical
    The reward could tell climbing from sliding but not good movement from bad, and the
    10.4M policy showed why that matters: it reached the goal with both hands chattering
    the load majority 6-9 times a second and never completing a single grab cycle.
    Measured against a robot hanging still with zero action, which costs 29.6 N.m of
    joint torque and 107 N of grip:
    torque both hands' load
    hanging still 29.6 N.m 107 N
    lesson 1 (4 s) 55.5 N.m 131 N
    lesson 2 (60 s) 145.1 N.m 202 N <- on a 109 N robot
    202 N of grip on a 109 N robot is ~95 N of the two arms pulli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
2026-09-05 rl.render: --best, and colour the hands by whether they are actually gripping
    Auditing win2 needed the best checkpoint, which video() could not load, and needed
    the finger state visible, which no camera angle shows -- an open hook and a gripping
    one look identical.
    --best renders best_model.zip. The forearm/wrist/hook chain is now tinted per frame:
    green while the finger is inside the -40..-10 deg band the model README measures at
    >1200 N of pull-off, red outside it (764 N at 0 deg, 72 N past -45). The hook alone
    is a few centimetres of mesh and read as a grey speck, so the colour runs up the
    wrist chain.
    On win2's best policy the hands start green on the keyframe grip and go red within
    ab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
2026-09-05 Require a real grip, a real seat and a real grab before anything counts
    Tracing win2's best policy step by step showed the gait the user described: one hand
    parked in the air carrying under 10 N for 89% of the episode, while the other never
    left the rung at all -- gap 3-24 mm throughout -- and ratcheted along it by cycling
    its finger. The body did the travelling. It scored success and +13.58.
    Four holes let that through, and all four are closed here.
    1. Nothing ever checked the finger. The simulator lets an open hook carry the whole
    robot, so closing cost action and bought nothing. `_holding` and `_success` now
    require the finger inside GRIP_BAND. There are TWO ways out of that band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
2026-09-05 Judge a hold by contact force, not by any distance threshold
    The 20.8M-step win3 run reported 2.5 % on lesson 1 and never unlocked lesson 2.
    Re-measured, the same policy scores 40 % and averages 8.1 / 10.3 real grab cycles
    per episode. It had learnt the alternating gait; nothing could see it.
    Three proxies for "is this hand on its hold" disagreed with each other and with
    the physics, and they were wired to different places -- the reward used a seat
    gap, the episode was ended by env.latched. So every one-handed phase ran 0.6 s
    from a spurious `released` and a -10 while the reward said the hand was fine.
    Measured over one episode: latched read False on BOTH hands for 32 % of the
    steps, 89 % o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
2026-09-07 Pay only for climbing the sensors can see: no jumps, no dragging, holds placed by reach
    The 21M-step win4 run: lesson 1 at 95 %, lesson 2 at 0 % for the 16M steps it
    was in the pool. Lesson 1 was solved by a jump gait -- the right hook let go and
    re-caught within 1-5 control steps while the left hung in the air, off 96 % of
    the time, 0.0 load swaps per episode -- with the left hand's brief taps banking
    what each jump had covered. Lesson 2 was never reached: neither hook touched
    seg1 or seg2 in 30 episodes.
    The reason is not difficulty. The observation is map-relative through an
    estimator rooted in the holding hand, and a jump leaves nothing to root it in:
    measured 0.6-2.8 m of drift along t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
2026-09-07 Two rungs below lesson 1, and nudges that never outweigh a fall
    win5, 15.3M steps under the no-jump / no-drag / reach-odometry rules: lesson 1
    at 0/40, best checkpoint the first one. It never fell -- every episode ran the
    full 60 s -- it hung from the left hook, fluttered the right in place 9-20
    times per episode (enough for its MIN_GRABS), moved 0.18 m, and its action std
    collapsed from 1.0 to 0.13. The pose estimate, meanwhile, was exact: anchor
    3-20 mm through the whole episode, free hand 9 mm on approach. The rules did
    their job; the landscape did not.
    Doing nothing cost -33 (K_STALE 0.01 x 2 hands x 60 s = -28.6) against -10 for
    a fall, so the initial gradient pointed at the floor, and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
2026-09-07 Credit progress relative to the holding hand; a right-hand step lesson
    The 2M local run on the new curriculum reached lesson 2 -- and solved lesson 1
    by an inchworm: the loaded right hook dragged along the rung 864 mm per
    episode while the free left hand tapped its way forward. Every tap re-seated
    the left hand where it already was RELATIVE to the right and banked what the
    drag had carried the body, so one drag advanced both world anchors: bank +7.9,
    reach +3.3 against slide -8.8, still net positive. 20 % success, the map
    0.2-0.8 m off again.
    Doubling the slide charge to 20/m was tried first and it hurt: the next 3M
    steps never left the very first lesson (30 %, std 0.42), because the same
    c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
2026-09-07 A gyro complementary filter for the torso attitude; retire the swing-angle model
    The bare triad reads the body's own swing as tilt: 26.5 deg rms off while
    moving, the free hand 91-130 mm from where it was. The gyro summed over the
    substeps carries the attitude across each control step and the triad pins the
    drift with a 2 s time constant: 3.6 / 2.1 deg rms on lessons 1 / 2, the free
    hand 16 / 12 mm. A swing-angle model of the seated hook was worse than the
    triad even with the true angle (181 mm) -- a loaded hook does not sit still in
    its throat -- so _side_guess, _pivot_only and R_seat go.
2026-09-07 Trust a seated anchor through the hand-over
    At a hand-over the old hand drops under HOLD_LOAD before the new one is over
    it, so the anchor switched to the new hand's STALE hold from its previous
    tenure. Measured on the 3M policy: 86 of 129 switches had no step with both
    hands confirmed and baked in 62 mm each, 5.3 m over four episodes, against
    1 mm for the 43 that did. The anchor's hold is now trusted while its hook is
    still on the rung -- pad contact and the finger in the band, loaded or not --
    and for one step after, so the new hand is placed by reach from it before the
    switch. 62 -> 28 mm per switch on the same policy; the rest is the anchor
    settling under load, which no sensor here can s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
2026-09-07 A hold counts only while the other hand is loaded
    Three points of contact. A hold taken with nothing else on the wall was a
    jump's landing or a hand-over with a gap in it, and the gap is where the map
    goes wrong: 86 of 129 anchor switches on the 3M policy had no step with both
    hands confirmed and baked in 62 mm each. Gated, the same curriculum unlocks at
    the same pace (lesson 2 at 0.94M against 0.89M), hand-overs with overlap go
    from 30 % to 53 %, and the anchor's error at the end of a lesson-1 traverse
    drops from 540-980 mm to 27-320 mm. What is paid is what can be seen.
2026-09-07 See the ends of the rung; lesson 1.5, a gap an ordinary step crosses
    Lesson 2's 0.25 m gap was never crossed once in ~2M steps of exposure, in three
    local runs. Measured on the last: when the free hand came closest to the far
    ledge it was 120-160 mm short, the hands were 627-689 mm apart -- the static
    reach limit -- and the holding hand was still 0.47-0.54 m from the edge of its
    own segment. The climber's order -- lead hand to the edge, trailing hand up
    beside it, then reach -- was never once rewarded, because a 0.25 m gap is not
    crossed by accident, and the edge of a rung was not in the observation at all:
    the three nearest rungs were given as nearest-point offsets, which read 0
    anywhere al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
2026-09-08 Write a lesson's scene on demand
    urdf/lessons/ is generated from scene.xml and gitignored, so a pull that adds a
    lesson leaves the clone without a scene for it -- and MuJoCo reports that as a
    bare ParseXML error, once per worker, which is what a fresh `git pull` on the
    training machine hit for lessons -2, -1 and 1.5. xml_path now writes the file if
    it is not there; nothing that exists is regenerated, so editing scene.xml or a
    spec still needs `python -m rl.lessons`.
    write() goes through a temp file and an atomic rename, because the 8
    SubprocVecEnv workers build their environments at the same moment and would
    otherwise parse a file another was still writing. Verified from an empty
    urdf/lesso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
2026-09-08 The finger stop at the band's edge; a failing new lesson drawn a quarter of the time
    win8, 10.8M steps: lesson 1 passed at 2.66M -- 95 %, two hands alternating,
    1.0 m in 194 steps -- and lesson 1.5 (a 0.12 m gap) then sat at 0 % for 8M
    steps and pulled lesson 1 down to 32 % with it. On lesson 1.5 the free hand
    reached the far ledge, 35-78 mm from its axis by step 25-47, and hovered there
    for the rest of the episode while the estimate put the ledge 200-320 mm away.
    The estimate was wrong because the anchor had stayed on a hand that was
    moving: the other hand was carrying 48-159 N and was not confirmed, because
    its finger read -40..-44 deg. The stop sat at the cliff, -45, and a policy that
    sq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
2026-09-08 Close the one-step lift pump: slide charged with load at either end, MIN_OFF
    The finger-stop fix uncovered a pump the -45 deg stop had been hiding. With
    every touch now in band, a 3M check run learnt to lift the right hand for one
    step -- credited its 30 mm of relative approach -- and set it down loaded: the
    30 mm back was neither debited (a loaded hook is credited nothing either way)
    nor charged, because the slide charge asked for load at BOTH ends of the step
    and a touch-down has it at one. 578 "holds" and 20 m of bank per episode on a
    body that moved 0.4 m, +78 per episode against +25 for crossing the gap.
    The slide is now charged with load at either end of the step -- the same
    policy pa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
2026-09-08 Credit by the load at the start of the step; no MIN_OFF, slide back to sustained
    The one-step lift pump, closed where it lives. Classified by the load at the
    END of a step, a lift (free at the end) credited its 30 mm forward and the
    touch-down (loaded at the end) credited nothing for the 30 mm back -- 578
    "holds" and 20 m of bank per episode. The two closures tried first were the
    wrong tools: a slide charge with load at EITHER end of the step taxed every
    seat and unseat of an honest gait (the 95 % lesson-1 policy paid 1.5 m per
    episode of it and fell to 50 %), and MIN_OFF -- three steps clear before a
    hold counts -- refused the 1-2-step hops that honest hands take 70-90 % of
    the time, so the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
2026-09-08 Progress measured at the rung; credit by the load at both ends of the step
    win9 (5.3M): lessons -2..1 at 80-92 %, lesson 1.5 at 0/40 throughout. The
    left hook walked off the end of its segment and hung 0.34-0.47 m below the
    far one for 58 s in 20/20 episodes (7/8 on mac13): the 3D distance to a goal
    1.4 m along the wall paid +0.3-0.4 m for the dive. Progress is now measured
    at the hand's rung point (bank) with the detour off the rung in the live
    reach only, both hands both ways; the route test asserts the dive itself.
    The check run of that (mac14) pumped +241/episode: a loaded hook's off-line
    distortion refunded on every re-seat (detour now out of the bank), and the
    mirror of win8's one-ste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
2026-09-08 README: what the check run of the rung-measured progress showed
    mac16 (3M): the dive is gone; lesson 1.5 still 0/40 because the loaded hook
    creeps 85-210 mm per episode while it holds and the anchor does not, so the
    far segment reads 60-210 mm too far and the hook is pushed into its end face.
    The end-face landmark measured: exact when true, 2x false fires that the
    wrist F/T cannot separate. Lesson -1 collapsed late in both check runs.
2026-09-08 A lip pad on the hook, the rung end as a landmark, seats not geometry, draws by steps
    mac16 showed the loaded hook creeping 85-210 mm per episode while it holds,
    which the estimator cannot see on a smooth rung; at a gap the far segment
    then read 60-210 mm too far and the hook was pushed into its end face. The
    end face is the one map feature a free hand can feel: a second touch zone
    on the hook's lip (every end contact at z = -110 mm in the hook frame, every
    seat at z >= -98) gates `_end_contact`, which moves the anchor's map point
    so the mouth sits on the end. Replayed on mac16: -5 mm at contact (was +89),
    123 firings instead of 1366 for the F/T-only rule, silent on lesson 1.
    The map and th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
2026-09-08 No added sensors: the lip pad is gone; the anchor follows the SLAM position instead
    The robot has only the real robot's sensors (lidar SLAM, encoders, IMU, hand
    F/T). The loaded hook's creep along the rung, which no arm sensor can see, is
    what the SLAM sees: `ClimbingEnv.slam()` is the base position with 2 cm of
    noise, and `_sense` low-passes the anchor's map point along its rung toward
    it (SLAM_TAU 1 s). Replayed on the mac16 policy: anchor error p50 20 mm /
    p90 34 everywhere (was 51/149 on lesson 1.5, 145-179/300 on lesson 1) and
    -18 +-27 mm at the far-segment contact (was +89, 60-210). The slam test
    creeps the loaded hook 25 mm under a pull and asserts the anchor follows.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
2026-09-08 Lessons 1.1, 1.2, 1.35: stop at the end of a rung, then gaps of 0.04 and 0.08 m
    mac19 (SLAM tracking): lessons -2..0 at 100 %, lesson 1 at 95 % with the
    cleanest gait yet, the anchor right to 4/16 mm -- and lesson 1.5 at 0/40 in a
    new basin: the lead hook past its last seat, brushing the end, never
    retreating 5-10 cm to a seat; the trailing hand never moving. Nothing had
    ever asked a hand to land short of somewhere, and lunging across 1.5's gap
    from the last seat with the partner at its start needs 0.66 m of arm
    separation against a 0.67 limit (0.79 on lesson 2: impossible). Lesson 1.1
    ends the rung 3 cm past a goal one opener away; 1.2 and 1.35 step the reach
    a lunge needs 0.58 -> 0.62 -> 0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
2026-09-08 Lessons 1.2 and 1.35 cross one gap each; the two-gap traverse stays lesson 1.5
    Resumed to 7M, the mac20 policy showed the climber's order on every 1.2
    replay -- left to the last seat, right up beside it, left over, right
    following -- in 5-9 cm steps, and took short steps everywhere: 0.5 m of the
    1.4 m in 60 s on 1.2 (0/40 for 3.3M) and lesson 1 timing out with it
    (95 % -> 20 %). A lesson that never passes keeps its warm-up share. Ask
    for the crossing, not the crossing plus the distance.
2026-09-08 The SLAM attitude pins the gyro filter; SLAM_TAU 0.3 s
    Measured on the mac20 policy during the climb (not on a still hang): the
    triad-referenced filter was 4 deg p50 / 6 deg p90 / 15 max off -- every
    hand-over is an impact and the triad reads 18-30 deg -- which on the 0.5 m
    lever to the hand was 35-55 mm, the floor under what the SLAM position had
    fixed. With the SLAM attitude as the reference: 0.2 / 1-3 deg, the free
    hand 36/80 -> 13/40 mm on lesson 1.2 and 44/85 -> 16/23 on lesson 1, and
    "on a seat" while in a gap on 2.7 % of steps instead of 7.5 %. SLAM_TAU
    1 -> 0.3 s from the same sweep; a 3-axis anchor correction was worse.
2026-09-08 PPO: 256x256 policy, 8192 steps per update
    One policy carries seven lessons of a 145-dim observation. On SB3's 64x64
    with 2048-step updates it swung between them: lesson 1 fell 92 % -> 5 % in
    2M steps three times in one run while the gap lessons were being learnt,
    the estimator right throughout (15/25 mm, 0.2 deg).
2026-09-08 Train under the triad-attitude estimator again; variance floor in VecNormalize
    Six fresh runs with the SLAM attitude and/or SLAM_TAU 0.3 never learnt
    lesson -1 (0 % for 1-4M steps); the triad attitude with 1 s passes it in
    0.3-0.4M (bisect A-E in the README). A trained policy runs fine under all
    of them and the reward is ground truth in all of them; the mechanism is
    open. The floor (epsilon 1e-4) was the first hypothesis and is not it, but
    the run with it had the fastest early curriculum of any (lesson 1.2 by 1M).
2026-09-09 Curriculum: the frontier lesson gets 60 % of the steps, not 25 %
    Drawing by episode gave the newest lesson 96 % of the samples and a stuck
    one took lesson -1 to 0-2 % (mac14/16/17); dividing by episode length
    fixed that but 25 % starved the frontier -- lesson 1 got a quarter of the
    samples win9 gave it, and win10 was still at 0 % at 1.4M where win9 passed
    it inside 1M. At 60 % the lessons behind still get 40 % of the steps.
2026-09-09 Curriculum: the pool's steps go where the failures are
    Each lesson's share of the steps is how much it still fails, so a lesson at
    0 % is fed whether it is the frontier or the one behind it that regressed.
    Four rules measured on 2.5-4.5M-step runs: by episode gives the newest 96 %
    and kills the one behind (mac14/16/17); a fixed 25 % starves the frontier
    (win10 lesson 1 at 0 % for 1.4M+); a fixed 60 % reached lesson 2 in 2M
    (mac26) but left lesson -1 at 0 %; this one held every lesson at 85-100 %
    through 4.5M (mac27). Squaring the need stalls the early curriculum (mac28).
2026-09-09 Bound the action noise; --resume --from-best
    win11 peaked at 8.0M (lesson 1.2 100 %, 1.35 92 %, 1.5 52 %, the best policy
    this project has had) and by 15.3M was at 0 % on 1.5 and 2, with the action
    std at 1.33 against 0.48 at the peak and 4.24 on one joint. The
    deterministic policy failed too, so the mean degraded, not the sampling:
    with most of the pool failing the advantages flatten and ent_coef is the
    only term left with an opinion. log_std is now clamped to its starting
    value after every rollout. Resuming the 8M checkpoint with it for 1.2M
    steps holds std at 0.46-0.48 and every lesson with it.
2026-09-09 Lesson 1.7: one 0.18 m gap, the crossing between 1.5 and lesson 2
    A crossing is a reach from the last seat of one segment to the first seat
    of the next: 185 mm on lesson 1.5, 315 mm on lesson 2, against hops of
    226 mm median and 307 mm p90 for this gait. Lesson 2 sits past the p90 of
    the step the policy has, with nothing in between, and has been 0 % in every
    run that reached it. 1.7 makes that reach 245 mm -- one ordinary hop --
    and is a single crossing like 1.2 and 1.35, the two lessons that took the
    gap skill from never to 90-100 %.
2026-09-09 Re-mount the hook so the elbow flexes like a human's
    The user, watching a pull-up: the elbows fold inward, where a person's go
    out or forward. Measured on the 8.0M policy over loaded rising steps, the
    right elbow sits 44 mm inboard of the shoulder-wrist line (107 at p10),
    and the shoulder rotation is at its +-90 stop on every one of those steps.
    Raising the arm overhead turns the hook's throat away from the wall and
    175 deg has to come back about the arm axis; the roll has the human +-85,
    so the shoulder rotation supplies the rest and is pinned -- and that
    rotation is what aims the elbow hinge. No posture within 15 deg of a
    latching hook orientation had the elbow outboard.
    Fixed at the moun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
2026-09-09 Wrist: human flexion to +80, a mechanical stop at -30 extension
    Measured on a hanging hook while turning the wrist: flexion wraps it
    tighter (44 N at 0 deg, 167 at +50, 143 at +80) while extension unloads it
    (20 N at -40, 13 at -55, 0 at -60 -- off the rung). The full human range
    handed the policy 70 deg of letting go and it took it: lesson -2 at 0 %
    for 1.5M steps, where the model before it reached lesson 1.2. Same shape
    as the finger's GRIP_CLIFF, same answer: a stop, not a penalty. -30..+80
    is three times the old travel on the side that helps.
2026-09-10 Stamp the generated lesson scenes so a model edit cannot be missed
    win13 trained 7.6M steps on the robot as it was before the hook re-mount:
    urdf/lessons/*.xml is generated and gitignored, xml_path wrote a scene only
    when the file was missing, and the files were already there from the run
    before. The training log said 98 % on lesson 1.2 while every replay of that
    checkpoint fell 12/12 -- and the same checkpoint scores 12/12 against the
    pre-fix scene, which is what identified it. Each scene now carries a hash
    of scene.xml, its own spec and the patch lists, and is rewritten when they
    move.
2026-09-11 Wrist back to +-25: past +25 of flexion the hook cannot let go
    win14 trained 5.5M steps on the fixed robot with the wrist at -30..+80.
    Lesson 1 stayed at 0 % for 3.5M: the right wrist sat at the +80 stop 95 %
    of the time and the right hand took zero holds in twelve episodes.
    Measured with the finger opened and the arm lifted: 0 and +25 deg release
    (0 N), +50 re-catches (54 N), +80 cannot let go (47 N with the finger
    open). Every +80 configuration tried stalled early; +-25 on the same fixed
    robot reached lesson 1.2 in 1.5M. A hook's wrist is its grip, and +-25 is
    the range where it can both hold and release.
    The elbow fix did what it was for in the same run: shoulder rotation at
    -45/-4 deg i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
2026-09-12 win15 3: lesson 2 crossed, and --ent-coef never reached a resume
    10M steps from win15 2's best take lesson 1.5 to 60%, which unlocks 1.7 at 88%,
    which unlocks lesson 2 -- 35% logged, 3/12 on replay, the first time this project
    has passed it. _success is strict there: both hooks seated on rung_seg2, each
    within 150 mm of its goal, both loaded, each with a real hold taken -- two 0.25 m
    gaps crossed, nothing a ratchet can fake.
    The freeze that capped win15 2 is breaking: both-hands-confirmed steps 12% -> 22%,
    anchor switches 10.8 -> 12.8, lesson-1.5 timeouts 1 -> 0, losses moving from
    timeouts into falls. Estimator error looks worse (42 -> 75 mm mean) but the rate
    that actually precedes a fall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
2026-09-12 render: index a multi-episode clip by start time and outcome
    An 8-episode lesson-2 video is 6.7 minutes and every episode looks alike from
    the thumbnail, so video() now prints "0:00 success | 0:52 timeout | ..." -- the
    playback second each episode starts at, with how it ended.
2026-09-12 Lesson 1.85: one 0.25 m gap, because 1.7 -> 2 changed two things at once
    Measured on win15 3's best over ten lesson-2 episodes, at each episode's best
    reach: in 6 of 10 the lead hook crossed while the trailing one was still 246-313
    mm short of its own seat edge, arms at 583-651 mm of a ~671 mm span, the free
    hook landing 3-25 mm onto the next seat -- the near edge. All six failed. The
    four that kept the trailing hand within 64 mm of the edge (separation 417-573 mm)
    hold both successes. Full stretch also costs 104.2 N.m against 71.9 from close,
    and K_EFFORT prices that gap at 0.24 over a whole reach against a 20-point
    success/fail swing -- measured, not worth re-tuning.
    So the step from 1.7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
2026-09-14 win16: a 600k A/B from the best checkpoint rules out both mechanisms
    Both explanations for win16's collapse came from snapshots, so both were
    tested from the 5.75M checkpoint with lesson 3 in the pool: 600k steps per
    arm, one arm with the reward unchanged and one with a terminal fall charge
    (FAIL_R - cost_ema / (1 - gamma)).
    The unchanged reward got out of the lesson-3 trap by itself. Its critic went
    from -18.5 to -3.9 per holding state, above the -10 fall, and lesson 1 stayed
    at 10/10, so the -18.5 at unlock was a transient of first exposure. The fall
    charge showed no benefit: lesson 1 dropped to 3/10 with 7 falls, and the free
    hook reached up past the rung on 38.6% of steps, which the con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
2026-09-15 win16 2: collapses without lesson 3; the finger stop gets 3 deg of margin
    win16 2 resumed the 5.75M checkpoint with lesson 3 kept out of the pool. Its
    best (6.09M) is the best policy yet, with lesson 2 at 78% logged and 7/10 on
    replay. By 11.36M lessons 1.5 and 2 were 0/10, all timeouts. That rules out
    lesson 3. A cross-swap rules out the normalisation: the latest model with the
    best statistics still fails 0/5. The collapsed gait is a freeze: the right hook
    carries 100% of the load, and the left touches down with its finger open at
    +6.5 deg in the gap between seats. Swapping only the finger's command back does
    not restore success, so the open finger is a symptom.
    The measurements did turn u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
2026-09-16 --lr and --target-kl, applied on a resume like --ent-coef
    Fine-tuning a peak is not the regime 3e-4 was chosen in; that was the early
    curriculum (mac21-mac24). PPO.load restores both values, so a resume that wants
    a smaller step has to override them and be told what it got -- the resume line
    now prints ent_coef, lr and target_kl.
    Measured with it, from win16 3's 6.098M peak, 1M steps per arm, pool capped at
    lesson 2: lr 3e-4 ends at lesson 1 9/10, 1.2 8/10, 1.5 7/10, 2 3/10; lr 5e-5 at
    7/10, 8/10, 7/10, 6/10. Neither arm collapsed, and the start replays 6/10, 9/10,
    6/10, 3/10 -- so 1M steps is not where the collapse lives (win16 3 took 4.2M),
    and this A/B decides nothing yet. Both arms also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
2026-09-16 win16 3: the decay repeats, and three 1M arms all fail to see it
    win16 3 resumed win16 2's peak with the -37 finger stop. Best landed 5k steps
    into the resume; the 4.2M steps after it took lesson 1.5 to 2/10 and lesson 2 to
    0/10 while lesson 1 ended at 10/10. The grip fix was active and working -- holds
    counted on 99-100% of loaded steps against 40-70% before -- and the collapse
    happened anyway, as that commit said it might.
    Three 1M-step arms from that peak: lr 3e-4, lr 5e-5, and 3e-4 with the pool
    narrowed to the gap lessons. None collapsed, all sit at or above their starting
    replay, so 1M steps is too short to see a failure that took 4.2M. Narrowing the
    pool protected nothing (lesson 2 l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
2026-09-21 cad: the mechanical design, drawn against the real actuators
    Parametric CAD for the robot, in build123d. Vendor actuators are the
    manufacturers' own STEP files, sha256-verified against step.parts;
    everything between them is drawn here. One spec drives the CAD, the
    collision primitives and the URDF, so the model and the simulation
    cannot drift apart.
    The interfaces are MEASURED, not read off a drawing: tools/profile.py
    walks each vendor STEP's topology and finds the bolt circles by their
    cylindrical faces and z-positions, and tools/gen_envelope.py tessellates
    the solid for the radial keep-out. Bounding boxes over-estimate a full
    cylinder's radius by sqrt(2) - a 98 mm actuator reads as 139 -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
2026-09-21 Replace the simulated robot with the one the CAD says can be built
    urdf/ was aluminium cylinders with plausible masses and effort= values
    derived from geometry: a fine simulation that could not be made. It is
    now generated from cad/ - 17 CubeMars AK-series actuators, every mass
    and inertia from the solids, every torque limit off a datasheet.
    11.13 kg -> 21.89 kg. The interface is byte-for-byte the same shape -
    20 bodies, 18 joints, 17 actuators, 86 sensors, 5 sites - so
    climbing_env.py, the controller and the RL task load against it
    unchanged. Vertical reach, which set the rung spacing, measures 0.676 m
    against v1's 0.671.
    Three things had to be fixed before any of it ran:
    The hanging k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
2026-09-21 Audit the real-actuator robot: hooks the right way round, no phantom hulls, RL baselines read off the model
    The robot swap loaded cleanly, and `python -m rl.climb_task` failed its own
    incentive test: hanging still cost -58 over lesson 1 against -10 for a fall.
    Four defects, each fixed where it comes from:
    Hooks back to front. dc2f07b's re-mount (the hook turned 180 deg about the
    forearm axis) lived only in the hand-edited scene.xml, and regenerating from
    cad/ dropped it: at the keyframe the throat faced away from the wall and both
    wrists leaned on it. It is spec.MOUNT_ROT now - fk, the URDF's finger joints,
    the scene's hook bodies - and the hook is drawn in its turned frame, so it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
2026-09-22 Rebuild the shoulder pitch-first, the way the humanoids do it
    Raised to hang, the arm grew out of a pivot BELOW the abduction motor and
    folded back up past it - "arm up, shoulder pointing down" in the video. The
    abduction-first stack put flexion 104 mm under the abduction axis; flaring the
    raised arm swung its root 105 mm inward into the torso. Ten of twelve published
    humanoids (Unitree H1/H1-2/G1, Booster T1, Fourier N1, Adam Lite, BHL,
    ToddlerBot, OP3, iCub, Apollo, TALOS - measured off their own URDF/MJCF) put
    shoulder PITCH on the torso and ROLL 27-78 mm outboard at the same height.
    This robot does now:
    torso_upper -> flexion y +-0.085, z 0.165, body inboard in the chest
    shoulder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
2026-09-22 A run that looks after itself: consolidate before unlocking, roll back when the pool forgets
    win17, the first run on the pitch-first robot, did what every long run since
    win11 has done: it peaked (9.87M, 9.03 over lessons -2..1.85) and the next 5M
    steps bought nothing. Deterministic replays, 20 episodes each: lesson -2 20/20
    -> 13/20, 1.7 20/20 -> 15/20, lesson 2 0 -> 2/20. The gait is honest - every
    hook leaves the rung before it moves and seats with the finger in band, the
    holder does not slide - but lesson 2 stalls at the known deadlock (the lead hand
    reaches while the trailing one is still ~0.2 m from the edge), holds ~30 % of
    the steps at 2 %, and the pool starts to forget: on lesson -2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
2026-09-23 Hold the action noise off the floor and the learning rate to the KL: what win17's log says the drift is
    The first run with the console kept, 9.87M -> 20.0M, names the thing that has
    taken apart every long run since win11. Every update was rewriting the policy:
    approx_kl 0.2-1.1 and a clip fraction of 0.5-0.8, against 0.01-0.03 and 0.1-0.2
    in a healthy PPO run. KL rose in step with the policy entropy, which fell in a
    straight line and never levelled - +2.5 to -3.5 nats before the guard's rollback,
    +2.4 to -7.7 after it. The cause is in the checkpoint: six action dimensions had
    collapsed to std 0.02 from 0.09 at the peak - the right shoulder's three joints,
    its forearm roll and its finger, and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
2026-09-23 The guard owns the KL target, so a run slows down only on evidence
    Adding an adaptive learning rate broke the guard's lever without saying so: with
    the rate moved to hold each update's KL near a target, halving the rate on a
    rollback is undone within a few updates -- the adaptation pulls it straight back.
    The target is what lasts, so the guard halves that instead, from KL_START 0.1
    down to KL_MIN 0.01, and each run carries its own in state.json.
    0.1 rather than the 0.02 shipped yesterday, because small updates are both what
    stops the forgetting and what makes a lesson cost millions of steps: the run
    should take the biggest step that has not yet cost it a lesson, not a small one
    forever. win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
2026-09-24 Train on generated walls with ADR, counted by whole cohorts, and run a rented GPU box unattended
    The method: nine wall families (rl/walls.py), one per benchmark lesson and fixed
    before training, with automatic domain randomization growing each parameter's
    range (40 probes at the top: 70 % up, 20 % down). Families enter in the
    benchmark's order by the unlock rule. Lessons 1..9 are the test set only, scored
    on the full robot; --walls random is the no-curriculum ablation, its tops frozen.
    Every gate counts episodes in the order they started, once every episode begun
    before has ended. Counted as they ended, 256 envs unlocked family 2 at 5k steps on
    fast re-grips while the family was at 20 %. Fr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
2026-09-25 The preflight prints as it goes and says what each step is doing; a step that hangs prints where
    On the first rented V100 (gpu1) the preflight looked hung and was stopped during the
    MJX physics check: the console showed nothing past the check's start and the GPU sat
    at 50-60 W. Nothing had failed. Piped, Python held each process's whole output until
    it ended -- the task check's own "Failed to import warp" lines, printed in its first
    second, reached the console after that process's stderr line -- and the physics
    check compiles, then runs one robot at a time, so the card stays near idle.
    - PYTHONUNBUFFERED=1: every line reaches the console as it is printed (the physics
    check, piped: all 11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
2026-09-26 Family 3 starts one row 0.10 m up, and a family whose ranges changed starts over on a resume
    gpu1 carried on to 102.9M steps and family 3 (climb up) sat at 0 % from its unlock at
    12.8M to the end: every episode a timeout, three quarters of all steps spent on it, its
    first top of one row 0.30 m up never passed -- the policy never lifted a hook past
    28 mm there. Climbing up is possible: the full robot climbs one row of 0.10, 0.15,
    0.30 and 0.45 m in C MuJoCo, found by the cross-entropy method over joint-setpoint
    keyframes and scored `success` by ClimbTask.step. A row straight above clears the
    start hang from 0.07 m, so family 3's spacing now runs 0.10 -> 0.50 m (it was 0.30 ->
    0.50), the way f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
2026-09-26 Every reward term audited on motions known to be right: progress is measured along the rungs, and six terms stop charging correct climbs and swings
    The motions: one-row climbs of 0.10, 0.15, 0.30 and 0.45 m and a lesson-9 swing (one
    hand off, pumping for 6.6 s, reaching 1.08 m), found by the cross-entropy method on the
    full robot and replayed through ClimbTask.step with each term summed on its own; and
    each lesson's shortest route walked with each hand (the barrier test, now asserted).
    - The live reach went through the NEAREST rung, so the first half of every reach for
    another rung was uphill -- gpu1 never lifted a hook past 28 mm on family 3 -- and
    through the best rung's nearest point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
2026-09-26 A hold counts only on a seat, mjx_check model weighs the hooks at rung ends, and family 9 ends at lesson 9's 0.90 m
    gpu1 took lesson 2's next segment at its very end -- throat p50 0.598 m where the
    segment begins at 0.60 and its last full seat at 0.6325, half the hook off -- and was
    banked, graded and paid for it. It scores 7/30 there on the full robot and 17/30 on
    the simplified one it trained on (16/30 in MJX). The physics at the end is the same on
    both (1 s held, and 3 s of setpoints replayed open-loop from each landing); what
    differs is the force the hook bears there, 1398 N on the simplified robot against 199
    on the full one (mean, same states), and the pad and wrist the policy reads wi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
2026-09-29 A batch collides only the rung slots and walls in play: 1143 pairs to 578 for families 1..3, the physics the same to the bit
    One robot's MJX state is 47.6 KB and the policy a 64x64 MLP, so the card's memory was
    never the limit: the batch step is memory-bandwidth bound. XLA's own count per env and
    substep is 1.74 MFLOP against 5.16 MB moved -- ~420 GB a control step at 4096 envs,
    ~470 ms at a V100's 900 GB/s of the 728 measured, where the flops would take 9 -- and
    collision is 82 % of the bytes: MJX tests every listed pair every substep, however far
    apart. More envs cannot help.
    Rung slots 3..5 and the extra wall are parked 50 m away on every wall of families
    1..3 (families 4 and 6 fill 4 an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
2026-09-30 Four Livox Mid-360 on the upper torso and a tube cage round them; the simulated robot rebuilt from the CAD at 24.16 kg
    Two lidars on a roof over the head, 45 deg toward the wall and 45 deg away. Two more are
    sunk into the chest and the back, only their windows outside, since the chest is
    11-113 mm from the wall while climbing. Each bolts to a pad on a >= 3 mm plate, which
    is Livox's condition for shedding its 6.5 W.
    A cage of 16 x 2 mm 6061 tube guards all four: a bent bar up each corner of the torso,
    40 mm proud of the panels, jogging in to y +-50 mm past the raised upper arms, and a
    ring over the head at z 0.345 m joining their tops. Ray-casting picked that height:
    lower costs the head li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
2026-09-30 Every sensor reads like a real one, the map holds only what the Mid-360s have seen, and the SLAM is believed along a rung only where a wall faces it
    The observation's inputs now read through real-sensor error models. The reward still
    reads the truth. rl.mjx_task draws the same noise and rl.mjx_check task matches it to
    1e-15.
    - Encoders, IMU, F/T and pads: white noise plus a per-episode offset.
    - The SLAM drifts (20 mm, correlated over 5 s) rather than jittering. A fix comes with
    every 10 Hz lidar frame, 2 or 3 control steps apart (scan_due), and lands 80 ms late
    against the estimate of that moment.
    - The wall map is off rung by rung, per episode: 10 mm across, 1 deg of tilt, 10 mm an
    e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
2026-09-30 A SLAM test rig: simulated Mid-360 point clouds through FAST-LIO2 in Docker, and the rung map built from its points
    python -m rl.slam_test runs ClimbTask on the real pipeline instead of the error models
    it trains on.
    The sensors, as the Livox driver would give them:
    - Each Mid-360 fires 200 000 points/s along a real sensor's recorded pattern
    (fratopa/Mid360_simulation_plugin, fetched and checksummed, not redistributed).
    - mj_multiRay casts them 4 ms at a time as the robot moves. Each return carries the
    datasheet's range and angle noise.
    - The four are merged in the IMU's frame and sent as livox CustomMsg with the IMU at
    250 Hz.
    FAST-LIO2 (hku-mars @7cc4175, ROS Noetic, slam/Dockerfil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
2026-09-30 The classical controller is gone: its state estimate lives on as rl/estimator.py
    It is not pursued any more, so it is removed: controller/ with its FSM, relative-Jacobian
    IK, hanging planner, hold graph, A* routing, test_climb and recorder. What the RL side
    was built on stays and moves into rl/:
    - rl/estimator.py: the anchor-rooted Estimator (encoders + IMU + hold map), JOINTS,
    THROAT_PT, triad, rotvec. It is 122 lines of the 615: the clearance checks, Jacobians
    and planners went with the controller.
    - rl/__init__.py: ROOT, URDF, SCENE and the urdf/ path that climbing_env lives on.
    - rl/render.py: Video, which lesson videos are written with.
    - rl/lessons.py: GRIP_HARD, which slide_test g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
2026-09-30 mjx_check model judges each arm stand-in over every row at once, and the SLAM rig reads what the policy reads
    mjx_check model failed on one number, the forearm-roll motor's stand-in: -8.3 mm (p50)
    against the real link near the row 0.55 m under the hang. That was over 9 states, all
    one posture the heavier lidar robot happened into. The rows 0.35 and 0.45 m put the
    same stand-in at +1.0 (13 states) and +0.1 (22). A stand-in's shape does not depend on
    which row it meets, so every row's states are now pooled per link and judged once, if
    there are 20 or more. Every link comes out within 1 mm (p50): the forearm roll -0.7 mm
    over 44 states. The check passes, including the hook-at-a-rung-end force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
2026-10-04 A fall costs FAIL_R and what came before the hooks left, not three times that
    The live term kept charging while the robot fell: in the 0.6 s until `released`
    both hands drop under every rung and out of reach, and AIR and K_OVER bill it.
    Letting go from the hang cost -33.5 to -35.1 on lessons 1, 3, 5 and 9, -21 of it
    the live term, so an attempt had to succeed 2 times in 3 to beat hanging to the
    timeout. A 1.5M CPU canary passed lesson -2 and then sat at 0 % from 700k on,
    every episode a timeout. A fall now gets back the live term charged since a hook
    last touched a rung (C and MJX, parity unchanged): -12.7, and the same canary
    ran to lesson 1.1. A `fall test` in rl.climb_task holds it.
    Also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
2026-10-05 The fitted-batch check runs on the CPU, where two programs sum in the same order
    On an RTX 3090 the preflight stopped on it: a batch colliding only the pairs in
    play and one colliding every pair, 20 steps of random thrashing apart, differed
    by 9.6e-2 -- two compiled programs rounding differently, grown by the thrashing,
    while every physical check before it passed. Which pairs are dropped is the
    model's business, so it is checked on the box's CPU device, bit for bit as on
    the Mac.
2026-10-06 The free hand is credited what its partner slid, not what the load sagged
    gpu2 (145M steps) sat at 0 % on family 3 fluttering both hands: ~100 holds a hand
    an episode, +2.0..2.8 m banked (+10..+14) on a body that closed nothing. The
    partner term subtracted the holding hook's whole throat motion, and a loaded
    throat sags 10-20 mm when it takes the other hand's share and comes back once
    that hand holds -- credited down, ignored up; with the goal a row above, down is
    away from it. Now only the partner's slide along its rung counts, turned into this
    hand's bank potential from its rung point, in C and MJX (mjx_check task 4.8e-10).
    The same trajectory banks ~0; the CEM climbs still pay +8.07/+10.9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
2026-10-06 No row sits under the robot when it hangs: lesson 3's rows stand out, 5 and 6 climb diagonally
    A row straight below the hang in the rung plane is inside the robot -- the arms hang
    59-107 mm off it: wrists 15-23 mm inside a row 0.10-0.15 m down, forearms 6-25 mm
    off at 0.20-0.50, the base inside at 0.60-1.00. Every CEM climb of a stacked row
    pressed an arm on the row below at 100-415 N; at the goals of lessons 3 and 6 the
    base sat 34/38 mm inside the start rung, and hung there 3 s the robot fell off.
    Lesson/family 3 (the user's design): rows straight above, each walls.OUT = 0.20 m
    further out from the wall; spacing 0.20 -> 0.45, lesson 3 two rows of 0.40 (reaching
    out costs height: 0.56 m in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
2026-10-07 Family 3's reference climbs reach without a swing, and K_GRAB no longer pays a re-grip in place
    gpu3 (fresh, 60M steps, RTX 3090) still sat at 0 % on family 3 from the hang, its starts
    partway up flat at 60-70 % from 21M on. In MJX, every 0.20 m start: 38/40 once the left
    hook is on the row above, 24/40 while it comes down onto it, 0/80 before that, 0/48 from
    the hang -- the hook never rose past 36 mm, each hand let go and re-took the start rung
    ~200 times an episode. All three CEM climbs began by swinging the free arm across the
    body up a hill of live potential (+0.54, +2.44, +0.40 m), and 1/2/4 s in they had earned
    -0.79/-1.25/-1.15 against +1.83/+1.64/+1.28 for letting go and re-taking th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
2026-10-07 Family 3's starts are drawn where the policy cannot yet finish, and take most of its walls until it passes
    gpu4 (fresh on c8799b0, 64M steps, RTX 3090) still sat at 0 % on family 3 from the hang,
    its starts partway up flat at 55-73 % from 17M on. In MJX every 0.20 m start, stochastic
    and deterministic: 0/16 up to 4.8 s, 16/16 from 5.0 s -- 41 of 66, the rate the run logged
    -- and the same at the 50M snapshot. At 4.8 s the left hook is 30 mm under the row above
    and rising; the climb lifts it over, the policy pulls it straight into the rung's
    underside (189 N) and drags it back to the start rung. Three control steps of the climb
    from there and the policy finishes 8/8; the climb with the policy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
2026-10-09 Training steps on MJX's Warp backend wherever it is C MuJoCo's physics and faster, else on JAX
    gpu4 on an RTX 3090 ran 6,200 steps/s with the card's memory controller 67 % busy and
    5 of 24 GB in use: bandwidth, with MJX's JAX backend testing all 642 pairs every
    substep however far apart. MJX's Warp implementation (mujoco-mjx 3.12 carries it;
    warp-lang 1.16, now pinned) tests only the pairs its broadphase finds near.
    Three things had to change, each found as a robot falling with no contact at all:
    Warp culls by each geom's bounds per world, so a rung slot's are its rung's; its
    kinematics never moves the world's own geoms, so the rungs and extra wall are written
    into the data; and the batch's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
2026-10-09 The GPU box installs croc's latest release on every setup, so it matches the one at home
    croc's two ends must run the same version, and the 11.5.3 pinned here had fallen
    behind the Mac's brew croc (11.5.4). gpu_setup.sh now reads the latest release from
    where github.com/schollz/croc/releases/latest redirects -- not GitHub's API, which
    answered 403 after a few calls (60 an hour an address, and a rented box shares its
    address) -- downloads it, and checks it against that release's own checksums file:
    a mismatch or a missing line stops the setup with nothing installed. Already the
    latest: nothing is downloaded. gpu_run.sh prints the box's croc version beside the
    send line, with `brew upgrade cro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
2026-10-09 Family 3's starts begin the attitude filter at the torso's attitude, not one mid-swing accelerometer reading
    An rl.rsi start began the filter as a hang does, from one accelerometer and
    magnetometer triad; mid-swing that reads the swing too (16-37 deg off around
    the 0.20 m climb's catch), so the free hook was seen 0.1-0.3 m from where it
    is, differently at every row. gpu5 (42.9M steps) "passed" 4.80 s on that:
    11/16 from the start, 0/12 after the climb itself from the hang and 0/12 with
    the true attitude -- its real edge is 4.88 s, gpu4's. Hangs keep ClimbTask's
    start (task check still equal to 2.4e-15); mjx_check task now fails any rsi
    start that sees a hook 0.1 m off (317 mm before, 72 now)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
2026-10-09 The preflight's four checks each run on a quarter of the cores, and one that dies beside the others runs again alone
    XLA, LLVM and OpenBLAS size their thread pools by the cores a process may run on
    (a JAX compile: 63 threads on 12 cores, 18 on 3); four processes sized for all
    96 ran gpu6's box out of threads -- 'LLVM ERROR: pthread_create failed', the
    physics check aborted at its first compile and the preflight stopped after
    18 min. Pinned with taskset (when there is one), four are one unpinned
    process's worth, as when they ran one by one; a task, physics or Warp check
    that still dies runs again alone, unpinned, before it counts.
2026-10-09 The scoring runs its 18 episodes' processes one thread each, and the preflight pins only where taskset may
    Unset, each rl.eval sized numpy's, scipy's and torch's pools for every core (34
    threads on 12 cores in a Linux container, ~270 on gpu6's 96): 18 at once are
    thousands, past the thread limit the four-check preflight already hit there,
    and the 24 h run's scores would have failed at its very end. One thread each:
    an episode is one robot in C MuJoCo. The preflight now tries taskset once and
    runs unpinned when it is missing or refused (a refused pin had failed the
    batch fit down to 'not even 1024 envs'); provenance.txt records the box's
    ulimit -u and cgroup pids.max.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
2026-10-11 Family 6's step up is cloned from climbs found in the wall's own plane, and family 5 waits for it
    gpu8 (eb25530, 162M steps) passed families 1-4 and then sat at 0 % on family 5
    for 50M steps and on 6 for 43M. At 120M and 162M the policy went to the start
    row's end and hung there to the timeout, its hook never more than 2-11 cm up (the
    rung above 30-50 cm), no hand on it in 112 episodes. Not the reward (lifting
    there is downhill all the way, 0.0 mm of hill) nor the map (the lidar has every
    rung from the first step). Family 3's rows stand out from the wall, and the
    diagonal step up onto a rung in the wall's own plane, past the end of the one
    below, was never taught.
    rl.rsi: family 6's climbs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
2026-10-12 An rsi start has its hooks' rungs end to end instead of a second lidar view from the hang
    gpu9 (97cdaf4, a new box) sat at 0 % GPU from 12.98M steps, with family 3
    entering and the step recompiling for 3 rung slots. XLA reported a very slow
    compile of a reduce fusion: 18+ min, against 131 s for the same recompile on
    gpu8. Its preflight had already spent 16m23s on one kernel while building the
    env, and passed. 97cdaf4 had put a second lidar.visible, from the hang, into
    every reset and so into every step. That copied the step's largest reduction
    (4 lidars x 6 rungs x 32 cells x 64 occluders x 3 x 3 per env, ~1.8e9
    elements at 4096 envs), and the step's reduces went 234 -> 268.
    An rsi start no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
2026-10-12 A stalled family passing some walls draws its need again, and family 6's references run through their last catch
    gpu9 (122M steps): family 4 found its first climb down 69M steps after it entered (gpu7 26M,
    gpu8 40M), was stalled at 50M and capped from 74 % of the steps to 8 %, and sat at ~40 % for
    20M steps. The cap now holds only under WARM_RATE.
    Family 6's +y climb crosses its last gap in its last 1.1 s, so with the rows ending 1 s before
    success its catch was no start and never cloned: 45 % from its last start, its mean 0/9 from
    33-35 s (on t1b on time, then off it). Family 6's rows now end 0.2 s before success (MARGIN6):
    4 more starts a climb, open loop in MJX 32/32 of the last 8. A che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
2026-10-13 A restart checks the GPU is still JAX's before it trains, and stops instead of training on the CPU
    gpu9 (ea972f3, RTX 3090, driver 580.126.20) crashed at 177.4M steps with
    CUDA_ERROR_LAUNCH_FAILED in jit_step. From that minute gpu.csv read '[GPU is lost]'
    to the end, and the next process's cuInit failed with CUDA_ERROR_UNKNOWN: the card
    had fallen off the bus, the box's fault and not the run's. Before it the SM clock
    had dropped to 210-420 MHz at 210-260 W nine times (gpu6-8's boxes: never). The
    restart, forced onto --backend mjx, fell back to JAX on the CPU and trained at 90
    env-steps/s for 7.5 h, 2.6M steps; an update every ~22 min stayed inside STALL.
    Every start of the trainer now runs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
2026-10-13 Family 4 is taught a policy's own step down each way round, and the rsi frontier draws nine starts a lag
    gpu9 (ea972f3, 179M steps) sat at 45 % on family 4 from 51M on, ADR never off its
    first tops. On 24 walls at those tops, every wall toward +y (the benchmark's own
    direction) timed out with no hook ever more than 6 cm down, and 10/11 toward -y
    succeeded in 3-7 s: 45 % is the mirrored share. The lidars sit at y = 0, so it is
    the policy, which learnt one side. gpu7 sat the same way for 90M steps; gpu8 got
    out and at 162M stepped down both ways (+y 12/13, -y 9/11).
    rl.rsi.TAUGHT4: gpu8's own step down, each way round, on one wall at family 4's
    first tops (wall4: 0.30 m down, 0.10 m on), reco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
2026-10-13 The GPU check before each start reads rl.hardware's whole output, so a working GPU passes it
    gpu10 (e26365f) passed its preflight and then stopped before its first step. It
    said 'JAX cannot use the GPU any more', packed, and exited 1, with the GPU fine.
    dfc5a31 piped `rl.hardware` into `grep -q "via JAX"`. grep quit at the first
    line, the next print hit a broken pipe, and under pipefail the pipeline failed.
    On the Mac it failed 5 runs out of 5 with that line present. The check now reads
    the whole output first (`grep -q ... <<< "$(...)"`).
    The stub harness now prints rl.hardware's four lines, as the real module does.
    On it the old script stops at once with the GPU fine (no step trained). The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
2026-10-13 Families 8 and 9 start partway up climbs found on their own walls, and a fixture that only gains climbs keeps the run's books
    gpu10 (218.8M steps) had family 8 at 0 % for 105M steps and family 9 at 0-2 % for 55M,
    both capped. Family 8: the left hook reached the back rung and loaded it, and the right
    never followed. A free CEM search did the same, and stopped where the right should go.
    Rendered, the left hook was not over the rung: its back face pressed on the rung's front
    (hook x axis +0.99, throat 4 cm off the axis). That "holds" 127 N and nothing once the
    other hand lets go. A hook holds a rung behind the robot only turned round, its tip
    toward the back wall: the arm raised sideways over t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
2026-10-14 Family 8 starts partway up climbs found onto back rungs 0.50, 0.55, 0.60 and 0.70 m behind, appended so a run's books are kept
    gpu11 rose to 0.45-0.50 on the 0.35 m climb alone (0.50 5/64 from the hang, 0.55 0/64);
    lesson 8 is 0.63. Found as 0.35's was, IK-seeded with TURN, and a hill weight: without it the
    left arm's swing overhead climbed 1.7-4.3 m of live potential. Replayed in ClimbTask 16.8-17.4 s,
    hills 8-12 mm; open loop on Warp 25/29, 26/29, 26/29, 23/28 of their starts.
2026-10-15 While a top ADR has just raised is unjudged, a fifth of its family's walls are put at it and the rest stay under the old one
    At a new top half the family's probes, and every other wall under it, put 65 %
    of gpu11's family-8 walls past 0.50 m behind at 502.7M and 59 % of its family-6
    walls at two tiers at 620.2M, both ~0 % there. In 9 and 17M steps family 8 fell
    76 -> 16 % and family 6 67 -> 18 %, the walls below the new top too, hung on to
    their timeouts (8 walls each from the hang: 7/8 -> 4/8 at 0.50 m; one tier +y
    11/12 -> 1/5). Every step up of family 8's back rung (9) and family 6's tiers (3)
    went so; small steps (family 7's side, family 6's rise) never did.
    rl.walls.draw takes the unju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
2026-10-16 A clean training pipeline for the paper run: nine lessons in order, GPU only, one curriculum
    The lessons are 1 traverse, 2 gaps, 3 climb up rows standing out, 4 climb down rows standing
    in (new: lesson 3 backwards), 5 staircase down (was 4), 6 diagonal step up one tier, 7 corner,
    8 behind, 9 swing gap. The old climb over a break, lesson 6's second tier and the CPU path's
    ladder (-2..1.85, MultiLesson, rl.bench) are gone.
    - Lesson 4's start rung stands 0.46 m off the wall: its keyframe is pitched -7.5 deg about the
    rung (the stillest free hang), and MJX's front wall is a slot each wall places.
    - ADR as levels and candidates: walls draw under the passed level, a quarter probe the next
    ste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
2026-10-17 Demo videos: the policy climbing lessons 1-7 beside the map its four lidars build
    rl.demo renders a split screen: the full robot in MuJoCo on the left, on the right the point
    cloud of four Mid-360 simulated along Livox's own scan pattern (rl.slam_test's), filtered of
    the robot's own returns, in a 3 cm voxel map coloured by height, with the body's path.
    demo/ holds lessons 1-7 from gpu11's best checkpoint, lesson 4 from its CEM reference climb.
2026-10-19 Hold every action dimension's std under 0.3: gpu12's wrists drifted to 1.0 and spoiled every catch
    At 315M lessons 6, 8 and 9 sat at 0 % from the hang. Lesson 8's release finishes 40/40 with the
    mean from the starts past 2.6 s but 15/40 sampled at the policy's own std (wrists and elbows at
    the old 1.0 ceiling), so those starts never passed and the clone window never reached the
    release; under 0.3 the same starts finish 35/40, and lessons 3 and 4 from the hang go 23 -> 29
    and 22 -> 31 of 35. No fixture changed: a resume keeps every climb's books.
2026-10-20 Lesson 9's starts end 'stalled' after 20 s without a new low; a rollback keeps the policy that forgot; checkpoints record the frontier windows' books
    gpu13's missed lesson-9 throws hung one-handed to the 60 s timeout: 6.6k of 20.6k episodes
    from its starts at 475-531M, ~72 % of their steps. They now end truncated once the live
    potential has made no new low by 5 cm in 20 s (the climbs' own longest such stretch: 13.1 s).
    The rollback at 532M wrote over the weights that fell on lesson 8; they are now kept under
    out/<name>/rolled/.
2026-10-22 Lesson 9's 0.90 swings searched again to hold in MJX; a fixture change keeps the books of the climbs it did not change
    The 0.90 references caught the far rung 0.5 mm inside its seat, 1.09 m hook to
    hook: open loop in MJX they fell from 17 of 32 starts (+y) and from every start
    before the catch (-y). The new search (plan f9tg90/f9mtg90) slides the loaded R
    hook to the row's end before L lets go, gaining 0.11 m, asks the catch 0.10 m
    inside the far rung, and judges swing and catch as one phase on the hold. MJX open
    loop from every other start: +y 94/94, -y 93/93.
    Books were dropped whole on any fixture change. rsi_history.json maps a fixture's
    signature to its climbs' signatures, and a run ke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
2026-10-22 Lesson 8's back-rung climbs re-found a third faster: at gamma 0.995 the 17.4 s climb was worth less than hanging; books follow each climb to where it starts now
    From the hang, the 0.55 reference's discounted return was +0.44 while reaching the
    back rung with L and hanging there to the timeout earned +0.6..+1.7: gpu14 never
    took 0.55 from the hang in 900M steps (0/100-190 probes a window). Searched again
    with the same keyframes in two thirds of the time (plan f8fb*), the climbs succeed
    at 11.2-12.2 s: 0.55 is worth +3.41 from the hang, 0.60 +2.62. MJX open loop from
    every start: 0.50 59/59, 0.55 58/58, 0.60 60/60, 0.70 58/58.
    The f8 climbs sit ahead of lesson 9's, so their new lengths shift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
2026-10-23 Preflight's lesson-9 climb check waits 3 s past the climb for its success, its last step held
    A new box's 3090 ended the f9 0.6 climb from 10 s in nothing within the 0.24 s the
    check allowed past its expected success, where the old 3090 and the CPU succeed at
    30.7 s: the check is that the climb is not cut on its way, not when its last hold
    is booked to the step. Past its rows the climb now holds its last step rather than
    zero, as every reference check does (CPU: success at 31.0 s).
2026-11-02 Paper runs: families 1-7 only (--families, kept by a resume), dynamics randomization on by default (mass and inertia x0.9-1.1, friction x0.7-1.3, torque limits x0.8-1.0, setpoints 0-20 ms late; MJX o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
2026-11-02 Ablations for the paper (--ablate, kept by a resume; ABLATE in gpu_run.sh): rsi (no reference starts, no cloning), frontier (starts evenly along each climb), rfcl (the frontier start alone, no clonin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
2026-11-02 Ablations for the exploit table and the reference climbs: oneway (approach paid, retreat free), world (credit in the world frame), grab (K_GRAB for any first hold), refund (no live-term refund on a f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
2026-11-02 rl.eval for the paper's evaluation: --cond (noise, mass, torque, friction, setpoint lag; ClimbTask.lag, 0 by default), --set (unseen walls past training's last level), --torque (each joint against it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
2026-11-09 Pre-run audit fixes for the paper runs: dynamics randomization now scales pair_friction (every contact is an explicit <pair>, so geom_friction was never read and friction was never randomized; rl.mjx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
2026-11-10 Last audit before the paper runs: rl/paper_run.sh launches each run by its name alone (the name sets families, steps, seed, ablation, weights; unknown names refused; DRY=1 prints); rl.mjx_check dr ho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
2026-11-11 CAD joints drawn as one part and the simulation moved onto the regenerated robot (24.0635 kg, -101 g): webs end at their plates, cheeks follow the ring's rim, bolt counterbores at head diameter, wris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
2026-11-11 Human proportions and a body ready for legs and electronics (24.4983 kg): the waist turns 0.10 m lower, 305 mm under the shoulders at a 1.40 m person's navel (spec.DROP; the axis is vertical, so the 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
2026-11-11 urdf/README: the actuators are 52 % of the 24.50 kg robot (12.73 kg), not 53 % (that was of the old 24.06 kg)
2026-11-12 README rewritten for the paper: seven lessons, the method (ADR walls, frontier starts on 19 reference climbs, frontier cloning, two-way route potential, dynamics randomization), the paper's runs by n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
2026-11-12 README as the paper's repository page: overview, where each part of the paper lives in the code, the robot, task and sensing, the seven-lesson benchmark with its family ranges, the method (the 19 ref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
